kpwn/m68k-core-040-ooo/docs/superpowers/specs/2026-09-04-p135-m1-throwaway-frame-investigation.md

# Part 135 — the M=1 / format-`$1` throwaway interrupt frame: a negative on the stacks, and a real CCR bug found on the way

**Date:** 2026-09-04
**Branch:** `investigate/p135-m1-throwaway-frame` (worktree, **NOT merged**)
**Baseline:** `bb3bca1` (`fmax-closure-fanout`)
**Board / SD card / JTAG:** **not touched.** No board work of any kind.

---

## 1. Headline — two separate results

**(a) The stated hypothesis is a NEGATIVE. The M=1 / format-`$1` throwaway path does not
corrupt either stack pointer, under any condition tested.** Across 8 directed scenarios,
MMU off and MMU on, storm and per-cycle-enumerated arrival, bare and nesting and
stack-heavy handlers, **every frame word landed at exactly the right address on exactly
the right stack and both `MSP` and `ISP` returned to their entry values every time.** The
sim-side frame-address audit is exact to the word, so a 2-byte drift could not hide: it
would write 2 bytes off, cumulatively, and the second entry would already be visible.

**(b) A different, REAL defect was found and fixed: `RTE` restores the architectural CCR
into the flags PRF but leaves `RobPlugin.committedCcr` — the shadow the NEXT exception
entry builds the stacked SR's low byte from — holding the HANDLER's condition codes.** A
second interrupt taken at the same flag-consuming instruction therefore stacks the wrong
flags, and its `RTE` restores them, so the interrupted program's `Bcc` branches the wrong
way. It reproduces in **both** supervisor banks in well under 100 interrupt entries, is
**not** M=1-specific, and is invisible to any test whose handler is a bare `RTE` — which
is every interrupt test that existed, including all of Part 134's.

**This does not fix the boot, and no claim is made that it does.** §7 states plainly what
the connection to p133 is and is not.

---

## 2. Correcting the direction of the sequence

The brief states the throwaway frame goes on the **master** stack and the real frame on
the interrupt stack. That is backwards, and it matters for reading the results.

MC68040 UM §8.4.2/§8.4.3, and Musashi's `m68ki_exception_interrupt`: an interrupt taken
with `S=1, M=1`

1. stacks a NORMAL four-word format-`$0` frame on the currently-active stack — the
   **MASTER** stack, because M is still 1 — so `MSP -= 8`;
2. clears M, re-banking A7 to the **INTERRUPT** stack;
3. stacks the four-word format-`$1` **throwaway** frame there, so `ISP -= 8`;
4. runs the handler on the ISP with M=0 and the mask raised to the interrupt level.

`RTE`, inside one instruction: pops the `$1` frame off the ISP (`ISP += 8`), applies its SR
— which still carries M=1, so A7 re-banks back to the MSP — DISCARDS its PC, then loops
back and pops the real `$0` frame now on top of the MSP (`MSP += 8`), using its PC and SR
for the actual return.

`ExceptionUnit.scala:450-466` has this right. The tests here assert the correct direction
explicitly: T1 checks the format word at `ISP-2` is `$1064` and the one at `MSP-2` is
`$0064`, so a swapped implementation would fail loudly rather than pass silently.

---

## 3. What was built

`src/test/scala/m68k040/exception/M1ThrowawayFrameIrqSpec.scala` — 17 scenarios on the
shared full-core `FuzzCoreDut`, level-1 autovector IRQ driven on `iplIn`. Three
deliberately independent observation channels:

* **Guest-side architectural assertions.** The program re-derives every fact from `%a7`,
  `MOVEC %msp`, `MOVEC %isp`, `%sr` and the stacked frame words read back through
  `%a7@(n)`, and writes a DISTINCT numeric code plus **the value the failing check
  actually saw** to a watched address. Recording the observed value is what turned a
  failure from "something is wrong" into a diagnosis (§5).
* **Sim-side frame-address audit.** With the MMU off both stacks are writethrough, so
  every frame word is its own AXI AW beat. For a bare-`RTE` handler the only addresses
  that may ever be written in either stack's low window are `{SP-8, SP-6, SP-4, SP-2}`.
  This channel does not depend on the guest program being correct at all.
* **The committed `ss.msp` / `ss.isp` / `ss.srSys` bank registers**, read directly at the
  end, plus an architectural loop counter in `%d7` read through `ArchStateProbe` as a
  liveness bar (a clean result from a wedged guest is worth nothing).

Arrival is swept two ways, as in Part 134: a growing-gap storm, and a deterministic
per-cycle enumeration anchored on the guest's own per-iteration store, holding the level
until the ROB recognises it (a short pulse can LAPSE mid-macro and silently hollow out the
sweep — Part 134 measured only ~23% conversion without the hold; these runs convert
**384/384**).

---

## 4. The stack-pointer result — clean, on unmodified RTL

| # | scenario | entries | result |
|---|---|---|---|
| T1 | ONE M=1 interrupt, all 15 architectural facts of the two-frame entry checked | 1 | **PASS** (`0xC0FFEE00`) |
| T2 | M=1 storm, both banks re-checked every loop iteration, bare-`RTE` handler | 175 | **PASS** |
| T3 | deterministic per-cycle arrival enumeration under M=1 | **384/384** | **PASS** |
| T4 | entry state checked from INSIDE the handler on every interrupt | 155 | **PASS** |
| T5 | NESTED M=1 interrupts — a throwaway inside a throwaway | 141 | **PASS** |
| T9a | M=1 `RTE` whose immediately-preceding instruction changed A7 by 2 (register-only) | 175 | **PASS** |
| T10 | M=1 entry taken while the mainline moves A7 by 2 in tight pairs | 162 | **PASS** |
| T11 | the same A7 churn under per-cycle arrival enumeration | **384/384** | **PASS** |
| T7 | T1's full frame audit with the **MMU ON**, 8 KB pages, TTRs disabled | 1 | **PASS** |
| T8 | M=1 storm with the **MMU ON**, 8 KB pages | 174 | **PASS** |

T1's frame-address audit, verbatim from the run — note the exact word granularity, which
is what makes it a 2-byte-resolution detector:

```
MASTER-stack frame writes:    0x0011fff8 x2 0x0011fffa x1 0x0011fffc x2 0x0011fffe x1
INTERRUPT-stack frame writes: 0x000ffff8 x2 0x000ffffa x1 0x000ffffc x2 0x000ffffe x1
```

(the `x2` counts are the guest's own poison longwords at `-8`/`-4` plus the frame word.)

T2's, across 175 entries — one write per address per entry, no drift at all:

```
MASTER-stack frame writes:    0x0011fff8 x176 0x0011fffa x175 0x0011fffc x176 0x0011fffe x175
INTERRUPT-stack frame writes: 0x000ffff8 x176 0x000ffffa x175 0x000ffffc x176 0x000ffffe x175
```

**Both named secondary gaps were closed and neither changed anything.** The MMU-on arms
(T7/T8) run the guest's own three-level 8 KB page tables with **all four TTRs zeroed**, so
every first touch is a genuine table walk — the exact p133 silicon posture, `TC = 0x0000c000`
— and the harness fails closed on `mmuEnable`/`pageSize8K` readback so the arm cannot
silently degrade into an MMU-off run. The nesting (T5) and long stack-heavy (T6) handlers
close the "the handler was a bare `RTE`" gap.

**T5 deserves its own line.** `ExceptionUnit.scala:727-733` carries an explicit, still-open
caveat that ends: *"A RAPID M re-toggle (M=0->1->0 within the settle window) is NOT
validated here ... Add a directed test for that BEFORE Slice B (interrupt throwaway frame)
relies on cross-toggle preservation."* That test was never written. T5 is it: the handler
re-sets M=1 (re-banking onto the master stack, on top of the frame entry just pushed
there), opens the mask so a nested — itself M=1, itself a throwaway — interrupt lands, then
toggles back. 141 entries, both stacks exact.

---

## 5. The defect that IS real — `RTE` does not resync `committedCcr`

### 5.1 How it was isolated

Two scenarios failed where the others passed, and the failure code alone was ambiguous. The
fail path was changed to also record **the value the failing check compared**. That single
change resolved it:

```
T14 (M=1, handler pushes/pops a word):  result=0xbad00033 (_f_bal_sr)  observed=0x00103000
```

The check is `move.w %sr,%d0 ; andi.w #0xff00,%d0 ; cmp.w #0x3000,%d0 ; bne`. The observed
`%d0` low word is `0x3000` — **exactly the value the compare wanted**. The architectural
state was right and the branch went the wrong way. That is a condition-code failure, not a
value failure, and the observed-value channel is what distinguishes them.

### 5.2 It is NOT M=1-specific — the control says so

| # | arm | handler | result |
|---|---|---|---|
| T12 | **M=1** | forces `{N=1,Z=0}`, no memory, no A7, no MOVEC | **FAIL** `0xbad00033`, observed `0x00103000` (correct value), 96 entries |
| T13 | **M=0 CONTROL** | identical handler | **FAIL** `0xbad00032`, observed `0x00100000` (correct value), 63 entries |

The M=0 control was deliberately given **2x the pulse budget** of the M=1 arm — a control
that clears the bar only because it ran less is worth nothing — and it still failed
earlier. So the defect lives in the shared, M-agnostic `RTE` path.

An earlier, weaker revision of this handler (`tst.l %d6` with `%d6 == 0`) passed both arms
**vacuously**: it leaves `{N=0,Z=1,V=0,C=0}`, byte-for-byte what the mainline's own
successful `cmp` leaves, so it could not detect a lost CCR at all. Both the vacuous pass
and its correction are recorded here rather than dropped.

### 5.3 The mechanism, exactly

`RobPlugin.committedCcr` (`RobPlugin.scala:2020-2027`) is advanced ONLY by `retire0`/
`retire1`'s per-µop NZVC/X fold, plus `exc.obsSetCcr5Valid` (which before this change only
MOVE-to-SR and STOP ever pulsed). `ccrForException` (`:2037`) builds the STACKED frame's SR
low byte from it. `RTE`'s `rteNzvcWrite`/`rteXWrite` (`ExceptionUnit.scala:1775-1778`) write
the REAL flags PRF — correctly — but never touch that shadow. So:

```
  cmp.l #K,%d0     retires        -> committedCcr = {Z=1};  PRF = {Z=1}
  bne   ...        IRQ #1 preempts it; the frame stacks {Z=1}            (correct)
  <handler disturbs the flags>    -> committedCcr = {N=1,Z=0}
  rte                             -> PRF := {Z=1} (correct); committedCcr STILL {N=1,Z=0}
  bne   ...        IRQ #2 preempts the SAME bne; the frame now stacks {N=1,Z=0}
  <handler> rte                   -> PRF := {N=1,Z=0}
  bne   ...        branches the WRONG WAY, with %d0 still holding the correct value
```

It needs two interrupts at the same flag-consuming instruction with no flag-WRITING
instruction retiring in between — which is why it takes tens of entries to surface.

### 5.5 Why the existing corpus cannot see it — measured, not assumed

The obvious explanation is "every interrupt handler in the corpus is a bare `RTE`, which
cannot disturb the flags". **That explanation is WRONG, and it was checked rather than
asserted.** Of the interrupt-handler labels in
`src/test/resources/m68kooo-ported-tests/asm/`, only 9 are literally a bare `RTE`
(`atrap_dispatch_with_irq`, `bsr_split_push_irq_in_gap`, `exc_irq_during_store`,
`exc_rte`, `fline_after_move_sp_postinc_sr_tmp1`, `fline_before_move_sp_postinc_sr_tmp1`,
`irq_during_move_sp_postinc_sr_tmp1`, `irq_during_postinc_loop`, `pea_4x_with_irq`).
Several others DO disturb the condition codes — `irq_at_rts_fetch_sweep`'s handler is
`addq.l #1,IRQ_COUNT ; rte`, and `addq` to memory sets N/Z/V/C; `exc_stack_atomicity_stress`
and `pea_aline_irq_storm` do more still.

The real gap is narrower and more useful to know: **no test in the corpus asserts that the
CONDITION CODES survive an interrupt.** They assert stack-pointer balance, frame contents,
return addresses, nesting depth and interrupt counts. Reproducing this defect needs all
three of

1. a handler that disturbs the flags, **and**
2. interrupted code that CONSUMES flags produced *before* the interrupt (a `Bcc` whose
   `cmp` retired earlier), **and**
3. two interrupts landing on that same consumer with no flag-writer retiring between them.

`irq_at_rts_fetch_sweep` has (1) but its interrupted code is an `RTS` sweep that checks
return addresses, not flags. Part 134's scenarios had (2) — their loops are `cmpi.l`/`bne`
pairs — but their handler was a bare `RTE`, so not (1). Nothing had all three. That is a
corpus-shaped hole, not a one-test oversight, and closing it generally (a flag-survival
assertion in the standard interrupt-storm shape) is worth more than this one fix.

The comment that this change replaces stated the exact assumption the bug violates: *"the
CCR is restored from the frame too, but the whitebox carries it (RTE restores the same CCR
the matching exception entry saved -> reconstructed CCR holds)."*

### 5.4 The fix

`ExceptionUnit.scala`, `R_REDIR`'s real (non-throwaway) pop — two lines plus the comment
block that explains them:

```scala
        obsSetCcr5Valid := True
        obsSetCcr5      := popSr(4 downto 0)
```

`obsSetCcr5` is exactly the right port: `RobPlugin.scala:2217` already applies it as
`committedCcr := exc.obsSetCcr5` (last-wins over the retire fold), and the lock-step
whitebox already treats it as "set the running CCR to this absolute value for this obs
step" — which is precisely `RTE`'s architectural semantics. MOVE-to-SR / STOP already use
it the same way from `S_REDIR`; this is a third producer inside the SAME `fsm`, so
`whenIsActive` keeps them mutually exclusive by construction.

The format-`$1` throwaway pass deliberately does NOT pulse it: that pass fires no obs and is
not an architectural completion, and the second (real) pop lands the final value a few
cycles later with `excIdle` low throughout, so no exception entry can read the shadow in
between.

`git diff bb3bca1 -- src/main` is **1 file, +41/-3 lines** (2 of which are logic).

---

## 6. Before / after

Both arms are the SAME worktree, so the only variable is the two-line `src/main` change;
the test file is byte-identical between them.

| # | scenario | BEFORE (pristine `src/main`) | AFTER (fix) |
|---|---|---|---|
| T9b | M=1, handler push/pops a word before `RTE` | **FAIL** `0xbad00033`, observed `0x00103000` (the CORRECT value), at 44 entries / 230 pulses | **PASS**, 150 entries / 700 pulses |
| T1 | one M=1 interrupt, 15 architectural checks | PASS | PASS |
| T2 | M=1 storm, both banks | PASS, 175 entries | PASS, 181 entries |
| T3 | per-cycle arrival enumeration | PASS, 384/384 | PASS, 384/384 |
| T4 | entry state checked inside the handler | PASS, 155 | PASS, 141 |
| T5 | nested M=1 (throwaway inside a throwaway) | PASS, 141 | PASS, 141 |
| T6 | long, nesting, stack-heavy handler | (2 harness defects, see below) | **PASS**, 116 entries / 61 iterations |
| T9a | M=1 `RTE` after a register-only A7 change | PASS, 175 | PASS, 182 |
| T10 | M=1 entry during tight A7 churn | PASS, 162 | PASS, 168 |
| T11 | A7 churn under per-cycle enumeration | PASS, 384/384 | PASS, 384/384 |
| **T12** | **M=1**, handler disturbs only the flags | **FAIL** `0xbad00033`, observed `0x00103000` (correct value), at 96 entries | **PASS**, 182 entries |
| **T13** | **M=0 CONTROL**, same handler, 2x pulses | **FAIL** `0xbad00032`, observed `0x00100000` (correct value), at 63 entries | **PASS**, 450 entries / 1400 pulses |
| **T14** | M=1, push/pop handler (register-safe rewrite of T9b) | **FAIL** `0xbad00033`, observed `0x00103000`, at 44 entries | **PASS**, 150 entries |
| T15 | M=0 CONTROL, push/pop handler | PASS, 403 entries | PASS, 426 entries |
| T16 | M=1 CCR-survival probe (reads the CCR back architecturally) | *written after the baseline run — not measured before* | PASS, 178 entries |
| T17 | M=0 CONTROL, same probe | *not measured before* | PASS, 467 entries |
| T7 | MMU ON, 8 KB pages, single interrupt | PASS | PASS |
| T8 | MMU ON, 8 KB pages, storm | PASS, 174 | PASS, 173 |

**AFTER: 18 run, 18 passed, 0 failed** (`Total time: 641 s`). The three scenarios that
failed on the pristine arm — T12, T13, T14 — are green, and the two M=0 controls that
passed before still pass with more entries than before. T16/T17 are honestly marked: they
were written *after* the baseline sweep, in response to the T12/T13 failures, so they have
a fixed-arm number only. Their value is diagnostic shape, not a before/after pair; T12/T13
are the pair.

**Three harness defects were found and fixed during this work, and are reported rather
than quietly corrected**, because two of them produced failures that looked like RTL bugs:

1. **T4's first handler used `%d0`/`%a0`** — the same scratch register the mainline's
   checks use between their `movec`/`move` and their `cmp`/`bne`. An interrupt landing in
   that gap left the handler's value in `%d0`, failing a check that had nothing wrong with
   it (`_f_bal_msp`, `0xbad00031`). All handlers now leave `%d0-%d3`, `%d5`, `%d7` and
   `%a1` untouched on the success path and use `%d4`/`%d6`/`%a0` as scratch.
2. **T5/T6's stack-balance checks were not nesting-safe** — they compared against a
   snapshot in `%d4` (T5) or a hard-coded `ISP-8` (T6), both of which a NESTED invocation
   of the same handler invalidates. Replaced with a marker longword pushed on the
   handler's own stack, which is correct at every nesting depth.
3. **The first `flagOnlyHandler` (`tst.l %d6` with `%d6 == 0`) passed VACUOUSLY** — it
   leaves `{N=0,Z=1,V=0,C=0}`, byte-for-byte what the mainline's own successful `cmp`
   leaves, so it could not detect a lost CCR at all. Corrected to force the opposite
   (`moveq #-1`), after which it fails in both banks. A control that cannot fail is worth
   nothing, and this one nearly went in the report as a pass.

**On the positive control the brief asked for.** No deliberately-injected defect was
needed for the CCR finding: T12/T13/T14 are *themselves* real failures on unmodified RTL
that the two-line change turns green, which is a stronger demonstration than an injected
one. For the stack-pointer NEGATIVE the detector's sensitivity is argued differently and
must be read as such — see §9's "what the frame audit can and cannot catch".

---

## 7. What this does and does not say about p133

**It does not fix the boot.** No boot was attempted, and the defect's own signature is
corrupted condition codes, not a corrupted stack pointer. Everything below is a hypothesis
with supporting properties, offered so it can be tested — not a claim that it is the cause.

That said, it is the strongest hypothesis this campaign has produced, and the reasons are
worth stating explicitly because each one is independently checkable.

### 7.1 It is the only mechanism found that can produce the measured signature

A `Bcc` that branches the wrong way **around a stack adjustment** leaves SP off by exactly
that adjustment. The measurement is SP at `0x0040076C` where `0x0040076E` was required —
**exactly 2**. Word-sized stack traffic (`addq.l #2,%sp`, `move.w (%sp)+,%dn`,
`move.b <ea>,%sp@-` which adjusts A7 by 2 under the 68k A7 rule) is pervasive in this ROM.
Neither Part 134's mid-macro hypothesis nor this part's M=1 hypothesis can produce a 2-byte
SP error at all; this one can.

### 7.2 The ROM code at the failure has exactly that shape

Disassembling `files/420dbff3.rom` at the captured fault address (`objdump -b binary -m
m68k:68040 --adjust-vma=0x40800000`) shows the faulting `RTS` at `0x408999E2` sits at the
end of the ROM's own exception-probe unwind path, and its neighbourhood is dense with both
conditional branches and stack arithmetic:

```
4089999c: addql #4,%sp
4089999e: movew %sp@,%d0                 | saved SR
408999a0: bfextu %sp@(6),0,4,%d1         | frame FORMAT nibble
408999a6: cmpib #7,%d1
408999aa: beqs  0x408999b8               |  -> lea %sp@(60),%sp
408999ac: cmpib #10,%d1
408999b0: bnes  0x408999be               |  -> lea %sp@(92),%sp
408999b2: lea   %sp@(32),%sp             |  (fallthrough: 32)
...
408999c2: movew %d7,%sp@-                | hand-built format-$0 frame: format word (2 bytes)
408999c4: pea   %pc@(0x408999cc)         |                             PC          (4 bytes)
408999c8: movew %d0,%sp@-                |                             SR          (2 bytes)
408999ca: rte
408999cc: moveq #9,%d0
408999ce: btst  #7,%a3@(64)
408999d4: beqs  0x408999e2
408999d6: moveb %a3@(80),%d5
408999da: btst  #4,%d5
408999de: beqs  0x408999e2
408999e0: moveq #5,%d0
408999e2: rts                            | <<< THE FAULTING RTS
```

And ~400 bytes earlier, in the same routine, the **exact 2-byte shape**: a byte pushed to
`-(%sp)` (which moves A7 by 2) whose matching pop is reached through *two different*
conditionally-selected sites, with other conditional exits in between:

```
4089984a: moveb 0xcb2,%sp@-              | A7 -= 2  (68k A7-byte rule)
...
40899876: bnes  0x408998f0
...
408998aa: bnes  0x408998f4
408998b4: moveb %sp@+,%d0                | A7 += 2  (pop site 1)
...
408998f4: moveb %sp@+,%d0                | A7 += 2  (pop site 2)
```

**Report this honestly, including where it does not fit.** The conditional chain
*immediately* before the faulting `RTS` selects unwind sizes of 32/60/92, so a wrong branch
*there* gives a 28/32/60-byte error, not 2. The 2-byte shape is the earlier push/pop pair,
in the same routine and the same subsystem, not the last few instructions. So the ROM
supports "a mis-taken conditional branch in this code produces a 2-byte SP error" as a
*plausible* mechanism; it does not demonstrate that this particular branch was mis-taken.

### 7.3 It explains the non-determinism

The defect needs a SECOND interrupt to land on the same flag-consuming instruction before
any flag-writer retires. That is a coincidence, not a certainty — which is the right shape
for "~50% of cold boots", and the wrong shape for a deterministic decode or arithmetic bug.
In simulation it took 44-96 interrupt entries to surface.

### 7.4 It explains the v1 asymmetry — CHECKED, and it holds

This is the strongest constraint available (v1 boots this SoC to Finder on identical
peripheral RTL), so it was verified in v1's RTL rather than assumed.

**v1 has exactly ONE architectural condition-code storage** — the `ccr_prf[]` array in
`cpu/rtl/core/rename/ccr_rat.v`, indexed by the committed pointer `crat_tag`. Both sides of
the round trip touch that same array at that same index:

* **Exception entry** builds the stacked SR as `{arch_sr[15:5], arch_ccr_val}`
  (`cpu/rtl/core/commit.v:2960`, and identically at `:3283, :3513, :3578, :3773, :3861`),
  where `arch_ccr_val` is wired straight from `assign dbg_arch_ccr = ccr_prf[crat_tag];`
  (`ccr_rat.v:389`).
* **`RTE`** writes `ccr_restore_en`/`ccr_restore_val` (`commit.v:3656-3661`, and
  `:3612-3615` for the format-`$1` throwaway pop), consumed as
  `ccr_prf[crat_tag] <= restore_val;` (`ccr_rat.v:484-487`).
* The same array is what a `Bcc` reads (`assign read_val = ccr_prf[read_tag];`,
  `ccr_rat.v:381`).

`commit.v:1044` documents that `arch_sr[4:0]` is dead and never maintained precisely
*because* the CCR lives only in `ccr_rat`. So **there is no second copy in v1 to fall out of
sync, and this bug cannot exist there by construction.** The cpu040 defect is a property of
having a *separate* `committedCcr` shadow for exception stacking — an OoO-specific
structure that an in-order core has no reason to build.

That is the property worth having: it explains why v1 boots and cpu040 does not, without
needing the two cores to differ anywhere else.

**One nuance found in v1 that is worth carrying back.** v1 hit a *different* variant of the
same family — not a stale mirror but a stale read *cycle*: `arch_ccr_val` is combinational
off `crat_tag`, which advances one cycle after `ccr_commit_en`, so an exception entry
sampling during that cycle captured the previous instruction's CCR. v1's fix is
`ccr_settle_in_flight` (`commit.v:1968-1983`), gating `take_irq_fire_q`, `sync_exc_pretest`
and `take_trace`. Note it gates `ccr_commit_en` but **not** `ccr_restore_en` — v1 gets away
with that only because `RTE` also asserts `redirect_en`. cpu040's equivalent question (can
an exception entry sample `committedCcr` in the cycle a flag-writer retires?) is **not
answered by this part** and is a reasonable next check.

### 7.4a CONFIRMED ON SILICON — the defect, not yet the boot

Reported to this session by another agent, and recorded with that attribution rather than
as a measurement taken here: on real hardware the **stacked CCR was measured going
`0x00 -> 0x04`** at two distinct PCs, with both confounds eliminated. That is a direct
observation of the defect this part reproduces in simulation — the exception frame
carrying condition codes that are not the interrupted program's.

Be precise about what that does and does not establish. It confirms **the defect is real
on silicon**, which upgrades it from "reproduces in simulation" to "happens on the actual
part". It does **not** by itself establish that this is the p133 boot blocker: that still
requires showing the corrupted flags steer a branch around a stack adjustment in the
failing window. §7.2's ROM disassembly shows the shape exists nearby; it does not show it
fired.

The measurement Part 134 §9 asked for is still the discriminating one and is **still not
taken**: catch a drain-loop IRQ on silicon and read `A7` immediately before interrupt entry
and immediately after the handler's `RTE`. A second, cheaper discriminator now exists: read
the **CCR** at the same two points, or simply check whether the boot success rate changes
with this fix in the bitstream.

---

## 8. Open / not fixed

### 8.0 Two follow-ups worth picking up — named so they are not lost

**(1) A SECOND, DISTINCT CCR HAZARD CLASS: the settle window, not the stale mirror.**
The bug fixed here is a stale *mirror* (`committedCcr` not resynced by `RTE`). v1 hit a
different member of the same family: a stale *cycle*. In v1, `arch_ccr_val` is
combinational off `crat_tag`, which advances one cycle after `ccr_commit_en`, so an
exception entry sampling during that cycle captures the PREVIOUS instruction's CCR. v1's
fix is `ccr_settle_in_flight` (`cpu/rtl/core/commit.v:1968-1983`), which gates
`take_irq_fire_q`, `sync_exc_pretest` and `take_trace`.

Note what that gate covers: **`ccr_commit_en` but NOT `ccr_restore_en`.** v1 gets away with
the omission only because `RTE` also asserts `redirect_en`. The cpu040 equivalent —
**can an exception entry sample `RobPlugin.committedCcr` in the same cycle a flag-writing
µop retires, and stack the pre-fold value?** — is **NOT answered by this part**. Reading
`RobPlugin.scala:2020-2039`, `ccrForException` reads the `committedCcr` REGISTER while
`ccrAfter0`/`ccrAfter1` compute the post-fold value combinationally for the next edge, so
the question is whether `entryTrigger` can coincide with `retire0`. It is a real,
separately-testable hazard and it deserves its own directed test in the shape of §5.5's
three-way conjunction. Not investigated here.

**(2) A CORPUS-SHAPED COVERAGE HOLE, not just a missed bug.** No test in this repo asserts
that the CONDITION CODES survive an interrupt. Stating the conjunction is what makes it
fixable — reproducing this class needs **all three** of:

1. a handler that **disturbs the flags**, and
2. interrupted code that **consumes flags produced BEFORE the interrupt** (a `Bcc` whose
   `cmp` retired earlier), and
3. **two interrupts landing on that same consumer** with no flag-writer retiring between.

The corpus has (1) in several places and (2) in several others, and nothing has all three
(§5.5). The generally-useful fix is not this one patch but a flag-survival assertion added
to the standard interrupt-storm shape, so the whole class is covered once. `T16`/`T17` in
`M1ThrowawayFrameIrqSpec` are a ready-made template: they read the CCR back
architecturally with MOVE-from-SR and report the corrupted value rather than inferring it
from a branch outcome.

* **`RTE` does not restore the CCR on the format-`$1` throwaway pass**, where Musashi's
  `rte` `case 1` does (`m68ki_set_sr_noint(sr)` sets the FULL SR including the CCR before
  `goto rte_loop`). This is architecturally invisible here because the second pop lands the
  same CCR a few cycles later and nothing can observe the interval. Left alone deliberately:
  changing it is a behaviour change with no test that can see it.
* **`ss.msp` is transiently clobbered during a throwaway `RTE`.** After pass 1 restores M=1,
  `ss.writeA7` (which fires every cycle, routed by committed S,M) starts mirroring the
  live committed A7 — still the HANDLER's ISP value — into `ss.msp`, until pass 2's
  explicit `setMsp` overwrites it with the correct value. Nothing reads `ss.msp` in that
  window on the normal path (`frameBase` was already latched), so it is benign there. It is
  NOT benign on one path: if the second frame's format nibble is malformed, `R_FMTWAIT`
  synthesises a vector-14 entry that routes through `E_DRAIN`, which recomputes
  `frameBase` from `Mux(ss.m, ss.msp, ss.isp)` — and would read the clobbered value. That
  needs a hand-corrupted frame to reach, does not occur in the p133 boot, and is reported
  rather than fixed (fixing it is a `src/main` change for a defect nothing has observed).
* **`exc_partial_macro_move_mem_mem`** (sentinel `0xbad0a008`) still fails on baseline. Not
  re-litigated: Part 134 §6's reasoning that it is not the p133 blocker is sound.
* The `[Warning] Elaboration failed (20 errors).` line Part 134 §8 flagged appears in every
  run of this suite too. Same pre-existing `FuzzCoreDut` SpinalSim compile-path artefact;
  the positive/negative discrimination in §5 proves the netlist really is regenerated when
  the source changes. Flagged, not investigated.

---

## 9. Verification — and what was NOT run

### What the frame audit can and cannot catch

The stack-pointer negative rests on the sim-side audit, so its sensitivity has to be
stated rather than assumed. It records the address of **every** AXI write that lands in
either stack's low 256-byte window and asserts the set is exactly
`{SP-8, SP-6, SP-4, SP-2}`. T1's output shows the granularity is a single **word** — the
frame's four words appear as four distinct addresses two bytes apart — so a stack pointer
2 bytes off writes to an address that is not in the set, on its very first frame. And the
error would be cumulative: entry N's frame would sit 2N bytes low, so across T2's 175
entries a drift would produce 175 distinct addresses marching down the stack rather than
the 4 observed. This channel is independent of the guest program being correct at all.

What it cannot catch: a drift that is introduced AND undone entirely inside the FSM
without any frame word being written from the wrong base, and anything on a COPYBACK page
(which is why the MMU-on arms, whose pages are copyback per the p133 posture, rely on the
guest-side checks and the final bank readback instead).

### Runs completed

| suite | arm | result |
|---|---|---|
| `M1ThrowawayFrameIrqSpec` T1-T15 | pristine `src/main` | T9b, T12, T13, T14 **FAIL**; the rest pass (§6) |
| `M1ThrowawayFrameIrqSpec`, all 18 | **with the fix** | **18 run, 18 passed, 0 failed** (`Total time: 641 s`) |
| `ExecuteLockStepSpec` | with the fix | **505 run, 505 passed, 0 failed, 1 ignored** — identical to the brief's baseline figure |
| `make test-fast` (`sbt fastTest`) | with the fix | **341 run, 340 passed, 1 failed, 2 ignored** — the one failure is the documented `RobPluginSpec` `debugPcApply` seed flake, byte-for-byte the baseline figure |
| `m68k040.ls.*` + `m68k040.cache.*` | with the fix | 300 run, 287 passed, **13 failed** |
| `m68k040.ls.*` + `m68k040.cache.*` | **pristine, SAME session** | 300 run, 289 passed, **11 failed** |
| 200-seed fuzz | with the fix | **200 seeds, 3 divergences, 0 generator failures** — seeds 80, 109, 127, identical signatures. **Unchanged.** |

`ExecuteLockStepSpec` is the check that mattered most here and it is clean. The fix pulses
`obsSetCcr5Valid` on `RTE`, which the lock-step whitebox consumes as "set the running CCR
to this absolute value for this obs step"; 505 of 505 programs still agree with Musashi
step for step, which is the direct confirmation that RTE's architectural semantics are what
the change asserts them to be.

### Reconciling the `ls`/`cache` +2 — it is ordering, not regression

The 13-vs-11 delta was NOT waved away as "the documented `AguCrossSpec` flake". It was
diffed by test name against a pristine run taken in the same session on the same host:

* The **11 failures are common to both arms**, by name.
* The 2 extra in the fixed arm are
  `DcacheSpec: "store to a missing line is write-through with no allocate"` and
  `AguCrossSpec: "word at page offset 0xFFF -> crossPage + twoAccess, addrB = next page"`.
* Both of those **PASS when their suites are run in isolation** — and running
  `testOnly m68k040.ls.AguCrossSpec m68k040.cache.DcacheSpec` gives **67 run, 66 passed,
  1 failed on BOTH arms**, with the same single failure name (`VIPT D2: four distinct probe
  results queue...`, one of the common 11).

Structurally that is what it has to be: both DUTs are standalone plugin harnesses
(`DcacheSpec.Dut` = Param/DIdentityTranslation/Dcache/DcacheProbe/MmuControl;
`AguCrossSpec.Dut` = Param/RegFile*/DIdentityTranslation/Dcache/LsEu/LsEuSource). Neither
instantiates `RobPlugin`, so neither contains an `ExceptionUnit` at all — **the changed
logic is not present in either netlist**, and the only channel by which a `src/main` edit
can reach them is SpinalSim's seed/uninitialised-Reg randomisation shifting with the
generated netlist. That is exactly the documented `AguCrossSpec` seed-shift hazard, now
measured on both arms rather than asserted about one.

The M=1 dual-stack path accumulated **~1,750 interrupt entries** across the clean
scenarios with both banks exact at every check — the direct counterpart of Part 134's "A7
balanced across 761 entries", which covered only the M=0 single-frame path.

### NOT RUN — stated plainly

* **The postroute synth gate. THIS IS THE ONE OUTSTANDING GATE.** The change touches
  `src/main`, so the standing rule requires it. It was not run because
  `/var/tmp/m68k-ooo-vivado.lock` was **held for the entire session** by another agent's
  KU5P `full_impl` gate; probed again at the end of this work and still
  `LOCK_HELD`. Never taken, never contended.

  What can be said without it: the change adds two combinational assignments to two ports
  that already exist and are already driven (`obsSetCcr5Valid`/`obsSetCcr5`, driven today
  from `S_REDIR` for MOVE-to-SR and STOP), from a third state of the SAME FSM. No new
  register, no new port, no new fan-in to any datapath — the synthesised delta should be a
  one-input widening of two small muxes inside an already-serializing, multi-cycle,
  non-critical FSM. That is an argument about the shape of the edit, **not** a WNS number,
  and it must not be read as one. The gate still owes a measurement before this merges.
* **A baseline arm for T16/T17.** Those two were written *after* the pristine sweep, in
  response to T12/T13's failures, so they have a fixed-arm number only. T12/T13 carry the
  before/after; T16/T17 carry the diagnostic shape.
* **A same-session pristine arm for `test-fast` and `ExecuteLockStepSpec`.** Those two are
  compared against the figures carried in the brief (341 run / 1 known `debugPcApply` seed
  flake; 505/505), and both match exactly — but they are not paired runs from this session
  the way `ls`+`cache` is. `ls`+`cache` IS paired, because its delta needed reconciling.
* **No board work.** SD card, JTAG lease and `hw_server` untouched.
  `/var/tmp/m68k-ooo-vivado.lock` was probed once (free at that moment) and **never taken**.

### An operational error, recorded and since reconciled

Mid-campaign the host filled up (a KU5P gate at ~12.5 GB, 1 GB free, 10 GB swap in use)
and this session killed a large test JVM to protect the gate. The kill was mis-aimed:
this session's own run completed normally minutes later (`[success] Total time: 641 s`,
18/18 pass), which it could not have done had it been the one terminated.

**Reconciled since:** PID 3399813 (~7.9 GB) was a sibling's `wt-specmmio` `ls`/`cache`
run, which was lost. It was killed in response to a throttle request that turned out to
carry an unsatisfiable threshold (gating on *total* JVM RSS, which idle sbt servers keep
at 3-4 GB regardless of load). Recorded here in full rather than dropped, because a
mis-aimed `kill` on a shared host otherwise gets written off as a mystery OOM. The
corrected admission rule — **>= 17 GB available AND <= 2 forked test JVMs above 1.5 GB,
counting only JVMs with an `sbt-args` argfile and ignoring idle sbt servers** — is what
`synth/p135_gate.sh` implements.

### The gate's FIRST run was a FALSE GREEN — recorded, because it nearly shipped

`synth/p135_gate.sh` run 1 finished in 12 seconds and wrote `P135_GATE_ALL_DONE` with
`SUMMARY fix WNS=#ns base WNS=#ns` and "fix is NOT adverse vs base". **That is a
confident-looking pass from a gate that never ran.** Preserved verbatim as
`p135_gate_FALSEGREEN_run1.log`. Three defects compounded:

1. **Wrong generator.** The gate tcl reads `generated/M68kFullCoreSynth.v`, emitted by
   `GenFullCoreSynthVerilog`. The script ran `GenVerilog`, which emits `M68kCore.v`,
   **succeeds in about a second and exits 0** — so the return-code check passed with no
   netlist on disk and Vivado died at `read_verilog` with `rc=1`.
   This is precisely the defect that got another agent's wrapper stopped
   (`run_p135_gate.STOPPED.md`) — "it would have gated a netlist that does not exist" —
   and then my own base arm walked straight into it. An exit code is not evidence that the
   artefact you need exists.
2. **The summariser scraped tcl comments.** Vivado echoes the sourced script, and
   `impl_FullCore.tcl` mentions `SIGNOFF_200MHZ_*` inside `#` commentary, so an unanchored
   `grep` matched the documentation. Verified against the real log: the old `wns_of`
   returns `#`, hence `#ns`.
3. **A verdict was emitted from unparsable inputs.** `#` was compared against `#`, found
   not worse, and logged as a pass.

Fixed with structural guards rather than a patched line, and each guard was **verified
against the actual failing logs**, where both arms are now REFUSED rather than parsed:

* the netlist must exist and exceed 1 MB **before the mutex is taken**, else the arm
  aborts loudly;
* a non-zero Vivado `rc` aborts the arm instead of falling through to the summariser;
* the result grep is anchored to line start and validated as numeric, returning nothing
  when there is no genuine result;
* a missing or unparsable WNS is a **hard failure** that exits 1 and writes
  `P135_GATE_FAILED_NO_RESULT`. A verdict can no longer be produced without numbers.

The general lesson is the one this campaign keeps re-learning: **a long wait followed by a
silent failure is indistinguishable from success unless something asserts on the artefact.**
Both gate wrappers written for this change failed the same way, independently.

### Netlist forensics: renaming churn outnumbers real logic 10:1

Prompted by a sibling discovering that the standard net-renaming control can measure
*nothing* (theirs neutralised its change with a constant, which constant-folded the logic
away, so CTRL was BASE after propagation and matched it to the digit — an identity that
was then misread as proof the delta was real logic), the control here was checked
empirically rather than trusted. Both netlists already existed, so the check was free.

**SpinalHDL derives net names from SOURCE LINE NUMBERS.** The generated Verilog is full of
`when_ExceptionUnit_l2417`-style names. Diffing the BASE and FIX netlists
(20,389,564 vs 20,389,811 bytes):

| component of the 146-line netlist diff | count |
|---|---|
| net renames — **every one a `+38` shift** | **69** |
| the actual logic (the two `obsSetCcr5` assignments, gated `!popIs1`) | **6** |
| the git-hash header comment | 1 |

and `+38` is exactly the Scala line delta of this change (41 insertions − 3 deletions).
So **renaming churn outnumbers real logic 10:1 in the netlist**, which independently
corroborates the "86% of that apparent 8.3 MHz regression was line-number churn" result
found elsewhere today, and is why this gate has a control arm at all.

**This control is NOT the folding failure mode, and the usual test for it would misfire.**
The suggested check — "if CTRL and BASE have identical flop/LUT counts, the control folded
and its verdict is void" — is correct for a control built by *neutralising logic with a
constant*. It is wrong for this one. This control carries **FIX's line count (hence FIX's
net names) with BASE's logic**, so identical flop/LUT counts versus BASE are *expected and
required*: the variable being controlled for is NET NAMING, not the presence of logic.
The correct validity test is three assertions, now encoded in the gate script:

* CTRL vs BASE must show a **non-zero** rename-line count (else the control is
  netlist-identical to BASE in naming and measures nothing — the folded failure mode);
* CTRL vs FIX must show a **zero** rename-line count (else it is not carrying FIX's names);
* CTRL must contain **no** `obsSetCcr5` logic lines versus BASE, and must differ from FIX
  by exactly those lines.

### On the missing noise baseline

The observation that BASE's worst six post-route paths all sit at exactly `+0.001 ns` is
better read as **perturbation sensitivity than as run-to-run noise**. Vivado is
deterministic for a fixed netlist and settings — re-running the same netlist reproduces the
same numbers — so there is no statistical noise floor to measure that way. What the
clustered paths show is that the design is packed so tightly at the margin that *any*
netlist perturbation reshuffles which path wins. That is precisely what the BASE→CTRL arm
measures, and it is the missing baseline: **BASE→CTRL is the cost of perturbation alone,
CTRL→FIX is the cost of the logic.** Neither number exists yet.

### The postroute gate is QUEUED, not skipped

`synth/p135_gate.sh` (committed on this branch, corrected after the false green above) was
`setsid`-detached and is waiting on
admission + the mutex. It regenerates and md5s the netlist per arm, runs `fix` and `base`
through the same flow, and builds + runs the net-renaming control automatically if the fix
looks more than 0.050 ns adverse. It reports `SIGNOFF_200MHZ_WNS_NS` /
`SIGNOFF_200MHZ_RESULT` — the `clk`-domain verdict re-derived at a real 5.000 ns — not the
`timing_summary.rpt` headline row. Results land in `p135_gate.log`.

A second, independently-created gate wrapper (`run_p135_gate.sh`) was found already
queued in this same worktree and was stopped by exact PID, with the reasoning written to
`run_p135_gate.STOPPED.md`: two gates would have raced over the one worktree's
`generated/` and `synth/` outputs, and that one would have gated a netlist **that does not
exist** (it never ran `GenVerilog`, and `generated/M68kFullCoreSynth.v` is absent from
both worktrees) while counting idle sbt servers in its admission check.

**The branch is `investigate/p135-m1-throwaway-frame` and is deliberately NOT merged.**
