kpwn/m68k-core-040-ooo/docs/superpowers/specs/2026-08-18-axi-socket-adapter-design.md

# `axi_i` / `axi_d` socket adapter for the 040 OoO core — macqd700-soc integration design

**Status:** PROPOSED / DESIGN ONLY. All decisions in §0 are locked (prior verified
investigation + explicit user direction); none is implemented. Direct input to a future
`writing-plans` pass.

**Date:** 2026-08-18

**Scope:** making this repository's `axi_i` / `axi_d` AXI master interfaces conform to
`macqd700-soc`'s authoritative CPU-socket contract (`macqd700-soc/rtl/soc/cpu_socket.vh`),
so this core can replace the v1 core currently in that SoC. Also in scope: the interrupt
ack, reset/boot, and reset-instruction seams, because they are part of the same socket
surface and no other plan owns them.

**Primary source:** the verified scoping pass
`~/.claude/projects/-home-qwertyoruiop-m68k-core-040-ooo/memory/axi-socket-adapter-scoping-2026-08-18.md`
(gap table G1-G14, every claim carrying a `file:line` citation against HEAD `bb7774c`).
Citations below were independently re-confirmed while writing this spec; the four places
where this spec **corrects or extends** that source are called out explicitly in §12.

**Compatibility target:** `macqd700-soc/rtl/soc/cpu_socket.vh` §§1-3 and §§5-6, and the
behaviour of the fabric behind it (`axi_xbar.v`, `axi_wide_to_axilite.v`,
`peripheral_bus.v`, `l2c*.v`, `ddr_ctrl`). Compatibility means the SoC boots and runs
against this core with no CPU-specific signal crossing the socket, not that the v1
CPU-side glue (`if_to_axi.v`, `axi_narrow_to_wide.v`) is reproduced.

---

## 0. Decision summary

Every numbered **DECIDED** item below is citable by a future implementation plan without
re-deriving it. Items tagged **NOTED** record a confirmed non-problem or an accepted
residual; items tagged **SOC** must be executed in `macqd700-soc`, not here; items tagged
**OPEN** are genuinely undecided and require explicit sign-off before the implementation
plan may pass the section that depends on them — they are recorded rather than silently
resolved in either direction.

`D24`-`D29` and `OPEN-1` were added by the 2026-08-18 design review of this spec (see the
review-corrections block at the end of §12); `D4`/`D5`/`D6`/`D10`/`D15`/`D20`/`D22`'s
wording was tightened by the same pass.

`D30` and `SOC-4` were added by a later 2026-08-18 pass acting on explicit user direction
that the in-group-misalignment case must **not** be carried as an accepted limitation (see
the second corrections block at the end of §12). `D6`'s bound and `D26`'s content were
rewritten by that pass; `D26` is now a write-path statement only.

| # | Decision |
|---:|---|
| **D1** | Adapt byte order at the socket boundary with a pure wire permutation. Do **not** change the core's native byte-address-invariant lane convention in `DcacheTypes` / `IcacheTypes` / `TableWalker`. (§2) |
| **D2** | The permutation is a **per-32-bit-lane byte reversal** on WDATA/RDATA and a **per-4-bit-nibble reversal** on WSTRB. Inter-word order is untouched. It is an involution, so one function serves both directions and both widths. (§2.2) |
| **D3** | The permutation lives in a new top-level `M68kSocketTop`, applied exactly once per master, only to `w.data` / `w.strb` / `r.data`. Never to address, id, len, size, burst, resp, or last. (§2.3) |
| **D4** | The D-side derives a real `AxSIZE` and a byte-granular address for every **INHIBITED** access, from the access's own size (loads) or size+strobe (stores) — never from an address-range table. (§3) |
| **D5** | The store-side size/address derivation runs on the **core-side** (pre-permutation) strobe, because the byte-offset a run starts at is not permutation-invariant. (§3.3) |
| **D6** | An INHIBITED access is decomposed inside `DcachePlugin`'s INHIBITED path into an **exactly-covering sequence of naturally-aligned AXI sub-transactions** — never more than **three**, and exactly one for every naturally-aligned access. This is an extension beyond the v1 algorithm and is required for parity — see §3.4 for why the naive containment fallback is wrong. The decomposed range is clamped to the containing 16-byte line per D25, and the ≤3 bound is proved from that clamp in §3.4. (Originally scoped to the 4-byte-boundary crossing alone; widened to exact cover by D30.) |
| **D7** | 4 masters → 2. `axi_i` stays I-cache-only. D-cache + ITLB walker + DTLB walker merge onto `axi_d`. The ITLB walker genuinely issues AXI writes, so it categorically cannot ride the read-only `axi_i`. (§4.1) |
| **D8** | The merge is an **owner-tag serializing arbiter**, not a raw-ID demux. Responses route by the arbiter's latched grant owner; the returned AXI ID is forwarded as a fabric hint and is never consulted for routing. (§4.2) |
| **D9** | Read and write grants are **independent** per-direction state machines. A single global token deadlocks against `refillWriteHold`. (§4.4) |
| **D10** | The D-cache's existing internal B-by-ID demux is preserved untouched; for it the arbiter is strictly additive. The walkers have **no** existing ID check, so for them the arbiter is not additive but their *only* protection — see D27. (§4.3) |
| **D11** | `axi_i` stays natively 256-bit, `len=1`/`size=5` (two 32-byte beats = a 64-byte line). No 256→128 downconverter is built in this repo. (§5) |
| **SOC-1** | `macqd700-soc` must widen the `axi_i` socket-side path to 256 bit. The socket's single `CPU_SOCKET_AXI_DW` define must split into per-master `..._AXI_I_DW` (256) and `..._AXI_D_DW` (128). (§5, §11) |
| **D12** | Reset/boot is a **real vector-0 AXI fetch**: one 16-byte read at physical 0x0, SSP from bytes 0-3, PC from bytes 4-7. Not a debug-CSR-supplied PC. (§6) |
| **D13** | The vector-0 read is issued as a fourth read owner on the **`axi_d` merge arbiter**, never as a third socket master — only `XBAR_M_CPU`/`XBAR_M_CPUI` reads get the SoC's ROM overlay aliasing. (§6.2) |
| **D14** | The initial SSP reaches committed A7 through the **existing shared `a7Wr` int-PRF port** at `RenameStage.committedPhysA7`, as a new highest-priority third source. SSP write in cycle N, fetch redirect in cycle N+1. (§6.3) |
| **D15** | A non-OKAY vector-0 response latches the sticky `coreHalted` state, not a vector-2 frame. This is hardware-faithful (a fault during reset exception processing halts a real 68040) and a deliberate divergence from v1. The halt *reason* it reports needs the new channel of D28. (§6.4) |
| **D16** | The reset-vector fetch is behind a constructor parameter, default **off**, mirroring v1's `FETCH_RESET_VECTORS`. The existing sim/lock-step/OOC flows keep the external `redirect` port. (§6.5) |
| **D17** | `ipl_ack` is a 1-cycle pulse per interrupt exception entry actually taken, derived from the ExceptionUnit's own registered `obsIsInterrupt` observation, pinned by a count-equality assertion. (§7.2) |
| **D18** | `iackAvec` is tied to 1 (autovector) and `iackVector` is dropped: the socket has no vector input. (§7.3) |
| **D19** | The core does **not** reimplement a 20 s abandonment timer. The obligation is discharged by the SoC fabric's own bounded-response guarantee plus a stated, assertion-backed core-side invariant. (§8.2) |
| **D20** | The merge arbiter carries its own **bounded-grant** watchdog, closing a new wedge mode this design creates (three owners on one port). This is *not* a reinstatement of the v1 abandonment timer D19 declines. Bound = v1's value copied verbatim (2e9 core-clk), never re-derived. On expiry it latches `coreHalted` with a distinct halt-reason code (via D28's new channel); it never fabricates an AXI response. (§8.3) |
| **D21** | Keep the core's async active-high reset; rename the socket top's port `reset` → `rst`, declare the `ClockDomainConfig` explicitly instead of inheriting the default, and re-run the post-route gate. (§9.1) |
| **D22** | `cpu_peripheral_reset` (68040 `RESET` instruction output) is owned by **this** work, not the debug-ctrl plan. Driven from the commit-time `SysKind.RESET` arm, as a **518-core-clock level** matching v1 verbatim. (§9.4) |
| **SOC-2** | `macqd700-soc` must add `cpu_peripheral_reset` to `cpu_socket.vh` §6, which omits it today. (§9.4, §11) |
| **SOC-3** | `macqd700-soc` must instantiate this core in place of v1, dropping `if_to_axi.v` and `axi_narrow_to_wide.v` from the CPU wrapper. That is the step which removes the 20 s timer — see D19. (§11.2) |
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
