kpwn/m68k-core-040-ooo/docs/evidence/2026-10-02-ls-ooo-off-speedometer.jpg

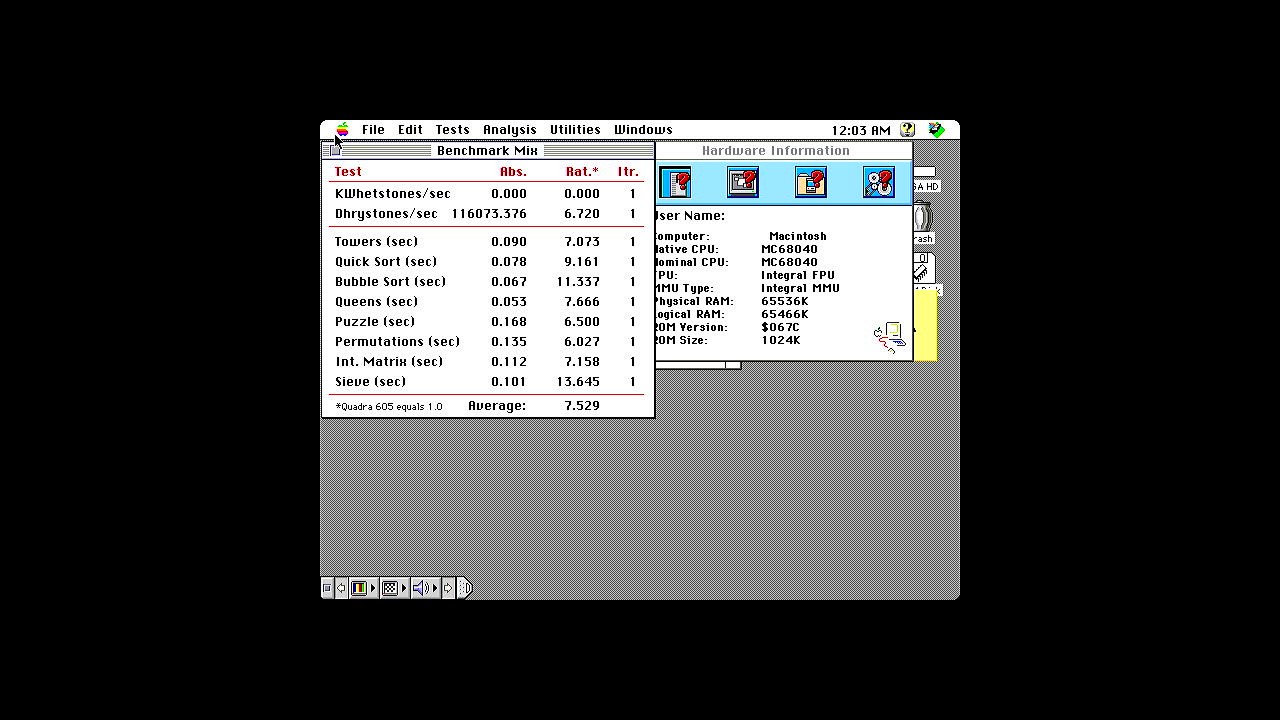
docs/evidence/2026-10-02-ls-ooo-off-speedometer.jpg
