kpwn/m68k-core-040-ooo/docs/superpowers/specs/2026-10-01-deferred-um-ordering-selected.md

# Deferred U/M ordering: selected implementation contract

Status: selected architecture for the D-side descriptor-visibility correction.
This supersedes the route comparison in
`2026-10-01-deferred-um-read-visibility.md`; its measured trace and acceptance
tests remain applicable. The queue bypass prerequisite is implemented by
`UmWriteQueue`, but none of the cross-plugin rules below are implemented yet.
The core architecture document's non-speculative descriptor-write rule is
retained. This specification changes when those writes are ordered with
ordinary memory operations and requires irrevocable at-head authorization
for every ROB-owned update, including a load whose later walk faults.
Services, rather than references to another plugin's implementation
area, carry every new cross-plugin signal. No new `Global` key is required.

## Observable order

For successful accesses, a load of physical descriptor bytes observes every
architecturally older U/M update and software store to those bytes in their
physical program order, plus the U/M update required by that load's own
translation. A later
software descriptor store may clear a previously set U/M bit;
an older deferred OR must not resurrect it. A later U/M update may set that
bit again. A wrong-path **ROB-owned D-side** update never reaches memory, and a TLB fill whose
required update was discarded cannot remain usable. These requirements hold
for an ordinary program load, a DTLB descriptor read, and a two-page split.
On a faulting walk, U changes to descriptors already encountered may still be
architectural; the later failure does not erase them. `mmu_atc_write_hit_sets_modified`, `walk_vs_older_store_slow`, and
`walk_vs_older_store_uncommitted` are mandatory exact regressions. An
arbitrary delay in a test is not a repair.

The I-side fetch occurs before rename and has no ROB owner. Its existing
completed-walk U update is born committed even if no fetched instruction
retires; this is an advisory access side effect, not a ROB-owned data access.
An I-side walk poisoned before completion still must not allocate an update.

The MC68040 User's Manual, pages 3-14 and 3-27, says that a clear U bit is
updated before page access and a write with clear ATC M suspends until its
descriptor M bit is set, then retries the original write. Section 3.2.5 and
Figure 3-10 additionally show U checked for each encountered table descriptor;
a scheduled pointer U write occurs after the next descriptor read but before
its normal decode/termination. Thus a later invalid descriptor can leave an
earlier root/pointer U set. The walker records an ordered *partial* batch on
fault, not only a successful translation's page update.

The core can retain speculative execution and non-speculative metadata writes
while giving younger internal reads the ordered value via forwarding or
replay. At the ROB head, with IRQ/trace/debug preemption excluded, **every
ROB-owned batch** becomes irrevocably authorized. Drain its encountered
metadata read/OR/stores in walk order and receive each terminal response
before owner retirement. Cacheable load data may have executed speculatively,
and its masked result may write the speculative PRF before metadata completes;
only architectural retirement and final fault selection wait for this
metadata outcome. Do not hold unrelated cache responses or force every
first-touch load to execute at the ROB head. On metadata bus error, report a
precise access fault against this
owner; an error in an earlier descriptor's metadata operation takes priority
over a later walk/data fault. A wrong-path batch never authorizes or reaches
memory. An already authorized batch survives redirects until completion;
retirement and IRQ/trace/debug preemption are held. This closes the previous
diagnostic-only metadata-error behavior for ROB-owned accesses; ownerless
fetch/exception errors use the rules below.

For a fast or precise store, its own metadata batch completes before its SQ
data store receives a drain grant. A *precise or device store* also keeps the
data transfer blocked while metadata is pending: authorization, metadata
read/OR/store, existing D4 quiescence fence, then data transfer, then
retirement. A descriptor-self-write test must include software clearing M in
the value it stores: its own metadata OR occurs first, and the later software
value wins. At-head authorization, rather than waiting for retirement,
prevents a store/metadata circular wait. A metadata fault suppresses its data
transfer. A faulting load with an encountered root/pointer U follows the same
at-head drain before the translation fault is delivered.

## D-side walk against older stores and metadata

The DTLB's physical descriptor command checks the SQ before entering the
registered `walkLoadCmd.m2sPipe`. If any older resident SQ store overlaps the
command's physical bytes, deny that command until the store's *terminal ack*;
the cache must not accept a stale read while the store is merely offered or
accepted. Include both split-store halves and actual byte strobes. A full
forward into the walker is an optional later optimization. IQ's present-store
barrier ensures every older store has issued and allocated to SQ before a
younger load may reach this check; see `IssueQueuePlugin`'s
`olderStorePresent` rule. An ordinary store already in SQ has completed its
own translation, so a younger walker waiting on its drain cannot block that
older store's translation.

Likewise, a DTLB descriptor command waits for overlapping older pending D-side
U/M bytes to drain. Updates from an *earlier descriptor in its own walk* are
forwarded into the later descriptor response: a self-referential table must
see its root/pointer U, and waiting for its own batch to retire would deadlock.
It need not hold unrelated walks. The U/M drain must be
able to preempt a walker *between* descriptor reads: expose TableWalker's
`cmdSent` as `readOutstanding`, including a command accepted into the
`m2sPipe` but not yet accepted by Dcache. Arm the U/M re-read whenever no
walker read is outstanding, even if the walker FSM is busy; hold the walker's
command ready low while U/M owns the request and response. If a walker read
was already accepted, let its single response return before preemption.
`DcachePlugin`'s nonblocking `serialPending` admits only one `ooOk=false`
walker/U/M command through its response, so there is still exactly one DTLB
response owner at a time. Assert this and test an error response and the last
byte of a split descriptor. Do not infer two concurrent serial cache requests
from the LS-EU's response FIFO capacity.

When an older owner allocates U/M *after* a younger walk or load read, its
retirement requests the existing macro-boundary order redirect. All younger
work re-executes after the owner retires. Invalidate DTLB ATC entries on this
redirect, and whenever a backend flush discards speculative queued U/M, so a
younger stale fill cannot claim U/M is already set and suppress the rewalk.
This may conservatively clear older correct ATC entries; their descriptor
writes are retained and a later walk recreates them. Measure redirect and
ATC-refill frequency on first-touch workloads.

## Ordinary loads and SQ forwarding

At each Dcache request admission, query both U/M queues' batch elements by *physical byte*
address. Include all committed D-side entries, speculative D-side entries
whose ROB owner is older than the querying load, **and that load's own
translation entries**, plus ownerless I-side entries ordered before the
request by the epoch below. The own-entry
exception is required when the translated page maps page-table memory: the
walk sets U in the exact byte returned by the same load, before that access
architecturally occurs. A speculative younger owner's entry is excluded. OR
only bits `0x18`. Capture
the mask with that load's aligned-ring context, including both physical halves
of a split access; apply it to the response bytes before extraction, merge,
writeback, or wakeup. Querying only when the response returns loses an update
that popped while the read was outstanding. A subsequently allocated older
entry is handled by the owner redirect above.

An exact full SQ forward is a software-store value, so an older U/M OR must
not blindly modify it. If it overlaps any pending U/M entry from an **older
owner**, conservatively stall and re-query after those updates drain. This
also covers the reverse order (SQ store older than U/M) without adding an age
tag to the SQ forward result. In contrast, the querying load's own U/M entry
is logically after every older SQ store: apply its overlapping U/M bits to
the fully forwarded software value. Never wait for that entry to commit, or
a descriptor self-read deadlocks at its own retirement. The existing
partial-forward stall still waits for its SQ entries; a later cache read
receives the captured older-plus-own U/M mask. The P4 park and immediate
younger replay must leave older owners and both drain ports able to run while
a descriptor load waits.

## Ordering D-side metadata against SQ drains

On each normal U/M owner's at-head authorization, record the terminal SQ-ack
epoch plus the number of *resident committed* older SQ entries, including
accepted halves awaiting final ack. Every older ROB instruction has retired
before authorization, so there are no older uncommitted stores to discover
later. A simultaneous SQ ack counts as completed on the next edge;
the snapshot target must give the same result with or without that collision.
The SQ is FIFO for stores, so this snapshot is an older prefix. Do not include
the owner's own SQ entry; it follows the metadata batch although already
resident. Waiting on that entry would deadlock.

Let that captured older SQ prefix finish. Then prioritize the oldest eligible
U/M entry through re-read, merged store, and terminal ack. Do not present a
newer SQ stream offer until the metadata ack; an already presented SQ offer
must remain valid and finish before the new metadata grant. The SQ needs an
intent/grant split with a latched offered state, so the grant cannot withdraw
`Stream.valid`. The U/M queue's authorized-entry bypass allows this drain even if a
younger speculative walk allocated an earlier physical slot. Since at most
SQ depth eight older resident entries can drain while the U/M entry waits,
the SQ terminal-ack target can use four modular bits; assert the bounded span
and test ack/commit/offer collisions. If the oldest U/M waits for older SQ,
the SQ grant applies only to that older prefix. Younger SQ cannot get ahead.
Within one walk batch, drain root, pointer, then page in walk order; two
batches owned by a page-crossing uop drain first-half before second-half.
ROB-head authorization orders different D-side owners. For batches of the same owner,
store a bounded allocation-order tie-break (or explicit half ordinal), rather
than relying on physical free-slot index after wrap or flush.

The DTLB U/M re-read uses the same physical older-SQ overlap rule as a normal
walker read, using the *offered U/M owner's* age, not the current walker's
robId. This prevents an older software descriptor store from being overwritten
by a read/OR/write based on its previous value. Queue selection remains stable
across offer, flush-valid withdrawal, and ack.
Head authorization is a level held while an owned walk's ROB entry remains at
head and its metadata is unfinished, not a one-cycle retirement notice. A
matching reservation captures this level even when the reserve and authorize
edges coincide; a later split reservation receives the same held level. The
ROB does not retire the owner until all of its metadata batches finish or a
metadata error has been attributed to it.

## Ownerless I-side and exception walks

ITLB U/M writes and exception-owned DTLB walks have no comparable ordinary
ROB owner. Assign each such walk a registered physical epoch relative to SQ
drains. On an epoch request, snapshot the already-committed SQ prefix, keep
already offered/accepted stores valid through terminal ack, and stop *new*
SQ offers past that prefix. Grant the ownerless walk after the prefix drains;
hold later SQ offers until its descriptor read(s) and resulting U/M writes
finish. If an SQ offer or inhibited D4 transfer won first, let it finish and
grant the epoch afterward. This gives software descriptor clears and U/M ORs
a deterministic physical order without treating an uncommitted younger store
as an older dependency. The explicit serializing ATC invalidation remains the
software synchronization point for page-table rewrites that preceded fetch.
An ownerless walk batch is *captured but ineligible to drain* until its manager
asserts `sealOwnerless(epoch)`. The manager starts the logical access with
`beginOwnerless(epoch, walkCount)` for one or two sequential page walks. This
atomically holds that many queue credits; other admissions see the held count
and cannot steal the second credit mid-epoch. Each walk consumes one held
credit on capture, even if its result needs no update. Seal declares that no
more walks will be captured under that epoch and returns unused held credits:
normally both walks were captured, but a terminal first-walk fault may seal
early with a partial U batch and one unused credit. A captured second walk
may still be completing when seal occurs; its reserved slot already belongs
to the epoch. No-update results release their physical slot; sealing
an epoch with no live batch is harmless and requires no drain wait. A partial
fault batch is sealed and drained before the original fault is delivered.
Do not reserve another batch under a sealed epoch. A simultaneous completion
and seal includes that completed batch; a simultaneous pre-offer cancel wins
over seal. An epoch identity cannot be reused while its sealed batches live.
At the first actual metadata offer, mark **all** sibling batches of that epoch
irrevocable, including a reserved sibling; a later poison suppresses result
delivery only. This closes the first-batch-drained-before-second-batch path
without an unbounded epoch-history table.

In the current implementation, an aligned 64-byte I-cache fetch line cannot
cross a 4 KiB/8 KiB page: a later line across the boundary is a separate
one-walk fetch epoch. ExceptionUnit's split frame/vector phases translate,
transfer, then retranslate the next page; each phase is a separate one-walk
epoch sealed before that phase's data transfer. No current exception FSM may
wait to pretranslate a later phase before making progress. The two-batch seal
rule supports a future combined logical access and is exercised in unit tests.
The I-side fetch retains its PC and withholds the translated line from decode
until all encountered U writes finish, even when a later descriptor faults;
a metadata bus error becomes an instruction-access fault at that PC. A fetch
poisoned before its metadata write is offered may cancel its queued epoch.
Once an ownerless metadata write is offered, its epoch is irrevocable and
must finish even if fetch is later poisoned; suppress line/fault delivery for
the discarded PC after completion. An exception-owned D walk likewise finishes
metadata before its exception data transfer; a metadata bus error follows
the existing nested-exception/double-fault path, rather than being discarded.

The D4 sequence is: metadata/ownerless prerequisite, then D4 walker fence and
bus-quiescence wait, then inhibited data transfer. `pendingAtHead` must not
fence the very metadata walk/drain that the head store awaits. Once the
prerequisite releases, the existing D4 fence runs unchanged through transfer
completion. Conversely a new ownerless epoch cannot start after D4 already
owns the fence. Assert a single registered grant winner at the crossing.
Exception entry's already-required SQ drain is part of its epoch prefix; its
walk and metadata must remain grantable while `excActive` owns the frontend.

## Credit, state, and validation bounds

Change each U/M queue entry from one byte to one *walk batch*, carrying up to
three `{physical byte address, set-U/M mask}` elements in root, pointer, page
order. `TableWalker` currently emits only the page element; extend both D and
I walkers to record U for each encountered resident root and pointer table
descriptor and U/M for the final page descriptor. The manual (§3.2.2.1,
§3.2.5) requires those table U updates before page access. The walker emits
one bounded batch with its result or fault at walk completion; a fault result
includes all earlier valid encountered U elements, while a no-update result
releases its reservation. If a later descriptor aliases an earlier element in the same
walk, use the earlier element's U/M bits when decoding it. A repeated page
crossing walk may produce duplicate bytes, which remain ordered OR updates.
Keep the existing speculative D owner and born-committed I/exception owner
identities, but add a D-side authorized state that survives flush while its
owner remains at head. A batch has one owner, one authorization/order stamp, and one SQ ack-prefix
target, while the drain acknowledges its elements individually before freeing
the slot. Flush cannot remove an offered authorized element or make another
element overtake it.

Reserve one batch slot at translation-miss *capture*, not at
`walker.io.start`. A four-batch D queue reserves two slots for the current
ROB-head uop's at-most-two page-crossing walks; a non-head miss may capture
only when more than two slots are free, so an empty queue still admits two
younger independent walks. The head may use either reserved slot. A single
walker can then complete all three descriptor updates without needing another
credit partway through. Admission counts both occupied batches and slots
reserved by accepted walks that have not yet produced a batch; completion
consumes its reservation, a no-update result or squash releases it, and an
allocation cannot borrow the other half of a split owner's reservation.
Same-edge completion/free/capture uses one explicitly specified credit order
and asserts that occupied plus reserved never exceeds four. The I side also
reserves one batch slot before its
ownerless walk and backpressures a new miss while full. If a younger P4
translation is denied and an older LS op is upstream, request immediate P4
replay/backout before DTLB captures anything; the 255-cycle watchdog is not a
normal progress mechanism. A non-head access with no older LS op can wait
until it becomes the ROB head. Exception-owned admission follows the
exception epoch after younger speculative entries are flushed. Measure the
two-credit restriction; depth eight batches is an optional throughput/area
comparison. Intermediate commits may add walker batch capture and queue drain
before interlocks, but the final gates require all three descriptor levels.

Each descriptor's U/M byte is at `descAddr + 3`. Pointer/page descriptors are
aligned, but the current MOVEC root-pointer contract permits a misaligned
root; `TableWalker` supports its split LONG read. Preserve that behavior.
Initially store a general two-bit U/M mask for **every physical byte** in each
16-byte aligned response line: 32 bits per half, 64 per two-half slot, or 512
bits for eight slots. The aligned four-position encoding would require only
128 bits, but it is merely an optional measured refinement with a proven
misaligned-root fallback; no new MOVEC masking is permitted just to save bits.

Worst-case incremental storage before synthesis: four batches per side times
three elements times roughly 35 bits (`addr32`, U/M mask2, valid1) is 420 raw
bits per queue, before shared owner/stamp/offer state; the present leaf-only
queue has four single-byte entries. The general response masks above add
512 bits. Four 4-bit D U/M SQ-target epochs and one 4-bit SQ ack counter
add 20 bits. Across D+I queues the load query compares up to 24 physical
bytes against two requested halves (48 address comparisons); walker SQ query
checks up to eight resident stores against its descriptor bytes. These are
worst-case logical counts, not LUT, frequency, or post-route claims. Keep
queries off the IQ issue-select path and register the mask on Dcache
admission. A depth-16 scalar-byte alternative needs six reserved head credits
and at least three free for one younger walk; a depth-8 scalar queue leaves
only two non-head credits and cannot admit a complete younger three-entry
walk atomically. Measure batch route timing against the scalar alternative.

Directed proof must cover: the three named baseline failures; two U/M writes
with a software clear between them; same-owner precise inhibited descriptor
self-write; a translated LOAD of its own leaf-descriptor byte with clear U,
a fully forwarded older SQ descriptor value plus the load's own U, and a
split partial access whose second physical half overlaps its own descriptor
update; root/pointer U on both D/I walks, same-owner pointer-table access,
and six-update split pressure across two reserved batches. Before claiming
fault-path 68040 fidelity, test a later-descriptor bus error and nonresident
descriptor after an earlier U update: the faulting owner drains the partial
batch, and a metadata error overrides the later walk fault while keeping
precise state. Cover IRQ during metadata authorization, metadata read/write
fault on an ordinary load and a precise store; younger SQ already offered
when a batch authorizes; simultaneous SQ ack plus authorization;
walker blocked by older SQ while older U/M preempts between reads; response
attribution after descriptor fault and split last byte; four younger pending
updates versus oldest split walk with bounded immediate replay; wrong-path
U/M kill plus ATC refetch; D4/ownerless grant in both orders. Run the exact
paired OFF/ON corpus and lockstep gates after focused tests, and compare
first-touch throughput and route timing before enabling by default.
