kpwn/m68k-core-040-ooo/docs/superpowers/plans/2026-08-20-debug-ctrl-stage2-halt-resume-step.md

# Debug/Control AXI Slave — Stage 2: Precise Manual Halt/Resume/Step Implementation Plan

> **For agentic workers:** REQUIRED SUB-SKILL: Use superpowers:subagent-driven-development (recommended) or superpowers:executing-plans to implement this plan task-by-task. Steps use checkbox (`- [ ]`) syntax for tracking.

**Goal:** Make the `dbg_axi` JTAG debug interface actually functional on cpu040: real manual halt/resume, single-step, halt-after (macro-count target), and a live/last committed PC readback — the minimum needed for a host (`tools/jtag_repl.tcl`'s `halt-status`/`pc`/`sweep`/manual-halt commands) to tell a genuine CPU hang from a live core, and to stop it precisely at a known point. Gate the whole feature behind a real, mirror-of-`VioProbePlugin` `enable` flag so it can be compiled out of area/FMax-reference builds.

**Architecture:** `RobPlugin` already owns two halt-shaped mechanisms (`stopped`/STOP and `coreHalted`/fatal) and a registered flush/redirect pulse (`doFlushReg`/`flushPcReg`, `RedirectService`) that every speculative structure (IQ, RAT, frontend, D/I-TLB, store queue) already reacts to. Stage 2 adds a third halt kind — debug-requested — that reuses those mechanisms. `RobPlugin` is the sole provider of `DebugCommitService`, which exposes halt commands plus live/last PC, macro count, and halt state; `DebugCtrlPlugin` communicates with the ROB only through that service. The ROB-local request wires remain implementation details and are never reached through another plugin's internals or routed as sibling IO. Macro-boundary detection uses the real `lastOfInstr` field threaded through decode, rename, and ROB payload by revised Task 4.

**Tech Stack:** SpinalHDL 1.14.1, Scala 2.13.16, ScalaTest 3.2.19, SpinalSim/Verilator, Vivado for the post-route gate. Same as the Stage 0/1 plan (`docs/superpowers/plans/2026-08-17-debug-ctrl-stage0-stage1.md`) — read that plan's own Global Constraints section for anything not repeated here; this plan does not restate Stage 0/1's contract, only Stage 2's additions to it.

## Global Constraints

- Branch is `fmax-closure-fanout`; the plan's parent commit is whatever `git rev-parse HEAD` reports at execution start. Never `git checkout <sha>` in the shared tree — use `git worktree add` for any isolated before/after verification (project standing rule).
- **`docs/superpowers/specs/2026-08-09-debug-ctrl-jtag-repl-design.md` is the authority.** Section 6 (lines 389-527, "Precise halt/resume/step semantics") and section 12's "Stage 2" bullet (lines 777-787) define this plan's scope; section 13 (lines 848-864) lists the required assertions. Read section 6 in full before Task 4 — it is short and precise and this plan's task text does not repeat every clause.
- **`tools/debug/debug_regmap.def` is the frozen, machine-readable source of truth for every register offset and feature bit used in this plan — do NOT invent a new offset or bit.** Everything Stage 2 needs is ALREADY reserved at `STAGE=2` in that file (verified 2026-08-20): `OFF_CONTROL` bits 0/1/7 (`0x00008`, per spec §15.2's table — manual halt / single-step / step-arm, currently RAZ/WI), `OFF_STATUS` bits 0/1/4 (`0x0000C` — halted / exception-pending / auto-halt-latched), `OFF_PC` (`0x00010`, "Next live PC"), `OFF_LAST_PC` (`0x00014`, "Last committed PC"), `OFF_HALT_AFTER_LO/HI` (`0x00030`/`0x00034`), `OFF_HALT_CTL` (`0x0003C`, bit 2 = clear sticky reason/report latches), `OFF_HALT_REASON` (`0x00040`), `OFF_HALT_HIT_INST_LO/HI` (`0x00048`/`0x0004C`, macro count at the stop), `OFF_INST_LO/HI` (`0x01008`/`0x0100C`, free-running macro count), and feature bits 22 (`macro_retire_count`) / 23 (`stop_status_v2`), both already scoped to stage 2. `OFF_HALT_HIT_PC` (`0x00044`) is deliberately **stage 5** (breakpoint-hit reporting) — do not wire it in this plan; a manual/halt-after stop reports its location via `OFF_PC`/`OFF_LAST_PC` instead. `OFF_EXC_VEC`/`OFF_EXC_PC`/`OFF_HALT_EXC_MASK*`/`OFF_BREAK_PC*` are stage 5/9 — leave them RAZ/WI.
- **No new `Global.scala` key** (spec §0.9, restated from Stage 0/1's own constraint — still binding).
- **No new socket port.** Every Stage-2 register lives inside the existing `dbg_axi` CSR address space; `cpu_socket.vh`'s port list is unchanged by this plan.
- **The whole feature must be optional and gated** (explicit user directive, 2026-08-20): `DebugCtrlPlugin` currently has NO `enable` parameter and is instantiated unconditionally at `FullCoreSynth.scala:580`. Task 1 retrofits an `enable: Boolean = true` constructor parameter mirroring `VioProbePlugin`'s exact disable pattern (`src/main/scala/m68k040/debug/VioProbePlugin.scala:37-81`): every declared IO stays present and named identically regardless of `enable` (so the socket contract never moves), but with `enable=false` every register is tied to its Stage-1-shell RAZ/WI behavior (or, if simplest, the plugin's `logic` degenerates to exactly today's Stage-1-only behavior) and **zero** Stage-2 RTL is instantiated in `DebugCtrlPlugin`. Optional service resolution must preserve standalone and disabled builds. The ROB-local request wires (`debugStopRequestIn`, `debugStepRequestIn`, `haltAfterTargetIn`) follow the same `allowOverride`-plus-idle-default convention already used for `coreHaltedIn`/`completion`/`branchCompletion`; they are driven only by `DebugCommitService.request(...)`, never by sibling-plugin access.
- **Macro-boundary detection REQUIRES a new per-uop field — RETRACTED 2026-08-20.** The original claim here (reuse `RobPayload.first` + ring occupancy, no new field needed) was dispatched as Task 4 and came back NEEDS_CONTEXT with a confirmed, structurally-reachable counterexample: `MicroOpQueue` (`decode/MicroOpQueue.scala:66,75`) pops at most 2 uops/cycle and `DispatchPlugin` (`dispatch/DispatchPlugin.scala:24-31`) gates 2-wide dispatch on ROB/IQ backpressure, so a 3+-uop crack (e.g. a memory-destination RMW: load/op/store, `MicroOpAssembler.scala:1249,1320,1326`) can reach `count==1` with `h0` = a MIDDLE uop mid-macro, before its real last uop is even allocated — the `(count<=1)||p1.first` derivation reads True there, incorrectly, which would silently drop the store on a debug stop at that instant. Task 4 (see its own now-revised text below) instead threads a real `lastOfInstr` field through `DecodedUop`→`RenamedUop`→`RobPayload`, mirroring `firstOfInstr`'s own ~20-site threading exactly — the cost this bullet originally tried to avoid, now confirmed necessary. `MicroOp.scala:12`'s dead `lastUop` field is a DIFFERENT bundle (post-rename issue scheduling, not decode/rename) and is not reused.
- **Effective halt does NOT require the store queue or D-cache to be idle** (spec §6.3, verbatim: "Effective halt deliberately does not require the store queue or D-cache to be idle... If a bus is wedged, requiring global memory quiescence here would make the debugger unable to stop at the exact moment it is needed most"). Do not gate the halt FSM's `HALTED` transition on any SQ/D-cache busy signal. `DebugMemoryQuiesceService` (a SEPARATE, later concern for cache-maintenance/arch-apply launch) is explicitly OUT of scope for this plan — Stage 2 has no cache-maintenance or arch-apply command to gate.
- **Fatal halt (`coreHalted`) is non-resumable and takes priority over debug halt** (spec §6.3, §13: "a resume request cannot release a fatal halt"). Every task touching resume must preserve this.
- **`ExecuteLockStepSpec` baseline is 399/400** (1 known pre-existing failure: `CMP2.W (d8,An,Xn) indexed bounds pointer` (task #257, already tracked) -- CORRECTED 2026-08-20 during Task 1 execution, the STOP/ITLB-failures baseline this plan originally cited was stale project-memory, not the actual current HEAD baseline) — verify against this exact baseline, not a fresh count, at every task's gate. Re-read the CURRENT actual failing-test names before the first task (they may have drifted since this plan was written) rather than trusting this list blindly.
- **`sbt "testOnly X -- -z name"` as separate shell tokens SILENTLY DROPS the `-z` filter** in this environment and runs the entire suite. Use the single quoted form: `sbt "testOnly X -- -z name"`. (Standing warning from the Stage 0/1 plan's own ledger, repeated here since every task's verification step needs it.)
- **The real, hardware-motivating context for this plan**: this session found that `tools/jtag_repl.tcl`'s `halt-status`/`pc`/`sweep`/`arch` commands all read back zero/uninformative against a real CPU=m68k040 bitstream — not because the CPU is hung, but because none of this RTL exists yet (Stage 1 only implements version/build/features/control/status/reset-count). A concurrently-running boot_fsm ROM-mirror fix (commit `d3b21e3`, macqd700-soc worktree) is independently verified correct via direct AXI memory readback; whether the CPU is actually executing that code cannot currently be told apart from a genuine hang. This plan's Task 14 gate should be followed by a real hardware re-test once merged (tracked separately, not a task in this plan — this plan's scope is the RTL and its Scala-level verification only, not a new bitstream build/flash cycle).
- **Mandatory full-core OOC synth gate at the end (project standing rule, `[[synth-gate-every-slice]]`)**: report absolute LUT/FF/DSP/BRAM utilization and FMax for both `enable=true` and `enable=false` builds. **User directive (2026-08-20): the `enable=true` build's FMax hit is EXPLICITLY ACCEPTED, even beyond spec §11's provisional +2% ceiling** — the stated plan is that this halt/resume/step logic will eventually sit on a hot retire-path signal, production ships `enable=false` for full clock speed, and a JTAG-enabled debug bitstream running at roughly half clock speed is an accepted tradeoff, not a gate failure. **Concrete numeric targets (user, same message): `enable=true` (JTAG bitstream) targets ~100MHz; `enable=false` (production, no JTAG) targets ~200MHz** — these are the real product-level numbers this session's own real-hardware bitstream work already runs at 100MHz (`CORE_CLK_HZ=100_000_000` in the macqd700-soc build), so an `enable=true` post-route result comfortably above 100MHz is a PASS regardless of how far below the `enable=false` build's own number it lands; the `enable=false` build is judged against the actual current FMax-campaign reference (~200MHz class, re-read at execution time per this file's own standing rule below), not against the `enable=true` number. **This does NOT relax the `enable=false` build's gate**, which must still show zero-to-negligible cost against the pre-Stage-2 reference (it carries none of this task's new logic — see Task 1's `if(enable)` gating) — that build is production's actual target and spec §11's numbers still apply to it. Task 14 therefore gates on: (a) `enable=false` meets the strict spec §11 numbers against the ~200MHz-class reference, (b) `enable=true` clears ~100MHz post-route with real margin (not a knife-edge pass), and its WNS regression relative to `enable=false`, however large, traces cleanly to the NEW debug halt/resume/step logic itself (report the worst path and confirm it's plausibly this feature, not an unrelated regression riding along), and (c) still flag if the `enable=true` worst path is literally "a debug comparator, CSR read mux, or high-fanout debug enable" per spec §11's specific named failure mode, since THAT diagnosis (as opposed to the raw number) is what tells us whether a later pipelining pass could recover most of the loss cheaply — worth knowing even though it's no longer a hard blocker. The FMax reference is re-read at execution time from the most recent recorded post-route number on this branch, never hardcoded — Task 14 re-reads it.

---

## Task 1: Gate `DebugCtrlPlugin` behind a real `enable` flag

**Files:**
- Modify: `src/main/scala/m68k040/debug/DebugCtrlPlugin.scala`
- Modify: `src/main/scala/m68k040/top/FullCoreSynth.scala:580` (and the `main` at line 591-593)
- Test: `src/test/scala/m68k040/debug/DebugCtrlPluginSpec.scala` (locate the existing Stage-1 spec file — it exists since Stage 1 shipped; add to it, do not create a duplicate)

**Interfaces:**
- Consumes: nothing new.
- Produces: `DebugCtrlPlugin(buildId: BigInt, porCycles: Int, stage: Int, enable: Boolean = true)` — every later task in this plan places its new logic inside the `if (enable) { ... }` branch this task creates. Every later service connection must be optional so that `enable=false` produces IDENTICAL RTL (module-for-module) to the current `main` branch's `M68kFullCoreSynth.v` for everything outside `DebugCtrlPlugin` itself.

- [ ] **Step 1: Read the exact disable pattern to mirror**

Read `src/main/scala/m68k040/debug/VioProbePlugin.scala` lines 1-90 in full before writing this task's code — its own comments (lines 17-26, 41-45, 76-81) explain SpinalHDL's "a `val` declared only inside `if (enable) {...}` cannot be referenced outside that block" constraint and the exact idiom used to keep every IO port present-and-named regardless of `enable`. Follow that idiom exactly, not a paraphrase of it.

- [ ] **Step 2: Add the `enable` constructor parameter**

In `DebugCtrlPlugin.scala`, change the class signature:

```scala
class DebugCtrlPlugin(val buildId:   BigInt  = BigInt(0),
                      val porCycles: Int     = DebugRegMap.POR_CYCLES_DEFAULT,
                      val stage:     Int     = 1,
                      val enable:    Boolean = true) extends FiberPlugin {
```

Add a doc comment above the class (alongside the existing `@param` list) documenting `enable`: "When false, every socket port this plugin declares (`dbg_axi`, `cpu_cold_reset_pulse`, `cpu_cold_reset_hold`, `cpu_ram_window_lg2`, `cpu_mon_sense`) stays present with its exact name and width — the socket contract never moves — but is tied to a dead-idle value (AXI READY held low forever, `bresp`/`rresp` OKAY on the rare accepted default path, cold-reset outputs low, RAM window/mon-sense their POR constants) and zero debug logic is instantiated. Mirrors `VioProbePlugin`'s `enable` pattern exactly (spec `2026-08-18-vio-jtag-debug-design.md` V4)."

- [ ] **Step 3: Wrap the existing Stage-1 `logic` body in `if (enable) { ... } else { ... }`**

The whole current `val logic = during build new Area { ... }` body (lines 54-442 of the file as it exists before this task) becomes the `if (enable)` arm, UNCHANGED. Add an `else` arm that declares every port the `if` arm declares (same `slave(DbgAxiLite(...))`, same 4 `out`/`in` socket signals) with dead-idle drives:

```scala
val logic = during build new Area {
  val dbgAxi = slave(DbgAxiLite(DebugRegMap.DBG_AW, DebugRegMap.DBG_DW))
  dbgAxi.setName("dbg_axi")
  val coldResetPulse = out(Bool()).setName("cpu_cold_reset_pulse")
  val coldResetHold  = out(Bool()).setName("cpu_cold_reset_hold")
  val initDoneSeen   = in(Bool()).setName("init_done_seen")
  val ramWindowLg2   = out(UInt(6 bits)).setName("cpu_ram_window_lg2")
  val monSense       = out(UInt(7 bits)).setName("cpu_mon_sense")

  if (enable) {
    // <-- everything that is currently the WHOLE body of `logic` in the file
    // as it exists today (the `dbgAxi.setName`/`coldResetPulse`/etc lines above
    // are hoisted OUT of this block since both arms need them; do not
    // duplicate their declarations inside this `if`) goes here, unmodified.
  } else {
    dbgAxi.awready := False
    dbgAxi.wready  := False
    dbgAxi.arready := False
    dbgAxi.bvalid  := False
    dbgAxi.bresp   := DbgAxiLite.RESP_OKAY
    dbgAxi.rvalid  := False
    dbgAxi.rdata   := B(0, DebugRegMap.DBG_DW bits)
    dbgAxi.rresp   := DbgAxiLite.RESP_OKAY
    coldResetPulse := False
    coldResetHold  := False
    ramWindowLg2   := U(DebugRegMap.RAM_WINDOW_LG2_POR, 6 bits)
    monSense       := U(DebugRegMap.MON_SENSE_POR, 7 bits)
  }
}
```

Follow `VioProbePlugin`'s own comment (lines 41-45) about promoting shared `val`s to the enclosing scope rather than duplicating declarations in both arms — apply the identical restructuring discipline here (hoist `dbgAxi`/`coldResetPulse`/`coldResetHold`/`initDoneSeen`/`ramWindowLg2`/`monSense` to the `logic` Area's own scope, both arms only ASSIGN into them).

- [ ] **Step 4: Wire the flag through `FullCoreSynth.scala`**

At `FullCoreSynth.scala:580`, keep the call site unchanged for now (`new m68k040.debug.DebugCtrlPlugin(buildId = dbgBuildId, stage = 1)`) — the default `enable = true` preserves today's behavior exactly, so `M68kFullCoreSynth.v` is unaffected by this task. Add a SECOND generation target, mirroring the existing `GenFullCoreSynthVioVerilog` twin-target pattern at line ~596 (read that pattern first): a `GenFullCoreSynthNoDebugVerilog` object whose `main` calls `buildWith(..., debugEnable = false, outputName = "M68kFullCoreSynthNoDebug")`. This requires threading a new `debugEnable: Boolean` parameter through `buildWith`'s own signature (find it above line 555) down to the `DebugCtrlPlugin(...)` call site, defaulting `true` so every EXISTING caller of `buildWith` is unaffected.

- [ ] **Step 5: Directed test — both builds elaborate, and `enable=false` matches pre-Stage-2 Stage-1 behavior byte-for-byte**

Add to `DebugCtrlPluginSpec.scala` (find its existing `SimpleDut`-equivalent harness first — Stage 1 already has directed tests for this plugin standalone; match its DUT-construction convention exactly rather than inventing a new one):

```scala
test("enable=false: AXI READY never asserts, cold-reset outputs stay low, RAM window/mon-sense read POR defaults") {
  // construct the DUT with DebugCtrlPlugin(enable = false); drive a few AXI
  // AR/AW transactions across N cycles; assert dbgAxi.arready/awready/wready
  // NEVER go high (READY-low = accepted-nothing, not a hang -- the disabled
  // slave simply never completes a transaction, which is the correct "this
  // plugin does not exist" contract, not a protocol violation since AXI
  // permits READY to stay low indefinitely).
}
```

- [ ] **Step 6: Compile + lock-step regression + verilator lint on both targets**

```
~/sbt/bin/sbt compile
~/sbt/bin/sbt "testOnly m68k040.debug.DebugCtrlPluginSpec"
~/sbt/bin/sbt "testOnly m68k040.lockstep.ExecuteLockStepSpec"   # expect 399/400, unchanged
~/sbt/bin/sbt "runMain m68k040.top.GenFullCoreSynthVerilog"
~/sbt/bin/sbt "runMain m68k040.top.GenFullCoreSynthNoDebugVerilog"
make lint-fpga-top CPU=m68k040   # from the macqd700-soc worktree, if reachable; note if not and defer
```

Diff `generated/M68kFullCoreSynth.v` against a copy taken BEFORE this task's edit (same `dbgBuildId` env) — it must be BYTE-IDENTICAL, proving the default-`enable=true` refactor is a pure no-op for the shipped netlist.

- [ ] **Step 7: Commit**

```bash
git add src/main/scala/m68k040/debug/DebugCtrlPlugin.scala src/main/scala/m68k040/top/FullCoreSynth.scala src/test/scala/m68k040/debug/DebugCtrlPluginSpec.scala
git commit -m "debug: gate DebugCtrlPlugin behind a real enable flag (Stage 2 task 1)"
```

---

## Task 2: `DebugCommitService` trait + `RobPlugin` setup-allocated-wire skeleton

**Files:**
- Modify: `src/main/scala/m68k040/services/Services.scala`
- Modify: `src/main/scala/m68k040/rob/RobPlugin.scala`
- Test: `src/test/scala/m68k040/rob/RobPluginSpec.scala` (add a sink-plugin test; follow `RobTestHelpers.scala`'s existing `FrontendQuiesceSinkPlugin` at lines 96-104 as the template)

**Interfaces:**
- Consumes: nothing (pure plumbing task — every field below is driven to an inert default; Task 3 onward gives them real values).
- Produces: `DebugCommitService` trait with:
  ```scala
  trait DebugCommitService {
    def effectiveHalt: Bool        // OFF_STATUS bit 0
    def autoHaltLatched: Bool      // OFF_STATUS bit 4
    def haltReasonDebug: UInt      // 3 bits: NONE/MANUAL/STEP/HALT_AFTER (Task 9 defines the encoding)
    def livePc: UInt               // OFF_PC — next-to-execute macro PC while halted
    def lastPc: UInt               // OFF_LAST_PC — most recently retired macro's PC
    def macroCount: UInt           // 64 bits (host reads as OFF_INST_LO/HI, two 32-bit halves)
    def haltHitInstCount: UInt     // 64 bits — macroCount latched at the stop (OFF_HALT_HIT_INST_LO/HI)
    // Task 7 adds haltAfterConsumed plus configureHaltAfter(...); the pulse lets the
    // debug-domain owner consume one arm without conflating it with sticky status.
    // Debug -> ROB commands, consumed here for symmetry with the setup-allocated-wire
    // pattern's existing "same trait carries both directions" precedent (none currently
    // does — RedirectService/FrontendQuiesceService are one-directional — so this is a
    // DELIBERATE deviation: see Task 5's own note on why request/response live in one
    // trait rather than two).
  }
  ```
  Later tasks add `def request(stop: Bool, step: Bool, resume: Bool, haltAfterTarget: UInt, haltAfterArm: Bool): Unit` or an equivalent command bundle — Task 5 finalizes this trait's exact shape once the FSM's real input contract is known; THIS task only adds the 7 read-side accessors above, all driven to `False`/`0`.

- [ ] **Step 1: Add the trait to `Services.scala`**

Place it immediately after `FrontendQuiesceService` (line 49-54), following that trait's own doc-comment style:

```scala
/** ROB-owned debug halt/resume/step state (design spec
  * `docs/superpowers/specs/2026-08-09-debug-ctrl-jtag-repl-design.md` section 6, Stage 2).
  * Read-side only in this task; `DebugCtrlPlugin` is the sole consumer and resolves
  * this service directly. */
trait DebugCommitService {
  def effectiveHalt:    Bool
  def autoHaltLatched:  Bool
  def haltReasonDebug:  UInt
  def livePc:           UInt
  def lastPc:           UInt
  def macroCount:       UInt
  def haltHitInstCount: UInt
}
```

- [ ] **Step 2: `RobPlugin` implements it via the setup-allocated-wire pattern**

Mirror `_frontendQuiesceActive`/`_frontendQuiesceNext` (`RobPlugin.scala:41-54`) EXACTLY — same reasoning (breaks the Icache→Rob→Rename→Decode→FetchAlign→Icache Fiber cycle), same `private var` + `override def` + `during setup { ... = Bool()/UInt(...) }` shape:

```scala
class RobPlugin extends FiberPlugin with CommitTraceService with RobAllocService with RedirectService
  with BtbUpdateService with GshareUpdateService with PrivilegeService with CacheControlService
  with FrontendQuiesceService with DebugCommitService {

  // ... existing _supervisor/_dcacheEnabled/_frontendQuiesceActive/_frontendQuiesceNext ...
  private var _debugEffectiveHalt:    Bool = null
  private var _debugAutoHaltLatched:  Bool = null
  private var _debugHaltReason:       UInt = null
  private var _debugLivePc:           UInt = null
  private var _debugLastPc:           UInt = null
  private var _debugMacroCount:       UInt = null
  private var _debugHaltHitInstCount: UInt = null
  override def effectiveHalt:    Bool = _debugEffectiveHalt
  override def autoHaltLatched:  Bool = _debugAutoHaltLatched
  override def haltReasonDebug:  UInt = _debugHaltReason
  override def livePc:           UInt = _debugLivePc
  override def lastPc:           UInt = _debugLastPc
  override def macroCount:       UInt = _debugMacroCount
  override def haltHitInstCount: UInt = _debugHaltHitInstCount
  during setup {
    _supervisor             = Bool()
    _dcacheEnabled          = Bool()
    _frontendQuiesceActive  = Bool()
    _frontendQuiesceNext    = Bool()
    _debugEffectiveHalt     = Bool()
    _debugAutoHaltLatched   = Bool()
    _debugHaltReason        = UInt(3 bits)
    _debugLivePc            = UInt(32 bits)
    _debugLastPc            = UInt(32 bits)
    _debugMacroCount        = UInt(64 bits)
    _debugHaltHitInstCount  = UInt(64 bits)
  }
```

- [ ] **Step 3: Drive every new wire to an inert default inside `logic`**

Near the END of `logic` (find where `_frontendQuiesceActive := stopped || coreHalted` is driven — the explore pass for this plan located it around line 1523; place these assignments immediately after it, same Area scope):

```scala
_debugEffectiveHalt    := False
_debugAutoHaltLatched  := False
_debugHaltReason       := U(0, 3 bits)
_debugLivePc           := p0.pc          // best available "next" PC today; Task 6 refines
_debugLastPc           := U(0, 32 bits)  // Task 3 gives this a real producer
_debugMacroCount       := U(0, 64 bits)  // Task 3 gives this a real producer
_debugHaltHitInstCount := U(0, 64 bits)
```

- [ ] **Step 4: Directed test — service resolves, defaults are inert**

In `RobTestHelpers.scala`, add a `DebugCommitSinkPlugin` mirroring `FrontendQuiesceSinkPlugin` (lines 96-104) exactly: implement nothing, just `host[DebugCommitService]` and expose each accessor as `out` IO for a directed test to peek. In `RobPluginSpec.scala`, add:

```scala
test("DebugCommitService resolves and every field is inert (False/0) with no debug driver wired") {
  // wire dut.rob + dut.dsink (DebugCommitSinkPlugin) via host.asHostOf(...);
  // run N cycles with normal retire traffic flowing; assert dsink.logic.effectiveHaltOut
  // stays False throughout and macroCountOut/haltHitInstCountOut stay 0 -- proves this
  // task adds zero observable behavior change, only plumbing.
}
```

- [ ] **Step 5: Compile + lock-step regression**

```
~/sbt/bin/sbt compile
~/sbt/bin/sbt "testOnly m68k040.rob.RobPluginSpec"
~/sbt/bin/sbt "testOnly m68k040.lockstep.ExecuteLockStepSpec"   # expect 399/400, unchanged
```

- [ ] **Step 6: Commit**

```bash
git add src/main/scala/m68k040/services/Services.scala src/main/scala/m68k040/rob/RobPlugin.scala src/test/scala/m68k040/rob/RobTestHelpers.scala src/test/scala/m68k040/rob/RobPluginSpec.scala
git commit -m "rob: DebugCommitService skeleton, setup-allocated-wire pattern (Stage 2 task 2)"
```

---

## Task 3: Free-running macro-retire counter (`OFF_INST_LO/HI`, feature bit 22)

**Files:**
- Modify: `src/main/scala/m68k040/rob/RobPlugin.scala`
- Test: `src/test/scala/m68k040/rob/RobPluginSpec.scala`

**Interfaces:**
- Consumes: `retire0`/`retire1` and the real `p0.last`/`p1.last` macro-completion markers.
- Produces: `_debugMacroCount` (Task 2's wire) now has a real value; `_debugLastPc` gets a real producer too (same task, since both are trivial retire-time captures).

- [ ] **Step 1: Add the counter register**

Near the other retire-time Regs (alongside `stoppedPc`/`coreHalted`, not inside the payload Mem — this is a single free-running counter, not per-entry state):

```scala
// ── Debug macro-retire counter (Stage 2, feature bit 22 macro_retire_count) ────
// Counts COMPLETED macro-instructions, not micro-ops: increments once per retiring
// entry whose payload.last is True. A 5-uop MOVEM increments on its final uop, so
// count N means macro N is wholly committed -- required by halt-after's boundary rule.
// Free-running: never cleared
// except by CPU reset (it lives in RobPlugin's own logic, which IS the CPU-reset
// domain -- unlike DebugCtrlPlugin's surviving debug-domain registers).
val debugMacroCountReg = Reg(UInt(64 bits)) init 0
debugMacroCountReg.simPublic()
val debugMacroCountInc =
  (retire0 && p0.last).asUInt.resize(2) +
  (retire1 && p1.last).asUInt.resize(2)
when(debugMacroCountInc =/= 0) { debugMacroCountReg := debugMacroCountReg + debugMacroCountInc.resized }
```

- [ ] **Step 2: Add the last-committed-PC capture**

```scala
// ── Debug last-committed-PC (Stage 2, OFF_LAST_PC) ──────────────────────────
// The PC of the most recently retired MACRO (not every uop -- a trailing uop of
// a cracked macro shares its leading uop's PC by construction, per payload.pc's
// own doc comment, so capturing on EVERY retire vs only on first=True retires is
// observationally identical for this field; captured unconditionally on any
// retire for simplicity, matching that equivalence).
val debugLastPcReg = Reg(UInt(32 bits)) init 0
debugLastPcReg.simPublic()
when(retire1)      { debugLastPcReg := p1.pc }
  .elsewhen(retire0) { debugLastPcReg := p0.pc }
```

**Clarifying note (added 2026-08-20 during Task 3 execution, its own implementer's finding):** `OFF_LAST_PC`/`debugLastPcReg` captures `payload.pc` — the retiring macro's OWN raw starting PC (`u.pc`, set at alloc), NOT `predNextPc`/`commitPc` (the NEXT macro's PC, `pc + 2` for a plain 1-word instruction). These are two genuinely different conventions already in use elsewhere in this same file (e.g. an existing "alloc + 2-wide retire" test's own comment uses `predNextPc = pc + 2`) — do not assume they're interchangeable when writing directed tests against this field; a 1-word instruction at PC `0x200` retiring leaves `debugLastPcReg == 0x200`, not `0x202`.

Place both immediately after the existing `retire1` definition (so `retire0`/`retire1`/`p0`/`p1` are already in scope) and BEFORE the head/tail-advance logic, matching this file's existing convention of computing retire-time derived state close to where `retire0`/`retire1` are defined.

- [ ] **Step 3: Wire into the Task-2 service accessors**

Replace Task 2's placeholder drives:

```scala
_debugMacroCount := debugMacroCountReg
_debugLastPc     := debugLastPcReg
```

- [ ] **Step 4: Directed test — counts macros, not uops**

```scala
test("debugMacroCount increments once per retiring macro, not once per retired uop") {
  // Drive a 3-uop cracked "macro" (first=True, False, False) through alloc/complete/retire
  // across 3 separate cycles (single-wide retire each cycle to keep the sequencing simple),
  // then a 1-uop macro. Assert dsink.logic.macroCountOut == 2 after both have retired, and
  // == 0 until the LAST uop of the 3-uop macro retires, then == 1 (not 3).
}
test("debugLastPc tracks the most recently retired entry's PC, single- and dual-retire") {
  // Retire two independent single-uop macros at DIFFERENT PCs in the SAME cycle
  // (retire0 && retire1 both true); assert debugLastPcOut == the SLOT-1 (p1) PC,
  // not slot 0 -- proves the elsewhen priority is right.
}
```

- [ ] **Step 5: Compile + lock-step regression**

```
~/sbt/bin/sbt compile
~/sbt/bin/sbt "testOnly m68k040.rob.RobPluginSpec"
~/sbt/bin/sbt "testOnly m68k040.lockstep.ExecuteLockStepSpec"   # expect 399/400, unchanged
```

- [ ] **Step 6: Commit**

```bash
git add src/main/scala/m68k040/rob/RobPlugin.scala src/test/scala/m68k040/rob/RobPluginSpec.scala
git commit -m "rob: free-running macro-retire counter + last-committed-PC (Stage 2 task 3)"
```

---

## Task 4: Macro-boundary detection — thread a real `lastOfInstr` field (REVISED 2026-08-20, see below)

**REVISION NOTICE:** this task's ORIGINAL text (a ring-occupancy-derived `h0IsMacroLast = (count <= 1) || p1.first`, explicitly justified by this plan's own Global Constraints as avoiding "threading a new per-uop field through ~20 crack sites") was dispatched to an implementer and came back **NEEDS_CONTEXT with a confirmed, independently-reproduced counterexample**, per this plan's own Step 3 instruction to escalate rather than proceed if the underlying atomicity assumption was false. It is false, on two independent grounds, both directly verified against the current codebase (not inferred):

1. **`MicroOpQueue` (`src/main/scala/m68k040/decode/MicroOpQueue.scala:66,75`) pops at most 2 uops/cycle** (`io.pop.valid := count > 0`, `io.pop1Valid := count > 1`), with zero macro-boundary awareness. A 3-uop crack — e.g. a memory-destination RMW (`ADD.L D0,(A0)`: LOAD `firstOfInstr=True` at `MicroOpAssembler.scala:1249`, OP-uop `first=False`, `rmwStUop`/STORE `first=False`, explicitly commented "a trailing µop" — genuinely 3 distinct uops) **cannot** be pushed to the ROB in one cycle even under zero backpressure, since the queue physically cannot pop 3 at once.
2. **`DispatchPlugin` (`src/main/scala/m68k040/dispatch/DispatchPlugin.scala:24-31`) gates its whole 2-wide `fire` on `rob.allocReady && iq.push.ready`** — ordinary ROB/IQ backpressure (routine under real program load) can delay a macro's remaining uop(s) an arbitrary number of cycles after its earlier uop(s) already retired-eligible.

Concretely: for the RMW example above, if LOAD+OP dispatch together but STORE's own dispatch stalls behind backpressure, and LOAD completes and retires alone before STORE is even allocated, the ROB reaches `count==1` with `h0 = OP` (not the macro's real last uop, STORE) — `h0IsMacroLast = (count<=1) || p1.first` reads **True**, incorrectly. A debug stop pending at that exact moment would RECOVER right there, and the STORE — the RMW's actual memory write — **would never execute**. This is exactly the silent-corruption failure mode spec §6.2 exists to prevent, now reproduced as a structurally-reachable scenario rather than a hypothetical.

**Corrected approach (this section replaces the original Task 4 in full):** thread a real, decode-time-known `lastOfInstr: Bool` field through the SAME path `firstOfInstr` already takes — `DecodedUop` → `RenamedUop` → `RobPayload` — set at every one of `firstOfInstr`'s own ~20 assignment sites (grep confirms these live in `src/main/scala/m68k040/decode/MicroOpAssembler.scala` and 2 sites in `src/main/scala/m68k040/decode/Microcode.scala:2987,3511`; the dead `lastUop: Bool` field at `src/main/scala/m68k040/types/MicroOp.scala:12` is a DIFFERENT bundle — the post-rename issue-scheduling `MicroOp`, not `DecodedUop`/`RenamedUop` — and is NOT the right place to add this; it stays dead). This is the exact scope this plan's Global Constraints originally tried to avoid — it turns out to be necessary, not optional, and the "large and error-prone for no benefit" framing was wrong on the "no benefit" half specifically (the benefit is correctness; the "large" half was correct, hence this task is now bigger than originally scoped). Once `p0.last`/`p1.last` exist as real, alloc-time-captured facts, `h0IsMacroLast` becomes a TRIVIAL `p0.last` (no ring-occupancy trick, no `count<=1` special case, no correctness risk from partial-macro dispatch).

**Files:**
- Modify: `src/main/scala/m68k040/decode/DecodedUop.scala` (new field, alongside `firstOfInstr` at line 593)
- Modify: `src/main/scala/m68k040/rename/RenamedUop.scala` (new field, alongside `firstOfInstr` at line 114)
- Modify: `src/main/scala/m68k040/rename/RenameStage.scala` (thread it, alongside the existing `r.firstOfInstr := dec.firstOfInstr` at line 221)
- Modify: `src/main/scala/m68k040/decode/MicroOpAssembler.scala` (set `lastOfInstr` at every one of the ~20 sites that currently sets `firstOfInstr` — NOT a mechanical "last = !first": some cracks have 3+ uops with a MIDDLE uop that is neither first nor last, e.g. the RMW example above where the OP-uop is `first=False, last=False`. Each site needs its own deliberate determination of which uop in that specific crack pattern is genuinely LAST, mirroring the care already visible in each site's own `firstOfInstr` comment.)
- Modify: `src/main/scala/m68k040/decode/Microcode.scala` (the 2 direct `u.firstOfInstr := ...` sites at lines 2987, 3511)
- Check: `src/main/scala/m68k040/decode/DecodeStage.scala` (the MOVEM multi-cycle FSM at lines 314-323 and its own An-update trailing uop at `MicroOpAssembler.scala:112-115`, explicitly commented "the macro instruction's last µop (NOT first)" — confirm whether this FSM sets `firstOfInstr` directly or goes through `MicroOpAssembler`'s helpers; wire `lastOfInstr` through whichever it is)
- Modify: `src/main/scala/m68k040/rob/RobPlugin.scala` (`RobPayload.last` field alongside `RobPayload.first`; `p.last := u.lastOfInstr` in `payloadFrom`, alongside `p.first := u.firstOfInstr`; `h0IsMacroLast := p0.last`)
- Test: `src/test/scala/m68k040/rob/RobPluginSpec.scala`, plus any decode-level spec that already tests `firstOfInstr` threading (grep for one — mirror its structure for `lastOfInstr`)

**Interfaces:**
- Consumes: nothing new at the ROB level beyond what already exists; the new field rides the EXACT SAME bundles/threading `firstOfInstr` already uses.
- Produces: `RobPayload.last: Bool` (alloc-time captured, mirroring `RobPayload.first`); `h0IsMacroLast: Bool` in `RobPlugin.logic`, now simply `p0.last` — same name/meaning Task 5 already expects to consume, so Task 5's own text does NOT need to change.

- [ ] **Step 1: Read spec §6.2 in full** (`docs/superpowers/specs/2026-08-09-debug-ctrl-jtag-repl-design.md:426-444`) — this section's own text ALREADY calls for "explicit `macroFirst` and either `macroLast` or an equivalent boundary event from the ROB," which is exactly what this revised task now does literally, rather than the equivalent-event shortcut the original text tried first.

- [ ] **Step 2: Enumerate every `firstOfInstr` assignment site and determine "last" for each**

Grep `firstOfInstr\s*:=` across `src/main/scala/m68k040/decode/` and `src/main/scala/m68k040/rename/` to get the authoritative, current site list (do not trust a pre-enumerated list in this plan text — it may drift). For EACH site, read its surrounding crack-construction code and its own comment (every existing `firstOfInstr` site has one explaining which uop it marks and why) to determine which uop(s) in that same crack pattern are genuinely last. Build a companion table (in your own working notes, not necessarily committed) of {site, uop count in this crack, which uop is first, which is last, any middle uops that are neither}. Known patterns already established during this task's investigation:
- Plain single-uop instruction: that one uop is both first AND last.
- memSimple-source crack (load, op): 2 uops — load=first, op=last.
- Memory-destination RMW crack (load, op, store): 3 uops — load=first, op=neither, store=last (`MicroOpAssembler.scala:1249,1320,1326`).
- MOVEM: N transfer uops + a trailing An-update uop — the LAST transfer uop is NOT last if an An-update uop follows it; the An-update uop is last (`MicroOpAssembler.scala:112-115`'s own comment already says this explicitly).
- mem-to-mem MOVE / immediate-materialize-to-mem MOVE: check `stUop.firstOfInstr := !crackMemMem && !immToMemCase` (`MicroOpAssembler.scala:1320`) for the FIRST-side logic already worked out for these cases; determine the mirror-image LAST logic (is the store always last in these forms, or can an auto-update uop trail it too?).

Do this investigation for real, per-site — do not guess or bulk-assume a pattern holds everywhere just because it held for the 2 examples above.

- [ ] **Step 3: Add the field to `DecodedUop`/`RenamedUop`, thread through `RenameStage`, set at every crack site**

Mirror `firstOfInstr`'s exact declaration/threading shape at each of the 3 layers. Default value at declaration should make an UNCRACKED (single-uop) instruction correct with the LEAST code change — check what `firstOfInstr`'s own default/general-case assignment convention is (its doc comment at `DecodedUop.scala:591-593` says "Default True for every single-uop instruction" — determine whether that's a literal Scala default or set explicitly at a general assignment site, and mirror whichever it is for `lastOfInstr`, which should default True the same way for the identical reason).

- [ ] **Step 4: `RobPlugin.scala` — add `RobPayload.last`, wire `payloadFrom`, derive `h0IsMacroLast`**

```scala
// in RobPayload, alongside `val first = Bool()`:
val last = Bool()

// in payloadFrom, alongside `p.first := u.firstOfInstr`:
p.last := u.lastOfInstr
```

```scala
// ── Macro-boundary detection for debug stop (Stage 2) ───────────────────────
// "Is the entry retiring at h0 THIS cycle the LAST uop of its macro?" -- spec
// section 6.2's macroLast, now a real alloc-time-captured per-entry fact
// (RobPayload.last, threaded from DecodedUop/RenamedUop.lastOfInstr through
// every MicroOpAssembler/Microcode crack site -- see this task's own revision
// history for why the earlier ring-occupancy-derived shortcut was wrong).
val h0IsMacroLast = p0.last
h0IsMacroLast.simPublic()
```

Place this in `RobPlugin.scala` at the same location the original Task 4 text specified (near `p0`/`p1`'s own definitions, or near `h0TraceArmed` if it needs to be forward-declared for the same reason — re-evaluate whether forward-declaration is still needed now that this is a trivial `p0.last` read with no `count`/`p1` dependency; it very likely does NOT need forward declaration anymore, since `p0` is already in scope wherever this is placed).

- [ ] **Step 5: Directed tests — matches real MicroOpAssembler crack shapes, PLUS the specific counterexample that invalidated the original approach**

```scala
test("h0IsMacroLast is True on the trailing uop of a real cracked MOVEM, False on its leading uops") {
  // Same as originally specified: real MOVEM.L D0-D2,-(A7) (or the actual real
  // decode path for it), retire single-wide across N cycles, assert
  // h0IsMacroLast reads False on every uop except the true last one (the
  // An-update uop if MOVEM emits one, per Step 2's investigation -- not
  // necessarily the last DATA transfer uop).
}
test("h0IsMacroLast is True for every single-uop macro") {
  // Single NOP-shaped uop. Assert h0IsMacroLast == True.
}
test("h0IsMacroLast is False on OP mid-crack even when STORE has not yet been allocated -- the exact counterexample that invalidated the original derivation") {
  // Reproduce the RMW scenario directly: allocate LOAD (first=True,last=False)
  // and OP (first=False,last=False) in one 2-wide dispatch cycle; complete and
  // retire LOAD alone (single-wide) so the ROB reaches count==1 with h0=OP;
  // DO NOT allocate STORE yet. Assert h0IsMacroLast == False at this point --
  // this is the exact scenario where the ORIGINAL (count<=1)||p1.first
  // derivation incorrectly read True. Then allocate+complete+retire STORE
  // (first=False,last=True) and assert h0IsMacroLast == True on ITS retiring
  // cycle.
}
```

- [ ] **Step 6: Compile + full lock-step regression + a broader ported-corpus sanity pass**

This task touches decode-side bundles consumed by every instruction in the machine, unlike the ROB-only plumbing of Tasks 1-3 — run a wider check than the other tasks' bare lock-step gate:

```
~/sbt/bin/sbt compile
~/sbt/bin/sbt "testOnly m68k040.rob.RobPluginSpec"
~/sbt/bin/sbt "testOnly m68k040.lockstep.ExecuteLockStepSpec"   # expect 399/400, exactly the CMP2.W indexed-bounds-pointer failure -- h0IsMacroLast/RobPayload.last are unused by anything outside this task's own tests, so this should be a behavioral no-op, but VERIFY given the wide blast radius of the DecodedUop/RenamedUop change
```

If any DIFFERENT lock-step test starts failing, that is a real regression in the new field's threading (a crack site got the wrong "last" value, or a site was missed and defaults wrong) — do not treat it as unrelated flakiness.

- [ ] **Step 7: Commit**

```bash
git add src/main/scala/m68k040/decode/DecodedUop.scala src/main/scala/m68k040/rename/RenamedUop.scala src/main/scala/m68k040/rename/RenameStage.scala src/main/scala/m68k040/decode/MicroOpAssembler.scala src/main/scala/m68k040/decode/Microcode.scala src/main/scala/m68k040/rob/RobPlugin.scala src/test/scala/m68k040/rob/RobPluginSpec.scala
git commit -m "decode+rename+rob: thread real lastOfInstr field for macro-boundary detection (Stage 2 task 4, revised)

Original ring-occupancy-derived h0IsMacroLast = (count<=1)||p1.first was
proven wrong: MicroOpQueue pops at most 2 uops/cycle and DispatchPlugin
gates 2-wide dispatch on ROB/IQ backpressure, so a 3+-uop crack (e.g. a
memory-destination RMW: load/op/store) can reach count==1 with h0 =
a MIDDLE uop, mid-macro, before its true last uop is even allocated --
a debug stop at that instant would silently drop the store. Threads a
real lastOfInstr field through the same DecodedUop/RenamedUop/RobPayload
path firstOfInstr already uses, set per-crack-site at decode time."
```

---

## Task 5: The halt state machine — service-owned `debugStopRequest`/`debugResumeRequest`, `RUNNING`/`STOP_PENDING`/`RECOVER`/`HALTED`

**Files:**
- Modify: `src/main/scala/m68k040/rob/RobPlugin.scala`
- Modify: `src/main/scala/m68k040/services/Services.scala` (finalize `DebugCommitService`'s command-side shape)
- Test: `src/test/scala/m68k040/rob/RobPluginSpec.scala`

**Interfaces:**
- Consumes: `h0IsMacroLast` (Task 4), `headReady`/`doFlushReg`/`flushPcReg`/`coreHalted` (existing).
- Produces: `_debugEffectiveHalt` now real; `headReady` gains a debug-halt term; `doFlushReg`/`flushPcReg` gain a RECOVER-to-restart-PC arm; a ROB-local input pair `debugStopRequestIn: Bool` / `debugResumeRequestIn: Bool` driven only by `DebugCommitService.request` (same `allowOverride` + idle-default convention as `coreHaltedIn`).

`DebugCommitService.request(stop, resume)` is the public command boundary. The two
idle-default wires above are its ROB-local implementation detail and remain public only
for standalone simulation pokes; Task 6 must call the service method and must not reach
into `RobPlugin.logic` from another plugin.

- [ ] **Step 1: Add the service-driven ROB-local command inputs**

Alongside `coreHaltedIn` (`RobPlugin.scala:384-398`), same pattern:

```scala
// ── Debug stop/resume request (Stage 2, driven by DebugCommitService.request in
// Task 6). allowOverride + idle-False default so RobPlugin
// elaborates standalone (no DebugCtrlPlugin instantiated, or enable=false) with
// this permanently False, matching coreHaltedIn's own convention exactly.
val debugStopRequestIn = Bool(); debugStopRequestIn.allowOverride; debugStopRequestIn := False
debugStopRequestIn.simPublic()
val debugResumeRequestIn = Bool(); debugResumeRequestIn.allowOverride; debugResumeRequestIn := False
debugResumeRequestIn.simPublic()
```

- [ ] **Step 2: The state machine**

Add a small SpinalEnum near the top of `logic` (or as a top-level object in this file, matching `HaltReason`'s own placement style):

```scala
object DebugHaltState extends SpinalEnum {
  val RUNNING, STOP_PENDING, RECOVER, HALTED = newElement()
}
```

State register and transition logic, placed AFTER `h0IsMacroLast` (Task 4) and AFTER `retire0`/`retire1`/`headReady` are all in scope, BEFORE the `doFlushReg`/head-advance block (so this task's own `when` arms on `doFlushReg` land at the SAME elaboration position as the existing `branchRedirect`/`exc.redirectValid` arms — "last assignment wins" ordering matters here exactly as documented for `DebugCtrlPlugin`'s own `cpuRstEvent` block):

```scala
// ── Debug halt state machine (Stage 2, spec section 6.1) ────────────────────
val debugHaltState = Reg(DebugHaltState()) init DebugHaltState.RUNNING
debugHaltState.simPublic()
val debugStopBoundaryHit = headReady && retire0 && h0IsMacroLast
// STOP_PENDING -> RECOVER the cycle the CURRENTLY-retiring macro finishes (its
// LAST uop retires); RUNNING -> STOP_PENDING the cycle a stop is requested.
// Ordinary manual/halt-after stops are post-commit: the macro occupying the commit
// head when the request is sampled is allowed to finish in full, whether it is fresh
// or already partially retired. No following macro may retire. Break/watch hits use
// the separate pre-effect rule from spec section 6.7.
// Fault/interrupt/RTE/serializing-system macros do not produce normal retire0.
// Their boundary is the exception/system sequencer's completed redirect pulse;
// STOP_PENDING must recognize it and save that redirect PC rather than deadlocking
// with frontend admission already quiesced.
val restartPcCapture = UInt(32 bits)
restartPcCapture := p0.predNextPc   // the macro AFTER the one that just finished
switch(debugHaltState) {
  is(DebugHaltState.RUNNING) {
    when(debugStopRequestIn) {
      debugHaltState := Mux(debugStopBoundaryHit, DebugHaltState.RECOVER,
                            DebugHaltState.STOP_PENDING)
    }
  }
  is(DebugHaltState.STOP_PENDING) {
    when(debugStopBoundaryHit) { debugHaltState := DebugHaltState.RECOVER }
  }
  is(DebugHaltState.RECOVER) {
    // One cycle: the flush/redirect pulse (below) fires THIS cycle; by next
    // cycle speculative state has been rolled back (same latency every other
    // doFlushReg consumer already assumes -- BackendWiringPlugin's fan-out is
    // a single registered pulse, not a multi-cycle handshake).
    debugHaltState := DebugHaltState.HALTED
  }
  is(DebugHaltState.HALTED) {
    when(debugResumeRequestIn) { debugHaltState := DebugHaltState.RUNNING }
  }
}
val debugHalted = debugHaltState === DebugHaltState.HALTED
_debugEffectiveHalt := debugHalted
```

Drive `FrontendQuiesceService.active/next` from every non-RUNNING debug state in
this task as well. `next` must assert on the stop-sampling edge and deassert on the
resume edge, preserving FetchAlign's localized-register timing. This is part of the
effective-halt contract: JTAG-visible `HALTED` promises no new frontend admission,
not merely a blocked ROB retire port.

- [ ] **Step 3: Gate retire on `STOP_PENDING`/`HALTED`, suppress the boundary macro itself, extend `headReady`**

`headReady` (existing, `RobPlugin.scala:622`) becomes:

```scala
val headReady = (count > 0) && completes(h0) && !flushing && !coreHalted &&
  !(debugHaltState === DebugHaltState.HALTED)
```

Do NOT add `STOP_PENDING` to this gate — `STOP_PENDING` must still let the in-flight macro finish retiring (spec 6.1: "finish any already-partially-retired cracked macro"); only `HALTED` blocks retire outright. The actual "stop BEFORE the next macro" enforcement is `debugStopBoundaryHit`'s own transition into `RECOVER` (which flushes and redirects BEFORE the next macro's first uop can be dispatched/allocated — Task 7 makes RECOVER's flush pulse suppress frontend admission via the EXISTING `_frontendQuiesceActive` wire, not a new gate here).

Retire-1 suppression across the boundary (spec 6.2 "Retire slot 1 is suppressed whenever it belongs to a different macro than slot 0 and a stop/step boundary is being taken" and "the remaining uops of that macro may complete/retire, but the next macro must not start"): extend `retire1`'s existing guard (`RobPlugin.scala:787-789`, per the explore pass's verbatim capture) with one more conjunct:

```scala
val retire1 = retire0 && (count > 1) && completes(h1) && !p0.retireAlone && !p1.retireAlone &&
  !faultedStore(h1) && !p1.isRte && !p1.needsSup && !p1.sysOp && !h0TraceArmed &&
  !h0PreciseCompletedSticky && sysAuxRdy1 &&
  !((debugStopRequestIn || debugHaltState === DebugHaltState.STOP_PENDING) &&
    h0IsMacroLast)                         // NEW: don't let h1 (a DIFFERENT macro,
                                           // since h0IsMacroLast means h0 is its
                                           // macro's last uop) start while a stop
                                           // is pending and h0 is about to close
                                           // the boundary the stop is waiting for.
```

- [ ] **Step 4: Extend `doFlushReg`/`flushPcReg` with the RECOVER arm**

Locate the existing driving site (explore pass: `RobPlugin.scala:1592-1594`, `doFlushReg := branchRedirect || exc.redirectValid`). Add a third disjunct, elaborated in the SAME `when` block (this file's own documented "last assignment wins" discipline — place this arm so it does not silently lose priority to the other two on a same-cycle coincidence; since a debug stop boundary and a mispredict/exception redirect firing on the EXACT same cycle is a real, if rare, possibility, decide priority explicitly rather than by accidental elaboration order — recommended: exception/mispredict redirect wins, since spec 6.1's RECOVER is itself just "the next unexecuted macro's PC", and if an exception is ALSO redirecting this cycle, the debug stop should re-observe the exception's own landing PC on ITS next boundary rather than racing it):

```scala
val debugRecoverEnter = debugStopBoundaryHit
doFlushReg := branchRedirect || exc.redirectValid || debugRecoverEnter
when(branchRedirect)        { flushPcReg := nextPcRd0 }
when(exc.redirectValid)     { flushPcReg := exc.redirectPc }
when(debugRecoverEnter && !branchRedirect && !exc.redirectValid) { flushPcReg := restartPcCapture }
```

(The final `when` deliberately excludes the `branchRedirect` case too — if `debugRecoverEnter` and `branchRedirect` land on the identical head the identical cycle, `restartPcCapture` (`p0.predNextPc`) and `nextPcRd0` are very likely the SAME value already, since both derive from the same retiring head's predicted-next-PC; but do not assume this without checking — if `RobPluginSpec` reveals they can differ, add an explicit priority note rather than silently trusting equality.)

- [ ] **Step 5: `_debugLivePc` becomes the real restart PC while halted**

Task 2's placeholder (`_debugLivePc := p0.pc`) is wrong once halted — while `HALTED`, `p0` is whatever NEW head the flush landed the ROB on (likely `count == 0`, so `p0.pc` is stale/undefined per this file's own SAFETY discipline). Replace with:

```scala
val debugLivePcReg = Reg(UInt(32 bits)) init 0
when(debugRecoverEnter) {
  debugLivePcReg := Mux(exc.redirectValid, exc.redirectPc,
                    Mux(branchRedirect, nextPcRd0, restartPcCapture))
}
_debugLivePc := debugLivePcReg
```

- [ ] **Step 6: Directed tests**

```scala
test("stop request during a single-uop macro halts after exactly that macro, HALTED asserts effectiveHalt") {}
test("stop request during a 3-uop cracked macro (MOVEM-shaped) lets all 3 uops retire, then halts before the NEXT macro") {}
test("stop request sampled on a fresh macro commits that whole macro, then halts before its successor") {}
test("resume clears HALTED, retire resumes, debugLivePc matches the macro that actually executes next") {}
test("headReady/retire0/retire1 never fire while debugHaltState==HALTED, across 1000 cycles with completes(h0)/(h1) forced True") {}
test("repeated halt/continue (10 cycles) leaves the ROB in a consistent state each time, no stuck STOP_PENDING") {}
```

- [ ] **Step 7: Compile + full lock-step + directed regression**

```
~/sbt/bin/sbt compile
~/sbt/bin/sbt "testOnly m68k040.rob.RobPluginSpec"
~/sbt/bin/sbt "testOnly m68k040.lockstep.ExecuteLockStepSpec"   # expect 399/400 -- debugStopRequestIn defaults False so this task is a behavioral no-op for every existing test
```

- [ ] **Step 8: Commit**

```bash
git add src/main/scala/m68k040/rob/RobPlugin.scala src/main/scala/m68k040/services/Services.scala src/test/scala/m68k040/rob/RobPluginSpec.scala
git commit -m "rob: debug halt state machine RUNNING/STOP_PENDING/RECOVER/HALTED (Stage 2 task 5)"
```

---

## Task 6: Wire `DebugCtrlPlugin`'s `OFF_CONTROL` bit 0 (manual halt) through `DebugCommitService`

**Files:**
- Modify: `src/main/scala/m68k040/debug/DebugCtrlPlugin.scala`
- Modify: `src/main/scala/m68k040/rob/RobPlugin.scala` (empty-ROB stop boundary/live-PC correctness)
- Modify: `src/test/scala/m68k040/debug/DebugCtrlDut.scala`
- Modify: `src/test/scala/m68k040/debug/DebugCtrlCsrSpec.scala`
- Test: `src/test/scala/m68k040/debug/DebugCtrlRobIntegrationSpec.scala`

**Interfaces:**
- Consumes: Task 5's `DebugCommitService`, including `effectiveHalt` readback and
  `request(stop, resume)`. The ROB-local request wires are not a cross-plugin API.
- Produces: `OFF_CONTROL` bit 0 is real (no longer RAZ/WI); a write with bit 0 set requests stop, an accepted write with bit 0 clear requests resume (spec §6.4, verbatim — implement exactly this, not a toggle).

- [ ] **Step 1: `DebugCtrlPlugin` — make `OFF_CONTROL` bit 0 real**

In the `controlWord`/write-decode logic (inside the Task-1 `if (enable)` block), replace the Stage-1 placeholder:

```scala
// was: False ##  // bit 0  manual halt request  -- RAZ/WI until Stage 2
manualHaltLevel ##  // bit 0  manual halt request (Stage 2: real)
```

Add the level register and registered request/resume commands. Commands are decoded from
every accepted byte-0 write, not from level edges: writing zero must issue resume even when
the readback level was already zero, because it also resumes an automatic halt.

```scala
val manualHaltLevel   = RegInit(False)
val debugStopRequest  = RegInit(False)
val debugResumeRequest = RegInit(False)
debugStopRequest := False
debugResumeRequest := False
when(controlWriteAccepted && byteStrobe(0)) {
  manualHaltLevel := controlWriteData(0)
  debugStopRequest := controlWriteData(0)
  debugResumeRequest := !controlWriteData(0)
}
```

Pass the commands through the service boundary from inside `DebugCtrlPlugin`; do not add
cross-plugin IO and do not reach into `RobPlugin` internals:

```scala
dbgCommit.foreach(_.request(debugStopRequest, debugResumeRequest))
```

- [ ] **Step 2: resolve the optional service in `DebugCtrlPlugin`**

Resolve `DebugCommitService` only when debug is enabled and Stage 2 is selected. An absent
service preserves the Stage-1 RAZ/WI behavior and permits the standalone CSR DUT:

```scala
val dbgCommit = if (enable && stage >= 2) host.get[DebugCommitService] else None
```

- [ ] **Step 3: `OFF_STATUS` bits 0/4 become real**

```scala
// was: False ## // bit 4 auto-halt latched (Stage 2)
// was: True  ## // bit 3 running -- always, there is no halt yet
// was: False ## // bit 0 halted (Stage 2)
val dbgCommit = host.get[m68k040.services.DebugCommitService]
val effHalt   = dbgCommit.map(_.effectiveHalt).getOrElse(False)
val autoHalt  = dbgCommit.map(_.autoHaltLatched).getOrElse(False)
// ...
rData := B(0, 27 bits) ##
         autoHalt ##             // bit 4  auto-halt latched
         !effHalt ##             // bit 3  running (mutually exclusive with halted, spec 3.3)
         initDoneLatched ##      // bit 2  init-done seen
         False ##                // bit 1  exception pending (Stage 2 does not implement this bit; stays 0)
         effHalt                 // bit 0  halted
```

(Resolve `host.get[DebugCommitService]` the SAME way `MmuControlPlugin`'s Handle-blocking pattern does — via the `logic` `Handle`, not a raw eager call in the constructor — matching this plugin's own existing `host.get[InterruptControlService]`-shaped precedent already used elsewhere in this codebase if `DebugCtrlPlugin` itself already resolves any optional service this way; if it does not yet, this is the first one it adds and must follow `RobPlugin`'s OWN `intCtrl` pattern at `RobPlugin.scala:151-158` — a `host.get[...]` with a `None` fallback to inert defaults — exactly, since that is the established convention for an OPTIONAL cross-plugin dependency in this codebase, as distinct from the setup-allocated-wire pattern which is for breaking a Fiber CYCLE, not for optionality.)

- [ ] **Step 4: `OFF_PC`/`OFF_LAST_PC` wired real**

```scala
is(DebugRegMap.OFF_PC)      { rData := dbgCommit.map(_.livePc).getOrElse(U(0,32 bits)).asBits }
is(DebugRegMap.OFF_LAST_PC) { rData := dbgCommit.map(_.lastPc).getOrElse(U(0,32 bits)).asBits }
```

- [ ] **Step 5: Bump the shipped `stage` default from 1 to 2**

At `FullCoreSynth.scala:580`, change `stage = 1` to `stage = 2` ONLY once Tasks 6-11 (this task through the assertions task) are all landed and gated — do NOT do this in Task 6 itself; leave `stage = 1` for now and flag it as this plan's Task 12's own Step 1 (features 22/23 must not be advertised before the halt-after/step machinery they imply is actually done — spec §3.4's honesty rule, restated).

- [ ] **Step 6: Directed test — halt via `dbg_axi` actually stops retirement, end to end**

```scala
test("writing OFF_CONTROL bit 0 = 1 through dbg_axi halts the full core at the next macro boundary; OFF_STATUS bit 0 reads 1; clearing bit 0 resumes") {
  // Full-core-shaped DUT (whatever harness Step 6's file-location decision above
  // settled on). Run a short real program (e.g. a tight NOP/ADD loop from the
  // existing ported-corpus asm fixtures) via dbg_axi's own AW/W/AR/R protocol
  // (mirror the AXI4-Lite driver already used by DebugCtrlPluginSpec's Stage-1
  // tests), issue a CONTROL write with bit 0 set mid-loop, poll OFF_STATUS until
  // bit 0 (halted) reads 1, assert retirement genuinely stopped (macroCount via
  // OFF_INST_LO stays constant across N further cycles), read OFF_PC and confirm
  // it is a PLAUSIBLE loop-body address (not 0, not garbage), then clear bit 0
  // and confirm macroCount resumes incrementing.
}
```

- [ ] **Step 7: Compile + full lock-step regression + full ported-corpus spot check**

```
~/sbt/bin/sbt compile
~/sbt/bin/sbt "testOnly m68k040.debug.DebugCtrlPluginSpec"
~/sbt/bin/sbt "testOnly m68k040.lockstep.ExecuteLockStepSpec"   # expect 399/400
```

- [ ] **Step 8: Commit**

```bash
git add src/main/scala/m68k040/debug/DebugCtrlPlugin.scala src/main/scala/m68k040/top/FullCoreSynth.scala
git commit -m "debug: wire OFF_CONTROL bit 0 manual halt/resume end-to-end (Stage 2 task 6)"
```

---

## Task 7: `OFF_HALT_AFTER_LO/HI` — halt after N macro-instructions

**Files:**
- Modify: `src/main/scala/m68k040/debug/DebugCtrlPlugin.scala`
- Modify: `src/main/scala/m68k040/rob/RobPlugin.scala`
- Modify: `src/main/scala/m68k040/services/Services.scala`
- Modify: `tools/debug/debug_regmap.def` and the design spec (bit-0 arm semantics)
- Test: `src/test/scala/m68k040/rob/RobPluginSpec.scala`, `src/test/scala/m68k040/debug/DebugCtrlCsrSpec.scala`, `src/test/scala/m68k040/debug/DebugCtrlRobIntegrationSpec.scala`

**Interfaces:**
- Consumes: Task 3's `debugMacroCountReg`, Task 5's halt FSM.
- Produces: target writes advance an epoch and disarm; `OFF_HALT_CTL` bit 0 arms and reads the armed state. A registered comparator stops after the exact completed-macro target, consumes the arm, and cannot fire from a superseded epoch.

- [ ] **Step 1: Read spec §6.6 again** (lines 497-506) — "Count comparison may be pipelined; a pending result must carry the count/epoch so it cannot stop on a stale target after host reprogramming." This is the one subtlety in this task: a target write must invalidate any in-flight comparison from a STALE target.

- [ ] **Step 2: `DebugCtrlPlugin` — target registers + epoch**

```scala
val haltAfterTarget = Reg(UInt(64 bits)) init 0; haltAfterTarget.simPublic()
val haltAfterEpoch   = Reg(UInt(8 bits))  init 0; haltAfterEpoch.simPublic()   // bumped on every target write
val haltAfterArmed   = RegInit(False);            haltAfterArmed.simPublic()
// write decode, alongside OFF_RAM_WINDOW_LG2/OFF_MON_SENSE:
is(DebugRegMap.OFF_HALT_AFTER_LO) {
  haltAfterTarget(31 downto 0) := merged(haltAfterTarget(31 downto 0).asBits).asUInt
  haltAfterEpoch := haltAfterEpoch + 1
  haltAfterArmed := False   // a target write disarms until HALT_CTL re-arms it explicitly
}
is(DebugRegMap.OFF_HALT_AFTER_HI) {
  haltAfterTarget(63 downto 32) := merged(haltAfterTarget(63 downto 32).asBits).asUInt
  haltAfterEpoch := haltAfterEpoch + 1
  haltAfterArmed := False
}
is(DebugRegMap.OFF_HALT_CTL) {
  when(wStrb(0)) {
    when(wData(0)) { haltAfterArmed := True }
    // bit 2 (clear sticky latches) -- Task 9 implements this; leave a TODO comment
    // pointing at Task 9 rather than a silent no-op if wData(2) is set here and
    // nothing consumes it yet -- add the field now, drive it False, Task 9 wires it.
  }
}
```

Read `OFF_HALT_AFTER_LO/HI` back from `haltAfterTarget`'s two halves (mirror the existing `is(DebugRegMap.OFF_RAM_WINDOW_LG2)`-shaped read arms).

- [ ] **Step 3: Extend `DebugCommitService` with target+epoch+armed**

Add a focused configuration method so these
values cross the public service boundary without sibling IO. `DebugCtrlPlugin` calls it
with the three CSR-held values; `RobPlugin` assigns only its ROB-local inputs:

```scala
def configureHaltAfter(target: UInt, epoch: UInt, armed: Bool, invalidate: Bool): Unit
dbgCommit.foreach(_.configureHaltAfter(haltAfterTarget, haltAfterEpoch,
  haltAfterArmed, haltAfterInvalidate))
```

`invalidate` is combinational from the accepted, non-zero-strobe target write. This is
intentional: it cancels an old registered result on the same edge that reprograms the
debug-domain target and epoch.

- [ ] **Step 4: `RobPlugin` — the comparator**

```scala
val haltAfterTargetIn = UInt(64 bits); haltAfterTargetIn.allowOverride; haltAfterTargetIn := U(0, 64 bits)
val haltAfterEpochIn  = UInt(8 bits);  haltAfterEpochIn.allowOverride;  haltAfterEpochIn  := U(0, 8 bits)
val haltAfterArmedIn  = Bool();        haltAfterArmedIn.allowOverride;  haltAfterArmedIn  := False
haltAfterTargetIn.simPublic(); haltAfterEpochIn.simPublic(); haltAfterArmedIn.simPublic()

// Register count/epoch/armed and the wide comparison. After each last-uop retirement,
// assert a one-cycle compare-pending hold before admitting the following macro. While
// armed, suppress dual-retire crossing when h0 is macro-last. The halt event is valid
// only when the registered epoch still equals the live epoch and invalidate is low.
// This keeps the 64-bit >= comparator off the commit hot path while guaranteeing that
// target macro N is wholly committed and macro N+1 remains untouched.
```

(Flag the last comment's uncertainty explicitly to the implementer — this is exactly the kind of thing the task reviewer should double-check by actually compiling it, not by trusting the plan's prose.)

- [ ] **Step 5: Directed tests**

```scala
test("halt-after fires exactly at the target macro count, not before, not one late") {}
test("a superseded in-flight result cannot fire; a deliberately re-armed lower target can") {}
test("halt-after target write while a comparison is in flight does not fire against the old target") {}
```

- [ ] **Step 6: Compile + regression**

```
~/sbt/bin/sbt compile
~/sbt/bin/sbt "testOnly m68k040.rob.RobPluginSpec"
~/sbt/bin/sbt "testOnly m68k040.debug.DebugCtrlPluginSpec"
~/sbt/bin/sbt "testOnly m68k040.lockstep.ExecuteLockStepSpec"   # expect 399/400
```

- [ ] **Step 7: Commit**

```bash
git add src/main/scala/m68k040/debug/DebugCtrlPlugin.scala src/main/scala/m68k040/rob/RobPlugin.scala src/main/scala/m68k040/top/FullCoreSynth.scala src/test/scala/m68k040/rob/RobPluginSpec.scala src/test/scala/m68k040/debug/DebugCtrlPluginSpec.scala
git commit -m "debug+rob: OFF_HALT_AFTER_LO/HI epoch-tagged halt-after (Stage 2 task 7)"
```

---

## Task 8: Single-step (`OFF_CONTROL` bit 1)

**Files:**
- Modify: `src/main/scala/m68k040/rob/RobPlugin.scala`
- Modify: `src/main/scala/m68k040/debug/DebugCtrlPlugin.scala`
- Test: `src/test/scala/m68k040/rob/RobPluginSpec.scala`

**Interfaces:**
- Consumes: Task 5's `HALTED` state, Task 4's `h0IsMacroLast`.
- Produces: a `STEP_RUNNING` state added to `DebugHaltState`; `OFF_CONTROL` bit 1 real.

- [ ] **Step 1: Read spec §6.5 again** (lines 483-495) — "Step starts only from effective halt... allows exactly one macro-instruction to complete... does not use a retired-uop counter." Reject (spec: "sticky rejected status") if not halted.

- [ ] **Step 2: Extend the enum and FSM**

```scala
object DebugHaltState extends SpinalEnum {
  val RUNNING, STOP_PENDING, RECOVER, HALTED, STEP_RUNNING = newElement()
}
```

```scala
val debugStepRequestIn = Bool(); debugStepRequestIn.allowOverride; debugStepRequestIn := False
debugStepRequestIn.simPublic()
val debugStepRejected = RegInit(False); debugStepRejected.simPublic()   // sticky, spec 6.5

// in the switch:
is(DebugHaltState.HALTED) {
  when(debugResumeRequestIn) { debugHaltState := DebugHaltState.RUNNING }
  .elsewhen(debugStepRequestIn) {
    debugHaltState := DebugHaltState.STEP_RUNNING
    debugStepRejected := False
  }
}
is(DebugHaltState.STEP_RUNNING) {
  // Exactly one macro: the FIRST macro to retire while in this state closes the
  // boundary immediately (h0IsMacroLast on ITS OWN first-retiring uop, not
  // waiting for a SEPARATE later macro) -- reuse debugStopBoundaryHit's shape but
  // scoped to THIS state so a plain STOP_PENDING boundary and a STEP boundary
  // never conflate.
  when(headReady && retire0 && h0IsMacroLast) { debugHaltState := DebugHaltState.RECOVER }
}
// Reject if step requested while not HALTED:
when(debugStepRequestIn && (debugHaltState =/= DebugHaltState.HALTED)) { debugStepRejected := True }
```

`headReady`'s existing gate already allows retirement to proceed normally in `STEP_RUNNING` (it only blocks on `HALTED`) — but `retire1` must be suppressed ENTIRELY while stepping (spec: "block a second macro in the same dual-retire cycle" — stronger than the plain stop-boundary case, which only blocks h1 if it's a DIFFERENT macro; single-step blocks h1 unconditionally once h0 alone would already close the step). Extend `retire1`'s guard again:

```scala
val retire1 = /* ...Task 5's version... */ &&
  !(debugStopRequestIn && h0IsMacroLast) &&
  !(debugHaltState === DebugHaltState.STEP_RUNNING)   // NEW: step never dual-retires, full stop
```

`RECOVER`'s existing transition to `HALTED` (Task 5) is unconditionally reused — a step's RECOVER is observationally identical to a stop's RECOVER (both just mean "roll back speculative state, land on the restart PC"), so no new RECOVER arm is needed, only a way for `OFF_HALT_REASON` (Task 9) to remember it was a STEP that caused this particular HALTED entry, not a manual stop.

- [ ] **Step 3: `DebugCtrlPlugin` — bit 1 real, bit 7 (step-arm observation) still RAZ/WI or real**

```scala
// was: False ## // bit 1 single-step pulse -- RAZ/WI until Stage 2
stepPulse ##  // bit 1 single-step pulse (Stage 2: real, self-clearing like coldPulse)
```

```scala
val stepPulse = RegInit(False); stepPulse.simPublic()
stepPulse := False   // self-clearing default, same convention as coldPulse
// in write decode:
when(m(1)) { stepPulse := True }
// Extend DebugCommitService.request with a step command (or add requestStep) and pass
// stepPulse through that service. Do not expose a DebugCtrlPlugin sibling output.
```

Bit 7 (legacy step-arm OBSERVATION) — check spec §3.3's exact bit-7 semantics before deciding whether Stage 2 needs to implement it or can leave it RAZ/WI; the spec text this plan already read (§15.2) marks it "RAZ/WI (Stage 2)" ambiguously (the parenthetical could mean "implemented in Stage 2" OR "still RAZ/WI as of Stage 2, deferred further" — re-read spec §3.3's own bit-7 description, not just §15.2's table, to resolve this before writing Step 3's code; if genuinely ambiguous even after re-reading, leave bit 7 RAZ/WI and note the deferral explicitly in the commit message rather than guessing).

- [ ] **Step 4: Directed tests**

```scala
test("single-step from HALTED executes exactly one macro (single-uop) then re-halts") {}
test("single-step from HALTED executes exactly one CRACKED macro (all its uops) then re-halts, never partway") {}
test("single-step while RUNNING (not halted) is rejected, sticky rejected status set, core does not step or halt") {}
test("single-step never dual-retires across the step boundary even when h1 could otherwise complete the same cycle") {}
```

- [ ] **Step 5: Compile + regression**

```
~/sbt/bin/sbt compile
~/sbt/bin/sbt "testOnly m68k040.rob.RobPluginSpec"
~/sbt/bin/sbt "testOnly m68k040.debug.DebugCtrlPluginSpec"
~/sbt/bin/sbt "testOnly m68k040.lockstep.ExecuteLockStepSpec"   # expect 399/400
```

- [ ] **Step 6: Commit**

```bash
git add src/main/scala/m68k040/rob/RobPlugin.scala src/main/scala/m68k040/debug/DebugCtrlPlugin.scala src/test/scala/m68k040/rob/RobPluginSpec.scala
git commit -m "rob+debug: single-step OFF_CONTROL bit 1, STEP_RUNNING state (Stage 2 task 8)"
```

---

## Task 9: `OFF_HALT_REASON` + fatal-halt distinctness + resume rejection

**Files:**
- Modify: `src/main/scala/m68k040/rob/RobPlugin.scala`
- Modify: `src/main/scala/m68k040/debug/DebugCtrlPlugin.scala`
- Test: `src/test/scala/m68k040/rob/RobPluginSpec.scala`

**Interfaces:**
- Consumes: `coreHalted` (existing fatal mechanism), Task 5/8's `debugHaltState`.
- Produces: `_debugHaltReason` real (NONE=0, MANUAL=1, STEP=2, HALT_AFTER=3, FATAL=4 — a NEW, small, debug-ctrl-local encoding, distinct from `HaltReason.scala`'s own `W=3` fatal-cause codes, which stay exactly as they are: `HaltReason` answers "which SUBSYSTEM fatally halted", this new field answers "was this a debug stop, a step, a halt-after, or a fatal halt" at the OFF_HALT_REASON register level); resume rejected while `coreHalted`.

- [ ] **Step 1: Read spec §6.3's last paragraph again** ("Fatal coreHalted/double-fault state also sets effective halt, but it is non-resumable and has a distinct reason. A resume request is explicitly rejected until CPU reset.") and §13's "a resume request cannot release a fatal halt or an apply/cache BUSY state" — this task's whole job is making both literally true.

- [ ] **Step 2: `_debugEffectiveHalt` includes `coreHalted`**

Task 5's Step 2 defined `_debugEffectiveHalt := debugHalted` (i.e. only the debug FSM's own `HALTED` state). Fix:

```scala
_debugEffectiveHalt := debugHalted || coreHalted
```

- [ ] **Step 3: Track WHY, latch first-wins like `coreHalted`/`haltReason` already do**

```scala
object DebugHaltReasonCode {
  val NONE = 0; val MANUAL = 1; val STEP = 2; val HALT_AFTER = 3; val FATAL = 4
}
val debugHaltReasonReg = Reg(UInt(3 bits)) init 0; debugHaltReasonReg.simPublic()
// Captured the SAME cycle debugRecoverEnter fires (Task 5), mirroring haltReason's
// own first-wins-on-the-cycle-it-becomes-true discipline -- but here "first" means
// "which of the 3 debug causes was active when RECOVER was entered", since only
// ONE of {plain stop, step, halt-after} can be the reason a given RECOVER happened
// (they are mutually exclusive states this cycle by construction: STOP_PENDING vs
// STEP_RUNNING are different debugHaltState values, and halt-after only ever SETS
// debugStopRequestIn, funneling through the SAME STOP_PENDING path -- so it needs
// its OWN tag captured separately, not inferred from debugHaltState alone).
when(coreHaltedIn && !coreHalted) {
  debugHaltReasonReg := U(DebugHaltReasonCode.FATAL, 3 bits)   // first-wins, fatal always overrides on ITS OWN entry cycle
}.elsewhen(debugRecoverEnter) {
  debugHaltReasonReg := Mux(debugHaltState === DebugHaltState.STEP_RUNNING, U(DebugHaltReasonCode.STEP, 3 bits),
                        Mux(haltAfterHit,                                   U(DebugHaltReasonCode.HALT_AFTER, 3 bits),
                                                                             U(DebugHaltReasonCode.MANUAL, 3 bits)))
}
_debugHaltReason := Mux(coreHalted, U(DebugHaltReasonCode.FATAL, 3 bits), debugHaltReasonReg)
```

- [ ] **Step 4: Resume rejection while fatally halted**

Task 5's `HALTED` arm (`when(debugResumeRequestIn) { debugHaltState := DebugHaltState.RUNNING }`) must not fire while `coreHalted`:

```scala
is(DebugHaltState.HALTED) {
  when(debugResumeRequestIn && !coreHalted) { debugHaltState := DebugHaltState.RUNNING }
  .elsewhen(debugStepRequestIn && !coreHalted) { ... }
}
```

(`coreHalted` already independently blocks retire via `headReady`'s pre-existing `!coreHalted` term, so this Step is specifically about not letting the FSM's OWN state pretend to leave HALTED — without it, `debugHaltState` would flip to `RUNNING` while `coreHalted` silently keeps everything blocked anyway, which is a LATENT bug, not a live one, but still exactly what spec §13 says must not be possible: "cannot release a fatal halt" should mean the STATE says so too, not just the retire gate.)

- [ ] **Step 5: `OFF_HALT_REASON` register read**

```scala
is(DebugRegMap.OFF_HALT_REASON) {
  rData := B(0, 29 bits) ## dbgCommit.map(_.haltReasonDebug).getOrElse(U(0,3 bits)).asBits
}
```

- [ ] **Step 6: `OFF_HALT_CTL` bit 2 — clear sticky reason/report latches**

Task 7 left a TODO here. Implement it:

```scala
is(DebugRegMap.OFF_HALT_CTL) {
  when(wStrb(0)) {
    when(wData(0)) { haltAfterArmed := True }
    when(wData(2)) { /* issue a one-cycle clear-sticky command through DebugCommitService */ }
  }
}
```

Extend `DebugCommitService` with a clear-sticky command and consume it in `RobPlugin` as `haltCtlClearIn`; do not add a `DebugCtrlPlugin` output. In `RobPlugin`, `when(haltCtlClearIn) { debugHaltReasonReg := 0; debugStepRejected := False }` — but NOT while still `HALTED`/`STEP_RUNNING` with an ACTIVE (not yet acknowledged) stop, only the STICKY LATCHES per spec's own wording ("clears sticky reason/report latches" — a report of a PAST event, not the live state); confirm against spec text whether clearing while still halted is even meaningful/expected, and if the spec is silent, the safe choice is: allow the clear unconditionally (it only clears the REASON CODE display and the rejected-sticky bit, neither of which gates retire/halt behavior itself, so clearing them while halted cannot cause a live-state corruption — verify this claim against the actual consumers before shipping it, don't just assert it).

- [ ] **Step 7: Directed tests**

```scala
test("OFF_HALT_REASON reads MANUAL after a plain stop, STEP after a step, HALT_AFTER after a halt-after trigger") {}
test("fatal coreHalted sets OFF_HALT_REASON to FATAL regardless of any concurrent debug-halt state") {}
test("resume request while coreHalted is a no-op: debugHaltState stays HALTED, effectiveHalt stays True, forever") {}
test("OFF_HALT_CTL bit 2 clears the sticky reason back to NONE without disturbing an ACTIVE halt") {}
```

- [ ] **Step 8: Compile + regression**

```
~/sbt/bin/sbt compile
~/sbt/bin/sbt "testOnly m68k040.rob.RobPluginSpec"
~/sbt/bin/sbt "testOnly m68k040.debug.DebugCtrlPluginSpec"
~/sbt/bin/sbt "testOnly m68k040.lockstep.ExecuteLockStepSpec"   # expect 399/400
```

- [ ] **Step 9: Commit**

```bash
git add src/main/scala/m68k040/rob/RobPlugin.scala src/main/scala/m68k040/debug/DebugCtrlPlugin.scala src/test/scala/m68k040/rob/RobPluginSpec.scala
git commit -m "rob+debug: OFF_HALT_REASON + fatal-halt distinctness + resume rejection (Stage 2 task 9)"
```

---

## Task 10: `OFF_HALT_HIT_INST_LO/HI` + finish `OFF_STATUS` bit 1 scope decision

**Files:**
- Modify: `src/main/scala/m68k040/rob/RobPlugin.scala`, `src/main/scala/m68k040/debug/DebugCtrlPlugin.scala`
- Test: `src/test/scala/m68k040/rob/RobPluginSpec.scala`

- [ ] **Step 1: Capture `haltHitInstCount` at RECOVER**

```scala
when(debugRecoverEnter) { debugHaltHitInstCountReg := debugMacroCountReg }
_debugHaltHitInstCount := debugHaltHitInstCountReg
```

(`debugMacroCountReg`'s value the cycle RECOVER is entered — confirm it already reflects the JUST-retired boundary macro's own increment, i.e. this capture happens AFTER Task 3's `debugMacroCountReg` update for the SAME cycle, not before — check elaboration order; if `debugMacroCountReg`'s own `when` block is textually earlier in `logic` than this Task 10 addition, last-assignment-wins is irrelevant here since they write DIFFERENT registers, but READ ordering (this Task reads `debugMacroCountReg`'s NEW value, not stale) is automatic in synchronous logic as long as this read is combinational off the SAME cycle's `debugMacroCountReg` register value pre-update — i.e. this captures the PRE-increment count, not post-increment, since Regs read their OLD value combinationally within the same cycle their next value is being computed. Decide explicitly whether `haltHitInstCount` should be inclusive or exclusive of the boundary macro itself and document the choice — the spec doesn't say; a reasonable, defensible choice is "count AFTER including the macro that just retired" i.e. wire this from `_debugMacroCount`'s COMBINATIONAL next-value expression, not the stale register — implement whichever you choose and write ONE line explaining why.)

- [ ] **Step 2: Wire `OFF_HALT_HIT_INST_LO/HI`** — same two-32-bit-half read pattern as every other 64-bit register in this file (`OFF_INST_LO/HI`, Task 3).

- [ ] **Step 3: Resolve `OFF_STATUS` bit 1 (exception pending) scope**

Spec §12's Stage 2 bullet does not mention exception-pending; §6.6 mentions "Halt-on-exception uses the 256-bit deployed mask" which IS explicitly Stage 5 (`halt_exc_mask` feature bit 7, stage 5 per `debug_regmap.def`). Confirm bit 1 stays `False` (RAZ) through Stage 2 — no code change needed, just an explicit verification step and a one-line comment in `DebugCtrlPlugin.scala` at that bit's position saying "Stage 5 (halt_exc_mask)" instead of the current bare `False` with no forward-reference, so a future reader isn't left wondering why it's still zero after Stage 2 shipped.

- [ ] **Step 4: Directed test + compile + regression + commit** (same shape as every prior task).

```bash
git add -A
git commit -m "rob+debug: OFF_HALT_HIT_INST_LO/HI + OFF_STATUS bit 1 scope note (Stage 2 task 10)"
```

---

## Task 11: Required assertions (spec §13, Stage-2-applicable subset)

**Files:**
- Modify: `src/main/scala/m68k040/rob/RobPlugin.scala`

- [ ] **Step 1: Add `GenerationFlags.simulation`-gated assertions**, placed near the existing ones in this file (there is precedent: `RobPlugin` itself has no `GenerationFlags.simulation` block today per the explore pass's findings — `DebugCtrlPlugin.scala` does, at lines 382-417 and 434-441; follow THAT file's placement/`FAILURE` convention exactly since it's the more directly analogous precedent for a debug-adjacent assertion, even though it lives in a different file):

```scala
GenerationFlags.simulation {
  assert(!(_debugEffectiveHalt && (retire0 || retire1)),
    "RobPlugin: retirement occurred while DebugCommitService.effectiveHalt was True (spec section 13)",
    FAILURE)
  assert(!(debugHaltState === DebugHaltState.HALTED && (headReady)),
    "RobPlugin: headReady asserted while HALTED (spec section 13: effective halt implies no retire)",
    FAILURE)
  // "a step consumes at most one macro event and retire slot 1 never crosses its boundary"
  assert(!(debugHaltState === DebugHaltState.STEP_RUNNING && retire1),
    "RobPlugin: retire1 fired during STEP_RUNNING -- a step must never dual-retire (spec section 13)",
    FAILURE)
  // "a resume request cannot release a fatal halt"
  assert(!(coreHalted && (debugHaltState === DebugHaltState.RUNNING)),
    "RobPlugin: debugHaltState left HALTED while coreHalted -- fatal halt was released (spec section 13)",
    FAILURE)
}
```

Verify the frontend-admission half of "effective halt implies no frontend/dispatch
admission" implemented by Task 5. Do not add a second driver: Task 5 already extends
`_frontendQuiesceActive` and `_frontendQuiesceNext` across STOP_PENDING/RECOVER/HALTED
and releases them on resume with the exact next-state timing FetchAlign requires:

```scala
_frontendQuiesceActive := stopped || coreHalted || (debugHaltState =/= DebugHaltState.RUNNING)
```

(`STOP_PENDING`/`RECOVER`/`HALTED`/`STEP_RUNNING` ALL want frontend admission stopped — only `RUNNING` doesn't. `_frontendQuiesceNext` needs the analogous next-state extension; find its own driving site — the explore pass did not separately capture it, locate it now, it is almost certainly right next to `_frontendQuiesceActive`'s own drive — and extend it the same way using the FSM's NEXT-state expression, not the registered one, matching `FrontendQuiesceService`'s own documented `next`-vs-`active` distinction (`Services.scala:41-48`.)

- [ ] **Step 2: Compile + full lock-step + full ported-corpus regression**

This task changes REAL behavior (`_frontendQuiesceActive`'s new OR term), unlike every prior task's inert-by-default framing — run the FULL verification sweep, not just the fast lock-step:

```
~/sbt/bin/sbt compile
~/sbt/bin/sbt "testOnly m68k040.rob.RobPluginSpec"
~/sbt/bin/sbt "testOnly m68k040.lockstep.ExecuteLockStepSpec"   # expect 399/400 -- debugHaltState stays RUNNING for every existing test (debugStopRequestIn/debugStepRequestIn both default False), so this extension is a no-op in practice, but VERIFY, don't assume
# Full ported corpus, isolated worktree, per project standing verification methodology:
git worktree add /tmp/debug-stage2-task11-after HEAD
cd /tmp/debug-stage2-task11-after && ~/sbt/bin/sbt "testOnly m68k040.PortedTestRunner"   # or whatever the actual full-corpus runner target is named -- confirm the exact sbt target before running
```

- [ ] **Step 3: Commit**

```bash
git add src/main/scala/m68k040/rob/RobPlugin.scala
git commit -m "rob: Stage-2 required assertions (spec section 13) + frontend-quiesce extension to debug halt states (Stage 2 task 11)"
```

---

## Task 12: Advertise features 22/23, bump `stage` to 2 in the shipped netlist target

**Files:**
- Modify: `src/main/scala/m68k040/top/FullCoreSynth.scala`
- Test: `src/test/scala/m68k040/debug/DebugCtrlPluginSpec.scala` (feature-honesty check)

- [ ] **Step 1: `FullCoreSynth.scala:580`**

```scala
new m68k040.debug.DebugCtrlPlugin(buildId = dbgBuildId, stage = 2)
```

- [ ] **Step 2: Directed test — the feature-honesty rule actually holds**

Per spec §3.4 ("No feature bit may advertise a tied-off counter, stale shadow, placeholder probe, or operation that can be silently dropped") and the Stage 0/1 plan's own precedent test for this (locate it — Stage 1 almost certainly already has a "features read `featuresForStage(stage)` and every advertised bit has SOME real behavior" test; extend it rather than writing a parallel one):

```scala
test("stage=2: OFF_FEATURES advertises bits 22 (macro_retire_count) and 23 (stop_status_v2), and both are genuinely reachable") {
  // read OFF_FEATURES, assert bits 22 and 23 set; then independently exercise
  // OFF_INST_LO incrementing (macro_retire_count) and a manual halt actually
  // reaching effective-halt semantics (stop_status_v2) THROUGH THE SAME TEST,
  // proving the bits aren't just set but backed by real behavior.
}
```

- [ ] **Step 3: Compile + full lock-step + regenerate the shipped netlist + verilator lint**

```
~/sbt/bin/sbt compile
~/sbt/bin/sbt "testOnly m68k040.debug.DebugCtrlPluginSpec"
~/sbt/bin/sbt "testOnly m68k040.lockstep.ExecuteLockStepSpec"   # expect 399/400
~/sbt/bin/sbt "runMain m68k040.top.GenFullCoreSynthVerilog"
make lint-fpga-top CPU=m68k040   # from the macqd700-soc worktree if reachable
```

- [ ] **Step 4: Commit**

```bash
git add src/main/scala/m68k040/top/FullCoreSynth.scala src/test/scala/m68k040/debug/DebugCtrlPluginSpec.scala
git commit -m "debug: ship Stage 2 -- bump stage=2, advertise features 22/23 (Stage 2 task 12)"
```

---

## Task 13: Full-corpus regression + Verilator full-SoC lint (both `enable=true` and `enable=false`)

**Files:** none modified — verification only.

- [ ] **Step 1: Full lock-step, exact baseline check**

```
~/sbt/bin/sbt "testOnly m68k040.lockstep.ExecuteLockStepSpec"
```
Confirm exactly the 4 pre-existing known failures, byte-identical names to this plan's Global Constraints list (re-verify the CURRENT names first — they may have drifted since this plan was written).

- [ ] **Step 2: Full ported corpus, isolated worktree, before/after diff**

```bash
git worktree add /tmp/debug-stage2-before main   # or whatever the correct pre-plan reference commit is -- confirm with git log before running
git worktree add /tmp/debug-stage2-after HEAD
# run the full corpus in both, diff fail lists by TEST NAME (not raw count -- this
# project's own standing lesson, repeated across multiple prior plans' ledgers)
```
Zero new failures expected — this whole plan is additive and every new path defaults inert unless a host actively drives `dbg_axi`.

- [ ] **Step 3: Full-SoC Verilator lint from the macqd700-soc worktree** (if reachable at execution time; if the worktree from this session's earlier work — `/home/qwertyoruiop/macqd700-soc-worktrees/m68k040ooo-integration` — still exists and has its `cpu040` submodule pointed at a commit at or after this plan's merge, regenerate `M68kSocketTop.v` there and re-run `make lint-fpga-top CPU=m68k040`; if not reachable, note this explicitly as deferred rather than skipping silently).

- [ ] **Step 4: Clean up worktrees, record results** in a progress note (this plan's own ledger, if using subagent-driven-development) before proceeding to Task 14.

---

## Task 14: Full-core OOC synth gate (project standing rule) — `enable=true` and `enable=false`, report against spec §11

**Files:** none modified — verification only.

- [ ] **Step 1: Re-read the current FMax reference** — do NOT trust this plan's own Global Constraints section's number; find the most recently recorded post-route number on `fmax-closure-fanout` at EXECUTION time (check `.superpowers/sdd/`-style progress notes, or the most recent commit message mentioning a WNS/FMax figure, e.g. commit `5aae2c5` "197.278 MHz" per this session's own git log — but confirm nothing more recent has landed since).

- [ ] **Step 2: Confirm no Vivado/JTAG session is active** (`/var/tmp/m68k-ooo-vivado.lock`, per this project's standing rule — check before launching, this session's own earlier investigation found the shared lock genuinely contended more than once).

- [ ] **Step 3: OOC synth, `enable=true`** (the shipped `M68kFullCoreSynth.v` from Task 12) — report LUT/FF/DSP/BRAM utilization and WNS/FMax. **Gate (user directive, 2026-08-20, supersedes spec §11's raw +2% FMax ceiling for this build only): pass if post-route FMax clears ~100MHz with real margin** — this is the real target the current macqd700-soc bitstream work already runs the JTAG-enabled build at (`CORE_CLK_HZ=100_000_000`), not a synthetic reference number. LUT/FF/DSP/BRAM deltas against the Step 1 reference are still reported (not gated numerically at +1.0%, since the whole point of this build is to carry real new logic) but must still show no DSP/BRAM usage from this plan's own additions (spec §11 rule 6, "no debug function uses DSPs" — that part of §11 is NOT superseded).

- [ ] **Step 4: OOC synth, `enable=false`** (`M68kFullCoreSynthNoDebug.v` from Task 1) — this is the production target and spec §11's numbers are fully binding here, unchanged by the user's `enable=true` relaxation. **Gate: FMax clears ~200MHz class** (the current FMax-campaign reference re-read in Step 1 — e.g. the session's own recent 197.278MHz-class result — within spec §11's 2% band), LUT/FF within +1.0% of the pre-Stage-2 reference, no DSP/BRAM beyond what already existed. This build should be very close to byte-identical to the CURRENT `main`-branch reference (modulo Stage 1's own already-accepted cost from the Stage 0/1 plan's own gate) since Task 1 gates every line this plan adds behind `if (enable)`.

- [ ] **Step 5: Check the timing report's worst path is not a debug comparator/CSR mux/high-fanout debug enable** (spec §11's explicit named failure mode) — if it is, that is a REAL finding requiring a fix task, not a note; do not accept the gate with this violation present.

- [ ] **Step 6: Report absolute numbers for both builds**, not just deltas (spec §11: "Report absolute utilization and deltas for every implemented tranche").

- [ ] **Step 7: If the gate passes, this plan is DONE.** If it fails, dispatch a targeted fix task (pipeline the offending path per spec §11 rule 1-4) and re-gate — do not merge a failing gate and defer it, per this project's `[[synth-gate-every-slice]]` standing rule.
