kpwn/m68k-core-040-ooo/docs/superpowers/ported-tests-results-2026-07-18.md

# m68k-ooo Ported Tests — Final Results (2026-07-18)

**STALE — this snapshot's 521/763 tally is a single point-in-time result, not the current
pass rate.** Many triage/bugfix rounds have landed against this corpus since 2026-07-18
(tasks #147-#212+ across `docs/superpowers/ported-tests-results-2026-07-18.md`'s own
follow-on cluster work, plus 5 further incremental vendoring rounds through commit
`fbb17aa`, 2026-08-17, growing the corpus past 763 tests) without this doc being
regenerated. Do not cite the numbers below as current state; a fresh full-corpus re-run is
queued separately and had not landed as of 2026-08-18.

Generated by `tools/fuzz/ported-sweep.sh` on 2026-07-18 — authoritative failure catalog for full-suite sweep.

# Task 6 Report: Full-suite batch runner + final report

## What I did

1. Read the full task brief (`.superpowers/sdd/task-6-brief.md`) and checked branch state
   (`git status --short`, `git log --oneline -5`) before starting. The bulk-vendoring of
   the remaining 737 tests had already landed on this branch in commits `c01ff21` and
   `7518e96`, giving 763 `.s` files + 30 `.timeout` sidecars under
   `src/test/resources/m68kooo-ported-tests/asm/` (confirmed via `ls | wc -l` before
   starting — matches the brief's stated current/verified count, not the older 766/36
   estimate).

2. Created `tools/fuzz/ported-sweep.sh` verbatim from the brief's Step 1 code (batches the
   763-test corpus into groups of 100 by staging each batch's `.s`/`.timeout` files into a
   scratch directory and pointing `PortedM68kOooSpec` at it via the `PORTED_TEST_DIR` env
   var, one `sbt testOnly` JVM per batch, mirroring `tools/fuzz/sweep.sh`'s established
   batching discipline). Made it executable (`chmod +x`).

3. Ran the full sweep as a background process, logging to `ported_logs/batch_*.log`:
   ```
   nohup tools/fuzz/ported-sweep.sh 100 > <scratch>/sweep.log 2>&1 &
   ```
   Polled the background PID (and the actual `ported-sweep.sh`/`sbt`/`java` process tree
   underneath it) every ~60s via a persistent Monitor task plus periodic direct
   `kill -0`/log-tail checks, per the task's guidance that a single Bash call can't wait
   out a run this long. Confirmed genuine completion by `kill -0` returning nonzero on
   both the top-level PID and the `ported-sweep.sh` PID directly (not inferred from log
   content) before treating the run as done. Total wall-clock time: ~74 minutes (04:05-05:19),
   8 batches (7×100 + 1×63), each batch its own Verilator/sbt compile+run.
   `free -g` was checked periodically; memory never thrashed (peaked around 8-13GB used of 29GB).

4. Extracted the full pass/fail tally and every failing/hanging test's outcome from each of
   the 8 `ported_logs/batch_*.log` files (`grep -A1 "\*\*\* FAILED \*\*\*"` + the
   `Tests: succeeded N, failed M` summary line per batch).

5. Recorded the full tally and failure list in project memory, extending
   `ported-tests-triage-2026-07-17.md` (the existing home for this porting effort's
   results, per Task 4) with a new "Task 6: full-suite sweep" section, and updated its
   `MEMORY.md` index line.

6. Committed only `tools/fuzz/ported-sweep.sh` (verified via `git status --short`
   immediately before `git add` that nothing else was staged — the branch has ongoing
   concurrent activity from other sessions, several unrelated untracked synth/fuzz-log
   files were present and correctly left alone).

## Exact commands

```bash
# corpus verification
ls src/test/resources/m68kooo-ported-tests/asm/*.s | wc -l        # -> 763
ls src/test/resources/m68kooo-ported-tests/asm/*.timeout | wc -l  # -> 30

# script creation
chmod +x tools/fuzz/ported-sweep.sh

# full sweep run
rm -rf ported_logs
nohup tools/fuzz/ported-sweep.sh 100 > <scratch>/sweep.log 2>&1 &

# per-test repro command (for any name below), matching Task 4's established convention:
~/sbt/bin/sbt "testOnly m68k040.fuzz.PortedM68kOooSpec -- -z <name>"

# commit
git add tools/fuzz/ported-sweep.sh
git commit -m "test: full-suite ported-test sweep runner + results"
```

## Final tally

**Total: 763 tests run. 521 PASS, 242 FAIL.**

Per-batch breakdown (pass/fail):

| Batch | Range | Pass | Fail |
|---|---|---|---|
| 0 | [0,100) | 83 | 17 |
| 1 | [100,200) | 80 | 20 |
| 2 | [200,300) | 66 | 34 |
| 3 | [300,400) | 46 | 54 |
| 4 | [400,500) | 63 | 37 |
| 5 | [500,600) | 71 | 29 |
| 6 | [600,700) | 61 | 39 |
| 7 | [700,763) | 51 | 12 |
| **Total** | | **521** | **242** |

Of the 242 failures, breaking down by outcome type (cross-validated: 97+144+1 = 242,
matches exactly):
- **97 HANG** (timeout with no sentinel write — deadlock/never-completed signature)
- **144 FAIL** (sentinel word mismatch — wrong-result signature, various distinct sentinel
  values observed: `0xdeadbeef`, `0xdead0001`-`0xdead0f31`, `0xbadbad00`, `0xbad0000b`,
  `0xbadc0c22`, `0xbadd5700`, `0x14e22334`, `0x0000a008`, etc. — this diversity itself is
  evidence these are genuine distinct per-test findings, not one systemic harness bug)
- **1 assemble/toolchain error** (`movea_w_pc_brief_scale` — the vendored assembly failed
  to assemble via `m68k-linux-gnu-as`, a toolchain/test-corpus issue, not an RTL result)

**Of the 242 failures, 35 are in the `fpu_*`/`fpsp_*` (FPU/line-F) test family.** Per this
project's own `isa-completion-roadmap` memory, FPU/line-F is explicitly documented
out-of-scope (only the INTEGER 68040 ISA is complete/merged). These 35 are expected
failures given the core's documented scope, not new regressions requiring
investigation — flagged separately below rather than mixed into the "real gap" list.

**Excluding the FPU cluster: 207 non-FPU failures** among 728 non-FPU tests actually
exercising in-scope ISA surface (~71.6% pass rate on the in-scope subset).

One of the 242 failures (`aline_triple_nested_dbf_storm`, batch 0) is the pilot's
already-known, already-investigated-and-characterized open HANG (see
`ported-tests-triage-2026-07-17.md`'s "OPEN" section) — expected to reappear here, not a
new finding.

**This pass rate (68% overall / ~72% in-scope) is meaningfully lower than the 26-test
pilot's 25/26 (~96%).** This is not a harness problem: the pilot was a hand-picked subset,
not a random sample, and the bulk-vendored 737 tests exercise substantially more of the
ISA's obscure corners (memory-indirect addressing across nearly every instruction family
that supports it, PC-relative indexed jumps/calls, bitfield-on-memory-indirect combinations, Scc-on-memory,
MMU/TT edge cases, exception-frame/RTE format details, etc.) that the pilot's 26 tests
happened not to cover. Strong recurring patterns are visible across the failure list
(see below) suggesting a relatively small number of root causes could explain a large
fraction of these — a promising lead for a future triage session, but out of this task's
scope to investigate further (per the brief: record only, don't root-cause/fix).

## Complete list of every failing/hanging test (non-FPU)

Format: `test_name — OUTCOME`. Repro: `~/sbt/bin/sbt "testOnly m68k040.fuzz.PortedM68kOooSpec -- -z <name>"`.

### Batch 0 [0,100) — 17 failures
- `add_l_dn_memind_dst` — HANG (200000)
- `add_mem_modes` — FAIL sentinel=0xdeadbeef
- `adda_long_mem_forms` — FAIL sentinel=0xdead0003
- `adda_mem_jmp_indexed` — HANG (200000)
- `adda_word_mem_forms` — FAIL sentinel=0xdead0008
- `addq_subq_mem_rmw` — HANG (200000)
- `adv_predicted_indirect_jmp_squash` — HANG (200000)
- `aline_triple_nested_dbf_storm` — HANG (2000000) **[KNOWN — documented open finding from pilot triage, not new]**
- `alu_memind_no_idx_corpus_shape` — HANG (200000)
- `and_l_d8_an_xn_src` — HANG (200000)
- `andi_l_memind_dst` — HANG (200000)
- `andi_l_memind_dst_preidx` — HANG (200000)
- `atrap_dispatch_with_irq` — HANG (200000)
- `atrap_full_dispatch_replay` — HANG (200000)
- `b2_addq_subq_memind_null_od` — HANG (200000)
- `b3_movem_pc_indexed_widening` — HANG (200000)
- `b4_bit_indexed_memind_widening` — FAIL sentinel=0xdead0002
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
