kpwn/m68k-core-040-ooo/tools/fuzz/pilot-test-names.txt

neg_not
lsl_lsr_basic
cmpa_abs_mem
movea_absw_split
link_long_unlk
clr_l_idx
divl_basic
bf_basic
exc_addr_error
movep_l_byte_layout
eori_bw_reg
aline_triple_nested_dbf_storm
add_indexed_mem_src
sub_mem_dest
and_indexed_mem_dest
eor_mem_rmw
cmp_branches
move_l_abs_memind_dst
bcc_all_16_conditions
dbcc_different_dn_terminates
jsr_a7_indirect
trap_vec_32_47
swap_test
ext_extb
tst_abs_mem
bsr_16bit_disp
