kpwn/m68k-core-040-ooo/docs/superpowers/specs/2026-09-04-p123-reseed-placement-marginality-board-test.md

# p123-reseed board test: does a different placement clear the `0x4084BECE` wedge?

**Date:** 2026-09-04
**Type:** board/JTAG measurement (no build started, no SD card touched)
**Verdict:** **NO.** The re-placed bitstream wedges identically. Placement variation alone does not fix it.

---

## Question
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
