kpwn/m68k-core-040-ooo/docs/BUG_lockstep_irq_boundary_sweeps_harness_defects.md

# The IRQ boundary-sweep lock-step tests fail for HARNESS reasons, not core reasons

**Status: partially fixed (2026-09-16). Test-only changes; `src/main` is untouched.**

Applies to `odd-ssp: ... IRQ at every boundary of the LINK #-75 stretch ...` (22 tests,
all failing on `closure-200mhz` @ `817bf43d`) and to `a7-byte: IRQ at every boundary of
the SwapMMUMode byte push/pop idiom`.

## 0. What is NOT true

* `a7-byte: IRQ at every boundary ...` is **NOT a merge regression.** Measured on
  `817bf43d`: passes solo (1/1) and in-suite. Whole-suite on `817bf43d`: 779 tests,
  757 passed, **22 failed, and all 22 are the odd-ssp LINK family** -- no a7-byte
  failure, no board-repro failure, nothing else.
* Keying the IPL poke on MACRO retirement instead of per-uop -- what `9635f91c` did and
  `599180b7` reverted -- **DOES NOT FIX THIS.** Re-applied and measured: it REGRESSES
  `a7-byte` (b5 diverges on pc, b7-late on pc) and leaves odd-ssp boot-0/2/4/6/8/10/12
  still failing. Net loss. Do not re-try it without new evidence. (The reasoning behind
  it is sound and is recorded in the code comment; it is simply not sufficient.)

## 0b. PROVENANCE -- these tests were never sound, on either lineage

`move.w #63,%d1` (defect A's origin) was introduced by **`cf53df4a`**, the commit that
CREATED the odd-ssp family ("test(lockstep): odd-SSP exception frames ... IRQ at every
boundary ... (p167)"). It is present verbatim at the merge-base `2be94044` and on BOTH
lineages that descend from it -- `master` @ `b452c957` and `closure-200mhz` @ `817bf43d`
-- whose commit sets are DISJOINT (12 vs 16 commits, sharing nothing beyond the base).
The same is true of a7IrqSrc's uninitialised D1/D2/D5/D6 and oddSpSrc's D3/D4.

So the family has been seed-dependently red since birth. A defect that appears on two
disjoint change-sets and on their common ancestor cannot have been introduced by a merge
between them. **That settles "is it a regression?" as NO without needing a baseline
suite run**, which is why the baseline run was cancelled rather than waited on.

## 1. DEFECT A -- uninitialised data registers (REAL, fixed)

Musashi **zeroes every register at reset**; SpinalSim **randomises the PRF per seed**. A
BYTE or WORD write leaves the upper bits at that random value, and the lock-step compares
the committed 32-bit value -- so the test is red whenever the random init is non-zero.

Measured, three runs of the SAME test, three different garbage uppers:

    reg D1: dut=0x0d7c003f / 0xa98e003f / 0xccf9003f   oracle=0x0000003f   (index 4)
    reg D2: dut=0x4c1b9d00   oracle=0x00000000
    reg D3: dut=0xb058b600   oracle=0x00000000
    reg D1: dut=0xf6e68601   oracle=0x00000001         (a7-irq)

`0x3f` = 63, at index 4, is `oddSspFill`'s own first instruction:

    private val oddSspFill = Seq("move.w #63,%d1", ...)   // WORD write, D1 never initialised

so EVERY odd-ssp test built on that fill was seed-dependently red **before the interrupt
was even involved**. `a7IrqSrc` has the same hole in D1/D2 (idiom) and D5/D6 (handlers);
it initialises only D0.

Also **A6**: `link %a6,#-75` PUSHES the old A6 and `unlk %a6` pops it back, so an
uninitialised A6 is round-tripped through memory -- measured as
`reg A6: dut=0x2925a6a2 oracle=0x00000000` at the `unlk`. Found only AFTER the D1/D2/D3
fix removed the earlier noise and moved every killing boundary later (boot-0 19 -> 11,
boot-2 4 -> 20, boot-4 6 -> 20). `movea.l #0,%a6` is flag-neutral, unlike a `moveq`, so it
cannot perturb the CCR these sweeps check.

**Fix:** `moveq #63,%d1` in the fill (a long write; D1 is only a loop counter, so nothing
the test exercises changes), plus `moveq #0` for D2/D3 in `oddSspLinkSrc` and for
D1/D2/D5/D6 in `a7IrqSrc`. `Pre` in the a7-irq test is a hardcoded preamble count and was
bumped 15 -> 19 to match.

**This is very likely the explanation for a7-byte "failing" for one person and passing for
another: it is a seed-dependent flake, not a regression.**

## 2. DEFECT B -- `.distinct` broke retry-window adjacency (REAL, fixed)

    val boundaryPcs = (firstOdd - 1 to lastOdd + 2).map(plain(_).pc).distinct
    val lateWindow  = ((i to i+2) ++ ((i-1) to (i-2) by -1))    // INDEX arithmetic

The window was index arithmetic over the DISTINCT list. Wherever the stretch re-enters a
pc -- three `.short 0xa06e` A-line traps share one handler, and `sub1: rts` is entered by
BOTH `jsr (%a1)` and `bsr.s sub1` -- the distinct list SKIPS boundaries, so an `i±2` LIST
window does not cover the `i±1` PROGRAM window.

**Fix:** the window now walks a non-distinct, program-ordered `boundarySeq`; `.distinct`
survives only to avoid duplicate simulations.

## 3. DEFECT C -- the failure dump lied by omission (REAL, fixed)

`ExecuteLockStepSpec.scala:1440-1446` printed only `pc/sr/a7`, while `LockStep.compare`
checks pc, ccr, full SR, a7, msp, isp AND the committed architectural register write (plus
the 2nd destination of a cracked DIV.L/MUL.L). A genuine `reg D3` divergence therefore
produced a dump in which **every visible column matched** -- indistinguishable from "no
divergence here". Defect A was invisible behind this for the entire investigation.

**Fix:** the dump now leads with `res.firstDivergence.detail` -- which already named the
field and both values and was being discarded -- and carries the register write and CCR,
with `<<<` marking the diverging index.

## 4. DEFECT D -- the oracle cannot name a re-visited pc (REAL, NOT fixed, documented)

`Musashi.assembleAndTrace(..., irqEvents = Seq((pc, level)))` names the interrupt by a
PROGRAM COUNTER. For any pc the program visits more than once the oracle takes the
interrupt at the FIRST visit, and there is no way to ask for the second. "Before the
SECOND visit of `sub1`'s rts" is therefore inexpressible, and a DUT that legitimately
lands there can match NO oracle. A real fix needs an ordinal-aware `(pc, nth-visit)` event
in the oracle. Documented loudly at the `boundarySeq` definition.

## 4b. DEFECT E -- `a7ProbeLag` tolerates ONE stale commit, but two A7 events can land back-to-back (REAL, NOT fixed)

`LockStep.compare`'s `a7ProbeLag` exists because the commit port publishes A7 as
`RegNext(exc.ss.a7)` over a LIVE PRF readback of arch-15, so at an RTS return it can show
the pre-pop A7 for ONE commit. It tolerates exactly that: the DUT's A7 must equal the
oracle's A7 at the IMMEDIATELY PRECEDING step.

When an RTS return is IMMEDIATELY followed by an interrupt entry, two A7-changing macros
retire back-to-back and the probe is stale for TWO consecutive commits, which the
tolerance rejects. Measured (`odd-ssp-irq1-0-b19`, and identically at `irq1-6-b19`):

    157  DUT 0x408000b0/.../0x000fffad | ORACLE 0x408000b0/.../0x000fffad   jsr -> sub1
    158  DUT 0x40800074/.../0x000fffad | ORACLE 0x40800074/.../0x000fffb1   rts; DUT A7 stale (tolerated)
    159  DUT 0x408000b6/.../0x000fffad | ORACLE 0x408000b6/.../0x000fffa9   IRQ entry; REJECTED

Note the pc stream matches EXACTLY at the correct boundary -- only A7 diverges. So this,
not the boundary search, is what blocks those tests at their own boundary. The sound fix
is for the DUT to publish a per-commit ARCHIVED A7 rather than a live readback (RTL work);
widening the tolerance to two steps would weaken a check that exists to catch real A7 bugs.

## 4c. The residual is ONE dominant shape, not a diffuse mess (measured)

Classifying every failing test by what diverged at its OWN requested boundary (the
no-`late` attempt) after defects A/B/C were fixed:

* **4 tests blocked by `reg A6`** -- `irq1-0` b11, `irq1-12` b16, `irq1-6-movem` b5,
  `irq1-10-call` b13. These are the `link`/`unlk` case above and are fixed.
  `irq1-0` b11 is the proof that the boundary search itself is fine: the DUT matched the
  b11 oracle's pc stream all the way to index 183 and diverged ONLY on the uninitialised
  A6, while the `late12` retry shows it one macro EARLIER than the b12 oracle -- i.e. the
  DUT really was at boundary 11 and the search found it.
* **~10 tests share ONE identical signature**: `b20 -> pc: dut=0x408000bc
  oracle=0x4080007a` (and the `-call` variants `b16 -> dut=0x408000b8
  oracle=0x408000ce`). `0x408000bc` is inside the A-LINE HANDLER while the oracle is
  still in the main body. So the interrupt lands on the far side of the program's SECOND
  `.short 0xa06e` A-line trap from every oracle the window offers.

That clusters the remaining work on one mechanism -- interrupt recognition across a trap
entry -- rather than leaving it open-ended.

And defect E is ENTANGLED with it, not independent. In the dominant `b20` shape the A7
columns disagree BEFORE the pc does, and the DUT's A7 trails the oracle's by 4 across
SEVERAL commits during nested A-line-trap entry/exit before realigning:

    159  DUT 0x408000b6/.../0x000fffab | ORACLE 0x408000b6/.../0x000fffab   trap entry
    160  DUT 0x40800078/.../0x000fffab | ORACLE 0x40800078/.../0x000fffaf   differs; tolerated
    162  DUT 0x408000bc/0x2108/0x000fffa3 | ORACLE 0x4080007a/0x2008/0x000fffaf   <<<
    165  DUT .../0x000fffab/A7=0x000fffab | ORACLE .../0x000fffab/A7=0x000fffab   realigned

So E is not "one stale commit at an RTS"; the live-PRF A7 probe can trail for a multi-commit
window whenever exception entries and returns bunch up. Anyone attacking the residual
should fix the A7 observation (per-commit archived A7) FIRST, because until then the
boundary evidence is read through a lagging probe.

## 5. The residual, and why it is NOT a core defect

After A/B/C the remaining odd-ssp failures are `pc` divergences -- the interrupt landing on
a different macro boundary than any oracle in the window. The DUT is architecturally
correct at every one of them. Worked example (boundary 9 vs the boundary-11 oracle):

    idx   DUT pc/sr/a7                      ORACLE pc/sr/a7
    149   0x4080006a/0x2008/0x000fffb1  |   0x4080006a/0x2008/0x000fffb1
    150   0x408000b6/0x2108/0x000fffa9  |   0x4080006c/0x2000/0x000fffb1   DUT enters handler
    151   0x4080006a/0x2008/0x000fffb1  |   0x408000b6/0x2100/0x000fffa9   oracle enters handler
    152   0x4080006c/0x2000/0x000fffb1  |   0x4080006c/0x2000/0x000fffb1   rejoined

Both push the SAME frame base `0x000fffa9`; each side's SR is self-consistent with where it
entered (DUT still has N set, having not yet run the N-clearing insn at `0x4080006a`); the
RTE restores `0x4080006a` and the streams rejoin exactly. Nothing is corrupted. The odd SSP
itself is legitimate Mac OS behaviour (`linkw %fp,#-75`).
