kpwn/m68k-core-040-ooo/docs/BUG_ras_checkpoint_save_proxy_unsound.md

# RAS `checkpointSave` uses `rob.count === 0`, which the frontend's run-ahead makes unsound

**Status: not fixed. Scoped, not started. This is a prediction-QUALITY defect, never
an architectural-correctness one** — the branch EU verifies every RTS/RTR target
against the value actually loaded from the stack, so a wrong RAS prediction costs
cycles and nothing else. Filed 2026-09-04 during the night-work consolidation.

## 1. What the RTL promises

`RasPlugin` (`src/main/scala/m68k040/frontend/Ras.scala`) recovers speculative RAS
state with a checkpoint/restore pair rather than a per-branch checkpoint stack:

* `checkpointRestore` — copy `ckRasSp`/`ckCount`/`ckRas` back into the live state.
  Driven from `doFlush || fa.logic.ftqMismatch`.
* `checkpointSave` — refresh the checkpoint from the live state. Driven from
  `rob.logic.count === 0 && !checkpointRestore`.

Wired identically in all four DUT copies (`FullCoreSynth.scala:159`,
`FuzzDut.scala:215`, `ExecuteLockStepSpec.scala:309`, and `IpcBenchSpec`).

> **Amendment 2026-09-15 (FMax, does NOT change this bug).** The `checkpointSave`
> wiring is now `rob.logic.countIsZero` — a REGISTERED flag in `RobPlugin` that is
> bit-exactly `count === 0` (computed off the same `countNext` that drives `count`,
> with the flush override mirrored; guarded by a sim-only equality assertion) — and
> `RasPlugin` applies the copy the cycle AFTER the arm, gating it internally with
> `!checkpointRestore` instead of requiring each wiring site to AND that in. Purely a
> timing restructure: `ckRas_*_reg[*]/D` had become the worst endpoint family in the
> design because the old same-cycle form put FetchAlign's `pushValid` (~17 levels,
> through DecodeStage's ready ladder) on 512 flop D pins. The captured CONTENT is
> identical, so **everything below still applies verbatim**: the proxy is still
> `rob.count === 0`, and the frontend still runs ahead of it. Measured IPC before/after
> at a pinned seed was bit-identical on all 13 kernels including `call-return`.

The soundness argument for the `rob.count === 0` proxy is stated in Ras.scala's own
class comment: *"at that instant NOTHING is outstanding/unresolved, so the live RAS
state is, by construction, exactly the architecturally correct one (module the few
cycles of fetch->dispatch pipeline latency, an accepted, bounded approximation)."*

## 2. The gap, measured

That parenthetical is not a rounding error; it is the whole failure mode. **The ROB
being empty says nothing about the frontend**, which by design runs ahead of dispatch.
`rasPushValid` is asserted at FetchAlign (`FetchAlignPlugin.scala:1225`,
`feed.fire && !faultHold && s0IsCall`) — many cycles before the same call reaches the
ROB. So there is a window in which:

* the ROB is empty (`rob.count === 0`) → `checkpointSave` is asserted, **and**
* the frontend has already pushed a *speculative, wrong-path* return address.

On that cycle the checkpoint captures `nextCount` — i.e. it **saves the phantom entry
as if it were architecturally correct**. The later `checkpointRestore` then faithfully
restores the phantom, and the rollback has strictly no effect.

Measured directly on unmodified mainline (`afbabdd`), whitebox probe on
`ras.logic.{pushValid,pushRetPc,popValid,count,rasSp,checkpointSave,checkpointRestore,ckCount}`,
running the existing `ras-rollback-no-phantom-leak` program:

```
[rasprobe] cyc=108 push=true  retPc=0x40800018 cnt=0 sp=0 save=true  rest=false ckCnt=0
[rasprobe] cyc=110 push=false                  pop=true cnt=1 sp=1 save=false rest=false ckCnt=1
[rasprobe] cyc=116 push=false                  pop=false cnt=0 sp=0 save=false rest=true  ckCnt=1
[rasprobe] cyc=120 push=true  retPc=0x40800018 cnt=1 sp=1 save=true  rest=false ckCnt=1
```

Read it as: at cyc 108 a **wrong-path** `bsr leaf` (the fall-through past the
not-yet-resolved `beq` runs straight into `skip:`) pushes `0x40800018` — and
`save=true` on the *same cycle*, so `ckCount` goes 0 → 1. At cyc 116 the `beq`'s
commit-time flush restores that contaminated checkpoint. At cyc 120 the **real**
`bsr leaf` pushes onto a RAS that still holds the phantom (`cnt=1`).

The concurrent rename trace confirms the wrong path was genuinely walked and that
`0x4080000a`'s `bsr wrongcall` was fetched:

```
[ren] g=22 s0 pc=0x40800006  (beq)
[ren] g=22 s1 pc=0x4080000a  dst=15   (bsr wrongcall — A7 push µop)
[ren] g=23 s1 pc=0x4080000e  dst=5    (moveq #99,%d5 — wrong-path filler)
[ren] g=25 s0 pc=0x40800014  dst=15   (bsr leaf, reached by fall-through)
```

## 3. Why this is structural, not a tuning problem

For the *specific* program in `ras-rollback-no-phantom-leak` the contamination is
**unavoidable**: the mispredicting `beq` is the third instruction, so every cycle of
the wrong-path excursion happens while the ROB is still filling and `rob.count === 0`
holds. There is no seed for which that program takes a wrong-path push *and* keeps a
clean checkpoint. That is why the test has never passed (SS5).

The general statement is weaker but still real: after **any** ROB drain the frontend
may already have fetched past the drain point, so `checkpointSave` can capture
speculative pushes at any point in a program, not only during startup.
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
