kpwn/m68k-core-040-ooo/tools/musashi/m68k_ref.h

// m68k_ref.h — thin C++ wrapper around the Musashi 68k ISS
//
// Musashi has global state (one CPU per process).  This wrapper gives
// it a cleaner C++ interface and a built-in flat memory backing, so
// the fuzzer / co-sim harness can drive it without touching Musashi's
// globals directly.
//
// Usage:
//   MusashiRef ref;
//   ref.set_cpu_type(MusashiRef::CPU_68040);
//   ref.load_binary("prog.bin", 0x40800000);
//   ref.reset(0x40800000, 0x00800000);   // PC, initial SSP
//   int n = ref.run_until_sentinel(0xFFFF0000, 200000);
//   uint32_t d0 = ref.get_reg(MusashiRef::REG_D0);
//
// Sentinel convention: the harness calls `run_until_sentinel(addr,
// max_cycles)`, which executes until a write to `addr` is observed,
// the cycle budget runs out, or an exception loop is detected.  The
// sentinel value captured on the matching write is returned via
// `last_sentinel_value()`.

#pragma once
#include <cstdint>
#include <string>
#include <utility>
#include <unordered_map>
#include <vector>

#include "m68k_bus.h"

// 80-bit IEEE-754 extended value, split exactly the way Musashi/SoftFloat stores it
// (`floatx80` = { bits16 high; bits64 low; }, softfloat/softfloat.h:49-52):
//   high[15]   = sign
//   high[14:0] = 15-bit biased exponent
//   low[63:0]  = significand INCLUDING the explicit integer bit (extended precision
//                has no implicit bit)
struct Fp80 { uint16_t high; uint64_t low; };

class MusashiRef {
public:
    enum CpuType {
        CPU_68000 = 0,
        CPU_68010,
        CPU_EC020,
        CPU_68020,
        CPU_68030,
        CPU_68040,
    };

    // Register indices — deliberately match Musashi's enum values so
    // we can forward directly.
    enum Reg {
        REG_D0 = 0, REG_D1, REG_D2, REG_D3,
        REG_D4,     REG_D5, REG_D6, REG_D7,
        REG_A0,     REG_A1, REG_A2, REG_A3,
        REG_A4,     REG_A5, REG_A6, REG_A7,
        REG_PC,
        REG_SR,
        REG_SP,     // currently-active stack pointer
        REG_USP,
        REG_ISP,
        REG_MSP,
        REG_SFC,
        REG_DFC,
        REG_VBR,
        REG_CACR,
        REG_CAAR,
    };

    MusashiRef();
    ~MusashiRef();

    // ── Configuration ────────────────────────────────────────────────
    void set_cpu_type(CpuType t = CPU_68040);

    // Optional external bus.  When set, Musashi memory callbacks use this bus
    // instead of the built-in sparse memory.  The existing fuzz runner leaves
    // it null and keeps the old behavior.
    void set_bus(M68kBus* bus);

    // ── Memory ───────────────────────────────────────────────────────
    // Writes are tracked; final_mem_writes() returns all unique byte
    // addresses the CPU has written to, sorted ascending.
    uint8_t  read8(uint32_t addr) const;
    uint16_t read16(uint32_t addr) const;
    uint32_t read32(uint32_t addr) const;
    void     write8(uint32_t addr, uint8_t v);
    void     write16(uint32_t addr, uint16_t v);
    void     write32(uint32_t addr, uint32_t v);

    // Load a flat binary from disk at `base_addr`.  Returns bytes
    // loaded or -1 on failure.
    int64_t  load_binary(const std::string& path, uint32_t base_addr);

    // Record-only ranges don't log modifications (useful for ROM / the
    // magic sentinel region so we don't pollute mem-diff output).
    void     add_readonly_range(uint32_t lo, uint32_t hi_exclusive);

    // ── CPU control ──────────────────────────────────────────────────
    // Writes initial PC + SSP at the reset vector (addrs 0, 4), then
    // pulses reset so Musashi picks them up.
    void     reset(uint32_t initial_pc, uint32_t initial_ssp);
    // Pulse reset, then force PC/SP directly.  This is useful for harnesses
    // whose reset PC is supplied out-of-band rather than through vector 1.
    void     reset_direct(uint32_t initial_pc, uint32_t initial_ssp);
    void     set_irq(unsigned int level);
    void     set_interrupt_ack_response(int vector);

    // ── 68040 software MMU (oracle for our RTL's format-$7 page-fault delivery) ──
    // When enabled, DATA accesses (cb_read*/cb_write* with a data function code)
    // are translated through a 68040 long-format 3-level page table rooted at
    // `root_ptr` (URP/SRP). A non-resident / write-protect / supervisor-violation
    // page raises a 68040 access fault (vector 2, format-$7 frame) via Musashi's
    // m68k_pulse_bus_error(), exactly mirroring MAME's m68040 model. The table
    // descriptor format matches our RTL's TableWalker (rootIdx=VA[31:25],
    // ptrIdx=VA[24:18], pageIdx=VA[17:12]; descriptors little-endian; PDT/UDT in
    // low 2 bits, WP=bit2, super=bit7, PPN=bits[31:12]). Disabled by default ->
    // every existing program is byte-for-byte unchanged.
    //
    // Only DATA accesses whose (untranslated) address falls in the half-open
    // window [data_lo, data_hi) are translated; everything else (instruction
    // fetch from the code region, vector table, supervisor stack, the page
    // table itself, the sentinel) passes through identity. This matches the
    // RTL, where only D-side data accesses go through the DTLB (instruction
    // fetch uses a separate, untranslated I-cache). The window is the data
    // page region the program touches.
    void     enable_mmu(uint32_t root_ptr, uint32_t data_lo, uint32_t data_hi);
    // Set the instruction-translate window (the I-side of the one MMU). An
    // instruction fetch in [instr_lo, instr_hi) translates + can fault (program-space
    // SSW). Default window is empty -> instruction fetch is identity (unchanged).
    void     set_instr_window(uint32_t instr_lo, uint32_t instr_hi);

    uint32_t get_reg(Reg r) const;
    void     set_reg(Reg r, uint32_t v);

    // -- FP state (68040 FPU) --------------------------------------------
    // Musashi's PUBLIC m68k_get_reg()/m68k_set_reg() API has NO floating-point
    // surface whatsoever (m68k.h:111-152 -- verified, M68K_REG_FP* does not
    // exist), so unlike get_reg() above these do NOT forward to it: they read
    // m68ki_cpu.fpr[]/.fpcr/.fpsr/.fpiar (m68kcpu.h:953-956) directly.  Defined
    // in the SEPARATE translation unit m68k_ref_fp.cpp.
    Fp80     get_fp(int i) const;
    uint32_t get_fpcr() const;
    uint32_t get_fpsr() const;
    uint32_t get_fpiar() const;

    // Execute until one of:
    //   - a 32-bit (or 16-bit or 8-bit) write lands at `sentinel_addr`
    //   - `max_cycles` Musashi cycles have elapsed
    //   - a double-fault or tight exception loop is detected
    // Returns cycles actually executed.
    int      run_until_sentinel(uint32_t sentinel_addr, int max_cycles);
    int      run_until_sentinel_or_pc(uint32_t sentinel_addr,
                                      bool stop_pc_enabled,
                                      uint32_t stop_pc,
                                      int max_cycles);
    int      run_until_sentinel_or_pc_with_irq(uint32_t sentinel_addr,
                                               bool stop_pc_enabled,
                                               uint32_t stop_pc,
                                               bool irq_pc_enabled,
                                               uint32_t irq_pc,
                                               unsigned int irq_level,
                                               int max_cycles);
    int      run_until_sentinel_or_pc_with_irq_events(uint32_t sentinel_addr,
                                                      bool stop_pc_enabled,
                                                      uint32_t stop_pc,
                                                      const std::vector<std::pair<uint32_t, unsigned int>>& irq_events,
                                                      int max_cycles);
    int      step_one();
    // Initialise sentinel tracking for use with step_one() loops.
    // Must be called before the first step_one() when not using
    // run_until_sentinel*; mirrors the init that run_until_sentinel_or_pc_with_irq_events does.
    void     begin_trace(uint32_t sentinel_addr);
    bool     hit_sentinel() const { return hit_sentinel_; }
    bool     hit_stop_pc() const { return hit_stop_pc_; }
    uint32_t last_sentinel_value() const { return last_sentinel_value_; }
    int      last_sentinel_size() const { return last_sentinel_size_; }

    // ── Mem-write log ────────────────────────────────────────────────
    // Unique (addr, byte-value) pairs touched by CPU writes.  Sorted
    // by address.
    struct MemByte { uint32_t addr; uint8_t val; };
    std::vector<MemByte> final_mem_writes() const;
    std::vector<MemByte> final_mem_write_events() const;
    std::vector<MemByte> final_memory_snapshot() const;

    // ── Musashi callback plumbing ────────────────────────────────────
    // Musashi is a C library with global functions — we install
    // ourselves as the "active" instance; only one MusashiRef can
    // exist at a time.  This is enforced in the ctor.
    static MusashiRef* active() { return active_; }

    uint32_t cb_read8(uint32_t a);
    uint32_t cb_read16(uint32_t a);
    uint32_t cb_read32(uint32_t a);
    void     cb_write8 (uint32_t a, uint32_t v);
    void     cb_write16(uint32_t a, uint32_t v);
    void     cb_write32(uint32_t a, uint32_t v);
    int      cb_int_ack(int int_level);

private:
    // 68040 software MMU: translate `va` (a data access; rw: false=read,
    // true=write). Returns the physical address. On a non-resident /
    // write-protect / supervisor fault, sets the m68ki_aerr_* globals and
    // calls m68k_pulse_bus_error() (which longjmps out — does not return here).
    // Untranslated / disabled -> identity.
    uint32_t mmu_translate(uint32_t va, bool rw);
    // Instruction-fetch translate (the 68040 has ONE MMU: I and D both translate).
    // `instr` selects program space for the fault SSW (FC bit1) + the instruction
    // translate window. Mirrors the RTL ITLB.
    uint32_t mmu_translate_ex(uint32_t va, bool rw, bool instr);
    bool      mmu_enabled_ = false;
    uint32_t  mmu_root_    = 0;
    uint32_t  mmu_lo_      = 0;
    uint32_t  mmu_hi_      = 0;
    // Instruction-translate window [instr_lo_, instr_hi_): an instruction FETCH whose
    // (untranslated) VA falls here is translated through the SAME page table; a
    // non-resident I-page raises a vector-2 access fault with a PROGRAM-space SSW.
    uint32_t  mmu_instr_lo_ = 0;
    uint32_t  mmu_instr_hi_ = 0;

    // Flat byte store — hash map to keep memory small for sparse
    // programs.  Address → byte value.  Missing addresses read 0xFF,
    // matching the Verilator MemModel default so co-sim results stay
    // in sync for "uninitialised read" cases.
    std::unordered_map<uint32_t, uint8_t>  mem_;
    std::unordered_map<uint32_t, uint8_t>  writes_;        // tracks CPU writes
    std::vector<MemByte>                   write_events_;  // ordered CPU write bytes
    std::vector<std::pair<uint32_t,uint32_t>> ro_ranges_;  // [lo, hi)
    M68kBus* bus_ = nullptr;
    int       int_ack_response_ = -1;

    bool      hit_sentinel_       = false;
    bool      hit_stop_pc_        = false;
    uint32_t  sentinel_addr_      = 0;
    uint32_t  last_sentinel_value_= 0;
    int       last_sentinel_size_ = 0;   // 1 / 2 / 4 bytes

    static MusashiRef* active_;
};
