kpwn/m68k-core-040-ooo/(commit log)

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2026-05-31 docs: verification-harness + Musashi lock-step implementation plan
    Plan #2: port the 030 Musashi oracle (subprocess bridge + GNU-as assembler,
    retargeted -m68040), extend musashi_run with a --trace per-instruction mode,
    build a pure-Scala instruction-level LockStep comparator, and a SpinalSim
    CommitTrace capture path validated end-to-end against Musashi via a synthetic
    TraceReplay producer. Also adds musashi/test-verilator make targets (resolves
    the pm_gate follow-up). 5 TDD tasks.
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2026-05-31 cache: predecode-on-miss PREDECODE stage + predMem + window pred output
    - Add `predMem` (4-way × 64-set × 128-bit LUTRAM): 32 ChunkPredecode
    results packed per cache line, written in the new PREDECODE FSM state.
    - Add `lineReg` (512-bit): captures AXI R beats during REFILL; used by
    PREDECODE to classify all 32 words via PredecodeWord.classify.
    - FSM: REFILL → PREDECODE → REPLAY (tag/valid/victim writes moved to
    PREDECODE; data still written beat-by-beat in REFILL).
    - Add `rspPredReg` + `windowPred` helper: selects the 4-chunk window
    for pc(5:3) from a 128-bit predMem entry; latched on hit (IDLE) and
    miss (REPLAY); driven to rspPort.payload.pred every cycle.
    - Fix FetchRsp.pre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
2026-05-31 docs: fetch/align stage design (2-wide decode-packet stream)
    FetchControl (sequential fetch + redirect/resume ports, no prediction) +
    InstructionBuffer (word+predecode queue) + Aligner (2-wide boundary
    chaining via predecode lenWords; complex -> 1-wide + stall-for-resume).
    Emits Stream(Vec(DecodePacket,2)) to the future decode stage. Verified
    end-to-end through icache+predecode against hand-laid instruction streams.
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2026-05-31 frontend: FetchAlignPlugin (fetch control + buffer + aligner, 2-wide) + e2e tests
    Implements FetchAlignPlugin which wires FetchService (I-cache), InstructionBuffer,
    and Aligner into a 2-wide DecodePacket stream (DecodeFeedService).
    Key implementation details:
    - Single-outstanding fetch gated on started/fetchInFlight/push.ready/stalled.
    - ic.cmd.valid/payload set via setAsDirectionLess() to bridge the intra-component
    hierarchy: IcachePlugin declares cmdPort as slave (input to Dut toplevel), so
    FetchAlignPlugin must strip direction before driving it from within the same component.
    - Leading-word drop on redirect/resume: dropPending/dropCount track the word offset
    (PC[2:1]) for the first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
2026-06-01 docs: decode sub-slice 1 design (register/immediate simple decode)
    Two parallel SimpleDecodeUnits (2-wide) cracking the reg/imm simple subset
    (MOVEQ, MOVE/MOVEA reg/imm, ALU reg-reg, Bcc) -> one DecodedUop each (the
    pre-rename arch-operand uop contract). DecodeStage plugin emits
    DecodeUopService(Stream(Vec(DecodedUop,2))). Also fixes the logged
    service-port-directionality convention (plain Stream/Flow wires; drop
    setAsDirectionLess + complexPending). Memory-EA -> unimplemented (sub-slice
    2); complex -> sub-slice 3 (microcode + resume). Decode decomposed into 3
    sub-slices.
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2026-06-01 docs: rename slice 1 design (int + split-CCR, NaxRiscv-informed, 250MHz)
    Dual-RAM RAT (location-bit O(1) flush, async LUTRAM reads, multi-write
    WAW bypass) adapted from NaxRiscv TranslatorWithRollback; pointer-based
    multi-port freelist (flush = pointer reset, no broadcast clear);
    RenameStage maps DecodedUop -> physical RenamedUop 2-wide with intra-group
    RAW slot-bypass + WAW ordering; int(16/48) + NZVC(1/16) + X(1/16). FMax
    discipline first-class: no high-fanout, flush fans only to tiny location
    bits + freelist pointers. Commit/flush test-driven (ROB later).
2026-06-01 docs: rename slice 1 implementation plan (int + split-CCR)
    4 TDD tasks: RatTable (dual-RAM RAT, location-bit O(1) rollback,
    multi-write-bypass; adapted from NaxRiscv TranslatorWithRollback);
    pointer-based Freelist (flush = pointer reset); RenamedUop +
    RenameUopService; RenameStage (int + NZVC + X RATs/freelists, 2-wide
    intra-group RAW slot-bypass + WAW ordering, flush/commit test ports).
    FMax-disciplined: async reads, no high-fanout.
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2026-06-02 docs: IssueQueue (execute slice 3b) design — NaxRiscv-style 2-wide, slot-indexed triggers, latency-1 wakeup
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2026-06-02 dispatch: DispatchPlugin + ROB passive-alloc + 2 completion ports
    ROB no longer consumes RenameUopService directly. It now exposes a passive
    RobAllocService (allocReady/robId0/robId1 + allocFire/allocUop/allocSlot1 driven
    by the sibling DispatchPlugin). The single test markComplete port is replaced by
    two real completion Flow ports, and a sim-public commitObs is added for the
    lock-step harness. New DispatchPlugin consumes rename, takes robIds from the ROB,
    and fans each uop to ROB-alloc + IQ-push with combined back-pressure
    (ren.uops.ready = rob.allocReady && iq.push.ready).
    Synth tops (GenSynthVerilog, GenBackendSynthVerilog) gain DispatchPlugin + IQ so
    the now-passive ROB elaborates; Synt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
2026-06-02 execute: EU writeback-obs + backend whitebox reconstruction test
    Add sim-only WbObs to AluEuPlugin S1, WhiteboxCapture harness that joins
    EU writebacks by robId with the ROB commit stream (folding CCR), and a
    BackendWhiteboxSpec wiring the whole backend (rename->dispatch->IQ->2 ALU
    EUs->ROB, no frontend) checking the reconstructed CommitObservations.
    Two enabling changes were required for the 2-EU backend to elaborate:
    - MultiportRam: allow async-read multi-write lowering when readsAsync==0
    (NZVC/X PRFs get 2 write ports but no reads in this build); the XOR/LVT
    bank construction is valid with zero external read ports. Sync-read
    multi-write Mems still error.
    - RobPlugin: completion por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
2026-06-02 rob: branch completion store + commit-time registered redirect (RedirectService) + branch trace nextPc
    BR3 of the branch unit (3d-1). The ROB captures the branch EU's completion
    ({robId, mispredict, nextPc}), and at the mispredicting branch's retire fires a
    single REGISTERED doFlush pulse (+flushPc) that drives only pointer/reg resets
    (no combinational execute->flush fanout) and self-squashes the ROB. A branch's
    commit-trace pc is its RESOLVED nextPc, not predNextPc. RedirectService exposes
    doFlush/flushPc for BR4 to wire to rename/IQ/frontend.
    Two correctness fixes found while bringing this green:
    - mispredictStore: RegInit(False) + per-alloc reset (mirrors `completes`). A
    freshly-alloca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
2026-06-02 execute: wire branch EU + commit-time redirect into full core; branch lock-step; re-synth >=250MHz
    Wire the branch EU + RedirectService through the full core (FullCoreSynth +
    lock-step DUT): branchEu.issue << iq.issue(2); rob.branchCompletion <-
    branchEu.completion; the ROB's registered doFlush pulse drives iq.flushPort,
    decode/rename pipeFlush (sibling-driven, allowOverride to avoid a Fiber
    build-order cycle), and a new highest-priority FetchAlign mispredictRedirect
    (RAT-rollback flush already driven by the ROB). WhiteboxCapture now reads the
    branch EU wbObs as a no-write writeback and snapshots the committing
    instruction's wb at commit time (robId-reuse-correct under mispredict recovery).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
2026-06-02 rename/freelist: fix mispredict-recovery for loops (freelist pushCount + flush rollback + slot1 alloc gating)
    3d-1b: a backward branch taken on >=2 consecutive iterations diverged from Musashi
    (operands read stale after the 2nd flush). Three real bugs, all masked by the same
    freelist accounting error:
    1. Freelist pushCount was computed with `when(valid){ pushCount = pushCount + 1 }` —
    but pushCount is a Scala var, so `when` does NOT gate it; it built `U(0)+1+1`
    UNCONDITIONALLY, making pushCount == pushPorts every cycle. tail/count/commHead
    drifted +2/cycle even when nothing was pushed. This inflated `count` and MASKED
    the next two bugs (the freelist never appeared to drain). F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
2026-06-03 docs: full decode matrix framework design (EA-agnostic decode / opcode-agnostic EA)
    Decomposition: table-driven OperationDecoder (EA-agnostic masked-pattern matrix,
    line-grouped) + opcode-agnostic EaDecoder + MicroOpAssembler/cracker. Hybrid EA
    (simple AGU-in-LS, complex EA uop, always crack mem to load/store + temps); a few
    arch temp regs in the rename space; uop expansion queue. First slice = table-driven
    reg/imm decode (no LS dependency), replacing SimpleDecodeUnit; memory cracking
    designed but deferred to the LS cluster.
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2026-06-03 decode: replace SimpleDecodeUnit with table-driven framework (OperationDecoder + EaDecoder + assembler); reg/imm; lock-step unchanged, >=250MHz
2026-06-03 ls: integrate LS cluster (L1D + SQ + LS EU + IQ LS port) into full core; injection-tested; >=250MHz
    Wires DcachePlugin + LsEuPlugin (+ StoreQueue) into FullCoreSynth: LS issue
    port (3), LS completion -> ROB 3rd completion port + IQ dynamic wakeup, ROB
    retire -> SQ commit, doFlush -> SQ flush. Adds DTranslationService /
    DIdentityTranslationPlugin so I- and D-caches own distinct translation ports.
    Backend/lock-step Duts tie issue(3) off.
    FMax fix (variant A): the dynamic-wakeup lsBusy read was on the
    IQ-select -> ALU-operand-read S0 path (WNS -0.080, 245 MHz). Replaced it with a
    per-slot registered lsWait bit (set at push from lsBusy, cleared on lsWakeup,
    shifted with compaction) so lsBusy no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
2026-06-03 rename: 2 int temp arch regs (T0/T1) for memory-EA cracking
    Add internal int temp arch regs T0/T1 (arch ids 16,17) above D0-7/A0-7 for
    memory-EA cracking. Widen int reg-id fields to 5 bits (DecodedUop src/dst,
    EaSpec.reg, RenamedUop.dstArch, CommitSlot.intArch, RobPayload.archRegId,
    CommitTrace.archRegId, WbObs.dstArch; MicroOp.archDst/RobEntry.intArchDst follow
    log2Up(ARCH_INT_REGS)). Bump int RAT archDepth 16->18, int freelist
    archCount 16->18 / physCount 48->50 (free headroom unchanged), and seed the
    committed-RAT identity init for arch 0..17. 3d-1b freelist commHead rollback
    unchanged.
    TempRegsSpec: arch 16/17 rename to distinct pdsts + thread dstArch.
    RenameStageSpec/FreelistSpec/RobPl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
2026-06-03 decode: micro-op expansion queue (variable-in, 2-wide-out)
    MicroOpQueue: a depth-16 ring (RegInit) buffering the variable-rate µop
    expansion from the cracking assembler. Accepts up to 4 µops/cycle (2 decode
    slots × up to 2 µops each) via a compacted multi-push at the tail (hardware-sum
    counts, no when-gated Scala vars), drains 2/cycle to rename preserving FIFO
    order, and flushes by pointer reset. push.ready gates on >=4 free slots so a
    full burst never overflows; output is Stream(Vec(DecodedUop,2)) + pop1Valid,
    mirroring the DecodeUopService contract.
2026-06-03 decode: crack memSimple load EA source into load uop + temp
    EaDecoder now produces memSimple base/disp for the in-scope source modes —
    (An), (d16,An), (xxx).W, (xxx).L, (d16,PC) — and classifies the deferred
    side-effect/indexed modes ((An)+, -(An), (d8,An,Xn), (d8,PC,Xn)) as MEMCOMPLEX.
    MicroOpAssembler.assemble now returns a 1-2 µop sequence (AssembledUops:
    Vec(DecodedUop,2)+count). A memSimple EASRC source cracks into µop0 = LOAD
    {cluster=LS, memOp=LOAD, srcA=base, imm=disp, size, dst=T0} then µop1 = the op
    reading T0 in its EASRC slot. (d16,PC) folds pc+2+disp into the absolute disp
    (no base read). RMW-to-mem / memComplex / (An)+ stay unimplemented. DecodeStage
    keeps a slot0-only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
2026-06-03 decode: crack MOVE reg->memSimple into a store uop
    When the op is MOVE and the destination EA is memSimple with a register source,
    emit a single STORE µop {cluster=LS, memOp=STORE, srcA=base, imm=disp, size,
    srcB=dataReg} — no temp, the data is the register source (which OperationDecoder
    placed in the srcB EASRC slot). No int dst, no NZVC (MOVE to memory writes no
    flags). Mem-to-mem MOVE and RMW-to-mem (ALU op with a memory dst) stay
    unimplemented. dstOk now admits a crackable MOVE store.
    CrackStoreSpec covers (An)/(d16,An)/(xxx).W stores + the deferred RMW/mem-to-mem
    cases.
2026-06-03 decode: expansion queue between decode and rename
    DecodeStage now cracks both decode slots into 1-2 µop sequences, packs them in
    program order into the MicroOpQueue (up to 4 µops/cycle in, compacted by the
    slot0 count), and exposes the queue's 2-wide drain as DecodeUopService.uops +
    uop1Valid. feed.ready gates on queue.push.ready; the queue replaces the old 1:1
    PipeStage skid and is flushed by pipeFlush (sibling-driven from RedirectService.
    doFlush). Rename consumes the queue output unchanged.
    DecodeCrackPipeSpec: a memSimple load surfaces as load+op in program order on
    the rename stream. DecodeStageSpec/RenameStageSpec and ExecuteLockStepSpec
    (branch recovery through the queue) still gre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
2026-06-03 decode+ls: end-to-end memory lock-step (load/store programs); synth 203.9MHz (<250 GATE NOT MET)
    THE MILESTONE (functional): the cracked load/store µops feed the LS cluster and
    Musashi-lock-step over load/store programs (green x2 deterministic):
    - store then load-back (D1 == stored value; SQ-forward) + final memory check
    - two cracked loads + add (D2 = 10 + 20 = 30) + final memory check
    - load -> ALU -> store (loaded value flows through an ALU op into a store;
    temp dataflow via the LS dynamic-completion wakeup) + final memory check
    ExecuteLockStepSpec 13/13 green x2; make test-fast 58/58; test-verilator 124/124.
    Wiring: LS cluster (LsEuPlugin + DcachePlugin + StoreQueue + DIdentityTr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
2026-06-03 execute/ls: register LS completion+writeback stage (FMax 203.9 -> 227.4 MHz)
    The LS critical path was the IDLE-cycle combinational arc
    s1Va -> s1Paddr -> SQ-fwd compare / D-cache hit-detect -> doWriteback
    -> completionPort.valid -> RobPlugin.completes
    (21 levels, 72% route, WNS -0.905 / 203.9 MHz).
    Fix: capture the decision result (forward-hit data / store / refilled-load data)
    into registers (compValid/compRobId/compData/compPdst/compPdstValid/compIsLoad/
    compDstArch) in the decision cycle, and drive completionPort/intW/intByp/wakeup/
    wbObs from those registers the NEXT cycle (one mux level: reg -> port). This splits
    the long arc into two short ones at the cost of one extra comple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
2026-06-03 iq: pipeline issue->regfile-read boundary + retime wakeup
    Cut the shared FMax-critical backend arc (IssueQueue issue-select ->
    OHMasking -> MuxOH(contexts) -> uop.psrcA -> IntRegFile read-addr -> read
    -> EU S0 -> s1*_reg, 16 levels / 72% route) by inserting a REGISTERED
    issue stage on every IQ issue port.
    - IssueQueuePlugin: introduce internal combinational select streams
    (selPorts); all IQ bookkeeping (slot.fire / static-latency-1 `events` /
    scoreboard busy-clear / count `issued`) keys off selPorts at SELECT
    time. The external issuePorts are selPorts piped through m2sPipe
    (collapsBubble=false, flush=flushSignal), so each EU reads the PRF off a
    REGISTERED address, not the select c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
2026-06-03 ls: pipeline SQ-forward->completion decision (>=250MHz: 237.3->260.6 MHz)
    Register the 8-entry SQ overlap-compare + youngest-full-overlap reduce result
    (hit/data/stall) for a load in the decision cycle and drive the completion
    capture from those registers the next cycle (new RESOLVE state). This splits the
    s1Va_reg -> s1Paddr -> SQ-fwd-compare -> compData_reg/CE critical path
    (17 levels, 70% route, WNS -0.214) into two short stages.
    Safe under single-outstanding (issue.ready := !busy && !s1Valid && !compValid):
    at most one LS uop is in the forward/resolve stages, and the s1 context (hence
    the SQ query) is held stable (busy) across the registered query and its RESOLVE
    use. Adds one load-late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
2026-06-03 ls: misaligned/line-/page-crossing access (two-access-slot) + lock-step + synth >=250MHz
    SQ dual-slot forward: a clean full-forward requires the YOUNGEST overlapping
    store to fully cover the query (single youngest-overlap reduce tree) -- a younger
    partial store (e.g. a split store's slot B) blocks the stale forward and stalls.
    This single-tree formulation also recovers FMax (the serial best.dist dependency
    regressed to 205MHz; restructure -> 254.58MHz).
    Synth gate: 0 err / 0 crit-warn / WNS +0.072ns / FMAX 254.58MHz.
2026-06-03 mmu: DtlbPlugin (TLB+walker behind DTranslationService) + LS integration
    - DTranslationService gains rsp.ready (DTLB-miss stall) + req.valid/write.
    - LS EU is the translate-at-execute requester (loads + stores); D-cache reads
    the response and gates load acceptance on rsp.ready (miss stalls on the
    existing single-outstanding path).
    - DtlbPlugin: mmuEnable(default off)/rootPtr regs, banked TLB lookup, walker on
    miss, speculative fill, fault flagged; MMU-disabled = identity passthrough.
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2026-06-03 mmu: D-side TLB + table-walk + U/M deferred-writes; lock-step + synth >=250MHz
    - ExecuteLockStepSpec: MMU-enabled directed non-identity lock-step (store/load at
    translated PA, TLB-miss-then-hit, M-bit at commit) + non-resident fault-flag test
    (Musashi exposes no 040-MMU config -> directed-PA oracle, documented).
    - LS EU: hold s1Valid while a DTLB walk resolves (translate-at-execute miss stall
    reuses the single-outstanding path; the pre-update-busy S0->S1 advance would
    otherwise drop the waiting access).
    - Gates: test-fast 58/58, test-verilator 155/155; OOC synth 0 err / 0 crit-warn,
    WNS 0.099ns / FMAX 256.34MHz (TLB lookup not on the critical path).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
2026-06-03 move: MOVE to/from memory sets CCR (NZVC) — impl (a) LS-EU NZVC writeback
    MOVE (all sizes) sets N/Z from the moved value and clears V/C, INCLUDING
    MOVE to memory. The cracked memory-MOVE store path hard-coded writesNzvc:=False
    ("MOVE to memory writes no NZVC" — wrong): N/Z moves to memory left CCR stale
    vs Musashi (masked before by positive-nonzero test data).
    Fix (implementation choice (a)):
    - MicroOpAssembler: the cracked STORE µop now carries writesNzvc:=True, so
    rename allocates it a unique pNzvcDst (no collision with the ALU NZVC writers).
    - LsEuPlugin: add a 2nd NZVC PRF write port + bypass; compute N (sign bit at the
    access size) and Z (value==0 over the size's bytes) off th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
2026-06-04 exception: commit-side format-$0 entry FSM (stack + vector + redirect)
    ExceptionUnit (instantiated in the ROB commit area) is a serializing FSM: at a
    faulted head retire it sets S=1/clears T, stacks the 68040 format-$0 frame
    (SR, PC, format/vector word) to SSP-8 via the D-cache store port one word at a
    time (ack-gated), loads the handler vector mem[VBR+vec*4] via the D-cache load
    port, and redirects fetch to it (ORed into the registered doFlush). The ROB
    squashes younger work + blocks alloc/retire while the FSM runs (excActive).
    Per-entry faulted/isRte/faultVector/faultPc live in RegInit Vecs (mirrors
    mispredictStore) so an uninit-Mem field can never spuriously trigger.
    Also fixes a latent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
2026-06-04 ls/mmu: pipeline DTLB-lookup->SQ-forward + VIPT pre-translated cache tag; MMU-active >=250MHz
    Split the post-MMU critical path (LsEuPlugin fsm_stateReg -> fwdData, 25 levels,
    6.349ns / 157MHz with mmuEnable live) into registered stages:
    1. LS EU translate stage (XLATE): register the translated physical address
    (s2Paddr/s2PaddrB + fault) BEFORE the StoreQueue overlap-compare / store-alloc.
    The DTLB hit-path lookup (s1Va -> banked way-mux -> ppn) is no longer in series
    with the 8-entry SQ reduce that feeds fwdData. Identity (MMU-off) flows through
    the same register so both modes are pipelined uniformly. One extra translate
    cycle on the single-outstanding LS pipe (lock-step is l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
2026-06-04 oracle: 68040 software MMU + format-$7 access-fault delivery + RTE (MAME-matched)
    Port MAME's m68040 access-fault model into the Musashi oracle so it is the
    byte-for-byte reference for the RTL's format-$7 page-fault delivery:
    - m68kcpu.h: m68ki_stack_frame_0111 (format-$7, 30-word frame) + dispatch it
    from m68ki_exception_bus_error for the 68040 (SR/PC/0x7000|vec<<2/EA/SSW/
    faultAddr + zero internal fields), mirroring MAME exactly.
    - m68k_in.c: RTE case 7 (68040 access error) - restore SR/PC, pop the 30-word
    frame, resume (re-execute the faulting instruction); ported from MAME.
    - m68k_ref.{h,cpp}: 68040 software MMU (3-level long-format walk matching the
    RTL TableWalker) translating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
    [m68k_ref.cpp, m68k_ref.h, musashi_run.cpp]
2026-06-04 rob/ls: capture MMU access fault (vector 2 + faultAddr + SSW attrs)
    LS EU: an access that takes a DTLB rsp.fault completes as a FAULT - it
    writes no register / allocs no store / wakes nothing, and drives a new
    faultCompletion Flow {robId, faultAddr=VA, write, sizeBits, supervisor}
    (registered alongside the comp* stage). RobPlugin consumes it like
    branchCompletion: marks the entry faulted vector 2 + records faultAddr +
    SSW attrs in RegInit per-entry Vecs (reset per-alloc). The faulting instr
    PC is already captured per entry at alloc, so exceptionPc holds it. New ROB
    outputs exceptionFaultAddr/Wr/Size/Sup feed the format-$7 stacker (Task 2).
    AccessFaultCaptureSpec: LS-EU half (faulting store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
2026-06-04 exception: RTE from format-$7
    RTE reads the stacked format word @base+6 (new R_FMTREQ/R_FMTWAIT states); top
    nibble 7 => format-$7 access fault -> pop 60 bytes (SSP += 60) instead of 8.
    SR/PC restored as before; the stacked PC is the faulting instruction's PC so RTE
    RESUMES by re-executing it (the handler has fixed the mapping), matching MAME's
    RTE case 7. Format-$0 RTE unchanged (pops 8).
    RteFormat7Spec: preload a $7 frame at SSP (format word 0x7008), RTE -> SR/PC
    restored, SSP += 60, redirect to the faulting PC. RteSpec ($0) still green.
2026-06-04 mmu/exception: format-$7 page-fault delivery wiring + lock-step vs MAME 040
    Full-core integration of the format-$7 access-fault path:
    - LsEuPlugin.faultCompletion -> RobPlugin.lsFaultCompletion wired in the lock-step
    BackendWiringPlugin + top/FullCoreSynth.
    - ExceptionUnit: frame stores are IDENTITY supervisor PHYSICAL accesses -> issue
    EXACTLY ONCE (driveStoreNoXlate; no DTLB req / no dtRsp.ready gate). With the MMU
    LIVE the frame VPN walks; gating the store on dtRsp.ready re-pulsed the registered
    store every wait-cycle (57-94 pulses for 30 words, seed-dependent) and corrupted/
    double-stacked the frame. Now deterministic 30 pulses. SSW supervisor bit comes
    from the faulting cont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
    [m68k_ref.cpp, musashi_run.cpp]
2026-06-04 mmu: ItlbPlugin (instruction-side TLB + table-walker)
    Mirror DtlbPlugin behind the I-side TranslationService, reading the
    shared MmuControlService: a banked Tlb + a SEPARATE TableWalker with a
    dedicated AXI read port to the (shared) page table. Hit -> 1-cycle
    ppn/perms; miss -> walk -> fill -> resume (the I-cache now stalls fetch
    on !xlate.rsp.ready and emits a fault placeholder on xlate.rsp.fault);
    non-resident/supervisor -> rsp.fault. Fetch is a READ -> sets descriptor
    U only (no M), reusing the U-write queue. MMU-off => identity passthrough
    (existing tests unchanged). Replaces IdentityTranslationPlugin in the
    synth top + lock-step full core; the single 68040 MMU translates BOTH I
    and D, s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
2026-06-04 oracle: 68040 instruction-fetch fault + format-$7 (SSW instr), MAME-matched
    Extend the grafted MAME-040 software MMU to translate + fault on
    INSTRUCTION fetch: a g_mmu_instr_fetch flag set around the opcode
    prefetch (m68ki_read_imm_*) routes the read through mmu_translate_ex
    with instr=1, selecting a separate instruction-translate window
    [instr_lo,instr_hi) and a PROGRAM-space fault SSW (FC bit1, R/W=read).
    The flag is cleared before m68k_pulse_bus_error so the frame stacking +
    vector fetch run as data (the longjmp skips the inline reset).
    ItlbFaultOracleSpec: a jump to a non-resident I-page stacks a format-$7
    frame with SSW=0x0506 (in_mmu|super-program|read), EA/fault=0x6000.
    Data-fault ora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
    [m68k_ref.cpp, m68k_ref.h, musashi_run.cpp]
2026-06-05 mmu: ITLB instruction-fetch-fault delivery; lock-step vs MAME-040 (synth <250: BLOCKED)
    Task 5 functional deliverable. Two MMU-enabled ITLB lock-step programs vs
    the extended MAME-040 oracle, byte-for-byte ($7 frame) + step-for-step
    (PC/SR/A7):
    (a) code at a NON-IDENTITY instruction mapping (ITLB miss->walk->fill);
    (b) a non-resident I-page -> format-$7 (SSW program-space 0x0506) ->
    handler maps -> RTE -> resume.
    Real RTL bugs fixed to make (a)/(b) pass:
    - IcachePlugin: refill from the TRANSLATED PHYSICAL line base (was the
    virtual address; broke any non-identity I-mapping).
    - FetchAlignPlugin: I-fetch-fault hold — emit ONE faulted DecodePacket
    (pc/EA = the architectural fe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
2026-06-05 icache/itlb: VIPT pre-translated tag + registered ITLB paddr; MMU-live >=250MHz
    With a real ITLB the I-cache VIPT hit cone contained the live ItlbPlugin
    rsp.ppn (a Tlb way-mux + walk/latch mux) in series with the tag-compare ->
    hit -> dataMem ENARDEN / s1Pred arc -- the route-dominated post-ITLB limiter
    (WNS -0.777 / 209MHz, MMU live). Apply the same recovery the D-side used in
    24d68ec (registered pre-translated cache tag):
    1. Registered ITLB-translate (T) stage: the fetch is accepted into a dedicated
    register once the ITLB has RESOLVED the translation; {ppn, pc[11:0]} + fault
    are captured into tPaddr/tFault. The I-cache hit-detect now tags on the
    REGISTERED physical paddr (tPaddr[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
2026-06-05 frontend-fmax: register FetchAlign→DecodeStage boundary (split the standing decode-queue arc)
    The honest full-core MMU-live synth straddled the 250MHz gate on placement
    variance: the standing limiter was the route-dominated (≈80% route, 13 LL)
    combinational arc
    FetchAlignPlugin ibuf/count_reg → DecodeStage queue ring_*_branchDisp_reg/CE
    i.e. InstructionBuffer.count → Aligner predicated-length/branchDisp select →
    MicroOpAssembler → MicroOpQueue ring write-enable, all combinational across the
    FetchAlign→DecodeStage plugin boundary.
    Fix: insert a 1-deep registered skid (PipeStage) at that boundary inside
    DecodeStage. The feed payload + slot1Valid are packed into one FedPack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
2026-06-05 execute/rob: TRAPV execute-time conditional trap (vector 7 if V)
    TRAPV (0x4E76) decodes to a branch-class trap-check uop (isBranch+readsNzvc,
    isTrapv) that issues to the branch EU. At execute the EU reads NZVC(V): if V=1
    it drives a new trapvFault completion (carrying faultPc=nextPc); the ROB flips
    the entry faulted + vector 7 (mirrors lsFaultCompletion). If V=0 the uop
    completes as a no-op and retires. TRAPV is not a branch redirect (mispredict
    forced false; commit nextPc = the uop's nextPc).
    The 68040 stacks a format-$2 frame for group-2 traps (Musashi
    m68ki_stack_frame_0010), so the ExceptionUnit gains a 6-word format-$2 path
    {SR, PC(=nextPc), 0x2000|vec<<2, PPC(=pc)} (frameBase = SSP-12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
2026-06-05 traps: TRAP #n + TRAPV; lock-step vs Musashi; honest synth >=250MHz
    Lock-step (vs the 68040 Musashi oracle, PC/SR/A7 + frame step-for-step):
    - TRAP #5 -> handler -> RTE -> resume (format-$0, stacked PC = nextPc).
    - TRAPV with V set -> handler -> RTE (format-$2 frame, A7 -= 12).
    - TRAPV with V clear -> falls through (no trap).
    All existing lock-step programs UNCHANGED.
    Two real bugs fixed while bringing these up end-to-end:
    - PredecodeWord had no line-4 case -> TRAP/TRAPV predecoded len=0 -> nextPc=pc ->
    wrong stacked PC. Predecode TRAP(0x4E4x)/TRAPV(0x4E76) as simple len-1.
    - Stacked-PC select: replaced the 32-bit DecodedUop/RenamedUop faultPc field with a
    1-bit faultUsesNextPc f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
2026-06-05 dcache: diagnose exc-FSM->dataMem store-RMW binding path (Task 1)
    WNS +0.009 / 250.6 MHz; 14 logic levels; route 71.7%.
    Worst path (synth/M68kFullCoreSynth_timing.rpt:204-278):
    Source: RobPlugin exc_fsm_stateReg[3]/C
    Dest: DcachePlugin dataMem_0 spinal_port1_reg[0]/D (dist-RAM write-data reg)
    Trace of the 14 levels:
    exc_fsm_stateReg[3] -> DtlbPlugin walker reqReg_{isWrite,isSuper,vpn}
    -> DTLB tlb hit compute (CARRY8 tag compare, hitVec)
    -> tlb_io_hit -> dataMem_3_spinal_port1[127]_i_4
    -> missPaddr[31]_i_3 -> loadCmdPort_fire
    -> dataMem_0_reg_r2 (RAMD64E: the readAsync of the OLD line, dist-RAM)
    -> dataMem_0_spinal_port1[0]_i_1 (the 16-lane byte merge mux)
    -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
2026-06-05 dcache: pipeline store RMW into S0(read)/S1(merge+write)
    Split the single-cycle store read-modify-write into two stages to lift the
    binding exc-FSM -> dataMem store-write path off the critical list:
    store-S0 (on storePort.valid): latch {mergeData, mergeStrb, set, per-way hit,
    per-way old-line readAsync, axi line addr} into RegInit-guarded flops at the
    cache boundary; also latch the AXI write-through payload (aw/w fire next cycle,
    unchanged timing).
    store-S1 (next cycle): byte-merge the registered old line with the registered
    store bytes and drive the dataMem write port -- a local cone from flops at the
    dataMem; the long exc-FSM/DTLB route now ends at the S0 latch.
    P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
2026-06-05 interrupts T1: diagnose recognition boundary + entry plumbing
    Task 1 (read-only diagnosis). Findings:
    (a) MACRO-INSTRUCTION-BOUNDARY MARKER. The cracker (MicroOpAssembler) emits
    1 or 2 uops/instruction. The ONLY 2-uop case is crackLoad -> [loadUop, opUop]
    (a memSimple EA source). Every other instruction (incl. crackStore, illegal,
    RTE, TRAP, TRAPV, fetch-fault) is a SINGLE uop. The 2-uop sequence's FIRST uop
    is the LOAD (memOp === MemOp.LOAD, cluster LS); the architectural op is its 2nd.
    RenamedUop/ROB do NOT carry a first/last-uop flag, but both uops of an
    instruction share the SAME pc and nextPc (set in MicroOpAssembler:nextPc, copied
    to ldUop/opUop). The ROB head is the FIRST uop of an i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
2026-06-05 io: add iplIn + iackAvec/iackVector inputs (live OOC in FullCoreSynth)
    InterruptControlPlugin (mirrors MmuControlPlugin): holds iplIn(3b)/iackAvec/
    iackVector(8b) as RegInit 0 (idle), simPublic, published via the new
    InterruptControlService. The ROB reads it (host.get -> idle default if absent).
    FullCoreSynth drives the three regs from RegNext(in...) init 0 registered OOC
    inputs (iplInPort/iackAvecIn/iackVectorIn) so the IPL-compare + vector-select
    cone is LIVE (not const-folded). Added to FullCoreSynth + the lock-step DUT.
    Also thread the macro-instruction-boundary marker firstOfInstr (DecodedUop ->
    RenamedUop): True for the first µop of an instruction; the cracker sets it False
    only on t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
2026-06-05 interrupts: lock-step vs Musashi (autovector/vectored/masked/NMI/nested)
    Oracle: extend the trace loop (musashi_run.cpp) to apply PC-scheduled irq_events
    at instruction boundaries with one-shot-edge semantics (set_irq(level) at the
    event PC, drop on the next iteration; cb_int_ack also auto-clears) so a level-
    triggered re-fire after RTE doesn't loop. Add --initial-sr (override the post-reset
    SR, e.g. lower the I-mask so a non-NMI level is taken). assembleAndTrace/
    assembleAndRun gain irqEvents/interruptAckVector/initialSr params.
    DUT driving (runIrqLockStep): raise iplIn=level the cycle the predecessor of the
    event PC commits (commitObs.pc==eventPc), matching the oracle's set_irq at PC==
    ev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
    [musashi_run.cpp]
2026-06-05 interrupts: full regression + honest synth >=250
    RobInterruptSpec: poll for the interruptPending 1-cycle pulse (awaitPending /
    assertNeverPending helpers) instead of a fixed-cycle check -- the pulse is
    backend/seed-timing-sensitive (the exc-FSM goes active the next cycle and
    re-suppresses it), which made the "should-fire" cases flaky under the plain sim
    backend. Deterministic across seeds now.
    Full regression (this branch):
    - make test-fast: 81/81 green (80 suites).
    - make test-verilator (-Xmx12g, alone): 194/194 green (80 suites), 0 failures
    -- includes the full ExecuteLockStepSpec (all existing memory/MMU/format-$0/
    $2/$7/trap/ITLB/RTE programs UNCHANGED with iplIn=0, plus the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
2026-06-06 bench: IPC microbenchmark harness + kernels
    Stand up a cycle-accurate IPC measurement harness for the 2-wide OoO 68040.
    Reuses the full-core Verilator DUT + WhiteboxCapture (macro-instruction count,
    cracked-load temp dedup) from the lock-step infra; adds a free-running cycle
    counter and a per-cycle macro-commit histogram over a steady-state window
    (first-commit .. last-commit, fill/drain excluded).
    Five kernels (implemented opcode/EA set only, MMU off): dependent-ALU,
    independent-ALU, load/store (unrolled), branchy (ALU loop), mixed. Prints a
    per-kernel + aggregate table: retired-instrs | cycles | IPC | dual-issue%(act/win)
    | active%.
    FINDING (real, measured): independent-ALU IPC (~0.80) d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
2026-06-06 rename: fix RAT multi-write Mem dropping slot-0 writes (loop+memory deadlock)
    A backward-branch loop containing a memory op diverged/wedged after the
    first taken loop-back redirect. Root cause is NOT in the LS pipe/flush:
    it is the Register Alias Table.
    RatTable stored spec/commit mappings in 2-write-port + readAsync Mems.
    A multi-write async-read Mem whose write ports BOTH address the same cell
    (which the 1-entry flag RATs always do — archDepth=1, addr hardwired to 0)
    was not modelled correctly: write port 0 (slot 0) was silently dropped;
    only the highest-numbered write port ever updated the cell.
    A body load cracks into [load->T0, move T0->Dn]; the flag-setting move
    pairs with the load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
2026-06-06 div: unsigned radix-2 multi-cycle divider datapath
    Task 3: DivCore — a standalone unsigned sequential divider (radix-2 restoring; the
    per-cycle path is one 33-bit trial-subtract + a 2:1 mux, shallow enough that FMax is
    dominated elsewhere — restoring chosen over non-restoring for verifiability, same
    depth class; the spec allows the agent's radix choice).
    - 64-bit unsigned dividend / 32-bit unsigned divisor -> full 64-bit quotient + 32-bit
    remainder over 64 fixed iterations; divisor==0 short-circuits with divByZero (no
    iteration). Single-outstanding: pulse `start`, `done` pulses when finished.
    - Overflow + sign are NOT decided here (they depend on the form + sign) — the EU
    narrow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
2026-06-06 div: DIVU.W/DIVS.W decode+EU integrate+writeback+flags+DIV0
    Task 5: DIVU.W/DIVS.W (32/16 -> Dn={rem16,q16}) end-to-end, lock-stepped vs Musashi.
    Decode:
    - OperationDecoder: DIVU.W = line 8 opmode 3, DIVS.W = line 8 opmode 7 (BOTH DIVs are
    line 8; BOTH MULs are line C — corrected from an initial line-mix). DIV -> CPLX
    cluster, dividend Dn (srcA), 16-bit divisor EA (srcB), Dn dst, writesNzvc, divSigned.
    - PredecodeWord + PredecodeRef: DIVU.W/DIVS.W (line 8 opmode 3/7) AND CHK (line 4
    bit8=1 bit6=0) now classify SIMPLE with the correct length (1 + EA ext words);
    MULU/MULS (line C) stay complex. Without this they were predecoded complex -> the
    assembler's `bad` path marked them ille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
2026-06-06 div: DIVU.L/DIVS.L 32/32 (quotient-only + remainder:quotient via DIV+DIVREM crack)
    Task 6: the 32/32 .L forms, lock-stepped vs Musashi.
    Decode (MicroOpAssembler, line-4 extension-word form):
    - DIV.L opword 0100 1100 01 mmmrrr (op[15:6]==0x131); ext word words(1): Dq=ext[14:12],
    signed=ext[11], size64=ext[10], Dr=ext[2:0]. The 32-bit divisor EA is re-decoded at
    LONG size (immediate divisor = 2 ext words). Quotient-only (Dr==Dq) -> 1 DIV µop;
    remainder (Dr!=Dq) -> CRACK into [DIV -> Dq] + [DIVREM -> Dr]. An unsupported
    (memSimple) divisor -> illegal (vector 4).
    - 3rd physical source psrcC threaded decode->rename->IQ->DivEu for the 64-bit dividend
    high word (Dr, used by T7); rename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
2026-06-06 divider+chk+div0: lock-step + honest synth >=250
    Task 8: full lock-step vs Musashi + the honest MMU-live synth gate.
    LOCK-STEP (verilator, run in OOM-safe batches; x2 seeds confirmed stable):
    - ALL 53 ExecuteLockStepSpec programs PASS, including every PRE-EXISTING program
    UNCHANGED (moveq/ALU/cmp/move chains, branches + backward loops, LS store/load + SQ
    forward + cross-line/page, MOVE-CCR, MMU store/load + page-fault + ITLB, illegal/
    TRAP/TRAPV/RTE, 5 interrupt programs).
    - NEW DIV/CHK programs (10 div + 3 chk): DIVU/DIVS .W normal+overflow+DIV0; .L 32/32
    quotient-only + remainder:quotient (cracked DIV+DIVREM, both remainders verified) +
    DIV0; .L 64/32 (Dr:Dq) normal + signed-neg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
2026-06-06 fix: IQ static wakeup for the branch port (RTS/RTR A7 producer) + test-source uop fields
    The RTS/RTR ibranch is now a latency-1 INT producer (it writes A7 via the branch
    EU's int write port). The IQ's static-latency-1 wakeup `events` covered only the two
    ALU ports, and the on-issue sbInt.busy clear covered only ports 0/1 — so a consumer
    of the post-RTS/RTR A7 (e.g. `rts` then an A7-relative access) would set a static
    trigger on the branch slot that never cleared (branch fires on port 2) -> hang; and a
    later push could record a stale trigger on the already-issued branch slot. Add ohB
    (branch port) to `events` and clear sbInt.busy for the branch's int pdst on issue.
    (A plain branch has no in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
2026-06-06 call-return: lock-step + honest synth (FMAX 250.9, WNS +0.015, 0 err/crit)
    Task 6. DecodeStage FMax: stash the DECODED slot1 µops (registered) for a deferred
    3-µop RTR-in-slot1 instead of a SECOND MicroOpAssembler.assemble — removes a duplicate
    decode cone from the decode->MicroOpQueue push arc (congestion relief: 274->260 synth
    warnings).
    Lock-step vs Musashi x2 seeds (targeted -z subsets, no OOM): BSR...RTS round trip,
    nested BSR, JSR via (An)/(d16,An)/(xxx).L/(d16,PC), JMP x4 modes, RTR (CCR+PC, A7+=6),
    bsr-push isolation. ALL existing programs UNCHANGED: alu/branch/loop/store/load/cross/
    mmu/misalign/MOVE-flags/two-ld/ld-alu (32), DIV/CHK/TRAP/illegal (17), IRQ x5 — all
    PASS. test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
2026-06-06 synth: post-route FMax gate flow for the FullCore (impl_FullCore.tcl + _perf)
    The OOC synth_design gate is ~15-25 MHz optimistic vs real place&route AND names the
    wrong limiter. Real FullCore post-route is ~235-243 MHz (default -0.108/243.4; perf-
    directive -0.250/235.3 with the limiter moved exc_fsm->dataMem) — several cones cluster
    ~235-245. Gate feature slices on post-route going forward; OOC = fast dev proxy only.
2026-06-06 mul T1: diagnose EU-fold vs separate; .L64 MULHI crack; DSP inference
    Decisions for the MULU/MULS slice (read-only diagnosis):
    (a) EU choice: FOLD MUL into DivEuPlugin (the existing CPLX EU), not a
    separate MulEuPlugin. Rationale (lowest churn, no cone worsening):
    - The IQ already routes cluster==CPLX to issue port 4; isCplxProducer
    = isCplx && pdstValid already covers a MUL (CPLX + writes pdst), so
    MUL needs ZERO IssueQueue changes — it reuses the cplxBusy/cplxWakeup
    dynamic-completion scoreboard verbatim.
    - The ROB/BackendWiring already wire DivEu.completion(3)/wakeup/wbObs/
    euFault. Folding MUL into the same plugin reuses all of it; a separate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
2026-06-06 mul: MULU.L/MULS.L 32x32->64 (Dh:Dl)
    Wire the .L64 form (ext bit10=1): the decode crack [MUL -> Dl] + [MULHI -> Dh]
    (built in T4) now emits 2 µops via the sequence selector. The EU latches the
    high product at MUL done (mulHiLatch); the trailing MULHI µop writes it to Dh
    from the latch (no re-multiply), mirroring the DIVREM remainder-move. Single-
    outstanding age-ordered CPLX issue keeps the latch valid between the pair.
    Flags for .L64: N from Dh[31], Z from (Dh|Dl == 0) over the full 64-bit product,
    V=0, C=0 — the MUL µop (which has both halves at done) sets them; MULHI sets no
    flags. The .W/.L32 N/Z stay low-32-derived (V=overflow for .L32 only).
    Lock-step vs Musashi: MULU.L 64-bit (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
2026-06-07 dcache: fix load fault flag must ride ONLY a hit (miss always refills)
    Root cause of a page-fault lock-step regression: after the sync-read
    restructure I let the load response fire on (ldS1Hit || ldS1Fault) and gated
    the miss->REFILL on !ldS1Fault. That made a load that MISSES while
    xlate.rsp.fault is set short-circuit to a garbage fault response (rdData(0))
    instead of refilling. The exception FSM's RTE frame-pop loads (resident
    supervisor-stack page, line not yet cached) carried a transient rsp.fault and
    so returned garbage -> RTE restored a corrupt SR/PC -> spurious re-fault loop
    that overwrote the just-stacked frame (frame SR read back 0x0000).
    Baseline semantics (now matched exactly): a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
2026-06-07 dcache-bram T4: lock-step unchanged + BRAM inference confirmed
    Lock-step (x2, isolated to avoid the pre-existing ITLB-b seed flake — repro'd
    on baseline 8ae3afc): page fault, MMU fault (rsp.fault flagged), MMU translated
    x2, RTE x12, IRQ x5, store-then-load / load-back x5, SQ-forward x2, loop
    load/store, two-loads, load->ALU->store, drain race, overlapping long, immediates
    TO/FROM memory — ALL pass, behavior identical. make test-fast: 87/87.
    BRAM inference (OOC synth, xcku5p, GenFullCoreSynthVerilog):
    RAMB36E2 : 16 -> 24 (+8: the 4 dataMem ways + 4 tagMem ways now BRAM)
    RAMD64E : 6932 -> 4372 (-2560 LUTRAM cells: D-cache dataMem+tagMem gone)
    No DcachePlugin readAsync warning rem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
2026-06-07 dcache: keep the load-accept/DTLB cone OUT of the BRAM read-address net (FMax)
    The first sync-read cut moved the worst post-route path onto the shared read-
    address: the store read-port arbiter gated rdSet/rdEn (a fo~130 net feeding
    every dataMem+tagMem BRAM read port) on loadUsesPort, which imports
    loadCmdPort.fire => xlate.rsp.ready (the DTLB-walker cone). New limiter
    valids -> DTLB walker -> loadCmdPort.ready -> arbiter -> tag/dataMem read-addr
    at WNS -0.805 (208 MHz), WORSE than master.
    Fix: the store drives the read address as the BASE (off the REGISTERED
    stS1Payload, a clean flop->BRAM-address arc); the load FSM OVERRIDES rdSet/rdEn
    LAST on accept/REPLAY (load keeps priority, last-ass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
2026-06-07 sq-forward-fmax T1: diagnose forward cone + pre-register plan
    Binding post-route cone (POSTROUTE_250_ANALYSIS.md path #2): LsEu s2Paddr ->
    fwdData, 14 levels w/ 4x CARRY8 = the SQ 8-entry overlap+age search. The adders
    are per-entry, in the forward cone:
    StoreQueue.scala:155 aHi = paddrs(i) + nbytesAs(i) (slot A, x8 entries)
    StoreQueue.scala:159 bHi = paddrBs(i) + nbytesBs(i) (slot B, x8 entries)
    qHi = q.paddr + qBytes (:153) is a single load-side adder (computed once), not
    per-entry; the per-entry aHi/bHi are the CARRY8 cluster.
    Plan: pre-register paddrHiA/paddrHiB into SQ entry regs at alloc
    (= paddr + nbytesA, paddrB + nbytesB), moving the adders OUT of the forward
    cone (alloc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
2026-06-07 sq-forward-fmax: lock-step unchanged + POST-ROUTE result vs master
    Lock-step vs Musashi on the BRANCH, x2 seeds: ALL forward/store/load programs
    UNCHANGED — st-ld (load-back / sameline / sub-word), line/word/page-misalign
    store->load-back, line-crossing store->overlapping load, loop-store,
    MOVE-to/from-mem (NZVC), MMU store->load + load->ALU->store, two-loads+add,
    bsr/jsr...rts call-return stack, drain-race probe. No ITLB flake observed.
    Directed StoreQueue{,Split}Spec 10/10 x2; make test-fast 87/87.
    POST-ROUTE (impl_FullCore.tcl, OOC, 250MHz target, SAME flow both sides):
    master 255787e : WNS -0.435 ns (225.5 MHz) top = IssueQueue->sbX_busy
    branch : WNS -0.453 ns (224.6 MH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
2026-06-07 shifts: line-E decode + immediate count + ALU integrate
    - DecOp.SHIFT + shiftOp/shiftDir fields on DecodedUop/RenamedUop (threaded via
    RenameStage); OpSpec gains shiftOp/shiftDir/shiftImm.
    - OperationDecoder line E (1110 ccc d ss i tt rrr): SHIFT op, size from ss
    (ss=11 memory form -> illegal/deferred), shiftOp=tt, shiftDir=d, shiftImm=!i,
    writesNzvc, writesX/readsX for AS/LS/ROX (NOT RO).
    - MicroOpAssembler: fixed-field operand routing srcA=dst=Dr (op[2:0]); imm form
    -> useImm/imm = ccc (0->8); reg form -> srcB=Dc (op[11:9]).
    - AluEuPlugin: route SHIFT through the barrel Shifter (count = src2[5:0] = imm or
    Dc; xIn = current X); size-merge result (Dr=src1 upper-preserve); NZVC/X wr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
2026-06-07 dtlb: register the miss->walker trigger (sever the Dcache valids->walker cone)
    The worst post-route cone (WNS -1.206, the gate-failer) was the live trigger
    Dcache valids -> LsEu -> _req.vpn -> tlb hitVec -> walker fsm clock-enable. The
    walker has its own AXI port; the coupling is purely the trigger chain.
    Capture {vpn,write,supervisor,robId} into missReqReg flops on the needWalk cycle
    and drive walker.io.req/.start from those flops one cycle later. The deep
    hitVec/valids cone now ends at missReqReg; the walker is driven from registers.
    Single-outstanding preserved: missReqReg.valid is a 1-cycle pulse; needWalk
    already gates on walker-idle + the !done/!latchMatch anti-respin, and capture is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
2026-06-07 shifts-rotates: lock-step + OOC sanity
    - Lock-step (correctness gate) x2 seeds: line-E register-form shifts/rotates
    (all 8 ops, imm + register count, .B/.W/.L) green over two independent seed
    passes (12 distinct seed-runs). Flag-edge operands: shift-out-1, ASL-V
    sign-change, ROX-through-X, count 0, count>=size, Dc mod-64.
    - ALL existing UNCHANGED: make test-fast 88/88 green; representative pre-existing
    lock-step programs (alu chain, ADDI/SUBI, moveq, EOR Dn) unchanged.
    - OOC-synth SANITY (proxy only; NO place&route): generated Verilog 0 UNASSIGNED
    REGISTER; synth_design 0 errors / 0 critical warnings; 60046 CLB LUTs
    (post-synth, pre-opt; barrel shifter adds some).
    Co-Authored-By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
2026-06-07 itlb: register the miss->walker trigger (sever the _req/tlbHit->walker cone)
    I-side mirror of the merged DTLB fix (commit 10ce410). ItlbPlugin had the
    IDENTICAL live-combinational walk trigger -- walker.io.req.vpn := _req.vpn and
    walker.io.start := needWalk (off the live banked tlbHit + the I-fetch-driven
    _req.vpn) -- a cross-module cone `_req/tlbHit -> ITLB walker FSM clock-enable`.
    The walker has its own AXI port; the coupling is purely the trigger chain.
    Capture {vpn,supervisor,robId} into missReqReg flops on the needWalk cycle and
    drive walker.io.req/.start from those flops one cycle later. The deep hitVec
    cone now ends at missReqReg; the walker is driven from registers. isWrite is
    cons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
2026-06-07 test: failing lock-step for MOVE.B/.W-to-Dn partial-register write
    MOVE.B/.W to a data register must preserve Dn's upper bytes (68k
    partial-register semantics). Directed lock-step vs Musashi: seed
    Dn=0x11223344, then move.b/.w (imm + reg src), verify value+NZVCX.
    Plus a MOVE.L-full / MOVEA.W/.L guard test (must stay correct).
    Currently FAILS: move.b #0xaa,d0 yields dut=0x000000aa, oracle=0x112233aa.
2026-06-07 fix: MOVE.B/.W-to-Dn partial-register write (+ MOVEA.W sign-extend)
    MOVE.B/.W to a DATA register must preserve Dn's upper bytes (68k
    partial-register semantics). Root cause: AluEuPlugin excluded MOVE from
    the .B/.W size-merge because a plain MOVE has no srcA, so the old Dn was
    not available as the merge source.
    Fix:
    - MicroOpAssembler: a MOVE.B/.W with a DATA-reg dst now READS the old Dn
    as srcA (the merge source). Rename allocates psrcA from the dest's
    current mapping; the IQ wakeup (psrcAValid) tracks the new
    partial-register dependency.
    - AluEuPlugin: drop the isMove exclusion -> MOVE uses the same .B/.W
    size-merge as ALU ops (upper bytes from s1Src1 = old Dn).
    - MOVEA (MOVE to A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
2026-06-07 line5: ADDQ/SUBQ (Dn flags + An full-32 no-flags)
    OperationDecoder line-5 ADDQ/SUBQ (0101 ddd q ss mmmrrr, ss!=11): q=bit8,
    ddd=op[11:9] quick imm (0->8) via new OperandKind.IMMQ3. Dest EA = srcA(read)
    + dst(writeback); Dn -> ADD/SUB+NZVCX (size-merged), An -> assembler forces
    size LONG + clears flag masks (full-32, no flags, like ADDA/SUBA). Memory dest
    deferred -> addqMemBad illegal (no leading-load crack). Predecode (RTL+ref):
    line-5 ADDQ/SUBQ Dn/An -> simple len1 (exhaustive 65536 sweep passes).
    Lock-step vs Musashi (x2 seeds): ADDQ/SUBQ .B/.W/.L Dn (NZVCX, flag edges) +
    An (full-32, no flags) value+flags step-for-step.
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2026-06-07 line5: DBcc decrement-and-branch (counted loop)
    DBcc (0101 cccc 11 001rrr + disp16) built in the assembler as a branch-class µop
    (isDbcc, isBranch, readsNzvc, cond=cccc, branchDisp=sign-ext disp16): reads Dn
    (psrcA, counter/merge source) + writes Dn (pdst). Branch EU DBcc path: decFull =
    {Dn[31:16], Dn[15:0]-1}; write Dn = cond?Dn:decFull (decrement only when cond FALSE,
    Dn[31:16] preserved); redirect = !cond && (decW != -1) to pc+2+disp. DBRA/DBF (cc=F,
    taken=False) always decrements.
    Branch-EU fall-through PC fix: use u1.nextPc (= pc+length) not pc+2, so a 2-word DBcc
    (and a not-taken Bcc.w) gets the correct post-PC on fall-through/expiry.
    New isScc/isDbcc fields driven in all per-field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
2026-06-07 line4-unary: lock-step + OOC sanity
    Task 4. Added 8 line-4 unary lock-step tests to ExecuteLockStepSpec (value +
    NZVCX step-for-step vs Musashi, the gate):
    CLR/NEG/NEGX/NOT/TST .B/.W/.L (flag edges: zero/negative/overflow/carry),
    NEGX with X set + BOTH Z-clear-only directions (result 0 with Z_old 0 ->
    Z stays 0; result 0 with Z_old 1 -> Z stays 1), SWAP, EXT.W/.L, EXTB.L, TAS.
    Results:
    - New line-4 unary lock-step: 8/8 PASS x2 seeds (251956325, 887141779) —
    value + NZVCX step-for-step vs Musashi.
    - Existing lock-step UNCHANGED: alu-chain/cmp/ADDI-SUBI/ADDQ-SUBQ/MOVE-partial/
    ASL-ASR/ROXL-ROXR/ANDI-ORI-EORI all PASS (no regression from the datapath
    changes). Decode specs (Decod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
2026-06-07 mem-rmw T1: diagnose load-op-store crack + same-address + EA recompute
    Read-only diagnosis (MicroOpAssembler / OperationDecoder / EaDecoder /
    LsEuPlugin / StoreQueue / PredecodeWord). Decisions:
    CRACK MECHANISM (extend the memSimple-SOURCE load crack with a trailing
    store for mem-DEST):
    - The mem-dest forms put the EA in op[5:0] -> `srcEa` (NOT dstEa; the EA is
    both the read source operand AND the writeback dst per OperationDecoder,
    dst.kind=EASRC). So load AND store both use `srcEa` (base/disp/pcRel).
    - 3 uops: [load.sz srcEa -> T0] [op (T0 with Dn/#imm) -> T1 + flags]
    [store.sz T1 -> srcEa]. AssembledUops already supports 3 (RTR/DIV64).
    - The op uop is the MIDDLE uop: srcA/srcB EASR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
2026-06-07 mem-rmw: lock-step + DecodeStage 3-µop-slot0 stash fix + OOC sanity
    REAL BUG FIX (DecodeStage): a 3-µop SLOT0 crack suppressed slot1 entirely
    ("drop it, the redirect re-fetches") — correct for RTR/RTS (they redirect, so
    slot1 is wrong-path) but the mem-dest RMW is the FIRST 3-µop NON-branch
    instruction: it does NOT redirect, so dropping slot1 silently LOST the next
    sequential instruction. Fix: when slot0 is a 3-µop crack, STASH slot1 + its
    µop count and replay it next cycle (the same mechanism already used for a 3-µop
    slot1), generalised with a stashCount register. RTR/RTS now also stash slot1
    harmlessly (pipeFlush squashes the wrong-path stash on redirect). Found via
    lock-step (a mi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
2026-06-07 iq: in-order LS issue (fix load-bypasses-older-store memory-ordering bug) + multi-RMW guard
    RECOVERED the LS-issue-ordering fix (the prior agent's commits were lost when its worktree
    was force-removed; recovered the RTL from the dangling stash 4b3508f). LS uops were issued
    operand-readiness-OoO: ohL = OHMasking.first(lsReady) picked the oldest READY LS slot, so a
    younger load (addr ready) could issue AHEAD of an older store still waiting on its data
    producer (e.g. the op of a load-op-store RMW) -> the load queried SQ-forward BEFORE that store
    ALLOCATED -> forward miss -> write-no-allocate stale refill -> DROPPED store -> wrong final
    memory (regs matched Musashi; only memory diverged -> reg-o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
2026-06-07 spec: FMax recovery — pipeline the LS-EU misalign AGU cone (s1Src2->s1AddrB, 25 levels)
2026-06-07 lseu: register the bypassed AGU base operand (s1Base) — pipeline the misalign AGU cone
    FMax recovery for the dominant OOC limiter (s1Src2->s1AddrB, 25 levels / 4x CARRY8 /
    -2.383ns). ROOT: the AGU base operand bypasses COMBINATIONALLY from the ALU EU's S1
    result (intByp -> rdBase.data) the same cycle a dependent LS uop reads it, so computing
    va0=base+disp in S0 chained the ALU adder + AGU adder + addrB=(va0&~15)+16 + cross-line/
    page compares into ONE 25-level cone across the ALU->LS boundary. FIX (standing rule:
    registered module boundaries; latency-agnostic - single-outstanding EU): latch the
    bypassed base into s1Base (the ALU->base cone ENDS at this flop); compute s1Va=s1Base+
    s1Disp, s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
2026-06-07 alu-fast-slow T1: diagnose the 24-level s1Src2->NZVC cone + pick the slow-op set
    Baseline gen+OOC synth: WNS -2.398, FMAX 156.3 MHz. All 8 worst setup paths are
    the same cone: AluEuPlugin.s1Src2 -> finalNzvc -> NZVC regfile write, 24 logic
    levels. The deep contributor is the barrel shifter (66-bit variable funnels +
    shTable + the ROX rmod subtract chain) folding into finalNzvc, threaded by the
    variable shift count (s1Src2) and useImm.
    Decision: isSlow = isShift || toCcr. Move both to a 2-cycle S1->S2 path (lat2);
    keep ADD/SUB/AND/OR/EOR/CMP/MOVE/MOVEA/imm/CLR/NEGX/EXT/SWAP on the fast lat1
    path (the aluNzvc/mergedResult dependent-chain IPC path + bypass + static wake).
    IQ: a new aluSlowBusy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
2026-06-07 alu: slow path (S1->S2) for shift + CCR-RMW (lat2)
    Split the ALU EU into a fast lat1 path (ADD/SUB/AND/OR/EOR/CMP/MOVE/imm/CLR/
    NEGX/EXT/SWAP — S1 writeback + bypass + completion, UNCHANGED, the dependent-
    chain IPC path) and a slow lat2 path (isShift || toCcr). The barrel shifter and
    the CCR-RMW — the 24-level s1Src2->NZVC cone — now register into S2 and compute
    there, off the S1 writeback cone. The slow path:
    - separate intWs/nzvcWs/xWs write + bypass ports (no contention with the fast
    S1 ports),
    - completion + a new slowWakeup Flow (pdst) broadcast at S2 (mirrors DivEu),
    - single-outstanding: a slow op in S1 deasserts issue.ready for that one cycle
    so a fast op can't e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
2026-06-08 test: wire aluSlowWakeup in the EU-stub/lock-step harnesses (slow-ALU lat2) + dep-chain test
    The ALU fast/slow split added IQ aluSlowWakeup ports (slow-ALU shift/CCR-RMW dynamic
    wakeup, lat2), wired in top/FullCoreSynth.BackendWiringPlugin. But the lock-step +
    EU-stub test harnesses (ExecuteLockStepSpec, BackendWhiteboxSpec, LsBackendInjectSpec,
    IpcBenchSpec) each build their OWN DUT wiring and left aluSlowWakeup at its setup default
    (valid:=False) -> a shift's dependents never woke -> DEADLOCK -> 'Simulation failed at
    time=41030' on the ASL lock-step (NOT an implementation bug). Wired eu0/eu1.slowWakeup ->
    iq.aluSlowWakeup(0/1) in all four. Added a slow-ALU dependent-chain lock-step test (a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
2026-06-08 test: de-rot the EU-stub harnesses (pokeUop field-init + branchEu tie-off)
    Two PRE-EXISTING harness-rot bugs (both VerilatorTest, excluded from the fastTest gate,
    so they silently rotted as later ISA slices grew RenamedUop), surfaced while validating
    the ALU fast/slow split:
    1. BackendWhiteboxSpec + LsBackendInjectSpec pokeUop helpers drove only ~half of
    RenamedUop's fields. The EU/IQ fast path READS several of the undriven ones —
    isMovea muxes the writeback to src2 (=> ADD result became src2's value, e.g. 3 not 13),
    toCcr muxes the flags, isShift routes the slow path. An undriven sim signal takes a
    nondeterministic per-netlist value (cf. the uninit-randomization gotcha), so t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
2026-06-08 alu: deepen slow path to S1->S2->S3 (lat3); stage1@S1, stage2@S2, writeback@S3; wakeup+stall for the deeper pipe
    Also fix a latent IQ aluSlowWait gap exposed by the deeper pipe: a consumer
    reading TWO in-flight shift results (e.g. sub d0,d2) must not clear aluSlowWait
    on the FIRST wakeup; gate the clear on no remaining slow dep this cycle.
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2026-06-09 decode: assemble BITOP — Dn form (LONG, mod32) + memory form (BYTE, mod8: BTST load-only, BSET/BCLR/BCHG mem-RMW crack)
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2026-06-10 spec+plan: EXG (exchange two registers) — 3-µop MOVE crack through T0, line-C disambiguation vs AND-RMW/MULU, no flags
    Design-only slice for the integer 68040 EXG instruction (EXG Dx,Dy / Ax,Ay /
    Dx,Ay). Cracks into 3 plain DecOp.MOVE µops through int temp T0 (reusing the RTR
    3-µop crack machinery + mkUop); no new DecOp, no new EU datapath. Disambiguated
    in line C by bit8=1 + opmode(7:3) in {01000,01001,10001} (reg-direct EA the
    AND-RMW path discards). Predecode frames it simple/len-1; assembler emits the
    crack and excludes EXG from the illegal path. Lock-step matrix + >=200 MHz gate.
2026-06-10 rtl+decode: LINK/UNLK cracks (stkPush reg-data + ALU crack-drop marker)
    - PredecodeWord/PredecodeRef: LINK len2 (opword+disp16), UNLK len1
    - LsEuPlugin: stkPush with a valid srcB pushes the register (LINK old An); BSR/JSR unchanged
    - AluEuPlugin: wbObs.divRem surfaces u.divIsRem (generic ALU crack-drop marker)
    - MicroOpAssembler: LINK -> [stkPush dst=An push old An][A7+=disp drop][An:=A7-disp kept];
    UNLK -> [load (An)->T0][A7:=An+4 drop][An:=T0 kept]; mkUop gains op/divIsRem params
    - LinkUnlkDecodeSpec: 4 decode tests (counts, fields, imm threading) PASS
2026-06-10 iq+ls: dynamic NZVC wakeup for LS-produced flags (unblock a flag-reader after a MOVE-to-mem store)
    A MOVE-to-memory store writes NZVC via the LS EU at completion (variable latency).
    The IQ tracked it in the STATIC sbNzvc scoreboard, whose trigger is cleared only by
    ALU/branch issue events -- but an LS op issues on the LS port (no static event), so a
    flag-reader of an LS-produced NZVC hung forever. No prior op read NZVC produced by a
    store, so this was latent until the bit-op mem-RMW (whose op reads old N/V/C).
    Fix mirrors the existing dynamic LS load wakeup: a new lsNzvcBusy scoreboard + a per-slot
    lsNzvcWait bit + the LS EU's wakeupNzvc broadcast (pNzvcDst at store completion). An LS
    NZVC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
2026-06-10 alu: bit-op datapath (mask/test/set-clear-toggle) + Z-only flag write (preserve NVC+X) for DecOp.BITOP
    ALU datapath: bn = bitNumber mod (LONG?32:8); mask = 1<<bn (kept 32-wide); Z =
    (data&mask)==0; result = BTST:data / BCHG:^ / BCLR:&~ / BSET:|. data = src1 (Dn long or
    the loaded byte); bit number = src2 (the EU muxes useImm/imm vs Dn). EU: Z-only NZVC merge
    (N/V/C from the old CCR via the readsNzvc path, X untouched), mirroring NEGX's partial Z.
    bitOp threaded decode->rename->EU. Predecode (PredecodeWord + PredecodeRef) frames the
    bit-op lengths (Dn 1/2 words, memory +EA ext) so nextPc is correct.
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2026-06-10 exg T1: diagnose line-C disambiguation + RTR/LINK crack template + mkUop MOVE-no-flags + predecode
    Confirmed: EXG opwords (line C, bit8=1, opmode 5/6, reg-direct EA) currently
    fall into the OperationDecoder isRmw=AND branch and are illegalised by the
    assembler's aluRmwMemBad (reg-direct EA != MEMSIMPLE). MULU is opmode 3/7
    (no collision). ABCD not implemented (no src matches). mkUop defaults
    op=MOVE/size=LONG/writesNzvc=False/isMovea unused -> full-32 no-flags reg move
    (cf. unlkAn MOVE T0->An). Impl (A) chosen: assembler-cracked, exclude from bad.
2026-06-10 predecode+decode: frame line-C EXG (Dx,Dy/Ax,Ay/Dx,Ay) simple len-1 + keep non-illegal (disambiguate vs AND-RMW/MULU)
    PredecodeWord: EXG (line C, bit8=1, opmode in {01000,01001,10001}) framed
    simple/len=1 BEFORE the AND-RMW memDestExt band (else reg-direct EA -> complex
    -> wrong nextPc). OperationDecoder: isExg guard keeps these opwords non-illegal
    (benign MOVE placeholder; the assembler emits the real 3-µop crack). No AND/MULU
    opword changes. (Pre-existing stale OperationDecoderSpec 'line-0 opmode4' test
    fails on master already — bit-ops made it BTST, not illegal — unrelated to EXG.)
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2026-06-10 assemble: EXG 3-uop crack (MOVE regA->T0 ; regB->regA ; T0->regB), full-32 no-flags; exclude from bad; ExgDecodeSpec
    isExgOp detected on the raw opword (line C, bit8=1, opmode in {01000,01001,
    10001}); reg ids computed D=field / A=8+field per opmode (regA=bits11:9,
    regB=bits2:0). 3 full-32 LONG MOVE uops via mkUop (op=MOVE/INT/writesNzvc=False/
    isMovea=False) through T0; firstOfInstr True on u0 only. Excluded from the bad
    conjunction (mirror isRtrBad) so aluRmwMemBad does not illegalise the reg-direct EA.
    u0 writes T0 (temp, whitebox-dropped); u1 writes regA marked divIsRem (the generic
    ALU crack-DROP marker, like LINK's A7-fold) so its commit-obs is dropped while the
    regA write still lands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
2026-06-10 test: fix stale OperationDecoderSpec ADD-RMW opword (0xD181 is now ADDX) -> use memory EA 0xD190
    The ADDX/SUBX slice claims line-9/D RMW + EA-mode-000 (Dn-direct), so 0xD181 = ADDX.L D1,D0,
    not ADD. The test's intent (an ADD-RMW form named ADD by OperationDecoder, EA gated in the
    assembler) needs a MEMORY EA: 0xD190 = ADD.L D0,(A0). VerilatorTest (outside fastTest).
2026-06-10 alu: BCD decimal-adjust datapath (ABCD/SBCD) — Musashi-matched corrections + C/X decimal carry, clear-only Z, N=res[7] / V=bit7(~rawLoSum & res)
2026-06-10 predecode: frame ABCD/SBCD register form (line 8/C opmode 4, EA mode 000) as simple len1
    Without framing, the Dn-direct EA falls to the memDestExt path (which rejects mode 000),
    leaving lenWords=0 -> nextPc=pc -> the front-end stalls/runs off into garbage. Mirrors the
    existing ADDX/SUBX register-form framing in the same opmode-4/5/6 band.
2026-06-10 test: PredecodeRef parity for ABCD/SBCD register-form framing (+ the pre-existing EXG gap)
    The exhaustive PredecodeWordSpec (all 65536 opwords, RTL vs ref) requires the ref to
    mirror the RTL framing. Add the line-8/C opmode-4 mode-000 BCD case, and also the EXG
    reg-reg-swap case that the EXG merge left out of the ref (pre-existing parity gap).
2026-06-10 test: ABCD/SBCD lock-step matrix vs Musashi (digit/borrow sweep, X=0/1, clear-only Z, N/V exact-match, multi-byte BCD chain, invalid-BCD)
    Full-CCR step-for-step compare (N/V are the officially-undefined-but-Musashi-computed
    values, compared with no mask). Tests kept short to avoid an unrelated pre-existing
    uninit-PRF flake the harness exposes on very long straight-line programs.
2026-06-10 spec: -(An)/(An)+ predec/postinc addressing modes — generalize stkPush/anInc to any An
    EaDecoder modes 3/4 -> a memory class + autoMode{postInc,preDec} + delta (sizeBytes, A7-byte
    =2); assembler folds the An:=An+/-delta write-back into the load/store crack (reusing the
    call/return stkPush/anInc side-effect path generalized to any An). Unblocks MOVEM (committed
    next), the ADDX/SUBX/ABCD/SBCD/CLR/NEG memory forms, PEA, string ops. Indexed (d8,An,Xn)
    deferred. >=200 gate. RAW-on-An via the LINK/UNLK s0IsLsIntProd path.
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2026-06-10 decode+ls: -(An)/(An)+ An write-back folded into the load/store/RMW crack (generalized stkPush + postinc)
    EaAuto threaded decode->rename->LS. The An := An +/- delta write-back folds into
    the mem uop: a STORE / RMW-store / CLR-store / mem-to-mem store carries the An write
    on its int dst (generalizing stkPush to any An/size); a LOAD's source-EA auto rides a
    separate dropped ADD crack uop (ordered after the load, before the op/store, so the
    running A7 is current at the macro commit snapshot). LS EU computes the access addr
    (PREDEC: An-delta, POSTINC: An) + the An write (PREDEC: s1Va, POSTINC: base+delta).
    An RMW/CLR auxiliary store (writes An, no NZVC) drops its commit record (compEaAutoDrop)
    w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
2026-06-10 decode+ls: MOVEM micro-sequencer (DecodeStage FSM 2/cycle, predecode framing, LS .W sign-extend) — UNVERIFIED checkpoint
    DecodeStage multi-cycle FSM (slot0 + stashed slot1 MOVEM, 2 regs/cycle lowest-bit
    extract, reversed reg-map + descending addr for predec, final An-update, empty-mask,
    flush-abort); OperationDecoder MOVEM recognition (mode>=2 guard vs EXT.W/.L aliasing);
    MicroOpAssembler movemMoveUop (.W sign-extend via isMovea) + movemAnUpdUop;
    LsEuPlugin .W MOVEM-load sign-extend + compCrackDrop; PredecodeWord/Ref MOVEM framing;
    FetchAlignSpec 0x48E7->0xF000; new MovemDecodeSpec + MOVEM lock-step matrix.
2026-06-10 fix(movem): resize movemOff step add to 32 bits (SInt mul widened to 64) — elaboration fix
2026-06-10 fix(movem): phantom slot1-MOVEM placeholder commit + multi-LS-source IQ wakeup
    Two MOVEM lock-step desync root causes:
    1. DecodeStage: a slot1 MOVEM was NOT excluded from the normal slot1 push
    (`slot1Emit`). OperationDecoder marks MOVEM as a benign DecOp.MOVE placeholder,
    which the assembler cracks into a real (garbage) move µop. When slot0 was a
    normal instruction and slot1 a MOVEM, that placeholder was pushed alongside
    slot0 as a SPURIOUS extra kept commit (the "phantom rob2") AND the MOVEM packet
    was independently stashed -> the macro emitted one µop too many, shifting the
    whole kept-pc stream. Fixed by adding `!slot1IsMovemEarly` to `slot1Emit` so the
    FSM solely o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
2026-06-10 test(movem): prologue/epilogue + load tests fit the 8-deep store queue
    The full 15-register MOVEM.L D0-D7/A0-A6,-(A7) prologue/epilogue round-trip bursts
    15 store-misses then 15 same-line loads, overrunning the 8-entry store queue and
    hitting the PRE-EXISTING SQ-drain store-drop (orthogonal to MOVEM, documented at the
    RTR-frame / multi-RMW tests). Reduce the round-trip to D0-D7 (= SQ depth) so it drains
    cleanly: the predec save + postinc restore + the ADD-fold readback of all 8 reloaded
    registers + A7 round-trip + the predec stack image (checkMem) all lock-step vs Musashi.
    MOVEM's logic is correct (commit count matched 33=33 even at 15 regs; only the LS drain
    overran). Stable 3/3.
    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
2026-06-10 test(movem): stabilize the load lock-step tests around the LS store->load race
    The .W sign-extend and (An)+ load tests stored 4/3 registers then immediately reloaded
    the same line, intermittently racing the PRE-EXISTING store->load-same-line LS drain
    (orthogonal to MOVEM, documented at the RTR-frame/multi-RMW tests). Make them deterministic:
    - .W sign-extend: two SINGLE-register MOVEM.W loads (a negative 0x8001->0xFFFF8001 and a
    positive 0x7fff->0x00007FFF word), drained + refilled into L1D first -> pins both sign
    directions, stable 4/4.
    - (An)+ load: store via -(A0) predec then reload via (A0)+ (the same predec-store/postinc-
    load shape as the stable prologue/epilogue round-trip)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
2026-06-11 spec+plan: LS SQ back-pressure (DUT) + BehavioralMem write-before-ack (harness)
    Fix the 2 pre-existing shared-LS bugs MOVEM exposed: SQ silent store-drop on >8
    bursts (Flow alloc, no back-pressure) + the store->load-same-line drain race
    (BehavioralMem applies writes decoupled from the AXI-B ack). Acceptance = full
    15-register MOVEM round-trip. User chose fix-LS-first (2026-06-11).
2026-06-11 ls(eu): WAIT_SQ stall — back-pressure store alloc on sq.io.full (deadlock-free via incremental commit-drain)
    Also drive the uop fields added by later slices (eaAuto/eaDelta/ccrRestore/
    isMovea/divIsRem) in the LsEuSpec source plugin so it elaborates again
    (stale since the auto-EA/MOVEM slices; not a weakening — restores coverage).
2026-06-11 test(movem): restore full 15-register MOVEM round-trip + drop store->load drain workarounds
    Restores the classic MOVEM.L D0-D7/A0-A6,-(A7) + (A7)+ round-trip and the
    clean multi-register (An)+ / .W forms, and removes the rtr-frame read-back
    workaround — all enabled by the BehavioralMem write-before-ack fix + SQ
    back-pressure.
    VERIFIED PASS (3x stable): st-ld-drain probe, rtr-frame (no workaround),
    MOVEM (An)+ load, MOVEM.W sign-extend, MOVEM sparse/single/stall-resume.
    KNOWN-FAILING (pre-existing, distinct THIRD bug — see report): the full-15
    prologue/epilogue round-trip diverges at the post-epilogue ADD-fold (a
    dependent reader of a CORRECTLY-reloaded register reads a never-written/ra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
2026-06-11 test(movem): restore refill workarounds on (An)+/.W/rtr-frame (plain-store->load flake)
    The BehavioralMem write-before-ack fix is correct but does NOT fully close the
    PRE-EXISTING plain-store->immediate-same-line-load LS flake (st-ld-drain probe /
    ~line 1403): empirically (An)+ load 1/6 and rtr-frame 3/6 when de-workaroundeded.
    The predec/postinc round-trip path is reliable (the full-15 MOVEM prologue/epilogue
    round-trip is rock-solid, 4/4), so:
    - (An)+ test: use the predec-store -(A0) round-trip form (reliable), not a plain store.
    - .W + rtr-frame: restore the drain+refill read-back (makes the line L1D-resident).
    The full-15 round-trip (the real MOVEM-at-scale acceptance) needs NO workaroun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
2026-06-12 spec: ISA-completion architecture — fast decode-matrix crack vs µcode engine (hot/cold split)
    Map every remaining 68040 instruction to FAST (≤3-µop decode-matrix crack: indexed
    (d8,An,Xn) modes, LEA/PEA, MOVE-to/from-SR/USP/CCR) vs µCODE engine (cold/complex:
    MOVEC/MOVES/STOP/RTD/cache-ctl, full extension addressing, the >3-µop ADDX/SBCD/ABCD
    memory forms, 020 exotica, F-line FPU-emulation). The µcode engine generalizes the
    merged MOVEM micro-sequencer (v1 = straight-line ROM; data-dependent loops deferred to
    v2). Two parallel tracks (A=indexed fast-path, B=µcode infra) with file-ownership
    partition; line-4 band may force partial serialization. User steer: cold insns -> µcode.
    Co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
2026-06-12 indexed-EA Tasks 1-6: brief-format (d8,An,Xn)/(d8,PC,Xn) decode + crack + AGU + predecode framing
    - EaSpec/DecodedUop/RenamedUop: index descriptor (indexValid/Reg/Long/Scale); psrcC carries Xn
    - EaDecoder: modes 6 / 7-3 brief -> MEMSIMPLE + index; full-format (bit8=1) stays MEMCOMPLEX
    - RenameStage: thread indexLong/indexScale (psrcC already wired)
    - MicroOpAssembler: fold index src into ld/st/rmwSt cracks; defer indexed JMP/JSR;
    guard PC-rel against mem-dest RMW (eaDstPcRelBad + memDest !pcRel)
    - LsEuPlugin AGU: 3rd read port (psrcC), .W/.L sext + scale<<, registered s1Index added to s1Va
    - PredecodeWord + PredecodeRef: indexed = +1 ext word (eaExt/memDestExt); 65536-opword parity green
    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
2026-06-12 fix: frame MOVE indexed-DESTINATION (dst mode 6) as +1 ext word; lock-step matrix green (0 diverged)
    The MOVE-dst predecode inline path (distinct from eaExt) still rejected mode 6 ->
    complex -> lenWords=0 -> nextPc=pc -> the front-end mis-framed the brief ext word as
    the next opcode -> wild PC. Lock-step caught it (the 65536-opword parity test could not:
    PredecodeWord and PredecodeRef shared the same gap). Fixed both; (d16,PC)/(d8,PC,Xn)
    stay rejected as MOVE dests (PC-rel not alterable). Drop the PC-rel-LOAD lock-step
    (reads code-as-data; D-cache image is separate/zeroed — documented, same as (d16,PC)
    MOVEM); the pc+2 base rule is covered by EaDecoderSpec + direct Musashi verification.
    In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
2026-06-12 test: update indexed-EA stale decode tests to assert the new crack (load+index-srcC, RMW triple)
    CrackLoadSpec: indexed (d8,A0,Xn) source now cracks a leading LOAD (base=A0, index=D0
    on srcC) — was 'memComplex stays unimplemented'. MemRmwDecodeSpec: NEG.L (d8,A0,D0) dest
    now cracks the load-op-store RMW triple with the index on srcC of BOTH load+store — was
    'stays illegal'. (4 PRE-EXISTING failures remain in these specs — mem-to-mem/(An)+/-(An)
    stale 'stays unimplemented' asserts from the predec-postinc/mem-to-mem slices, confirmed
    failing on clean base f1bf645, NOT caused by indexed; out of this track's lane.)
2026-06-12 microcode: DecodeStage ROM-driven sequencer + slot1 pending path
    The µcode sequencer (a generalization of the MOVEM micro-sequencer): on a
    microcoded opword it latches a Microcode.Ctx, walks Microcode.rom from ucEntry
    emitting 1 resolved µop/cycle, holds fed until the isLast descriptor, pipeFlush
    aborts. Handles a microcoded op in EITHER slot0 (ucEnterSlot0 consumes its group)
    OR slot1 (ucPendValid/ucPendPkt stash + enter next cycle, mirroring the MOVEM
    movemPend path). The held FOLLOWING group is emitted by the normal head once the
    engine clears (the engine never consumes it). The op result reuses T1 (no 3rd RAT
    temp); the predec An write-backs ride dropped ADD µops; the no-flag store is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
2026-06-12 microcode: dedupe DecodeStage OperationDecoder cones (FMax 187->238)
    The first OOC synth came in at 187.8 MHz (below the 200 gate) — the binding path
    was an IssueQueue scheduler path, but the real cause was two REDUNDANT full
    OperationDecoder cones the µcode wiring added (a 2nd slot1 decode + a decode of a
    muxed entry packet) congesting the front-end. Reuse ONE shared slot1 decode for
    both the MOVEM and microcoded markers, and reuse spec0 for the slot0 µcode entry
    (only the pending-slot1 entry keeps its own decode). Re-synth: WNS -0.206, FMAX
    237.8 MHz (base f1bf645 = 247.3; ~9 MHz µcode cost, well above the 200 gate). The
    new worst path is the pre-existing FetchAlign->decode front-end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
2026-06-12 fix(microcode): resolve() assigns indexLong/indexScale (Track A added them to DecodedUop)
    Merge reconciliation: the indexed-modes slice (52100ce) added indexLong/indexScale to
    DecodedUop; the µcode engine's Microcode.resolve (written pre-merge) didn't assign them
    -> unassigned-field LATCH (PhaseCheck_noLatchNoOverride, 14 errors) -> FullCoreDut failed
    to elaborate -> broke BOTH indexed AND bcd-mem lock-step (+ MicrocodeSpec). Default them
    inert (µcode µops never use an index), mirroring MicroOpAssembler's non-indexed cracks.
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2026-06-13 lea-pea-ccr: add leaAddr/fromCcr/fromSr/needsSupervisor uop fields (defaults only)
    Threaded decode->rename; every MicroOpAssembler builder + Microcode.resolve assigns
    the 4 new fields (reconcile-lesson: no unassigned-field latch). No behavior yet.
2026-06-13 lea-pea-ccr: OperationDecoder classifies LEA/PEA/MOVE-from-SR/CCR/to-CCR (line-4)
    LEA gated on bit8=1 & bits7:6=11 & mode>=2 (excludes EXTB.L 0x49C0 + reg-direct).
    PEA/MOVE-from-SR/CCR by op[15:6]; MOVE-to-CCR sets srcB=EASRC for the load crack.
    MOVE-to-SR (0x46C0) left untouched (Track D). 8 new specs incl EXTB.L disjointness.
2026-06-13 plan: MOVE-to-SR/MOVE-USP/MOVEC/RTD (commit-time system ops + RTD µcode crack)
    Refined the resumed Track-D plan against the merged code: RTD = pure µcode
    crack (non-system, non-privileged); MOVE-to-SR/MOVE-USP/MOVEC = serializing
    commit-time system ops riding the ExceptionUnit/SystemState path with a NEW
    register-VALUE capture (mirrors ccrCompletion/nzvcValStore) + commit-time
    privilege check (S=0 -> vector-8). STOP/MOVES deferred (halt/wake + SFC/DFC
    alt-space need their own slice); RESET only if a 1-line privileged-NOP add.
    8-task breakdown, validation matrix, struct-field reconcile list.
2026-06-13 T1: decode + struct fields for MOVE-to-SR/MOVE-USP/MOVEC (no commit-side yet)
    Add sysOp/sysKind/sysReadDir to DecodedUop+RenamedUop+OpSpec (+SysKind enum),
    assigned in EVERY DecodedUop builder (12 in MicroOpAssembler + Microcode.resolve)
    + threaded through RenameStage (RECONCILE-LESSON: no unassigned-field latch).
    OperationDecoder classifies 0x46C0 (MOVE-to-SR, opmode-6 carve so Track C
    reconciles), 0x4E6x (MOVE-USP), 0x4E7A/B (MOVEC); MicroOpAssembler excludes
    them from + builds the sysOp op µop (reg-source forms + MOVEC ext word
    {A/D|reg#|Rc}); PredecodeWord + PredecodeRef frame the lengths. RTD/STOP/MOVES
    not yet. Decode + 65536-opword parity + fastTest GREEN (the commit-side FSM +
    valu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
2026-06-13 T2: RTD (0x4E74) + disp16 -- RTS-with-dealloc, pure µcode crack (non-system)
    RTD is NOT a commit-time system op + NOT privileged (a user-mode 040 return):
    cracked in MicroOpAssembler like UNLK into [pop PC (A7)->T0][A7 += 4+disp16
    (ADD,drop)][ibranch T0 (kept)]. anInc is 3-bit so the variable A7 add is a
    separate dropped µop (its A7 write lands in the PRF, verified by a later
    reader). Excluded from `bad`; PredecodeWord+Ref frame it simple len-2.
    Lock-step vs Musashi: rtd #4 (dealloc a pushed arg, A7 restored), rtd #0
    (==RTS), rtd #-4 (negative disp16 sign-extend) -- 0 diverged (PC+A7 step-for-
    step). 65536-parity + decode specs GREEN.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
2026-06-13 lea-pea-ccr: implement LEA/PEA/MOVE-from-SR/CCR/to-CCR cracks + EUs + privilege
    - MOVE-to-CCR: ALU toCcr direct assign (CCR := src[4:0], DecOp.MOVE case in ccrNew).
    - MOVE-from-CCR/SR: ALU fromCcr/fromSr int result (zero-ext CCR byte / 16-bit SR);
    reg-dest single op, mem-dest [op->T1][store T1]. srSysIn wired from exc.ss.srSys.
    - LEA: LS-EU address-generate (leaAddr: complete in IDLE with s1Va, no translate/cache);
    IQ isLs accepts leaAddr (memOp NONE). PEA: [leaAddr->T0][stkPush store T0->-(A7)].
    - Privilege: needsSupervisor uop + ROB converts a needsSupervisor head in user mode
    (committed S==0) to a precise vector-8 (format-$0) exception at retire.
    - keepCommit field (sim whitebox onl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
2026-06-13 lea-pea-ccr: drive new RenamedUop fields (+ pre-existing bitOp/index) in AluEuSourcePlugin
    The standalone ALU DUTs build a RenamedUop directly; the new leaAddr/fromCcr/fromSr/
    needsSupervisor/keepCommit (and latent bitOp/indexLong/indexScale) needed explicit
    drives to avoid NO-DRIVER elaboration errors.
2026-06-13 T3+T4: commit-time system-op infra + MOVE-USP (serializing FSM + value capture)
    Commit-time PRIVILEGED system ops ride the ExceptionUnit FSM (like RTE):
    - ROB: sysOp per-entry stores (RegInit, reset per-alloc); sysRetire retires
    ALONE (gates retire0/retire1/interrupt off the sysOp head); a NEW value-
    capture via ccrCompletion.result -> sysValStore (the op µop is a MOVE, so
    wbObs.result = the source value); the privilege split (exc.ss.s) drives the
    S_APPLY FSM (S=1) or a vector-8 privilege fault (S=0).
    - ExceptionUnit: S_APPLY/S_REDIR states write committed state (srSys/usp/vbr/
    CACR-WI) + re-bank A7 + a generalized arch-reg PRF write (read direction) +
    the channel-2 obs (post-st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
2026-06-13 T5: MOVE-to-SR (S-bit write + A7 banking) + privilege-violation trap
    MOVE D0,SR writes the full SR: srSys (S/T/I) + the absolute CCR (sysVal[4:0]
    via obsSetCcr5 -> whitebox + committedCcr). An S flip re-banks A7 (the FSM
    writes int PRF arch-15 with the post-write ss.a7 = Mux(S,ssp,usp)). Lock-step
    vs Musashi: S=1->S=0 banks A7 to USP (a7 step-for-step). The privilege trap:
    a privileged op at S=0 -> vector-8 format-0 (restartable), handler bumps the
    stacked PC, RTE back to user -> A7 re-banks to USP. 0 diverged across the
    user-switch + trap-entry (S->1, A7->SSP) + handler + RTE (S->0, A7->USP).
2026-06-13 T8a: drive new RenamedUop/DecodedUop fields in ROB/LS test helpers
    The RECONCILE-LESSON applies to test pokers too: every poker of a RenamedUop /
    DecodedUop must set sysOp/sysKind/sysReadDir or the standalone DUT gets an
    undriven input that blocks retire (RobPluginSpec free-loop hung; the X-input
    propagated through the RAT/freelist). Patched pokeRu/pokeMoveq in RobPluginSpec,
    RobFaultSpec, RobInterruptSpec, AccessFaultCaptureSpec. ALSO fixed a PRE-EXISTING
    breakage (from Track A's indexed-EA merge): LsEuSourcePlugin built a RenamedUop
    without driving indexLong/indexScale (+ nextPc + several flag/fault fields) ->
    NO-DRIVER elaboration error; drove them all inert. (AccessFaultCaptureSpec's
    rem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
2026-06-13 test: reconcile cross-track gaps — drive needsSupervisor+sysOp in ROB/IRQ pokers; un-stale LEA/MOVE-to-SR asserts
    The C+D merge: RobPluginSpec/InterruptEntrySpec pokers drove only one track's new
    RenamedUop fields -> the other read garbage -> spurious privViolation/sysOpStore blocked
    retire/interruptPending (4 fastTest fails). Drive needsSupervisor + sysOp/sysKind/sysReadDir
    inert. Also un-stale 2 cross-track asserts now that the ops are implemented: LEA (0x41D0)
    is simple len-1 (was 'deferred->complex'); MOVE-to-SR (0x46D0) is a legal sysOp (was Track-C
    'still illegal'). Pure test-harness reconciliation; no RTL change.
2026-06-13 test: exc-privilege uses usp=0 to match Musashi (harness USP-seed reconcile)
    The merge took Track C's runLockStep usp default (0x00200000) which seeds the DUT USP;
    Musashi's binding has no USP seed (always 0). Track D's exc-privilege test never sets USP
    in-program, so the user-mode A7 (=USP) diverged (dut 0x200000 vs oracle 0). The core's
    MOVE-to-SR A7 banking is CORRECT (it banks to whatever USP holds); pin usp=0 so the dut
    matches Musashi. Banking still exercised (A7 SSP 0x100000 -> USP 0 on S->0, back on trap).
2026-06-13 plan: STOP/RESET/MOVES — commit-time sysOp path (RESET no-op, STOP SR-load+halt+resume-on-IRQ, MOVES assess/defer)
2026-06-13 stop-reset-moves T1+T2+T3: RESET/STOP decode + STOP quiesce HW
    - SysKind +RESET(4)+STOP(5); OperationDecoder flags 0x4E70/0x4E72 as privileged sysOps.
    - MicroOpAssembler: RESET = value-less op-µop; STOP = MOVE-imm16 op-µop (imm16 -> new SR
    captured into sysValStore, mirroring MOVE-to-SR's register source).
    - PredecodeWord/PredecodeRef frame RESET len1 / STOP len2 (65536-parity green).
    - ExceptionUnit S_APPLY: RESET = NOP (S_REDIR advances PC); STOP = SR := sysVal[15:0]
    (+CCR fold +A7 re-bank, identical to MOVE-to-SR).
    - ROB state: set on a STOP sysRetire in supervisor; gates retire0; interruptPending
    fires while stopped (count==0, no head) to wake the core; clears on interruptPendin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
2026-06-13 stop-reset-moves T5: MOVES assessment - DEFER (no FC-qualified bus / RAZ-WI SFC/DFC)
    Musashi (this build, MMU off) ignores FC in m68ki_read/write_N_fc ((void)fc;), so a
    degenerate flat-space MOVES would trace-match - which is exactly why it would be a fake
    (tests nothing MOVES-specific vs a plain MOVE). Deferred per the no-fake-pass rule;
    faithful MOVES needs an FC-qualified D-cache port + readable SFC/DFC (own slice).
2026-06-13 plan: FMax 250-push D-cache/DTLB cross-module crossings (register the boundary)
    Iterative campaign to drive post-route FMax from ~211 toward 250 by registering the
    route-dominated LS-EU/D-cache/DTLB crossings: (1) the AGU effective-address ->
    D-cache tagMem arc (current worst), (2) revive the held DTLB-req-register fix
    (b16884e) on top, measured in combination, (3) deepen the AluEu ROXL/ROXR shifter
    pipeline only if it becomes the gating path. Lock-step (LS + MMU + fastTest, 0
    diverged) + post-route gate (impl_FullCore.tcl) after every fix.
2026-06-13 fmax 1: register the AGU effective address at the D-cache boundary
    Sever the route-dominated worst path LsEu s1Ctx_uop eaAuto/eaDelta -> Dcache tagMem:
    the live AGU sum (s1Base + s1Disp(eaDelta/eaAuto/stkPush) + s1Index) fed loadCmd.vaddr
    -> cmdSet/cmdTag -> the BRAM tag read-address combinationally across the module boundary
    (baseline worst path, WNS -0.724 / 211.7 MHz, 16 levels 66% route). Capture the resolved
    access {vaddr,paddr,addrB,paddrB,size,twoAccess} into llReg flops in a new LAUNCH stage
    and drive loadCmd from those flops; the cache now tags on a REGISTERED address. The DTLB
    request keeps a live xlateVaddr (translation precedes the registered launch). +1 cache-
    launch cycle is la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
2026-06-13 fmax 2: register the LS-EU -> DTLB translation request (revive b16884e)
    Re-apply the held dtlb-req-register fix on top of fmax 1: drive the DTLB req from a
    1-entry register stage (reqReg/reqMatch) so the cross-module cone Dcache valids/ldS1Set
    -> LsEu -> xlate.req.vpn/.valid -> DTLB hitVec -> hr*/missReqReg/CE -> s2Paddr -> tagMem
    now starts at a flop inside the DTLB pblock. reqMatch gates the IDLE consume against the
    LIVE xlateVaddr (fmax 1 live access VPN), mirroring the single-outstanding DTLB-miss
    stall. +1 translate cycle is latency-agnostic. MMU bit-exact (no const-fold); identity
    flows the same register.
    post-route (combined w/ fmax 1): -0.530 / 220.8 -> -0.805 / 208.1 MHz. This REGR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
2026-06-13 test(ls): drive grown uop fields + iStkPush in LS-EU directed tests
    LsEuSourcePlugin (the LS-EU test source stub) had rotted as the uop grew:
    it left leaAddr/fromCcr/fromSr/needsSupervisor/keepCommit undriven, so the
    RenamedUop had no-driver combinational signals -> LsEuSpec/LsEuCrossSpec/
    AguCrossSpec/StackOpSpec all ELABORATION-FAILED (NO DRIVER ON ...leaAddr).
    Drive all five to inert defaults (a plain aligned load/store exercises none).
    LsEuCrossSpec/AguCrossSpec also left the stub's iStkPush input undriven in
    initDut: an undriven stkPush makes a load PREDECREMENT, writing (base-size)
    to the dst instead of the loaded data (observed 0x1000-4=0xFFC / addr-4),
    and shifts the AGU cross EA ->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
2026-06-14 spec: revise MSP/ISP design for live-coherent banks (planning decision)
    Planning uncovered that ss.* banks are snapshots (not live mirrors of the
    renamed A7); user chose the live-coherent model. Add §4.1 (commit-time A7->ss
    sync via a committed-RAT read of arch-15 + a new int-PRF read port + ss.writeA7
    driven every cycle), §5.4 (the wiring), revise §5.3 (sample committed regs
    directly now they're live) + §7.3 (not neutral; new PRF/RAT read ports, honest
    gate >=200). Also fixes the latent snapshot staleness.
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2026-06-15 exc: live-coherent committed A7 banks (commit-time A7 -> ss.writeA7)
    New committed-RAT read of arch-15 (commReg(15)) + a new int-PRF read port feed
    the live committed A7 into ExceptionUnit.committedA7In, which drives ss.writeA7
    every cycle (routed by S,M) so ss.usp/isp/msp mirror the architectural A7 of the
    active bank. Entry frameBase recomputed from the settled live bank on
    E_DRAIN->E_STORE. Wired in both FullCoreSynth and the lock-step DUT. Fixes the
    pre-existing snapshot staleness; MOVE-to-SR bank switching loads a preserved bank.
    The committed phys mappings are surfaced as a RatTable output port (committedPhys)
    so the backend wiring can cross the hierarchy to read PRF[commReg(15)]. The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
2026-06-15 exc: committed-A7 readback must bypass the speculative forwarding net
    The live-coherent A7 readback reads a COMMITTED register value, so its int-PRF
    read port must use forceNoBypass=true (read RAM directly), not the speculative
    bypass network (which forwards in-flight EU results by phys match). Fixes a latent
    corruption that would hit once A7 is renamed; also a shorter timing path. Wired in
    both tops. Plus a clarifying comment on the E_REDIR setIsp-wins-over-writeA7 order.
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2026-06-15 test(trapcc): #data32-form lock-step + invalid-ttt boundary + scaladoc fix
    Add a TRAPVS.L (#data32, 3-word) taken->handler->RTE lock-step (the longest-form
    stacked-PC chain was only decode-tested; predecode-length is the #1 bug class);
    assert invalid-ttt -> COMPLEX in PredecodeRefSpec; fix the stale isTrapv scaladoc.
2026-06-15 fix(cmp2/chk2): SQ same-cache-line load-after-store refill hazard — deterministic lock-step across seeds
    Real RTL bug (not a harness uninit flake): a load that MISSES the L1D refills the whole
    16-byte line from memory, but the SQ stopped forwarding/stalling once an OLDER same-line
    store had only byte-disjoint addresses. With write-no-allocate stores, the refill could
    cache a STALE line (the in-flight store's bytes not yet in memory, and the store never
    updates the now-cached line), so a later load to OTHER bytes of that line HIT the stale
    copy. CMP2/CHK2 (load lower @EA, load upper @EA+size — adjacent bytes, same line) exposed
    it per-seed: the upper-bound load read uninit garbage -> wron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
2026-06-16 bitfield: DYNAMIC offset/width (BFxxx Dn{Dn/#:Dn/#}) — slice 2/3
    Make the dynamic bit-field forms (Do=ext[11] / Dw=ext[5]) LEGAL for all 8
    ops via a uniform 2-µop crack; slice-1 illegalized them (bfDynBad, removed).
    Crack (uniform bf-resolve, chosen over the non-BFINS-1-µop alt — simpler,
    and BFINS-dynamic is the only true 3-source case anyway):
    [BFRESOLVE -> T0] [BITFIELD bfDynamic (reads srcC=T0)]
    - New DecOp.BFRESOLVE: a FAST (lat-1) ALU µop computing the PACKED offset/width
    into T0. srcA=offset-Dn=D[ext[8:6]] (read iff Do), srcB=width-Dn=D[ext[2:0]]
    (read iff Dw, via s1RdB like PACK/UNPK); imm carries static offset(imm[4:0])
    + static raw-width(imm[9:5]) + Do(imm[10]) + Dw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
2026-06-17 spec: bit-field mem-RMW microcode-v2 design (slice 3b, PHASE A)
    Design-only for BFCHG/BFCLR/BFSET/BFINS at a control-alterable EA, static
    offset+width. Specifies the v2 microcode Ctx (EA base/index/disp + bf params),
    entry-point chain selection (4B vs 5B span, no runtime ROM branch), the
    archDepth 18-19 blast radius (T2 third temp), the inverse-funnel store-form
    datapath, decode/predecode routing, FMax plan, and tests.
    Surfaces a materially simpler HYBRID alternative: the 4-byte common case fits
    the existing 3-uop fast crack (no archDepth-19, no ROM); only the 5-byte span
    structurally needs the engine + 3rd temp. Documents the owner's
    all-through-engine plan as the default and recommends th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
2026-06-17 bitfield mem-RMW: v2 microcode engine + inverse-funnel datapath + decode wiring
    Route ALL four memory RMW bit-field ops (BFCHG/BFCLR/BFSET/BFINS) through the v2
    microcode engine (the owner's all-through-engine plan), both the 4-byte (3-row) and
    5-byte (7-row) chains.
    ENGINE (Microcode.scala):
    - v2 Ctx: EA group (base/baseValid/index/dispLo/dispHi) + bit-field static params
    (bfOp/bfDn2/bfImm/bfNeedHi). v1 fields UNCHANGED -> BCD chain resolves identically.
    - New selectors (SEaBase/SDn2/ST2/SEaDispLo/SEaDispHi/SBfImm), UOp UBfMem, Desc gains
    srcC/sz/indexFromEa/bfStoreForm/bfWritesNz. resolve() emits BITFIELD bfMem computes
    + EA-addressed load/store rows (base+disp+index).
    - ROM rows 6.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
2026-06-17 bitfield mem-RMW: lock-step tests (RMW then read-back through memory) vs Musashi
    Slice 3b lock-step coverage (RMW then READ BACK THROUGH MEMORY + checkMem vs Musashi):
    - BFSET bitOff=0 width16 (the lomask=0 corner) + read-back.
    - BFCLR bitOff=4 width12 (field straddling a byte boundary).
    - BFCHG width 1/8/32 at bitOff 0 and >0.
    - BFINS Dn2 = 0 / all-ones (-1) / partial, widths 1/16/32, incl. a full-long insert.
    - 5-byte span (offset 7 width 28 / offset 5 width 30): the hi' spill-BYTE store (7-row chain).
    - BFSET-then-BFEXTU read-after-write THROUGH memory (cross-validates 3a load-only reads
    back the 3b store -> they share the funnel correctly).
    - BFSET misaligned (odd byteAddr, within a li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
2026-06-18 fix(ls): clear stale llReg.bDone in IDLE — cross-line store-after-load drop
    A misaligned LONG store CROSSING a 16-byte cache line, AFTER a cross-line
    LOAD to the same address, dropped slot A's backing write-through: the
    backing bytes stayed STALE while SQ-forward register read-backs were
    correct (so the store DATA/ADDRESS were right, only the memory write was
    mis-targeted).
    ROOT CAUSE. The cross-line LOAD path sets llReg.bDone := True in WAIT_A to
    present slot B, and the load completes (WAIT_B -> IDLE) WITHOUT clearing it.
    bDone selects xlateVaddr (s1AddrB, the next-line base, when set). A STORE
    translates in IDLE/XLATE and NEVER passes through RESOLVE (where a load
    re-clears bDone before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
2026-06-20 btb slice1 step3: turn on the fetch-time prediction redirect (predictor LIVE)
    FetchAlign now drives two per-instruction BTB lookups (the aligner slot0/slot1
    PCs) and uses the COMBINATIONAL prediction in the same cycle:
    - slot0 predicted-taken: stamp predTaken/predTarget on slot0, suppress slot1
    (wrong-path), and on feed.fire redirect fetch to predTarget (predictFire),
    reusing the decodePc/fetchPc/pendingDrop/recStale machinery at priority
    BELOW commit/external/resume.
    - slot1 predicted-taken: suppress slot1 this cycle so the branch becomes slot0
    NEXT cycle and takes the single-slot redirect path (effShift consumes only
    slot0 so the deferred branch is not lost).
    The BtbPlugi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
2026-06-20 ras: turn on RAS-predicted returns (compose isReturn?RAS:BTB) + slot1-return defer
    Step 2 of slice 2: compose the slot0 prediction source as isReturn ? RAS : BTB
    and drive the fetch redirect from a RAS-predicted return. A predicted return now
    stamps predTaken/predTarget (= RAS top-of-stack) on slot0 and redirects fetch via
    the SAME slice-1 predictFire path — folded into redirectThisCycle so a same-cycle
    in-flight fetch is born stale (the slice-1 staleness-bug class). The branch EU /
    ROB / carry-down are REUSED UNCHANGED: the EU already loads + verifies the real
    return target (indTarget=T0) and computes mispredict; a correct RAS guess avoids
    the squash, a wrong guess recovers via the existi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
2026-06-21 gshare(fmax): keep the gshare slot1 hit/PHT out of the ibuf-shift cone
    The first post-route regen came in at 179.8 MHz (below the 200 gate). The
    critical path was the InstructionBuffer count_reg -> entries shift cone (the
    pre-existing front-end limiter) — but gshare had EXTENDED it: the slot1
    deferral term slot1WouldGsCond pulled the BTB slot1 hit/brType (condBtbHit1)
    into the slot1ValidOut / effShift suppress cone, and the slot1PredTaken gshare
    mux added the slot1 PHT read there too. The PHT/GHR/fold themselves are NOT on
    the critical path (the spec's gate concern) — the regression was the slot1
    prediction-source composition feeding the ibuf shift.
    Two correctness-neutral fixes:
    1. Dr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
2026-06-21 frontend: depth-2 multi-outstanding fetch (VARIANT 1) — lift the single-outstanding fetch ceiling
    Generalize the single-outstanding fetch tracking into a depth-2 ring so a
    2nd I-cache cmd issues while the 1st is in flight -> a fresh 8-byte window
    every ~2 cycles -> ~2 instr/cycle, removing the hard 1.0 instr/cycle fetch
    ceiling.
    I-cache (IcachePlugin): the cache is already a flow-through 3-stage pipe
    (T-stage -> S1 -> rsp), each a single register advancing every cycle. The
    T-stage is consumed (freed) every IDLE cycle, so a new cmd may enter it the
    SAME cycle the prior translation is consumed into S1 (>=2 in flight). Drop
    the single-outstanding inFlight gate; accept gates only on the ITLB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
2026-06-22 ibuf(fmax) LEVER 1: circular head/tail ring (kill the per-cycle shift mux)
    Replace the composite's depth-3 shift-register InstructionBuffer (which rebuilt
    all BUF_WORDS entries combinationally each cycle -- an O(BUF) mux cone that was
    the binding post-route limiter on one of the two near-edge regens, the IBuf arc
    FetchAlignPlugin_logic_ibuf/entries_0_pred_lenWords -> entries_17_word) with a
    circular head/tail ring:
    - entries stay in FIXED physical slots; headPtr marks logical word 0
    - logical word i lives at physical (headPtr + i) mod BUF_WORDS
    - SHIFT advances headPtr (mod BUF); PUSH writes n words at the tail
    (headPtr + count) mod BUF (shift-independent this cycle); FLUSH resets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
2026-06-23 spec: full-extension addressing modes (68020+ full-format ext word) — design
    Currently decode-illegal (only the brief 8-bit ext format is decoded). Adds the
    full-format modes for indexed EAs (modes 6 / 7-3, ext bit8=1): no-memory-indirect
    (base'+bd+index' with BS/IS suppress + word/long BD + scaled index -> the existing
    single-pass AGU), and memory-indirect pre-index ([bd,An,Xn],od) / post-index
    ([bd,An],Xn,od) -> the microcode-v2 engine resolves the EA into a temp (the mid-EA
    32-bit pointer LOAD) then re-emits the host op as a (temp+od) register-indirect access.
    SHARED critical fix: predecode must frame the VARIABLE full-format length (1 + bd_words
    [bits5:4] + od_words [bits2:0]) = 1..5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
2026-06-23 fullext stage 1: predecode length + EaDecoder full-format + no-mem-indirect
    Implements the single-pass half of the 68020+ full-format extension word
    (modes 6 / 7-3, ext bit8=1) per the approved spec, build-order stage 1.
    Predecode variable-length framing (the top correctness hazard):
    - PredecodeWord.classify gains a 2-arg overload taking the EA's first ext
    word; full-format length = 1 + bd(00/01=0,10=1,11=2) + od(present? long?2:1
    :0) ext words (1..5). The 1-arg overload (ext=0) is byte-identical to before.
    - IcachePlugin passes words(i+1) into the per-word predecode so the full-format
    length is computed from the ext word (0 at the last in-line word).
    - eaExt/memDestExt take the EA's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
2026-06-23 fullext stage 2: memory-indirect pre/post-index via the microcode-v2 engine
    Implements the 68020+ full-format MEMORY-INDIRECT modes (pre-index
    ([bd,An,Xn],od) / post-index ([bd,An],Xn,od)) per the approved spec §5, hosting
    the host-op-to-temp crack in the microcode-v2 engine.
    Microcode engine (decode/Microcode.scala):
    - Ctx extended with the host-op group (miOp/miHostSize/miIsDstEa/miOther/
    miOtherIsImm/miHostImm/miPost/miOd + flag effects) alongside the reused EA
    infra (eaBase/eaDispLo=bd/eaIndex...).
    - New row kinds UMiPtrLoad / UMiHostMove / UMiHostOp + selectors SMiOther/SMiOd/
    SMiImm + SzHost. Five ROM chains (entries 16/19/21/24/28), one per host shape:
    MI_MOVE_SRC (ptr-load,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
2026-06-23 fullext: gate .L-immediate full-format dst EA ILLEGAL (silent-corruption hole)
    A line-0 immediate op with size .L AND a FULL-FORMAT indexed dst EA (mode 6
    or 7-3, ext word bit8=1 -- both the no-memory-indirect MEMSIMPLE-with-full-
    fields form AND the memory-indirect form) places the EA's first extension
    word at op+3, after the 2-word .L immediate. The per-word PREDECODE window
    only reaches op+1/op+2, so it frames the instruction as BRIEF (too short):
    nextPc is short by the bd/od words and the FOLLOWING instruction mis-fetches
    (silent corruption, controller-confirmed via lock-step:
    addi.l #x,([0x10,%a0,%d1.l*4],0x20) followed by a move.l diverged at
    pc dut=...20 oracle=...24).
    Because predec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
2026-06-23 test(predecode): update PredecodeRef for bit-field MEMORY ops (slice 3a/3b)
    The RTL PredecodeWord frames line-E bit-field MEMORY forms (op[11]=1,
    ss=3, mode>=2) as simple with len = opword + bf-ext + EA-ext, added in
    the bit-field slices and proven correct by the extensive BFxxx-mem
    Musashi lock-step tests (BFTST/BFEXTU/BFEXTS/BFFFO + RMW BFCHG/BFCLR/
    BFSET/BFINS over (An)/(d16,An) EAs). The PredecodeRef golden model was
    never updated and still returned COMPLEX for these, failing the
    exhaustive 65536-opword sweep at op=0xe8d0.
    Mirror the RTL isBitfieldMem arm in PredecodeRef and add focused
    PredecodeRefSpec coverage. Exhaustive PredecodeWordSpec now passes:
    RTL == ref over all 65536 opwords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
2026-06-23 test(lockstep): seed PRF arch-15 in the page-fault test (boot SSP setup bug)
    ROOT CAUSE (test-setup bug, NOT an RTL frame-SR bug): the page-fault
    lock-step test poked ss.isp = 0x00100000 but never seeded the int PRF
    arch-15 (A7). The committed A7 banks are LIVE-COHERENT — the exception
    unit drives ss.writeA7 every cycle with the architectural A7 read back
    from the PRF (committedA7In). With the PRF arch-15 = 0 at boot, that
    readback clobbered ss.isp back to 0, so the supervisor frame was stacked
    at SP=0 (wrapping to 0xFFFFFFC4) instead of 0x00100000-60. The test then
    read the frame at 0x00100000-60 — uninitialized SparseMemory — getting
    per-seed garbage (e.g. SR 0x76e4 / 0x0648 / 0xb6b8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
2026-06-23 test(iq): drive the new RenamedUop fields in the IqSourcePlugin stub
    ROTTED STUB (elaboration error): the test-only IqSourcePlugin.mkSlot
    enumerates RenamedUop fields explicitly. Many fields were added to
    RenamedUop after this stub was written (shifts/BCD/bit-ops/bit-field/
    MOVEA/LEA/MOVE-from-CCR-SR/system-ops/indexed-EA/gshare carry), leaving
    the slot Reg's new bits undriven -> PhaseCheck_noLatchNoOverride aborts
    elaboration, failing all of IqAluSlowSpec/IqLsSpec/IssueQueueSpec (13
    tests) before any behavior runs.
    None of these fields feed the IQ issue/wakeup logic under test (they are
    consumed downstream in the EUs), so the RTL is correct. Drive them all to
    defined safe defaults in the s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
2026-06-23 test(alu): unrot AluEuSourcePlugin stub + slow-shift latency expectation
    Two pre-existing rots, both masked-then-revealed:
    1) AluEuSourcePlugin.mkSlot left the bit-field/system-op/EA-auto/gshare
    uop fields (added to RenamedUop later) undriven -> the slot Reg was
    undriven -> PhaseCheck_noLatchNoOverride aborted AluEuSpec +
    AluFastSlowSpec elaboration. Drive them to safe defaults (the ALU EU
    does not consume them).
    2) With elaboration fixed, AluFastSlowSpec's slow-SHIFT latency assert
    (expected 4) failed: measured 6. ROOT CAUSE is correct RTL — the FMax
    #3/#4 retimes deepened the slow pipe from S1/S2/S3 to S1/S1a/S1b/S2/S3
    (arch latency 3 -> 5), completion at S3. The h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
2026-06-23 test(rob): drive iStkPush in AccessFaultCaptureSpec (undriven -> flaky fault)
    ROTTED STUB (flaky ~50%): the LS-EU half of AccessFaultCaptureSpec never
    poked s.iStkPush. iStkPush was added to LsEuSourcePlugin after this spec
    was written; an UNDRIVEN input randomizes per sim seed. stkPush=True turns
    the store into a PREDECREMENT (s1Va = base - szBytes), so the faulting
    store's VA 0x2000 became 0x1ffc -> VPN 0x1 instead of the faulting VPN 0x2
    on the seeds where stkPush randomized True. On those seeds the access did
    not fault and completed as a normal store (faultCompletion never fired ->
    "seen was false").
    PROOF the RTL is correct: traced s1Base=0x2000, s1Index=0, but s1Va=0x1ffc
    (=base-4 = -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
2026-06-23 test(bitop): MOVEP no longer "unimplemented" (MOVEP shipped) — keep not-a-bitop guard
    STALE ASSERTION: BitOpDecodeSpec asserted MOVEP (0x0108, dynamic-bit-op
    band but mode 001) decodes as `unimplemented` (illegal/deferred). MOVEP has
    since SHIPPED — it is sequenced by the DecodeStage FSM as a real multi-µop
    op (proven by MovepDecodeSpec, 5 tests green), so the OperationDecoder no
    longer flags it unimplemented.
    RTL is correct. The test's REAL invariant — MOVEP must NOT be misdecoded as
    a BITOP — still holds and is kept; only the stale `unimplemented` assert is
    dropped. BitOpDecodeSpec passes 9/9 (x2).
2026-06-25 spec: CAS/CAS2 atomic compare-and-swap (68020+) — design
    CAS .B/.W/.L + CAS2 .W/.L in one slice (the last meaty integer-ISA ops), cracked through
    the microcode-v2 engine. Atomicity is FREE via in-order single-pipe LS + the store-queue
    (no bus-lock). The engine lacks a conditional store; per user decision we use the
    ALWAYS-STORE-MUX'D-VALUE approach (write Du on match, write the loaded value back on
    mismatch = architecturally a no-op for RAM) — documented + reversible (walk-back = a true
    NZVC-gated conditional store in the LS-EU). Musashi cas/cas2 quoted VERBATIM as the oracle;
    corrects an earlier mis-read: both CAS2 addresses are read UNCONDITIONALLY and BOTH Dc are
    updated on any mismat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
2026-06-25 plan: CAS/CAS2 implementation plan (5 staged tasks)
    Encoding+predecode+decode-detect -> CAS crack+CASCMP -> CAS2 dual-address crack ->
    regression+CAS-loop stress -> POST-ROUTE FMax gate. Anchored to the committed spec's
    verbatim Musashi semantics + the existing microcode-v2 RMW patterns.
2026-06-25 feat(cas): encoding + predecode framing + decode detect
    CAS .B/.W/.L and CAS2 .W/.L (68020+ atomic compare-and-swap), Task 1.
    - OperationDecoder: line-0 CAS family (op[15:11]=00001, op[8]=0, op[7:6]=11,
    op[10:9]=size=/=00). op[5:0]=111100 -> CAS2 (mode7/reg4); else CAS with a
    memory-alterable control EA ((An)/(d16,An)/(d8,An,Xn)/(xxx).W/.L), rejecting
    Dn/An/(An)+/-(An)/PC-rel as ILLEGAL. Both marked microcoded + ucEntry
    (CAS_ENTRY/CAS2_ENTRY); op=DecOp.CASOP, cluster INT, writes NZVC (no X).
    - New DecOp.CASOP + DecodedUop.casForm (CasForm: CASS/CASC/CAS2C1/CAS2C2/
    CAS2DC/CAS2SEL); threaded through RenamedUop + RenameStage. ucEntry widened
    5 -> 6 bits (ROM will reach 45 rows); uc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
2026-06-25 test(cas): CAS-loop stress + regression confirmation
    Task 4.
    - CAS-loop lock-free counter (cas-loop): a tight CAS retry loop (load->Dc, Du=Dc+1,
    cas.l, dbra) exercising back-to-back atomic RMW + store-queue drains. Single-threaded
    so the compare always matches; the counter ends at 3, byte-identical vs Musashi. x2.
    - Fixed BitfieldDecodeSpec's ucEntry DUT port 5 -> 6 bits (OpSpec.ucEntry widened in T1).
    - Regression confirmed byte-identical (the families sharing decode/microcode/AluDatapath/
    frontend-redirect with CAS):
    decode: FullExt + MemRmw + Bitfield + Movem + AddxSubx + Microcode + Cas +
    OperationDecoder = 163/0.
    lock-step (each its own JVM): BFCHG-mem, ABCD-m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
2026-06-25 spec: MOVES privileged move to/from alternate address space (68010+) — design
    MOVES .B/.W/.L + real SFC/DFC regs. FULLY lock-step-able: Musashi m68ki_read/write_*_fc do
    (void)fc -> FC stored in REG_SFC/DFC but NEVER redirects address space (flat access), so a
    functional flat-space MOVES trace-matches exactly. Reuses the CAS auto-inc/dec EA machinery
    (EA mask A+-DXWL incl (An)+/-(An)) + the needsSupervisor vector-8 privilege trap. Adds SFC/
    DFC as 3-bit SystemState regs (fixes the latent MOVEC RAZ-WI round-trip divergence). ~2-uop
    crack (write=STORE; read=LOAD->T0 then An sign-ext / Dn merge). No CCR effect. Gate >=200
    multi-regen (both _zz_ orderings — the CAS front-end-margin lesson).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
2026-06-25 plan: MOVES implementation plan (5 staged tasks)
    SFC/DFC regs+MOVEC -> MOVES encoding/predecode/decode+privilege flag -> write+read crack ->
    privilege trap+multi-word EA+regression -> POST-ROUTE FMax (multi-regen, both orderings).
2026-06-25 feat(moves): encoding + predecode + decode detect + privilege flag
    Add MOVES (010+ privileged move to/from alternate address space) decode +
    predecode + the microcode crack scaffolding.
    - OperationDecoder: line-0 `0000 1110 ss mmm rrr` (op[15:8]=0x0E, op[7:6]=ss
    in {00,01,10}) -> microcoded, op=DecOp.MOVES (new enum marker), size from
    op[7:6], EA = memory-ALTERABLE (Musashi mask `A+-DXWL...`, reused from CAS:
    (An)/(An)+/-(An)/(d16,An)/(d8,An,Xn)/(xxx).W/.L). Reject Dn/An/PC-rel/#imm
    (stays illegal -> vector 4). DISJOINT from CAS (op[7:6]=11), the line-0
    immediates/bit-ops/CMP2. NO CCR effect.
    - PredecodeWord + PredecodeRef: MOVES frames as opword + 1 ext + EA ext
    (brief, EA ext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
2026-06-25 fix(ls)+test(moves): privilege trap (orphan-store SQ squash) + multi-word EA
    A MOVES write in USER mode must take a vector-8 privilege violation BEFORE
    executing. The store µop, however, completes speculatively and allocates a
    store-queue entry; the ROB then faults the head (privViolation) so it never
    commits -> the SQ entry is ORPHANED (uncommitted). The exception FSM's E_DRAIN
    waits for sqDrained, which deadlocks on that orphan.
    Fix: pulse the SQ flush for ONE cycle at exception ENTRY (the rising edge of
    excActive). The flush KEEPS committed entries (they still drain into the
    handler frame) and squashes only speculative ones, clearing the orphan. It
    MUST be a single-cycle pulse — a HEL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
2026-06-30 plan: bit-field-mem dynamic 3c implementation plan (5 staged tasks)
    Un-gate decode (minimal footprint) -> dynamic read-only crack -> dynamic RMW crack ->
    regression -> POST-ROUTE no-floor-regression gate. FMax-neutral cold-op discipline throughout.
2026-06-30 feat(bf3c): dynamic-mem RMW crack (BFCHG/BFCLR/BFSET) + BFINS deferral gate
    Completes the dynamic-mem bit-field RMW path for BFCHG/BFCLR/BFSET (6 of the 8 ops now
    work dynamic-mem; BFFFO + BFINS deferred). All-bfMem funnels (RES -> LO5/HI5 -> store),
    mirroring the 3b 5-byte chain but with the {bitOff/needHi/origOff/rawWidth} packed from
    the BFRESOLVE temp (srcC) instead of the static imm.
    - NO archDepth bump (within T0/T1/T2): Do=0 folds byteBase + LO5/HI5 use imm bitOff;
    Do=1 recomputes byteBase = eaBase+(Dn[off]>>>3) for the load + store phases and routes
    bitOff to LO5RAW/HI5RAW via Dn[off] (srcC) so the `packed` temp isn't held. The RES
    reuses the dead packed temp for `res` (same-r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
2026-07-01 fix(ls/mmu): slot-1 retire commit for SQ + U/M write queues — silent memory loss
    CONFIRMED LATENT BUG (probe: divu.w then move.l -> mem 0x3000 dut=0x7f oracle=0xca):
    the SQ commit mark was wired only to retire SLOT 0 ({retire0, h0}). A store that
    completes EARLY behind a long-latency head (DIV ~30cy, slow shift, load-fed ALU)
    sits complete at h1 and DUAL-RETIRES in slot 1 -> its SQ entry was never marked
    committed -> never drains, or is squashed by the next flush = SILENT MEMORY LOSS.
    Same hole in both U/M descriptor write queues (DTLB + ITLB).
    Fix: a second same-cycle commit port (commitB) on StoreQueue + UmWriteQueue, wired
    {retire1, h1} in FullCoreSynth + all full-core test wirings. Ma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
2026-07-01 fix(rename): Freelist RAM silently stomped by the parked init write (physreg double-alloc)
    ROOT CAUSE (silent-corruption class): SpinalHDL Mem.write with an EXPLICIT enable
    REPLACES the surrounding when-condition (it is NOT ANDed). The freelist init fill
    used ram.write(..., enable = True) INSIDE when(!initDone): after init the write ran
    EVERY cycle forever at address initCounter (parked at 0), stomping ram[0] with id
    archCount. Every tail wraparound (one push per 2^ptrW frees) parked a freed id in
    slot 0 and lost it; the next pop of slot 0 handed out id archCount while it was
    LIVE -> one physical register owned by TWO in-flight writers -> the younger owner
    read a stale value when the older o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
2026-07-01 fuzz: mirror R0 commitB wiring in FuzzDut + fix CHK2 template runaway + seed dump knob
    - FuzzDut: mirror the cherry-picked R0 fix wiring (sqCommitB/umCommitB from
    {retire1,h1}) into the duplicated fuzz DUT, matching ExecuteLockStepSpec.
    - ProgGen tCmp2Chk2: Rn must be disjoint from the bounds-pointer An (a
    collision clobbered the in-bounds value -> CHK2 trap -> uninstalled vector
    -> oracle runaway, sweep-2 seed 29 GENFAIL); also install the vector-6
    handler for CHK2 (defense in depth). Generator sanity: 100 seeds green in
    both default and FUZZ_SKIP configs.
    - FuzzGenSpec: FUZZ_GEN_DUMP=<seed> prints that seed's source for triage.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
2026-07-01 fuzz: tBsrRtd generator bug — imm push hit the documented imm-source-store gap
    The RTD template pushed its stack arg with `move.l #imm,-(%sp)` — exactly the
    documented MOVE #imm,<mem> decode gap — so every program containing the block
    illegal-trapped through an uninstalled vector (a self-inflicted residual-HANG
    class, minimized by the fuzzer itself at sweep-4 seed 30). Route the push
    through a data register. Audited: no other template emits an imm-source store.
2026-07-01 fuzz: FUZZ_GEN_DUMP accepts a seed list + FUZZ_GEN_DUMP_DIR for offline triage
    Used to histogram the first-diverging instruction across all sweep-4 STEP
    seeds (assemble + objdump + musashi trace offline, no JVM): the histogram is
    FLAT (35 mnemonics / 48 seeds) — divergences mostly SURFACE downstream of an
    earlier silent corruption rather than clustering on one cracked template.
2026-07-10 spec: MOVE #imm,<mem> + CMPM — design (fuzzer-found ISA gaps)
    Both currently gated as EXPLICIT illegal traps (vector 4), not silent corruption -
    confirmed via dossier (agent a26f5239884ee51aa). MOVE-imm: crackStore requires
    srcIsReg, blocking immediate sources; fix = extend crackStore + a 2-uop
    materialize-then-store crack (reuse the crackClr T1-materialize pattern; predecode
    already correct). CMPM: not decoded at all; fix = a new 5-row microcode entry
    (dual postinc LOAD Ay/Ax -> CMP flags-only, template = BCD_MEM_ENTRY swapped from
    predec to postinc with an X-untouched compute tail). No archDepth bump either way.
2026-07-10 test(ls): drive commitB default in StoreQueueSpec/StoreQueueSplitSpec (flaky-test fix)
    commitB (00cef79's slot-1 SQ commit port) is a raw Flow with no allowOverride
    default at the StoreQueue level -- the two direct-poke unit specs never drove it,
    leaving it undriven (X per-seed in Verilator) -> occasional spurious commit ->
    flaky pass/fail. Drive commitB.valid=false/payload=0 in both initDut blocks.
2026-07-11 fix(decode): MOVE #imm,<mem> + CMPM — two fuzzer-found ISA gaps
    Both were EXPLICIT illegal traps (vector 4), not silent corruption.
    MOVE #imm,<mem>: crackStore required a register source, so an immediate
    source to a memory dest fell through to illegal. Fix: crackStore also
    fires for srcEa.klass==IMM (immToMemCase), cracked into a 2-uop
    materialize-then-store ([opUop writes imm -> T1][stUop stores T1]) that
    reuses the existing crackClr-style T1 temp (no archDepth bump). The
    register-source 1-uop fast path is untouched (immToMemCase gates the
    new behavior). Found and fixed a real second bug during lock-step
    testing: the destination EA's own extension words ((d16,An)/abs.W/
    abs.L) are mis-re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
2026-07-11 fix(decode/ucode): mem-indirect CMP is flags-only w/ Dn-mem order; MOVEA src writes no CCR (fuzzer bugs B2+B3)
    One crack family (the full-format MEM-INDIRECT host-op µcode), two
    fuzzer-caught bugs:
    B2 — CMP.<sz> ([..],od),Dn (MI_ALU_SRC @21..23):
    * the host-op row read srcA=T1(loaded)/srcB=Dn, so the ALU's a-b was
    mem-Dn: reversed CMP flags, a mem-minus-Dn SUB, and the .B/.W
    partial-merge kept T1's upper bits instead of Dn's. Row now reads
    srcA=SMiOther(Dn)/srcB=ST1.
    * the shared SMiOther dst slot landed for CMP too, clobbering Dn with
    the compare result. resolve() forces dstValid off for a CMP host op.
    B3 — MOVEA.(w|l) ([..],od),An (MI_MOVE_SRC @18..20):
    * the h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
2026-07-11 fix(div): DIV overflow preserves N/Z/C — only V is set (fuzzer bug B5)
    Musashi's divs/divu (.W and the 64/32 .L form) overflow path is
    `FLAG_V = VFLAG_SET; return;` — N, Z and C keep their PRE-DIV values.
    The DUT wrote NZVC=0010 on overflow, clearing a live N (fuzzer seed 16:
    ccr dut=0x12 vs oracle=0x1a after a divu.w overflow with N pinned).
    * DivEuPlugin: divNzvcOver := {oldN, oldZ, 1, oldC} from s1Nzvc (the
    old-NZVC read port CMP2/CHK2 already use).
    * DIV.W (OperationDecoder) + DIV.L (MicroOpAssembler divl crack) set
    readsNzvc so rename wires pNzvcSrc and the IQ waits on the producer.
    Validation: new directed lock-step test (DIVS.W/DIVU.W overflow with N=1
    then Z=1 pinne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
2026-07-11 fix(movem): (An)+ load with base An in the list discards the loaded An (fuzzer bug B6)
    Musashi (movem, er, pi) loads REG_DA[i] for EVERY listed register (An
    included) and then overwrites An with `AY = ea` — the post-incremented
    final address — AFTER the loop; the value loaded into An is discarded.
    The DUT's per-element load µop renamed the base An mid-macro, so
    (a) the final An-update µop computed loadedValue + count*step and
    (b) later elements' addresses walked off the loaded An.
    Fix: the MOVEM FSM redirects that element's load DEST to the T0 scratch
    (movemLoadDst) when isLoad && postinc && reg==baseAn. The memory access
    (and its fault behavior) is kept; the base An is never renamed,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
2026-07-11 feat(isa): NOP (0x4E71) - was entirely missing, trapped vector-4
    NOP had NO predecode case and NO OperationDecoder case: the aligner emitted it as
    a COMPLEX head (simple=false, len=0) and the assembler's !pkt.simple gate turned a
    plain NOP into a spurious vector-4 ILLEGAL. Undetected because no earlier
    lock-step program ever COMMITTED a nop; found as the "spurious vec-4 after BFINS
    mem-dynamic" symptom (the trailing nop of the new bf3c test faulted, deterministic
    and unrelated to the bit-field op itself, which had already committed).
    Fix: predecode SIMPLE len-1 + decode as a no-operand/no-dst/no-flags MOVE (writes
    no register, no CCR - a pure PC-step commit). The real 040 NOP is a pipeline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
2026-07-11 fix(rob): RTE privilege escalation — gate RTE retire on supervisor mode
    RTE never set needsSupervisor (unlike MOVE-to-SR/MOVEC/MOVES), so user-mode
    code could execute RTE, pop an attacker-controlled stack frame, and set
    S=1 with an arbitrary PC — a full privilege escalation. Musashi's
    m68k_op_rte_32 checks FLAG_S and raises m68ki_exception_privilege_violation()
    BEFORE touching the stack when not supervisor; this port now matches: RTE's
    op-uop sets needsSupervisor, and RobPlugin's rteRetire excludes a
    privViolation head so a user-mode RTE routes through the existing vector-8
    fault path (faultRetire/privOnly) instead of the RTE pop/redirect FSM. The
    faulting RTE therefore never reads or po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
2026-07-11 fix(rob): NMI (level 7) is edge-triggered, not level-triggered
    RobPlugin recognized an interrupt whenever `iplIn === 7`, re-checked EVERY
    cycle. A HELD level-7 line therefore re-recognized NMI at every subsequent
    instruction boundary, an infinite re-entry (hang) after the first NMI's
    handler RTEs back. Real 68040 NMI is edge-triggered: Musashi's
    m68k_set_irq only latches nmi_pending on a genuine `old_level != 0x0700 &&
    CPU_INT_LEVEL == 0x0700` transition, and m68ki_check_interrupts consumes
    +clears it exactly once per recognized edge; a held line does not re-arm
    it.
    Adds a registered `nmiPending` latch set on a <7->==7 `iplIn` transition
    and cleared the cycle it is actually taken. `iplActiv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
2026-07-11 fix(mmu): I/D-side accesses now use the live S bit, not hardcoded user-mode
    IcachePlugin hardcoded `xlate.req.supervisor := False` for every
    instruction fetch, and LsEuPlugin hardcoded the equivalent for every
    normal LOAD/STORE's DTLB request (a documented "slice-1 user-only
    simplification"). Combined with the ITLB/DTLB permission check
    (`permFault(sup) = sup && !req.supervisor`), a supervisor-only code page
    — the normal kernel configuration — would permission-deny EVERY
    instruction fetch once the MMU was enabled: a permanent boot-blocker (the
    CPU could never fetch its own supervisor code). The D-side had the
    matching latent bug for ordinary supervisor data accesses.
    Adds a new `Privile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
2026-07-11 fix(decode): flush-ordering phantom-commit — stash/movemPend/ucPend (A1)
    Deep-audit 2026-07-11 finding A1: DecodeStage's `stashValid`/`movemPendValid`/
    `ucPendValid` are each SET from inside three different FSM-entry blocks
    (movemBegin/ucBegin/movepBegin can each stash a slot1 owned by any of the other two
    engines, or a plain decoded-µop stash), and each also has an early flush-clear —
    but that clear is textually BEFORE some of the later SET arms. In SpinalHDL,
    multiple drivers to the same signal resolve by source order (the LAST `:=` wins),
    so a flush landing the same cycle as, say, ucBegin's slot1-is-MOVEM stash left the
    pending marker VALID after the flush: the stashed/pending wrong-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
2026-07-13 perf(rob): register allocReadySig + retire-time predictor-training flows
    Task #124 (Fable audit findings F4+F6, 2026-07-12): allocReadySig/headReady were
    unregistered comparators reading the live `count` register directly (top-2 fanout
    nets, 5114/2189) gating the whole rename->decode->fetch chain every cycle. Registered
    allocReadySig off `countNext` (the SAME expression that already drives `count` itself,
    no extra adder) — mirrors the IssueQueue's existing readyReg pattern: this is a pure
    RETIMING, mathematically identical to the original combinational value (both `count`
    and `allocReadySig` are RegNext of the same count/alloc/retire state), not an
    approximation. Added an explicit flush ov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
2026-07-16 docs: design doc for porting m68k-ooo's directed asm tests
    Scopes the 766 (of 828) m68k-ooo tests that need no interrupt-timing
    sweep -- vendoring, sentinel-based pass/fail harness reusing existing
    fuzz-harness infrastructure, and a pilot-then-bulk rollout plan.
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2026-07-16 test: data-driven suite generating one case per vendored ported test
    Adds PortedM68kOooSpec, which builds one ScalaTest case per vendored
    m68k-ooo directed asm test under src/test/resources/m68kooo-ported-tests/asm
    (via PortedTestRunner.run), superseding PortedSmokeSpec (its lone
    neg_not case is now covered by the data-driven suite).
    Pilot run (26 tests): 22 succeeded, 4 failed (3 HANG, 1 sentinel
    mismatch) -- see task-3-report.md for full per-test detail.
2026-07-16 fix(decode): wire MI_MOVE_EAEA_REV + fix unshifted routing EA for MOVE plain-src->memind-dst
    move_l_abs_memind_dst.s (ported test) FAILed with sentinel 0xdead0004. Two bugs
    stacked:
    1. ucMoveDstMiEaEa (DecodeStage.scala) was hardcoded False, routing this MOVE
    shape (dst=full-format memory-indirect, src=plain non-register memory) to
    the scoped-out illegal trap instead of the already-present, structurally
    correct MI_MOVE_EAEA_REV_ENTRY microcode rows (123-125).
    2. computeOffload's o.dstEa (MicroOpAssembler.scala) reads the MOVE dst's ext
    word at a fixed words(1)/words(2) position, correct only when the source EA
    is register-direct. When the source consumes >=1 ext word (this t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
2026-07-16 fix(execute): DIVS.L INT_MIN/-1 overflow deadlocked the ROB via scoreboard starvation
    divl_basic.s Test 5 (DIVS.L 0x80000000 / -1, signed-division overflow edge
    case) hung. Root-caused via a new env-gated PORTED_TRACE_DIV trace (permanent,
    zero-cost when unset) showing the ROB retiring cleanly through Test 4, then
    going completely silent for the stuck DIV/DIVREM robIds while a LATER
    instruction still produced a writeback -- proving DivCore itself never hangs
    (a fixed 64-cycle unconditional iterator) and the stall was strictly
    downstream of it.
    Two compounding bugs in the DIV overflow-no-write path:
    1. DivUnit.scala's overflowFor correctly flags 0x80000000/-1 as a 32-bit
    signed overflow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
2026-07-16 fix(mmu): URP/SRP root-pointer split, PFLUSHA TLB-invalidate wiring, write-protect latch fix
    Splits MmuControlPlugin's single rootPtr into separate urp/srp registers with
    per-access SRP-vs-URP selection in DtlbPlugin/ItlbPlugin (real 68040 semantics:
    supervisor accesses walk SRP, user accesses walk URP) and keeps the MOVEC
    READ-side wiring's dependency surface ready (task #131; the MOVEC WRITE
    mechanism was attempted and reverted after a confirmed sim-poke regression,
    not included here).
    Wires a new flushAll pulse into both TLB plugins' existing (previously dead)
    tlb.io.invalidateAll port plus an explicit clear of the 1-entry walk-result
    latch, so a cross-plugin flush-all request (PFLUSHA,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
2026-07-16 fix(frontend): predecode wrongly rejected immediate-source EA on ADD/SUB/AND/OR/ADDA/SUBA/CMP/CMPA
    OR/SUB/AND/ADD <ea>,Dn (opmode 0/1/2) and their ADDA/SUBA <ea>,An variants
    (opmode 3/7), plus CMP/CMPA <ea>,Dn/An, all legally admit an immediate source
    EA on real 68k (identical semantics to the ORI/SUBI/ANDI/ADDI/CMPI alternate
    encoding) but predecode's eaExt call passed allowImm=false for both opmode
    blocks, so e.g. `adda.l #imm,An` framed as simple=false/lenWords=0. That
    starves the front end (nextPc=pc) until it eventually decodes trailing garbage
    bytes, which can misdecode as an illegal opword and cause a spurious vector-4
    trap reading an uninitialized vector-table entry, landing PC at ga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
2026-07-16 perf(rob): fold BTB/gshare per-entry retire-time training state into one sync-read Mem
    Replaces 5 separate per-ROB-entry Reg-Vec arrays (btbPcStore/btbTakenStore/
    btbTargetStore/btbTypeStore/phtIndexStore) with a single BranchTrainPayload
    Mem (branchTrainMem), written only by branchCompletion and read once at
    retire (task #129, area). btbIsBranchStore/phtValidStore remain as the
    alloc-reset gate Regs that make a stale/never-written Mem row unreachable,
    so this keeps branchTrainMem to a single write port (safe for BRAM, unlike
    a naive multi-writer Mem). btbUpdateFlow/gshareUpdateFlow's payload is now
    driven directly from the Mem's registered read output instead of a separate
    RegNext-of-Flow-p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
2026-07-16 fix(exception): wire MOVEC read-side URP/SRP/TCR into ExceptionUnit (task #131)
    Takes an MmuControlService param and adds the Rc->Rn (MOVEC-from-control-
    register) read cases for TCR/URP/SRP, so `movec %tcr,d0`/`movec %urp,d0`/
    `movec %srp,d0` return the real MMU control state instead of falling
    through to RAZ. The write side (real supervisor code programming URP/SRP/
    TCR via MOVEC) was attempted and reverted after a confirmed sim-poke
    regression — see MmuControlPlugin's doc comment and the
    mmu-movec-urp-srp memory note; those Rc values stay RAZ/WI, unchanged
    from before task #131.
2026-07-16 fix(top): drive urp/srp synth-top overrides (task #131 remainder)
    FullCoreSynth's BackendWiringPlugin drives MmuControlPlugin's regs from
    registered synth-top inputs so OOC synth cannot const-fold mmuEnable to
    its power-on-default False and prune the DTLB/ITLB/walkers out of the
    netlist. Restores this after the urp/srp split (task #131): the old
    single rootPtrIn input becomes two (urpIn/srpIn), mirroring MmuControl's
    own field split.
2026-07-16 feat(decode/mmu): CPUSH decode+privilege, PFLUSHA decode+TLB-flush wiring, line-A/F vector routing
    Real 68040 hardware traps line-1010 ("Line-A") and line-1111 ("Line-F")
    opcodes to their own dedicated vectors 10/11 rather than the generic
    vector-4 illegal-instruction path (confirmed via Musashi's m68k_op_1010/
    _1111); this was a prerequisite for correctly implementing CPUSH/PFLUSHA
    below, which both live in the line-F range. PredecodeWord gains
    simple/1-word framing for is(0xA)/is(0xF), and MicroOpAssembler's `bad`
    fallback now selects vector 10/11/4 by the opword's top nibble instead
    of hardcoding 4.
    CPUSH (0xF4xx, task #138): decodes as a privileged commit-time SysKind
    op with the same "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
2026-07-17 debug(execute/exception): simPublic() observability taps for fuzz hang/flags investigations
    Adds .simPublic() taps (RobPlugin's completes/mispredictStore/pcStore
    already landed with the ROB predictor-mem commit) across
    IssueQueuePlugin (slots/flushSignal, sbNzvc/sbX/sbInt busy+physToSlot,
    lsBusy/lsNzvcBusy, pushPort fields), LsEuPlugin, DivEuPlugin, AluEuPlugin,
    BranchEuPlugin, StoreQueue, and ExceptionUnit's dbgFsm/redirectValid
    state, all zero-synth-impact sim-only hooks added during this session's
    task #139 (fuzz hang cluster) and task #141 (IQ scoreboard leak)
    investigations.
2026-07-17 test(fuzz): hang/flags investigation trace infrastructure + SparseMemory 0xFF harness fix
    FuzzLockStepSpec gains an env-gated FUZZ_TRACE_CPLX hook (a complete
    no-op unless explicitly enabled) that rides the real FuzzRunner.run
    harness to trace IQ scoreboard pushes/wakeups, LS/ALU EU completions,
    rename-stage src/dst resolution, and the mu-code sequencer's entry-point
    decisions -- built across this session's task #139 (CMP2/CHK2 hang),
    task #141 (sbX/sbInt/sbNzvc scoreboard leak), and task #144 (ADDA/SUBA
    mem-indirect routing) investigations, kept permanently since it's zero-
    cost when disabled and reusable for future repro work. Also includes a
    real (non-debug) harness fix bundled in the sam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
2026-07-18 fix(test): vendor-ported-tests script creating empty .timeout sidecars on missing +timeout= match
    The vendor_one() function in tools/fuzz/vendor-ported-tests.sh used `grep -o '+timeout=[0-9]*' | cut -d= -f2 > file` which created an empty .timeout file when grep found no match. This broke PortedM68kOooSpec line 41's `new String(bytes).trim.toLong` call on the sidecar, throwing NumberFormatException for comment-only .args files (e.g. irq_at_rts_fetch_sweep2/3).
    Fix: capture grep output first, only create .timeout file if non-empty. Verified:
    - irq_at_rts_fetch_sweep2/3 now run without NumberFormatException crash (both PASS)
    - aline_triple_nested_dbf_storm (has +timeout=2000000) still creates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
2026-07-18 test: full-suite ported-test sweep runner + results
    Batches the vendored m68k-ooo directed-asm corpus (763 tests) into
    groups of 100, staging each batch into a scratch dir via
    PORTED_TEST_DIR (ScalaTest -z is a substring filter, not an
    OR-of-names matcher, so directory-subset staging is used instead),
    one sbt/Verilator JVM per batch, mirroring tools/fuzz/sweep.sh's
    established batching discipline.
    Full-suite run: 521 pass / 242 fail (97 HANG, 144 FAIL, 1 toolchain
    assemble error). 35 of the failures are FPU/line-F (documented
    out-of-scope), leaving 207 non-FPU failures recorded for a future
    triage session (not root-caused/fixed here, per task scope) -- see
    .superpowers/sdd/task-6-report.md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
2026-07-18 fix(decode): ALU Dn,<ea> RMW dst-EA (opmode 4/5/6) mem-indirect routing gap (task #150)
    ADD/SUB/AND/OR/EOR Dn,<ea> (the memory-destination RMW form, opmode 4/5/6
    on lines 8/9/B/C/D) had no classifier reaching the mem-indirect µcode
    engine at all -- ucAluSrcMi/s0AluSrcMode/s1mi_isAlu only gated opmode
    0/1/2 (the register-destination ALU-src form). A full-format
    memory-indirect RMW dst EA silently fell through to the ordinary
    non-microcoded fast path with a garbage EA, producing a wild PC (same
    failure class as tasks #144/#145).
    Added ucAluDstMi (DecodeStage's ucBegin-time entry selector) plus its
    two upstream early-routing mirrors, s0AluDstMode (slot0) and
    s1mi_isAluDst (slot1) -- both gate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
2026-07-18 fix(decode): ADDQ/SUBQ #n,<ea> mem-indirect dst-EA routing gap (task #151)
    ADDQ/SUBQ #n,<ea> (line 5, srcB.kind=IMMQ3) is a THIRD dst-EA RMW shape
    (alongside the line-0 IMMEXT immediate and the ALU Dn,<ea> RMW form
    fixed in task #150) that had no memory-indirect classifier at all --
    ucImmDstMi only recognizes IMMEXT (line-0 imm), so a full-format
    mem-indirect ADDQ/SUBQ dst fell through to the ordinary fast path with
    a garbage EA (same wild-PC failure class as #144/#145/#150).
    Added ucAddqSubqMi (+ its slot0/slot1 early-routing mirrors
    s0IsAddqSubq/s1mi_isAddqSubq) keyed on srcB.kind===IMMQ3. ADDQ/SUBQ's
    "other operand" is a 3-bit quick immediate carried directly in the
    opword (op[11:9], 0 m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
2026-07-18 fix(decode): static bit-op (BTST/BCHG/BCLR/BSET) mem-indirect: 3 stacked bugs (task #152)
    bit_ops_full_memind / b4_bit_indexed_memind_widening exercised static
    bit ops (BTST/BCHG/BCLR/BSET, `0000 1000 tt mmmrrr`) through a
    full-format memory-indirect EA. Three independent bugs stacked:
    1. op[7:6] doubles as BOTH the line-0 immediate's SIZE field (ss, for
    ADDI/SUBI/ANDI/.../CMPI) AND the bit-op's tt sub-kind (00 BTST/01
    BCHG/10 BCLR/11 BSET). ucImmIsL (+ its slot0/slot1 early-routing
    mirrors s0ImmIsL/s1mi_immL) read this field unconditionally, so
    BCLR (tt=10) collided with the ".L-size" encoding: its EA re-decode
    read the WRONG (shifted) ext words, misclassifying a real
    mem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
2026-07-18 fix(frontend): 3rd predecode lookahead word closes .L-imm+mem-indirect-dst framing hole (task #153)
    ADDI/SUBI/ANDI/ORI/EORI/CMPI #imm,<ea> with a .L-sized immediate AND a
    full-format memory-indirect destination (andi_l_memind_dst(_preidx))
    was a documented, deliberate predecode limitation: the 2-word .L
    immediate pushes the EA's first extension word from op+2 to op+3, one
    word beyond PredecodeWord.classify's original 2-word (extW/extW2)
    lookahead. Predecode couldn't see that word, so it always assumed the
    BRIEF-format length (too short), which was safety-netted downstream
    (MicroOpAssembler's `limmFullFmtDstBad` gates the resulting
    misclassification illegal, vector 4) rather than silently cor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
2026-07-18 fix(decode): MI_MOVE_EAEA (An)+/-(An) "other" dst auto-update was missing (task #154)
    MOVE mem-indirect-src -> plain (An)+/-(An)-dst (move_l_memind_postinc,
    move_l_memind_predec, move_full_memind_src_predec) routed to the right
    µcode entry (MI_MOVE_EAEA, task #119/#147) and stored the correct
    VALUE, but the destination An register was never updated: the STORE
    row's Desc carried no `auto` marker at all, so the EA<->EA "other"
    side's own autoMode/autoDelta (already computed correctly by
    EaDecoder as part of the normal EaSpec decode) was silently dropped
    on the floor instead of being threaded into Ctx.
    Fix: added ctx.miOtherEaAutoMode/miOtherEaAutoDelta (populated in
    DecodeStage from the alre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
2026-07-18 fix(decode,frontend): MOVE dst-EA framing for sExt==2 sources + MOVE #imm,<mem-indirect-dst> routing (task #155/#156)
    Two related fixes found while chasing the remaining MOVE-family
    mem-indirect failures:
    1. (task #155) PredecodeWord.classify's MOVE dst-EA framing only read
    the dst EA's first ext word from extW/extW2 (source consuming 0 or
    1 ext words); a source consuming exactly 2 ext words (abs.L,
    #imm.L) pushed the dst's ext word to op+3, one word beyond the
    then-2-word lookahead -- `dstEaKnown` was forced False for this
    case (F1's own documented "can't see that far -> reject" fallback),
    so a full-format mem-indirect dst combined with such a source
    couldn't be framed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
2026-07-18 fix(test-harness): D-cache AXI memory never saw the program image (PC-relative literal-pool reads)
    Ported-tests triage cluster 2 (PC-relative indexed addressing, task #157).
    PortedTestRunner's I-cache and D-cache AXI agents each backed onto their own
    independently-random-filled SparseMemory: FuzzDut.attachProgram() wrote the
    assembled program only into the I-cache's private memory, while the D-cache's
    BehavioralMemAgent got a fresh, unrelated one. Any instruction that reads a
    literal/table value embedded in the code region via the D-side pipeline (e.g.
    `move.b (d8,PC,Xn),Dn` reading a ROM-style jump/data table right after the
    opcode, a real Q700-ROM shape several ported tests replicate) ther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
2026-07-18 fix(decode/frontend): TAS <ea> memory-destination RMW form (task #158)
    TAS was decoded/framed as Dn-only; the memory-alterable-EA form ((An),
    (An)+, -(An), (d16,An), (d8,An,Xn), abs.W/.L) fell through to illegal,
    hanging tas_abs_only/tas_basic/tb_tas_v2 (the CPU vectored to illegal-
    instruction with no handler installed).
    Root cause was two-layer:
    - OperationDecoder.scala: the TAS pattern matched only opword[15:3] with
    mode forced to 000 (Dn). Broadened to opword[15:6] (mode/reg free) so
    any EA reaches the decoder; MicroOpAssembler's existing rmwOpInScope/
    line4UnaryMemBad gates already validate the EA class correctly once
    TAS is no longer hard-excluded from rmwOpInScope.
    - Predecod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
2026-07-18 fix(decode/execute): implement NBCD Dn (negate packed-BCD, register form) (task #159)
    NBCD (0x4800-0x4807, "0100 1000 00 000 rrr") was entirely unimplemented
    -- not in the DecOp enum, not decoded, not framed by predecode -- so
    nbcd_basic/nbcd_dn vectored to illegal-instruction with no handler
    installed and hung waiting for a sentinel write that never came.
    Added DecOp.NBCD and reused the EXISTING SBCD (subtract) datapath cone
    in AluEuPlugin's BCD decimal-adjust logic (`0 - Dn - X`) instead of
    duplicating it: SBCD's formula is `dx - dy - X` where `dx` normally
    comes from srcA (s1Src1); NBCD forces `dx := 0` (Musashi's own
    m68k_op_nbcd formula) while still routing srcA=srcB=Dn so (a) the
    exis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
2026-07-18 fix(decode/frontend): Scc <ea> memory-destination byte-set-on-condition (task #160)
    Scc (set byte on condition) was Dn-only; any memory-alterable EA form
    ((An), (An)+, -(An), (d16,An), abs.W/.L) fell through to illegal,
    hanging scc_abs_long/scc_d16_an_disp/scc_mem_an_indirect/scc_mem_forms/
    scc_mem_incdec/scc_predec (CPU vectored to illegal-instruction with no
    handler installed). scc_mem_indexed ((d8,An,Xn) brief indexed) is NOT
    yet fixed by this commit -- still HANGs; characterized as a residual
    gap in the triage memory doc, root cause not yet isolated (predecode
    framing for mode=6 checked and appears correct by hand-decoding a test
    opcode; the remaining gap is likely in the assembler or EU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
2026-07-18 fix(decode/frontend/execute): ANDI/ORI/EORI #imm,SR was silently illegal instead of a privileged sysOp (task #161)
    Root cause of a large chunk of the cluster-6 exception/priv triage's failures:
    ANDI/ORI/EORI #imm,SR (word form, EA=mode7/reg4) shared its encoding with the
    non-privileged #imm,CCR form (byte, already implemented as `isToCcr`), but the
    word/SR variant was never wired to anything -- OperationDecoder's generic
    line-0-immediate path decoded it, but MicroOpAssembler's `lineImmBad`/
    `eorMemBad` illegal-classifiers only excluded the CCR (byte) case, so the SR
    form fell through to the generic illegal (vector 4) path. Compounding it,
    PredecodeWord.classify's line-0-immediate framing rul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
2026-07-18 fix(exception): RTE captured a stale pre-settle frameBase after an ordinary A7-modifying store (task #162)
    Root cause of rte_format_0_simple / prm_rte_format2_pops_12 HANGing: the
    ENTRY path (E_DRAIN state) deliberately waits for the store queue to drain
    and RECOMPUTES frameBase from the settled live supervisor-bank A7
    (ss.msp/ss.isp) before using it, because that live mirror trails the
    committed-A7 PRF readback by ~1 cycle (an already-documented, already-fixed
    hazard for entry, from the MSP/ISP banking Slice-A work). The RTE path had
    no equivalent: `elsewhen(rteTrigger) { frameBase := Mux(ss.m, ss.msp,
    ss.isp); goto(R_SRREQ) }` captured frameBase on the SAME cycle RTE triggers,
    with no sett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
2026-07-18 debug(cache,fuzz): simPublic() taps on DcachePlugin load ports + PORTED_TRACE_EXC hook
    DcachePlugin.loadCmdPort/loadRspPort were not simPublic, so a directed-test
    trace couldn't observe D-side load command/response traffic. Added taps
    (mirrors the existing DStoreCmd `dcStore` tap pattern in ExceptionUnit) plus
    an env-gated PORTED_TRACE_EXC trace block in PortedTestRunner (mirrors the
    existing PORTED_TRACE_MI/PORTED_TRACE_DIV pattern) that dumps exception-FSM
    dcStore commands, D-cache load cmd/rsp traffic, and the exception redirect
    pulse -- used to root-cause task #163's frame-word cross-line-boundary bug.
    Zero cost unless PORTED_TRACE_EXC is set.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
2026-07-18 fix(exception): exception-frame word push silently dropped a byte when it crossed a D-cache line boundary (task #163)
    Root-caused via the exc_aline_odd_sp_mmu_dcache ported test: the exception
    FSM's E_STORE state pushes each format-0/1/2/7 frame word as one SZ_WORD
    `driveStoreNoXlate` store (paddr = frameBase + step*2). That path sets
    useStrb=False and relies on DcachePlugin's non-split merge helpers
    (DcacheByteLane.storeData/storeStrb), which only cover a SINGLE 16-byte
    cache line -- unlike LsEuPlugin's ordinary store path, which explicitly
    computes a two-access split for a misaligned access spanning two lines.
    Whenever frameBase (or frameBase2, the throwaway ISP-relative base) is
    odd-alig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
2026-07-18 fix(decode): plain MOVE dst-EA extension words read from the wrong packet offset when the source EA has its own ext words (task #164)
    computeOffload/assemble's offloaded dstEa decode (the ONLY EADST-consuming
    op family, per OperationDecoder's sole `o.dst := eadst` site) always read
    dst extension words starting at pkt.words(1), correct only when the
    SOURCE EA consumes 0 extension words (Dn/An/(An)/(An)+/-(An)). Any MOVE
    whose source has its own ext word(s) -- (d16,An)/(d16,PC)/abs.W/abs.L/
    #imm/(d8,An,Xn) brief-or-full -- silently misread the dst's disp/index
    from the source's own ext word, corrupting the computed destination
    address. Same bug class as tasks #119/#147/#155 (dst-EA-shift), on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
2026-07-18 fix(decode): indexed-EA MOVEM silently entered the FSM instead of faulting, permanently stalling fetch (task #165)
    OperationDecoder's MOVEM classifier gated on `mmMode4 >= 2`, which
    includes indexed mode 6 and mode-7 reg 3/4+ -- its own comment's claim
    that "indexed mode 6/7-3 stay framed COMPLEX by predecode -> never enter
    the FSM" was false: `slot0IsMovem` (DecodeStage.scala) gates purely on
    this decoder's `spec0.movem`, independent of PredecodeWord's simple/
    complex marking. An indexed MOVEM opword therefore entered the FSM
    anyway, fell through DecodeStage's EA mode-switch default (base invalid,
    disp=0), and executed as a garbage-address MOVEM to/from address 0
    instead of cleanly faulting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
2026-07-18 fix(execute,iq): CPLX (DIV/MUL/CHK/CMP2/CHK2) NZVC producers used the wrong scoreboard, exposing stale flags to an immediately-following Bcc (task #167)
    Root-caused via a live ROB-commit + DivEu-wbObs trace on mull_basic.s
    Test 3 (MULU.L overflow): the flags DivEuPlugin computed for the
    overflow case were correct (verified: nzvc=0x6 matching N=0 Z=1 V=1
    C=0), but the immediately-following `bvc _fail` branch behaved as if V
    were still clear -- it took the branch when it should not have.
    Every CPLX (DivEu) op that writes NZVC (DIV normal+overflow, MUL, CHK,
    CMP2/CHK2) was tracked ONLY in the static latency-1 `sbNzvc`
    scoreboard. Task #141's own clear-loop fix clears that scoreboard's
    busy bit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
2026-07-18 fix(decode,frontend): BTST Dm,(d16,PC)/(d8,PC,Xn) was illegal-trapped despite being PRM-legal (task #169, partial)
    PRM §4.16: BTST uniquely among the 4 bit-ops accepts a PC-relative
    READ-ONLY target ((d16,PC)/(d8,PC,Xn)); BCHG/BCLR/BSET correctly
    reject it (they require a data-alterable/writable EA). Two independent
    gates forced BTST-pcRel illegal (vector 4, no handler in the bare-
    metal ported-test harness -> wild-PC HANG):
    1. PredecodeWord.scala's `memDestExt` (the shared bit-op mem-EA
    framing table) has no PC-relative case at all -- correct for the 3
    write-capable bit-ops, but it does not distinguish BTST. Added a
    BTST-specific (`bitTt === 0`) framing branch admitting mode-7 re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
2026-07-18 fix(decode,frontend): TST.W/TST.L on address registers was illegal-trapped (task #170)
    68020+ allows TST.W/TST.L An (only TST.B An is illegal, since there's no
    byte-size address-register operand). This core rejected ALL sizes of
    TST An uniformly -- mode=001 has no case in memDestExt's addressing-mode
    switch (correctly excludes CLR/NEG/NEGX/NOT, which need an alterable
    dst, but also silently excluded TST, which never writes back and has no
    such restriction) and MicroOpAssembler's line4UnaryMemBad gate only
    whitelisted DATAREG/MEMSIMPLE for the line-4 unary group.
    Added a narrow isTstAn carve-out (mode=001, size != BYTE) in both
    PredecodeWord's framing and MicroOpAssembler's illegal gate, mir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
2026-07-18 fix(exception): RTE with a malformed frame format silently mis-executed instead of vector-14 (task #172)
    There was NO vector-14 (format error) dispatch anywhere in the
    codebase. RTE only recognized format nibbles 0/1/2/7 to select the pop
    size; any other stacked format (e.g. a corrupted or hand-built frame
    with format=9) silently fell through to the format-$0 8-byte-pop
    default and restored SR/PC from the malformed frame instead of
    faulting.
    Real 68020+ silicon raises vector 14 in this case, leaving the bad
    frame UNTOUCHED and pushing a NEW format-$0 frame below it with the
    saved PC = the RTE instruction's own address (so a vec-14 handler that
    fixes the frame and RTEs again re-attempts the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
2026-07-18 feat(decode,frontend): implement 68020+ memory-form shift/rotate <ea> (task #173)
    ASL/ASR/LSL/LSR/ROXL/ROXR/ROL/ROR <ea> (1110 ttt d 11 mmm rrr, word-only,
    implicit count=1) was a complete gap: the register-form decode only
    handled ss!=3, predecode's matching framing rule also only handled
    ss!=3, and no crack/ROM entry existed anywhere for the memory form.
    Reused the existing generic crackRmw load->op->store path (the same
    one CLR/NEG/NOT/TAS/Scc-mem already ride) by giving the memory form
    its own OperationDecoder arm (srcA=dst=easrc, alterable-EA-only via
    memDestExt, matching PredecodeWord's new framing rule) and gating the
    pre-existing hardcoded Dr/ccc register-form operand-routing overri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
2026-07-18 fix(exception): MSP/ISP were not MOVEC-addressable, so ORI-to-SR M-flip re-banked to reset-value 0 (task #174)
    MOVEC #imm,MSP / MOVEC MSP,Rn (and ISP's equivalents, control-register
    ids 0x803/0x804) had no case in ExceptionUnit's MOVEC read mux or write
    switch -- writes silently no-op'd (fell through the unmatched switch)
    and reads RAZ'd via the mux's default. ss.msp/ss.isp are already the
    real committed registers backing the S/M-bit A7 Mux (MSP/ISP banking
    itself works correctly), they just weren't separately reachable via
    MOVEC -- so MOVEC #imm,MSP never actually programmed ss.msp, leaving
    it stuck at its reset value of 0. A subsequent M-bit flip (e.g. via
    ORI.W #0x1000,%sr, already correc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
2026-07-18 fix(exception): RTE format-error frame stacked wrong PC (pc+2, not RTE's own) — task #177
    Follow-up to task #172 (0199f98): the synthesized vector-14 frame for a
    malformed RTE-popped frame format stacked `p0.predNextPc` (RTE's PC + length,
    i.e. the address AFTER the RTE opcode) instead of RTE's own address. Real
    68020+ semantics require the stacked PC to BE the RTE instruction itself, so
    a vector-14 handler that patches the malformed frame in place and re-RTEs
    lands back on the original RTE, not on whatever instruction happens to sit
    2 bytes past it.
    RobPlugin.scala: rtePc now sources pcStore(h0) — RTE retires solely at h0
    (rteRetire is gated on isRteStore(h0)), mirroring the existing e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
2026-07-19 fix(frontend,decode): wire FetchAlignPlugin's dead resume port for aligner-complex mem-indirect MOVE (task #178)
    move_abs_src_full_memind_dst's 5th sub-case (abs.L source, full-format
    memory-indirect dest) lands with its own extension word at the LAST word of
    a 64-byte I-cache predecode line, so PredecodeWord.scala/IcachePlugin.scala
    correctly and safely give up on determining its length (packet.complex=true,
    packet.lenWords=0) rather than guess. Live trace (new PORTED_TRACE_FED/
    PORTED_TRACE_DLOAD taps in PortedTestRunner.scala) confirmed decode still
    correctly classifies + executes the instruction end-to-end (every load/store
    lands at the right address with the right data) -- but fetch nev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
2026-07-19 fix(decode): guard task #178's resume/nextPc recompute against a too-small aligner window
    Investigating move_l_memind_to_memind (one of the two both-mem-indirect MOVE
    tests scoped out by task #119's MI_MOVE_BOTH_MI_ILLEGAL_ENTRY -- expected to
    stay a characterized, not-fixed gap) surfaced a real latent bug in the
    resume fix two commits back: the "the aligner always hands decode the FULL
    up-to-10-word window even for a `complex` packet" assumption only holds when
    `wordCount` (how many of those 10 slots hold REAL fetched bytes -- bounded
    by however much the InstructionBuffer had actually buffered when the
    `complex` packet was emitted) covers what the recomputation reads. This
    instruction hits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
2026-07-20 fix(decode): decode FSF (xxx).L opword 0xF27F instead of F-line trapping (task #180)
    exc_fsf_xxx_l_no_fline.s was FAILing (F-line vec 11 fired) because opword
    0xF27F was entirely undecoded. Verified via m68k-linux-gnu-as -m68040 -m68881
    that the CANONICAL FSF (xxx).L per the standard <ea> table (mode=111,reg=001)
    actually assembles to opword 0xF279 -- 0xF27F is mode=111,reg=111, a RESERVED
    <ea> encoding under MC68000PRM Table 2-4 (binutils' own disassembler doesn't
    recognize it as FScc either). BUT this exact literal byte sequence is
    independently confirmed as real, static Q700 boot-ROM bytes
    (docs/bug_b_atrap_divergence.md, ROM SHA1 7a8ee468d16e64f2ad10cb8d1a45e6f07cc9e212,
    offset 0x4088D24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
2026-07-20 fix(exception): MOVEC ITT0 was silent RAZ/WI with no storage at all (task #180)
    movec_itt0.s was FAILing: MOVEC to/from ITT0 (Rc id 0x004, verified via
    m68k-linux-gnu-as -m68040 -- `movec %d0,%itt0` assembles to 4e7b 0004) had
    zero backing storage, so a write was a no-op and the read-back always
    returned 0, failing the test's write-then-read round-trip check.
    Added `itt0` as a plain committed register in SystemState.scala + wired it
    into ExceptionUnit.scala's MOVEC read/write mux at Rc 0x004 -- byte-for-byte
    the same low-risk pattern task #170-cluster10 used for CACR: real storage,
    round-trippable via MOVEC, but with NO functional transparent-translation
    effect (this core's ITLB has no TT-w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
2026-07-20 fix(decode,execute): memSimple divisor/multiplier for DIV.L/MUL.L, plus a latent CPLX issue-ordering race (task #180)
    muldiv_indexed_mem_src.s HANGed. Re-tested first per task instructions: the
    .W indexed forms (task #175's I-cache-line-boundary fix) already passed;
    isolated the actual HANG to the .L forms specifically, which were previously
    force-illegal-trapped ("A memSimple divisor/multiplier would need a leading
    load crack -> defer for now") -- but the illegal trap wasn't actually firing
    cleanly (traced via PORTED_TRACE_FED: PC ran off into 0xefef free-running
    fill memory), so the "defer" path itself had a real bug in addition to being
    an acknowledged feature gap.
    Implemented the deferr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
2026-07-20 fix(decode): restore NBCD's readsX/readsNzvc, remove from BKPT (task #178 review fix)
    da5ec5c's BKPT insertion accidentally relocated NBCD's readsX/readsNzvc
    flags into BKPT's when-block instead of leaving them on NBCD, dropping
    NBCD's rename-scoreboard dependency on the X/NZVC physical registers
    (a latent OoO hazard: NBCD could read a stale X flag from an unretired
    prior flag-writer) while giving BKPT — a true no-op — meaningless flag
    reads. Found in code review of task #178's cluster-12 commits.
2026-07-20 fix(rob,exception): ROB committed-CCR retire race + RTE CCR->PRF gap + F-line frame format (task #176)
    Three separate, independently-confirmed bugs in the CCR/exception-entry
    neighborhood, found while investigating task #176's characterized
    committed-CCR retire-timing race:
    1. The originally-characterized race: ccrCompletion (feeding
    nzvcWrStore/nzvcValStore -> committedCcr) was wired from each EU's
    wbObs, a bundle deliberately delayed one extra RegNext past
    completionPort for the sim-only lock-step whitebox join. Since
    completes(robId) (gating retire0/retire1) has no such delay, a fast
    ALU flag-writer (e.g. CMP) could retire the cycle BEFORE its flags
    landed via the delay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
2026-07-21 docs(exception,test): honestly re-document task #176's disputed F-line frame-format call
    Code review of commit 7003024 (task #176) sourced the actual MC68040
    User's Manual (9.6.1) and found it appears to contradict Fix 3's premise:
    format-$2 for vector 11 is documented for a recognized-but-hardware-
    unimplemented FPU coprocessor-ID-1 opcode (cpID==001) specifically, not
    for F-line traps in general — and this FPU-less core's F-line traps are
    all arguably the general-illegal case (format-$0), matching Musashi's
    own unconditional choice. I briefly reverted `is2`'s vector-11 addition
    on this basis, but that broke `exc_user_vbr_rte_matrix` again: the
    vendored ported test hardcodes an explicit f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
2026-07-21 fix(rob,exception,rename): RTE CCR restore silently corrupted flags under exception storms (task #176 regression)
    Task #176 (7003024) fixed exc_rte_ccr_restore by making RTE's µop carry
    writesNzvc/writesX so rename would allocate a fresh pNzvcDst/pXDst,
    written at the real frame-pop and RAT-committed by a new RobPlugin
    block. That allocation sits rename-popped but not-yet-committed for
    RTE's entire multi-cycle R_DRAIN..R_REDIR FSM run, and RenameStage's
    freelist/RAT rollback is fed by `flushing`, which stays asserted the
    WHOLE time via `excSquash` (not a one-cycle pulse). The freelist's
    `head := commHead` therefore fires every one of those cycles, treating
    RTE's own in-flight pop as still-s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
2026-07-21 fix(exception,decode,cache): implement address-error + D-side bus-error delivery (task #189)
    Address error (vector 3, format-$2): a taken control transfer (JMP/JSR/
    BRA/Bcc/BSR/DBcc/RTS/RTR) to an odd target now faults instead of silently
    executing at the bad address. Detected dynamically in BranchEuPlugin
    (target(0) on an actually-taken redirect); delivered through the existing
    generalized EuFault->ROB->ExceptionUnit is2 path (extended to vector 3),
    carrying the odd target in a new EuFault.faultAddr field for the frame's
    ADDRESS word. RTS/RTR/DBcc explicitly suppress their register write on the
    faulting path. A separate case: RTE to a frame with an odd PC now also
    raises vector 3 (conservat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
2026-07-21 fix(exception): MOVE-to-SR / STOP CCR write never reached the real NZVC/X PRF (task #192)
    MOVE.W <ea>,SR (register/memory/#imm source) and STOP #imm write the full CCR
    via S_APPLY/S_REDIR's sysCapKind==1/5 path, but that path only ever drove
    RobPlugin's `committedCcr` whitebox-tracking shadow (obsSetCcr5Valid, used for
    exception-frame stacking + lock-step comparison) -- never the REAL NZVC/X
    physical registers an ordinary Bcc/ADDX/flag-consumer actually reads. A branch
    immediately following MOVE Dn,SR / MOVE (ea),SR / MOVE #imm,SR therefore saw
    STALE flags.
    Fix: reuse the task #176 RTE direct-write mechanism (rteNzvcWriteValid/
    rteXWriteValid, driven into RenameStage.committedPhysNzvc/commi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
2026-07-21 feat(exception,rob): implement 68040 trace exception T0/T1 delivery (task #193)
    Trace exception (vector 9) was entirely unimplemented: SR's T1/T0 bits
    (SystemState.srSys bits 7/6) were already correctly stored/round-tripped by
    every existing SR writer, but nothing ever read them to raise the exception.
    ExceptionUnit.scala: add vector 9 to the existing `is2` format-$2 (6-word)
    selector, confirmed against both Musashi (m68ki_exception_trace ->
    m68ki_stack_frame_0010) and the test corpus (exc_trace_t1.s's explicit
    format/vector-word check).
    RobPlugin.scala: model trace recognition as a sibling of the existing
    interruptPending mechanism.
    - New branchTakenStore Vec captures BranchCompletion.b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
2026-07-21 fix(mmu): real MOVEC write of TC.E/URP/SRP/ITT0-1/DTT0-1, TT-window matching, and a big-endian table-walker bug (task #194)
    Three interlocking fixes that together unblock 7/9 of the task #194 MMU
    ported-test cluster (mmu_atc_load_then_use, mmu_leaf_dt3_resident,
    mmu_nested_fault, mmu_pagefault_rte_basic, mmu_pflusha_invalidate,
    mmu_pointer_dt3_resident, mmu_wp_user_vs_super now pass):
    1. MmuControlPlugin gains real commit-time write ports (setEnable/setUrp/
    setSrp/setItt0/setItt1/setDtt0/setDtt1), reviving task #131's reverted
    MOVEC-write attempt. ExceptionUnit's MOVEC switch now really writes
    TCR(0x003)/URP(0x806)/SRP(0x807)/ITT0(0x004)/ITT1(0x005)/DTT0(0x006)/
    DTT1(0x007) inst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
2026-07-21 fix(decode): dynamic-width bitfield reads at abs.W/.L EAs hung instead of executing (task #197)
    BFTST/BFEXTU/BFEXTS/BFFFO with a dynamic offset/width (Do||Dw set) at an
    absolute (xxx).W/.L EA never reached the BF_DYN_RD_DO0/DO1 microcode engine:
    slot0IsBfDynMem/slot1IsBfDynMemEarly both required `baseValid` (An-relative
    EAs only), so an abs-EA dynamic read fell through to the OLD MicroOpAssembler
    3a static crack instead. That crack's `bfmBad` gate unconditionally routes
    ANY dynamic form (bfDo||bfDw) to an ILLEGAL trap regardless of baseValid —
    and with no vector-4 handler installed, the resulting fetch off the reset
    vector's garbage free-runs forever: a HANG from the test harness's point o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
2026-07-21 fix(decode): scope the abs-EA dynamic-bitfield-read gate away from PC-relative (task #197 review follow-up)
    Self-caught regression risk from 4008ce5: that commit dropped the baseValid
    requirement from slot0IsBfDynMem/slot1IsBfDynMemEarly to admit TRUE absolute
    (xxx).W/.L EAs into the BF_DYN_RD_DO0/DO1 engine. But (d16,PC) is ALSO
    klass=MEMSIMPLE/baseValid=False, so the same relaxation also newly admitted
    PC-relative dynamic bit-field reads -- and neither ucBfDispLo (the Do=0 fold)
    nor the DO1 UBfAdd byteBase recompute fold the PC value at all (unlike the
    OLD MicroOpAssembler crack's `bfmDispLo`, which explicitly Muxes on
    `.pcRel`). That combination would have SILENTLY computed a wrong addres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
2026-07-21 feat(decode): memory-indirect bitfield support — read-only + static-offset RMW (task #197)
    Implements the 68020+ full-format memory-indirect ([bd,An],od) addressing
    mode for bit-field operations (BFTST/BFEXTU/BFEXTS/BFFFO read-only, plus
    BFCHG/BFCLR/BFSET RMW with a static offset), by reusing the EXISTING generic
    memory-indirect pointer-resolve pattern (UMiPtrLoad, already built for the
    §5 host-op crack) chained into the EXISTING bit-field funnel/RES/LO5/HI5
    compute (already built for the register-direct BF_DYN_* family) — no
    parallel ROM family built from scratch, per the reuse-not-rebuild pattern
    established by tasks #187/#189/#194.
    Root cause #1 (Microcode.scala/DecodeStage.scala, n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
2026-07-21 feat(mmu,decode): implement PTEST{R,W} (An) via a new MMUSR register (task #198)
    ptest_w_an: 0% decode coverage -> PASS. SysKind was a full 8-value enum on a
    3-bit field (PFLUSHA was the last free slot); added PTEST as the 9th value,
    bumping the field to 4 bits everywhere it's manually encoded (ExceptionUnit's
    sysKind port + sysCapKind reg + S_APPLY/S_REDIR switch literals, RobPlugin's
    .resize(3)->resize(4)).
    New MmuControlPlugin-owned MMUSR register (task #198's other missing piece):
    a real committed 32-bit reg + setMmusr Flow, written at PTEST's S_APPLY
    (MMUSR := (An & 0xFFFFF000) | 1 -- PA=VA identity + R=1, exact for this
    stub MMU's only tested configuration: MMU disabled), read back vi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
2026-07-22 fix(decode): MOVEM final An-delta sign-flipped at exactly 16 transferred registers (task #200)
    movemEmitted is a Reg(UInt(5 bits)) (0..16 for a full-width MOVEM). The final
    auto-update delta computation did `movemEmitted.asSInt.resize(32) * movemStep`:
    `.asSInt` on a bare 5-bit UInt REINTERPRETS the bit pattern as a 5-bit SIGNED
    value before widening, so count==16 (0b10000, the top/sign bit set) became -16
    instead of +16 -- corrupting the committed base-register value for the specific,
    legal case of a `MOVEM.L D0-D7/A0-A7,-(An)`-shaped instruction transferring ALL
    16 registers with a single postinc/predec base (16 * step flipped from -64 to
    +64 for a predec .L store, or the equivalent for po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
2026-07-22 feat(decode): full memory-indirect EAs for LEA/PEA/JMP/JSR (task #201)
    LEA/PEA/JMP/JSR resolved brief and register-direct EAs only; a
    mode-6/mode-7-reg-3 FULL-format (68020+) memory-indirect EA fell
    through to the fast-path assembler's leaPeaEaOk/ctrlEaOk gates
    (MEMSIMPLE-only) and traced illegal, matching the prior session's
    characterization of "zero mu-code-sequencer infrastructure" for
    this instruction family.
    Unlike the existing MI_* host-op family (which loads a VALUE through
    the resolved pointer), LEA/PEA/JMP/JSR need only the RESOLVED ADDRESS
    itself, so each gets its own minimal 2/3-row Microcode.scala entry
    built from the SAME already-proven pointer-load (UMiPtrLoad) plus one
    new "f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
2026-07-22 fix(frontend): resolve I-cache-line-boundary predecode ambiguity via live re-classify (task #202)
    Root cause (confirmed via fresh PORTED_TRACE_FED traces): PredecodeWord.classify()
    runs ONCE per 64-byte I-cache line at IcachePlugin REFILL time. When an opword lands
    at the tail of a line and needs its own extension word (which lives in the
    not-yet-fetched NEXT line) to disambiguate brief- vs full-format EAs (mode 6 / mode7
    -reg3), it could not see that word and had to guess. Task #170's "assume brief"
    fallback is silently WRONG when the real EA is genuinely full-format (pea_memind
    case 2: 0x2D22 full-format PEA under-framed lenWords=2 instead of 4), and eaExt's
    mode7/reg3 branch previously RE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
2026-07-22 fix(frontend): guard slot1 packing against an unresolved ambiguousLine guess (task #209)
    bf_memind_dyn_straddle was a wild-PC/control-flow-corruption bug: when a
    slot1 candidate instruction's opword lands on the last word of its 64-byte
    I-cache line, its extension-word lookahead falls past the line boundary at
    REFILL-time predecode, so the baked prediction is a GUESSED "assume brief"
    with ambiguousLine=True. Slot0 already re-checks this guess live once more
    data is available (task #202's p0Live mechanism), but slot1 trusted the
    guess blindly. For a memory-indirect BFEXTS landing on word 31 of a line,
    this silently truncated the instruction (dropped its own bd extension
    word), leaving the tra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
2026-07-23 docs: design proposal for combined D-cache copyback + precise store retirement
    Combines two previously-separate characterized gaps (D-cache has no real
    copyback semantics; stores retire before their physical write completes,
    making precise store bus faults impossible) into one design, since the
    obvious fix for the retirement-timing gap is only affordable once the
    cache actually has a real hit fast path.
    Recommends: classify stores at execute time into a fast path (cacheable +
    "proven backed" -- a page that has ever returned OKAY from a real bus
    transaction, a monotone property requiring no invalidation) that retires
    exactly as today, vs. slow paths (cacheable-unproven gets a probe-refill
    re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
2026-07-23 cache: check axi.b.resp (inert storeErr) + inhibited-load no-allocate/bypass
    storeErr pulses on a non-OKAY store B response but has no consumer yet
    (wired into the precise-path SQ resolution in P2 and the async diagnostic
    channel in P4). An INHIBITED load now bypasses hit-detect and never
    allocates a line on refill; an INHIBITED store skips the array write at
    drain (AXI-only), closing the two cheap load-side gaps named in the
    copyback design doc's Layer 1 scope.
    Test file is DcacheSpec.scala (DcachePluginSpec.scala referenced by the
    task brief does not exist in this tree).
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2026-07-23 ls: classify fast vs precise stores; withhold completion on the precise path
    fast := mmuEnabled && cacheable(s2Cmode) && CACR.DE -- a pure read of two
    already-latched facts, no probe/filter/history. A precise store (MMU-off,
    INHIBITED, or DE=0) allocates into the SQ exactly as before but does NOT
    call captureCompletion -- its ROB completion is deferred to the SQ's
    at-head drain (landing in the next task).
    KNOWN INTERMEDIATE STATE: until that task lands, every precise store's ROB
    entry never completes (no drain trigger exists yet). Confirmed via full
    ExecuteLockStepSpec run: 254/394 now fail, 250 of them in the exact
    expected shape ("only N/M instructions committed within <cap> cycles" --
    th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
2026-07-23 ls: SQ at-head drain trigger for precise-path stores + error-pop
    headPreciseReady drains an uncommitted precise entry once its robId
    reaches the (non-speculative) ROB head, gated off a preempt-pending
    input. sqCompletion/sqFaultCompletion report the drain's outcome with
    per-slot fault EA precision; a bus error pops the entry terminally
    (completion + fault fire together, matching the ROB's completes-required-
    even-for-a-fault contract). preciseDrainBusy is a registered, one-cycle-
    extended busy the ROB will gate interrupt/trace preemption on. Still
    dead-wired from the ROB/DcachePlugin side -- the next task closes the loop.
    Verified: deadlock-freedom argument against the current IssueQueuePlu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
2026-07-23 ls: fix split-store sqCompletion firing on slot-A ack instead of terminal pop
    The drain-ack handler's clean (non-error) otherwise-branch fired
    io.sqCompletion.valid on ANY ack of a precise head, including slot A's
    ack of a split precise store -- before slot B had even been attempted
    and before the entry actually pops. Once P2.5 wires sqCompletion into
    the ROB's completes(h0), this would let the ROB believe the store had
    completed (and potentially retire it) while slot B was still draining;
    a subsequent slot-B fault would then be reported against a robId the
    ROB may already have retired or reused.
    Move the sqCompletion.valid assignment inside the terminal (pop) arm
    only, so it fires on the s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
2026-07-23 top: wire the precise-path SQ<->ROB loop in all 4 DUTs
    LsEuPlugin exposes robHeadIn/robHeadValidIn/irqPreemptPendingIn/
    sqCompletionPort/sqFaultCompletionPort/preciseDrainBusySig (mirrors the
    existing exc-arbitration pass-through pattern); FullCoreSynth, the
    lock-step FullCoreDut, FuzzDut, and IpcBenchSpec's DUT all get the
    identical 8-line hookup (task-#176 four-DUT-duplication precedent).
    Verification surfaced two real, previously-latent bugs (not sim-only
    artifacts), both fixed here:
    1. A precise store's withheld captureCompletion effects (An auto-update,
    MOVE-to-mem NZVC write) were never replayed once the SQ confirmed the
    drain. Added a deferred-completion FIFO (deferCompletion/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
2026-07-23 fix(rob,ls): sticky h0PreciseCompletedSticky + directed collision/stall tests (task P2.5 post-review)
    Independent review of d8475bd approved it but flagged two Important
    follow-ups and one Minor:
    - RobPlugin.scala: h0JustPreciseCompleted was a one-shot RegNext pulse that
    self-cleared exactly one cycle after completion(4), regardless of whether
    h0's own retire0 had actually fired. If retire0 was additionally delayed
    by a stacked, unrelated stall (interruptPending/tracePendingFire/stopped,
    all of which also gate retire0), the guard could self-clear before h0's
    real retire cycle, reopening the dual-retire race it exists to prevent.
    Replaced with h0PreciseCompletedSticky, a RegInit(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
2026-07-30 fix(ls,rob): pendMem/SQ lock-step on a flush-coincident precise-store alloc
    Root-causes and fixes the P2.7 regression: the precise-store-retirement series
    (e6ba39f..fc6b64a) passed lock-step byte-identically yet broke 17 tests in the
    763-test ported corpus (15 HANG, 2 wrong-answer).
    ROOT CAUSE (the 15 HANGs)
    `pendMem` and the StoreQueue ring are a lock-step PAIR: every precise SQ entry
    has exactly one pendMem entry, in the same order, and `sqCompletion` (which
    advances `pendReady`) is generated per SQ pop. StoreQueue drops an alloc that
    coincides with a flush (`when(io.alloc.valid && !io.flush)`), but
    `deferCompletion`'s `pendPush := pendPush + 1` did NOT -- so a flush landing on
    the exact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
2026-07-31 sim: crossbar model -- 1 outstanding read + 1 outstanding write per master (V1.4)
    Models macqd700-soc/rtl/soc/axi_xbar.v AS IT EXISTS TODAY. Re-verified the
    crossbarSingleOutstanding doc citation against the live SoC repo and found it
    stale: the SoC file moved under a same-day commit (6bd833d, 2026-07-30) since
    an earlier task's citation was written, so the old line numbers now point at
    unrelated VRAM byte-swap code and the write-side abandoned-burst padding
    logic instead of the read/write single-outstanding FSMs. Retargeted the
    comment at the current lines (rs_state enum :2722-2724, RS_WAIT_SLV_AR ->
    RS_WAIT_R -> RS_IDLE-on-RLAST :3219-3316/:3285-3286 for reads; sw_owned
    lock-plus-single-pe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
2026-07-31 tools: fix two vendor-ported-tests.sh bugs, vendor 4 more tests
    1. qualifies() used `grep -q '+ipl='` over the WHOLE .args file including
    comment lines, so a test whose .args file only MENTIONS +ipl= in prose
    (documenting that a sweep is applied externally, not a real directive)
    was wrongly skipped. Now only checks non-comment lines.
    2. Allow a bare `+nowaves` line (a waveform-dump toggle, a genuine no-op
    in this harness) alongside the existing bare `+timeout=<N>` allowance.
    3. Real latent bug found while re-running with the above fixes: under
    `set -e -o pipefail`, `t=$(grep -o '+timeout=...' "$args" | cut ...)`
    silently kills the whole script the first time it processes a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
2026-08-01 sim: collapse D-side memory model onto AxiMemModel, split V1.6 (D-side only)
    BehavioralMemAgent / Axi4ReadOnlyBehavioralAgent become thin shims over
    AxiMemModel.attachFull/.attachReadOnly with byte-identical constructor
    signatures, so all ~60 D-side instantiation sites are untouched.
    SPLIT FROM THE ORIGINAL V1.6 SCOPE: the I-side consolidation (attachProgram
    clones in ExecuteLockStepSpec/FuzzDut/IpcBenchSpec, IcacheSim, and the 3
    inline Axi4ReadOnlySlaveAgents in ExecuteLockStepSpec) is deferred as
    "V1.6b", gated on investigating a newly-confirmed real RTL bug.
    A decisive 3-way controlled experiment proved the I-side algorithm swap
    (stock Axi4ReadOnlySlaveAgent -> AxiReadEngine) reproducib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
2026-08-01 exception: mask reserved SR bit 11 on every srSys write
    SR bit 11 (system-byte bit 3) is architecturally reserved and must
    always read back 0, but SystemState's setSrSys sink wrote whatever
    payload it was given verbatim. Every write path funnels through this
    one Flow (MOVE-to-SR, ANDI/ORI/EORI-to-SR's RMW result, RTE's popSr,
    STOP, exception entry), so a single mask at the sink (SR_RESERVED_MASK
    = 0xF7) enforces the invariant everywhere at once. The other reserved
    field (SR bits 7:5) needed no change: AluEuPlugin's fromSrRes already
    hard-codes those 3 bits to 0 on every SR read.
    Found via ported-tests triage of the 36 newly-vendored m68k-ooo tests
    (sr_reserved_bits_masked.s), which failed w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
2026-08-01 ls/rob: pin the precise-drain-vs-interrupt priority rule as sim asserts
    Sim-only (zero synth cost) invariants: a launched precise drain never
    re-issues while busy, and interruptPending never coexists with a launched
    drain. Also records the flush-source safety argument from the design doc
    directly at the code site so it isn't re-derived by a future reader.
2026-08-01 test(ls): directed IRQ-storm-vs-precise-drain race regression
    Drives a dense level-1 IRQ cadence across every phase of a precise-path
    (MMU-off) store's XLATE->drain->ack window for 20k cycles, asserting the
    core keeps making forward progress (no livelock) under the exact race
    the design doc names as "the one genuinely dangerous race" -- an
    interrupt preempting the ROB head while a precise store's write is in
    flight would be fatal for MMIO if it ever double-issued or silently
    dropped a write.
    Drift note: all DUT-internal signal paths named in the task brief
    (dut.ctrl.logic.mmuEnable, dut.intCtrl.logic.iplIn/iackAvec,
    dut.fa.logic.redirect, dut.rob.logic.flush/exc.ss.isp,
    dut.icache.logic.inv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
2026-08-01 test(ls): make PreciseDrainIrqRaceSpec actually assert the double-issue race it claims to
    Code review of 22d56ed found the test's comment claimed to check "no
    back-to-back AW without an intervening ack" but no such assertion existed --
    the only real check was `awCount > 100`, a gross livelock detector. Under the
    20,000-cycle IRQ storm, awCount typically lands ~1867, so a few-percent
    systematic double-issue or drop rate would shift that count by tens/hundreds
    and sail past the threshold completely undetected.
    Add a real AW/B pairing watchdog: track an `outstandingAw` boolean, set on an
    accepted AW to the target line and cleared on the next accepted B. Fire a new
    AW to the same line while the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
2026-08-01 decode: fix inaccurate root-cause comment in ade9610's movem_pc_idx_w fix
    The persisted comment claimed the movemPcIdx* resume machinery engaged
    pre-fix and was then overridden by the illegal classification. Traced
    directly: that machinery is gated purely on spec0.movem (this decoder's
    own classification), which was False pre-fix, so it never engaged at
    all. What actually unstuck the front end was PredecodeWord's EA-shape-only
    complex framing plus the illegal-exception redirect substituting for the
    missing explicit resume. Caught in task review; no RTL/logic change, no
    behavioral impact -- the fix itself was already independently verified
    correct via live pre/post testing in an isolated work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
2026-08-02 icache: gate dataMem/predMem writes under doAllocate, fix silent corruption
    Fixes a CRITICAL finding from review of 4a3513f ("icache: wire
    xlate.rsp.cacheMode into IcachePlugin"): that commit correctly gated
    tagMem/valids/victim-pointer-advance under doAllocate for an INHIBITED-mode
    miss, but left the actual dataMem(w).write(...) (REFILL) and
    predMem(w).write(...) (PREDECODE) calls unconditional.
    The round-robin victim pointer is shared between cacheable and INHIBITED
    misses. Once a set has taken >=4 real allocations, the pointer cycles back
    onto a way that is still valid/resident for some OTHER address. An
    INHIBITED miss landing in the same set then silently overwrote that way's
    data/pred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
2026-08-02 test: vendor 37 more ported tests from m68k-ooo sibling project
    Discovered via a fresh diff of the sibling repo's canonical tb/tests/asm
    directory (917 tests) against this repo's already-vendored corpus (803),
    finding 114 tests never vendored. Ran the existing vendor-ported-tests.sh
    against the gap list: 37 qualify (no unsupported +ipl=/other flags), 77
    skip (need the interrupt-timing-sweep harness capability this project has
    scoped but not yet built -- see project memory on the +ipl= design gap).
    New tests: 25 benchmark/perf tests (bench_*), 3 MMU split-page-boundary
    tests, 6 FPU tests (relevant to the newly-scoped FPU/FPSP work -- not yet
    runnable, this core has zero FPU support, expected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
2026-08-02 cache: fix 2 critical races landed by P4.3/P4.4 (spurious storeAck, dropped store write)
    Both are fresh instances of this file's documented failure class: two
    independently-firing control paths (store pipeline vs. load-refill FSM) sharing
    mutable state with no interlock.
    Bug 1 -- EVICT_WR's own AXI B was firing a spurious storeAck/storeErr.
    Since P4.3 there are two AXI write issuers on the one physical write port: the
    store-S2 write-through path (id=1) and EVICT_WR's dirty-victim writeback (id=2).
    EVICT_WR's own completion check already filtered by id, but storeAckReg/storeErrReg
    accepted ANY b beat, so every dirty-victim eviction acked a store that had not
    completed. `sq.io.drainAck := dca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
2026-08-02 fix(dcache): gate load accept on !pendingStoreMiss; add Fable5 Bug1 regression test
    IDLE's loadCmdPort.ready was missing a `&& !pendingStoreMiss` term. A load
    accepted on the same cycle the `.elsewhen(pendingStoreMiss)` arm picks up a
    pending COPYBACK store-drain miss leaves that load's ldS1Valid armed while
    the FSM immediately leaves IDLE for REFILL/EVICT_WR. If that load then
    MISSES, its miss-handling (only present inside IDLE.whenIsActive) never runs
    next cycle -- ldS1Valid self-clears with no response ever sent to loadRsp,
    hanging the LS EU's WAIT state forever. A HIT is unaffected (ldS1Resp is
    combinational/state-independent).
    Add a directed regression test that races an independent MI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
2026-08-02 cache/rob: async diagnostic-fault channel + sticky, non-wakeable core halt
    Every post-commit AXI transaction on behalf of trusted-cacheable data
    (WT-beat, drain-miss write-allocate, eviction writeback) now has its
    response checked; a non-OKAY response latches a sticky {addr,resp,kind}
    record (simPublic, first-error-wins) and freezes retire+fetch via a new
    RobPlugin.coreHalted that -- unlike STOP's `stopped` -- is never cleared
    by an interrupt. Sim-side: fatal assert by default, opt-out via
    diagFaultExpected for a directed test that wants to exercise the path.
    No architectural exception, no frame, no attempt to attribute it to the
    originating instruction (design doc Sec 4.2).
    Task P4.5. Dire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
2026-08-02 sim: fix sim-side fatal asserts that were never actually fatal
    The 4 GenerationFlags.simulation { assert(...) } sites (DcachePlugin's P4.5
    diagnostic-fault guard, StoreQueue's two invariant guards, RobPlugin's
    interrupt/precise-drain guard) never actually aborted simulation, but not for
    the reason originally suspected: bytecode inspection + a live empirical probe
    confirm SpinalHDL 1.14.1's 2-arg assert(cond, msg) already defaults to FAILURE
    severity, and FAILURE is the one severity that emits a Verilog $finish. The
    real root cause is that GenerationFlags.simulation was never actually active
    in any of this project's sim compiles -- nothing ever called
    SpinalConfig.includeSimulation, so those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
2026-08-02 cache: sim assert -- at most one storeAck source pulses per cycle
    Pins design doc §5 item 7's one-ack-per-store contract now that
    storeAckReg has three sources (AXI B write-through, copyback-hit S2,
    drain-miss write-allocate). Uses `storeBAck` (the id=1-demuxed B
    handshake storeAckReg is actually driven from post-P4.3/P4.4), not
    raw axi.b.valid && axi.b.ready -- EVICT_WR's own id=2 B response is
    already excluded from storeAckReg by the id filter and is not a
    storeAck source at all, so counting it here would spuriously trip on
    ordinary concurrent eviction-writeback traffic. Zero synth cost.
    Verified: ExecuteLockStepSpec 390/394 (4 known-acceptable failures,
    unchanged), DcacheSpec+DcacheDrai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
2026-08-02 test(cache): directed eviction-writeback diag-fault (kind=2) regression + write-fault hook
    Task P4.7 (corrected scope): 3 of the brief's 4 planned cases already exist as
    sibling tests in DcacheSpec.scala (hit-drain throughput, write-allocate,
    dirty-victim eviction ordering) -- confirmed by full read, not duplicated.
    Adds the genuinely missing 4th case: a non-OKAY response on a dirty-victim
    eviction's own AXI B (kind=2) sticky-latches the async diagFault channel and
    never raises an architectural fault. This needed the SAME physical address to
    succeed on an earlier read (the victim's own original warm-up) and then fail
    on a later write (its own eviction) -- the existing decode-based
    injectBus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
2026-08-03 docs(P5.1): cross-checked CPUSH/CINV bit encoding + lock-step CINV guard note
    Task P5.1: independently re-derive and cross-check the CPUSH/CINV opword
    bit layout (1111 0100 CC O SS AAA) against the ported corpus's own
    ground-truth opwords, Musashi's disassembler decode logic, and GNU
    binutils' m68k-opc.c/m68k-dis.c (sourced from the M68000 Family PRM).
    Zero discrepancies found across all sources; final encoding recorded in
    .superpowers/sdd/task-P5.1-report.md for Task P5.2 to consume.
    Bonus finding: Musashi's execution engine doesn't implement CPUSH/CINV at
    all -- both fall through its generic line-F unimplemented-instruction
    trap (m68ki_exception_1111), not just "no cache model". Folded in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
2026-08-03 fix(P5.2): S_APPLY sysOp dispatch was re-pointed by the SysKind.CINV insertion
    5cf13a4 inserted SysKind.CINV between CPUSH and PFLUSHA, shifting every later
    enum element up one ordinal. ExceptionUnit's S_APPLY switch dispatched on
    hand-written literals and was never updated, so on HEAD:
    - CINV (now 7) hit the old PFLUSHA arm -> spurious FULL TLB flush
    (contradicting P5.2's own "CINV is a no-op until P5.4/P5.5")
    - PFLUSHA (now 8) hit the old PTEST arm -> garbage MMUSR write, NO flush
    (regressed task #136)
    - PTEST (now 9) matched no arm at all -> MMUSR write silently dropped
    (regressed task #198)
    Nothing guarded it: OperationDecoderSpec stop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
2026-08-03 rob: fix stale PTEST=8 ordinal comment (P5.2's CINV shifted it to 9)
    Comment-only. Flagged by the critfix reviewer: the exact seam this
    fix's whole encoding-matching guarantee hinges on (RobPlugin's
    sysKindStore(h0).asBits.asUInt.resize(4) producer expression) still
    carried a hand-written ordinal reference. ExceptionUnit's S_APPLY now
    dispatches symbolically (skOrd(SysKind.X)) rather than on raw ordinals,
    so this comment no longer needs to track a specific element's value at
    all -- rewritten to say so instead of just updating the stale number.
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2026-08-03 fix(P5.4 review): bidirectional AXI gate + store/load hold against the cache-maintenance walk
    Review of commit a58b605 found the walk's mutual-exclusion story incomplete
    in three ways, all unreachable today (maintCmd has no driver yet) but
    required before Task P5.5 makes the walk reachable:
    1. WRB's AXI gate only deferred the walk against the store/eviction, not
    the reverse -- the exact P4.3 Revision-1/2 failure mode, now closed
    bidirectionally via a forward-declared maintAxiPairOpen.
    2. A previously-latched pendingStoreMiss could still pull the load FSM
    into EVICT_WR/REFILL mid-walk; now deferred via !maintWalking.
    3. A store reaching S1 while the walk's READ state held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
2026-08-03 feat(P5.5): real CPUSH/CINV dispatch + S_MAINTWAIT; fix I-cache refill-vs-invalidate race
    Task P5.5 of the D-cache-copyback / precise-store-retirement plan. CPUSH and
    CINV stop being commit-time no-ops and actually drive P5.4's D-cache
    maintenance walk engine and the I-cache invalidate wire.
    ExceptionUnit
    - New ports next to dcStore/dcStoreAck: `maintCmdOut` (Flow[CacheMaintCmd]),
    `maintDoneIn` (defaults True, so an ExceptionUnit-only DUT with no D-cache
    cannot hang), `icMaintPulse`.
    - The two EXISTING, deliberately-empty `is(skOrd(SysKind.CPUSH))` /
    `is(skOrd(SysKind.CINV))` arms got real bodies. No new `is()` clauses and
    no raw ordinal literals: every arm still derives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
2026-08-03 fix(P5.5): pulse the I-cache invalidate AFTER the D-cache walk, and clear the BTB on CINV/CPUSH-IC
    Two Important SMC-correctness gaps found by the independent review of 6e9dd5a.
    They compose into one fix: the second is fed by the signal the first re-times,
    so moving the pulse gives the new BTB fan-out the corrected timing for free.
    I-1: icMaintPulse fired too early. The S_APPLY CPUSH/CINV arms asserted it in
    the SAME cycle they issued maintCmdOut, but a BC-selector CPUSH ALL then runs a
    1500+ cycle D-side writeback walk in S_MAINTWAIT -- and nothing gates
    instruction fetch on excActive (FetchAlignPlugin's ic.cmd.valid has no such
    term). So for the canonical SMC sequence (patch code, CPUSH,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
2026-08-03 test: poke CACR=DE|IE at boot in lock-step/fuzz/IPC-bench DUTs
    Models "firmware already enabled the caches" (design doc section 5.2)
    -- equivalent to a boot ROM's movec, not a semantics change. Ported
    tests stay un-poked (real-silicon contract; a test that needs caching
    enables DE itself). Confirms the lock-step baseline stays 390/394
    (byte-identical failing-test names) and IPC bench still passes its
    sanity check.
    Step 4's ported-corpus timeout review (full m68k-ooo corpus, 840
    tests) surfaced 759/840 passing vs. an 774/840 pre-existing baseline
    capture. Investigated the delta rather than blindly raising .timeout
    sidecars: sampled 5 of the newly-failing non-FPU tests (including the
    one MOVE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
2026-08-03 test: vendor 30 more tests from m68k-ooo (107 found, 77 need +ipl= sweep)
    Re-checked the sibling m68k-ooo project's asm test source
    (tb/tests/asm, 947 tests) against this repo's vendored corpus (840),
    diffed by name: 107 genuinely new, unvendored tests. Ran
    vendor-ported-tests.sh --all, which auto-skips already-vendored files
    and anything requiring +ipl= or other unsupported .args flags:
    30 vendored (this commit)
    77 skipped -- need the +ipl= interrupt-timing-sweep harness this
    project has not built (matches the already-documented,
    deliberately-deferred "77 sibling-project tests requiring +ipl="
    figure from prior sessions almost exactly -- same known,
    out-of-scope cat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
2026-08-06 docs: LUT-reduction design spec (microcode ROM + ROB alloc-field BRAM)
    Two independently-implementable features, prioritized per explicit
    user direction (microcode ROM first, then ROB):
    Feature A: Microcode.rom currently resolves all ~250 rows into full
    DecodedUops combinationally every cycle before indexing by ucPc --
    ~250x redundant logic. Converting to a real synchronous-read Mem() is
    latency-neutral (ucPc's next-value is already computed one cycle
    early) but requires rewriting resolve()'s 285 lines from Scala-level
    compile-time branching (on Desc's Scala fields) into runtime hardware
    switch/when over a new DescBits hardware bundle -- a mechanical but
    large, correctness-critical rewrite,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
2026-08-06 decode: resolveFromBits — runtime-hardware-decoder rewrite of resolve() (LUT-reduction A3)
    Adds `resolveFromBits(d: DescBits, ctx: Ctx, valid: Bool): DecodedUop` — a
    1:1 runtime-hardware transform of `resolve(d: Desc, ...)`, consuming the
    Task A1 `DescBits` bundle (a microcode ROM row as a live hardware value)
    instead of a compile-time Scala `Desc`. Every Scala-level `match`/`if` on
    `d`'s fields becomes its hardware equivalent (`switch`/`when`/`Mux`, `===`
    instead of Scala `==`), with the logic itself untouched.
    Also adds the two hardware-typed helper siblings `resolveFromBits` needs:
    `selRegHw` and `selImmHw` (arm-for-arm identical to `selReg`/`selImm`, which
    also branch on the Scala `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
2026-08-06 decode: cut over to Mem-based microcode ROM read, remove old 250x-resolve path (LUT-reduction A5)
2026-08-06 docs: fix stale comments found by LUT-reduction final whole-branch review
    3 comment-only fixes, no logic changes (compile-verified):
    - Microcode.scala: the Task A1 header comment claimed "nothing below
    consumes these yet" -- false since Task A5's cutover; descToBits is
    now live (DecodeStage.logic's ucRomMem init is its only caller).
    - Microcode.scala: the switch-completeness convention note didn't
    mention that Task A5 added the REAL safety net (the ucNextPc <
    romSize sim assertion) against an out-of-range row encoding -- the
    pre-assignment default this comment describes provides none.
    - ExceptionUnit.scala: two summary-bullet field descriptions went
    stale after LUT-reduction Tas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
2026-08-07 docs: FMax closure Slice 1 design spec (register p0Live off the L0 consume path)
    Grounds Fable 5's Candidate 1 recommendation in the real IBuf/Aligner
    source: since InstructionBuffer's head entry is provably immutable
    while the aligner stalls on ambiguousLine (pushes only touch the tail,
    only shift/flush move headPtr, and the stall arm holds shiftWords=0),
    a simpler mechanism than Fable's IBuf-patch-write suffices -- register
    p0Live's output and consume it one cycle later, with the register
    forced back to 'not yet resolved' on flush. No IBuf write port needed,
    avoiding the head/tail collision risk Fable flagged.
    Scoped to ONLY the p0Live segment (~1.9ns of the 6.825ns critical
    path) -- the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
2026-08-07 frontend: register p0Live off the L0 consume path (FMax closure slice 1)
    Remove the second, LIVE PredecodeWord.classify() instance from Aligner.align's
    same-cycle L0 consume path. `Aligner.align` now takes the live head
    re-classification as an input (`p0LiveReg`); FetchAlignPlugin computes it every
    cycle from the live IBuf head words/avail — the identical classify() call — and
    REGISTERS it, so STA no longer charges a full classify() decoder's depth against
    L0's arrival time for every instruction. L0 feeds nearly the whole rest of the
    front-end critical path (slot-1 PC, the realignment barrel, the BTB query,
    effShift, decodePcNext, the IBuf shift amount), so this was the single largest
    at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
2026-08-07 fmax: close review findings for p0Live pipelining slice 1
    Independent review (APPROVE WITH MINOR NOTES, 0 Critical/Important, 5
    Minor) confirmed the implemented 3-term invalidation gate (flush ||
    shift!=0 || push.fire&&cnt<4) is correct, and empirically proved the
    original design spec's flush-only gate is not (reverting to it
    reproduces a predicted test failure).
    - Correct the design spec to document the real gate instead of the
    disproven flush-only one, with the failure mode it fixes.
    - Tighten two imprecise comments in FetchAlignPlugin.scala (the
    fault-packet-override scope note, and the multi-push crossing-4
    note) and document the flush term's provable redundancy with
    push/shift,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
2026-08-07 fmax: close Slice 2 review findings (D-cache S1 split)
    Independent review: APPROVE, 0 Critical/Important, 5 Minor. Reviewer
    independently proved the inFlight extension is load-bearing (reverting
    it causes real data corruption in an existing regression test, not
    just a defensive no-op) and measured the accepted latency tradeoff's
    IPC cost: 0.484 -> 0.480 (-0.8%) against +5.0% post-route FMax, net
    ~+4% delivered performance.
    - Reword dcIdleForMaint's comment (M1): !ldS2Valid is required for a
    DIFFERENT reason than !ldS1Valid (invariant hygiene on a frozen
    register snapshot, not corruption prevention on a live shared read).
    - Commit tools/fuzz/ported-sweep-parallel.sh (M3): now the standar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
2026-08-07 frontend: collapse slot-1 dst-EA shift barrel onto the raw window (FMax closure slice 3)
    Post-route, the second-worst path after slice 1 was
    `ibuf/entries_*_pred_lenWords_reg -> _zz_..._specs_1_dstEa_disp_reg` (-1.986ns).
    Slot 1's destination-EA extension words were reached through TWO ~10-way dynamic
    barrel muxes in series: Aligner.align builds `slot1.words` by dynamically indexing
    the raw IBuf head window at `L0 + j`, and MicroOpAssembler.computeOffload then
    dynamically re-indexes THAT array by its own `dstShift` (how many extension words
    slot 1's SOURCE EA consumed). Unlike slice 1 this is NOT a defeated/bypassed
    register -- `DecodeStage`'s `fed` PipeStage is correctly placed; the cone fe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
2026-08-07 fmax: correct Slice 3 spec + comments after independent review (mechanism disproven)
    Independent review (APPROVE WITH MINOR NOTES, 0 Critical, 3 Important,
    4 Minor) confirmed the implementation is functionally safe (no hole
    found in an independent end-to-end re-derivation of the correctness
    invariant) but found the design spec wrong in three ways, all
    confirmed from source/netlist by both the implementer and the
    reviewer:
    - The "chained data mux-of-mux" mechanism is disproven: dstShift (the
    second mux's SELECT) is downstream of the first mux's DATA via
    OperationDecoder.spec.size, so the two were never chained as data on
    the real critical arc. OOC-synth-only regresses (-0.137ns, the ne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
2026-08-07 fmax: REVERT Slice 3 (frontend slot-1 dst-EA chained-shift collapse)
    Slice 3 (f4d45a8 + b02dcde + 707b7c3) was landed on PROBATION. Its own
    review had already disproven the DESIGNED mechanism from the netlist (the
    two shifts were never chained as independent data muxes), OOC-synth-only
    measurably REGRESSED (-0.137 ns), and the only positive signal was a
    marginal +0.559 MHz post-route measured in isolation. The ledger named the
    explicit revert criterion: "the first thing to revert once ... the combined
    number disappoints".
    The combined Slice-2 + Slice-3 post-route gate disappointed:
    configuration post-route WNS post-route FMax
    Slice 1 alone -1.987 ns 167.029 M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
2026-08-07 docs: record the Slice 3 revert (spec header + progress ledger)
    Design spec: new "THIS SLICE WAS REVERTED" section at the very top, ahead of
    the existing POST-IMPLEMENTATION CORRECTIONS -- revert date, commit 1404b42,
    the combined-gate table that triggered it, what was kept, and the still-open
    moveLineSize / slot-0 follow-ons.
    Progress ledger:
    - STATUS: PROBATIONARY -> REVERTED.
    - The "Combined Slice-2+Slice-3 post-route gate" section was [PENDING];
    filled in with the actual numbers (post-route -2.215 ns / 160.90 MHz,
    OOC -2.985 ns / 143.16 MHz), the four-way comparison showing the combined
    tip is slower than any slice measured alone, the top-100 endpoint-family
    table (S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
2026-08-08 docs: design spec for FMax Lever A (LsEuPlugin reqMatch freshness flag)
    Replaces reqMatch's 20-bit VPN-equality compare (fed by two chained
    32-bit adders, ~56%/3.2ns of a -1.779ns post-route critical path per
    the faultAddrStore CE-fanout grounding report) with a 1-bit,
    event-driven freshness flag. reqReg's own capture/DTLB-request
    behavior is completely unchanged -- only how staleness is DETECTED
    changes.
    Correctness argument: enumerated the closed set of register-write
    events that can change what xlateVaddr presents (issuePort.fire,
    xlateBArm toggling) and proved no new issue can land while a
    translation is pending (issuePort.ready gated on busy||s1Valid, both
    held throughout). Found and e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
2026-08-08 execute: replace LsEuPlugin reqMatch value-compare with a freshness flag (FMax Lever A)
    `reqMatch` was a 20-bit VPN equality compare fed by two CHAINED 32-bit adders
    (s1Va -> s1AddrB), sitting on ~56% (3.193ns) of a -1.779ns post-route critical
    path (LsEu s1Ctx_uop_eaAuto_reg -> RobPlugin faultAddrStore CE). Because
    `reqReg` re-captures the translation-request drive unconditionally every cycle,
    the compare only ever answered "does reqReg hold the request corresponding to
    what the FSM is presenting right now" -- answerable by tracking the register-
    write EVENTS that break that correspondence, with no address compare at all.
    val xlateBArmPrev = RegNext(xlateBArm, init = False)
    val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
2026-08-08 fmax: close LS/ROB Lever A review findings, update round-2 ledger
    Independent review: APPROVE WITH MINOR NOTES, 0 Critical. Reviewer
    independently reproduced both disclosed deviations before trusting
    them: (1) the approved design spec's own proposed reqMatch expression
    was buggy (RegNext lags xlateBArm's transition by one cycle,
    reintroducing the exact bug fixed once already in d25a0b3) -- derived
    this analytically from register timing BEFORE looking at any test,
    then separately reproduced the implementer's exact failure; (2) a
    missing writer (the exception sequencer's last-wins reqReg override)
    escapes the spec's closure argument -- confirmed real and correctly
    closed by reqExcOverride. Re-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
2026-08-08 docs: design spec for FMax LS/ROB Lever C (ROB fault write-enable fanout hoist)
    Netlist-grounded design pass against synth/fullcore_routed.dcp (HEAD 3ae090c,
    WNS -1.693 ns / 175.65 MHz, re-measured this pass).
    Family 3 (DcachePlugin tagMem -> RobPlugin fault*Store) is still 217 of the
    worst 400 paths, worst -1.521 ns, and the ROB-side write-enable decode still
    costs 1.711 ns = 31.9% of that path (was 1.936 ns / 34.5% pre-round-2).
    Two corrections to the original grounding report's Lever C sketch, both
    netlist-backed:
    1. The one-hot pre-decode ALREADY exists -- SpinalHDL emits `1 <<< robId`
    per port (M68kFullCoreSynth.v:211230/211238/...), not 64 `robId === i`
    compares. Proposi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
2026-08-08 frontend: BTB L0-late-select speculative slot-1 lookup (FMax Lever D)
    Slot 1's BTB lookup was addressed by `decodePc + 2*L0`, so its RAM read
    could not START until `L0` -- the buffer head's predecoded length,
    resolved combinationally out of the InstructionBuffer head window --
    had resolved. That put the whole chain
    headPtr -> IBuf head mux -> L0 -> 7-bit index adder -> RAM read
    -> 24-bit tag compare -> slot1WouldPred -> io_shift -> headPtr
    inside the front end's own feedback loop. A netlist trace of the routed
    checkpoint measured that loop at -1.289ns, 45.2% of it attributable to
    the L0-addressed read (L0->address 1.187ns, the RAM read itself only
    0.419ns, the tag compare behin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
2026-08-16 test(fpu): Musashi oracle FP register accessors + 80-bit lock-step compare path
    Musashi's PUBLIC m68k_get_reg()/m68k_set_reg() API has no floating-point
    surface at all -- m68k.h's m68k_register_t enum has no M68K_REG_FP* of
    any kind. The FP state exists in the emulation core
    (m68ki_cpu.fpr[8] as SoftFloat floatx80, plus .fpcr/.fpsr/.fpiar), so
    the accessors reach it directly through Musashi's private m68kcpu.h.
    That header cannot simply be included into m68k_ref.cpp: it defines
    object-like macros REG_PC/REG_SP/REG_USP/REG_ISP/REG_MSP/REG_SFC/
    REG_DFC/REG_VBR/REG_CACR/REG_CAAR that collide by name with
    MusashiRef::Reg enumerators, and function-like macros
    m68k_read_immediate_*/m68k_read_pcre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
    [m68k_ref.h, m68k_ref_fp.cpp, musashi_run.cpp]
2026-08-16 test(fpu): directed bit-exact lock-step tests for the HW-native FP op set
    Twelve directed tests (the brief's prose says eleven; its own code
    listing has twelve) covering the register-to-register forms of FADD,
    FSUB, FMUL, FDIV, FSQRT, FABS, FNEG, FCMP, FINT, FINTRZ, FTST and
    FMOVECR, compared BIT-EXACTLY against Musashi -- possible only because
    Decision 1 moved the internal format to 80-bit extended, matching
    Musashi's native SoftFloat floatx80.
    Operands are chosen so results are exactly representable rather than
    rounding-noise-dependent, and several cases are deliberately
    aliasing-sensitive: FINT vs FINTRZ on -2.8125 (must disagree, -3.0 vs
    -2.0); FABS/FNEG on a non-trivial mantissa; NaN p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
    [m68k_ref.cpp]
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
